Ground-Station/Documentation/README.md

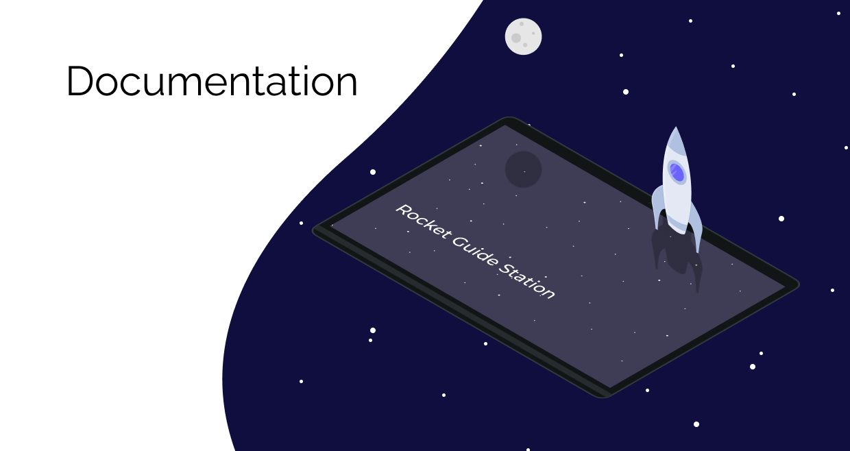
[picture p1: assets/img/Capa.png]


Repositório destinado à documentação do projeto



## Relatórios

- [Ponto de Controle 1](reports/PI2_PC1_fogueteiros.pdf)
- [Ponto de Controle 2](reports/PI2_PC2_fogueteiros.pdf)
- [Ponto de Controle 3](reports/PI2_PC3_fogueteiros.pdf)
- [Diagramas Elétricos](electric-diagrams/)
- [CADs e imagens Estrutura](Estrutura/)

## Manuais

- [Manual de Montagem](manuals/Manual_de_montagem.pdf)
- [Manual de Uso](manuals/Manual_do_usuario.pdf)

## Apresentações

- [Apresentação do Ponto de Controle 1](presentations/apresentacao_PC01.pdf)
- [Apresentação do Ponto de Controle 1](presentations/apresentacao_PC2.pdf)

## Projetos das Placas de Circuito Impresso

- [Download Arquivos Gerber](https://drive.google.com/drive/folders/1P1pQGE_zuSLOB5qd8zfESWqLDwtyoRKd)
- [Download do programa vizualizador (Arquivo Gerber)](https://sourceforge.net/projects/gerbv/files/)

## Bibliotecas Essenciais - Hardware

- [Adafruit_Sensor](https://github.com/adafruit/Adafruit_Sensor)
- [Adafruit_BMP280_Library](https://github.com/adafruit/Adafruit_BMP280_Library)
- [BME280_driver](https://github.com/BoschSensortec/BME280_driver)
- [HX711](https://github.com/bogde/HX711)
- [TinyGPS](https://github.com/mikalhart/TinyGPS)
- [ESPsoftwareserial](https://github.com/plerup/espsoftwareserial)
