Ground-Station/Documentation/reports/PI2_PC1_fogueteiros/figuras/folhaDeAprovacao.tex

\begin{folhadeaprovacao}

  \begin{center}
    {\ABNTEXchapterfont\large\imprimirautor}

    \vspace*{\fill}\vspace*{\fill}
    {\ABNTEXchapterfont\bfseries\Large\imprimirtitulo}
    \vspace*{\fill}
    
    \hspace{.45\textwidth}
    \begin{minipage}{.5\textwidth}
        \imprimirpreambulo
    \end{minipage}%
    \vspace*{\fill}
   \end{center}
    
    \begin{center}   
    \vspace*{\fill}\vspace*{\fill}
    {\large{Orientadores: \imprimirorientador}}
    \end{center}

   \begin{center}
    \vspace*{0.5cm}

    {\large\imprimirlocal}
    \par
    {\large\imprimirdata}
    \vspace*{1cm}
  \end{center}
  
\end{folhadeaprovacao}
