Ground-Station/Documentation/reports/PI2_PC1_fogueteiros/editaveis/geral/anexos.tex

\begin{anexosenv}

\partanexos

\chapter{Elementos do sistema de alimentação}
\label{ane:Elementos do sistema de alimentação}

\begin{figure}[h]
\centering
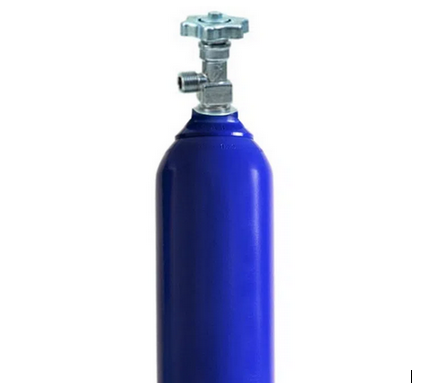
[picture p2: reports/PI2_PC2_fogueteiros/figuras/tanqueAbastecimento.png]
\subfigure[ref1][Tanque de abastecimento] {}
\qquad
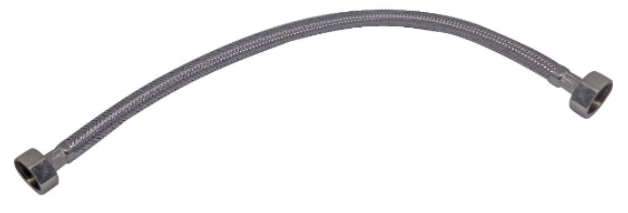
[picture p3: reports/PI2_PC1_fogueteiros/figuras/mangueira.png]
\subfigure[ref2][Tubo flexível] {}
\caption{Tanque de abastecimento e Tubo flexível}
\label{fig:tanque de abastecimento}
\end{figure}

\begin{figure}[h]
\centering
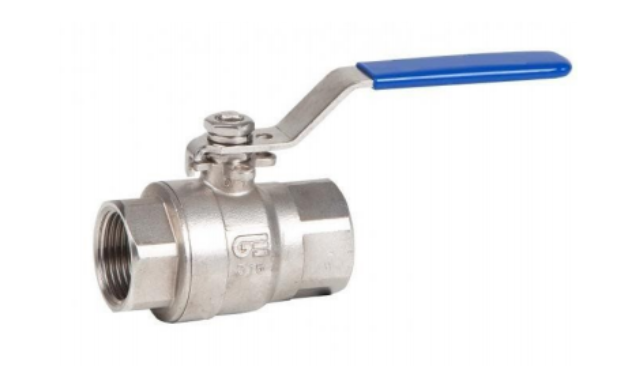
[picture p4: reports/PI2_PC1_fogueteiros/figuras/valvulaEsfera.png]
\subfigure[ref1][Válvula esfera] {}
\qquad
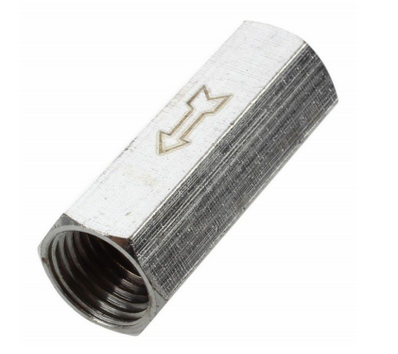
[picture p5: reports/PI2_PC2_fogueteiros/figuras/valvulaAntirretorno.png]
\subfigure[ref2][Válvula anti-retorno] {}
\caption{Válvulas}
\label{fig:valvulas}
\end{figure}

\begin{figure}[h]
\centering
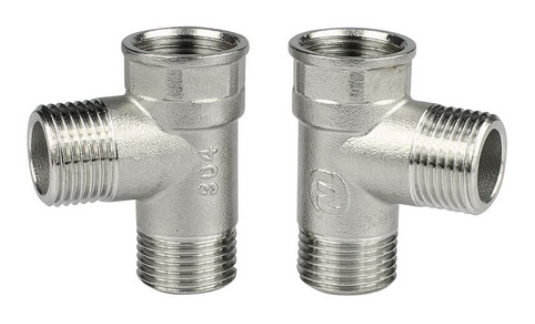
[picture p6: reports/PI2_PC3_fogueteiros/figuras/conexaoT.png]
\subfigure[ref1][Conector T] {}
\qquad
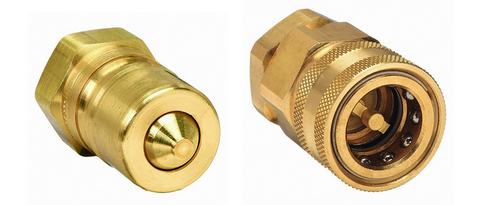
[picture p7: reports/PI2_PC3_fogueteiros/figuras/conexaoRapida.png]
\subfigure[ref2][Conector rápido] {}
\caption{Conectores}
\label{fig:conectores}
\end{figure}

\end{anexosenv}
