Ground-Station/Documentation/reports/PI2_PC1_fogueteiros/editaveis/geral/apendices.tex

\begin{apendicesenv}

\partapendices

\chapter{Diagrama de blocos do sistema}
\label{Diagrama de blocos do sistema}
\begin{figure}[htb]
    \centering
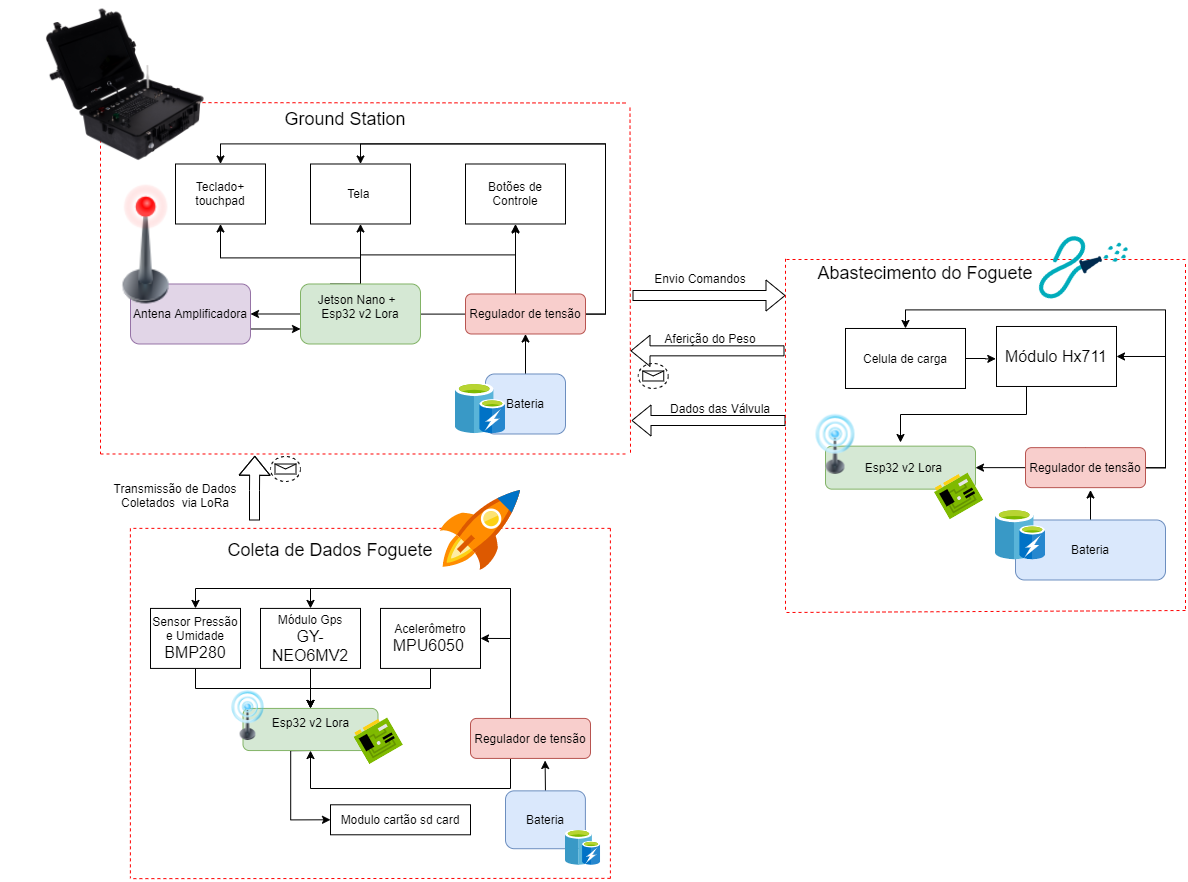
[picture p8: reports/PI2_PC1_fogueteiros/figuras/diagrama pi2 (2).png]
    
    \caption{Diagrama de blocos do projeto. Fonte: Autor}
    \label{fig:Diagrama de Blocos}
\end{figure}

\chapter{Visão geral da arquitetura de software}
\label{Visão geral da arquitetura de software}
\begin{figure}[htb]
    \centering
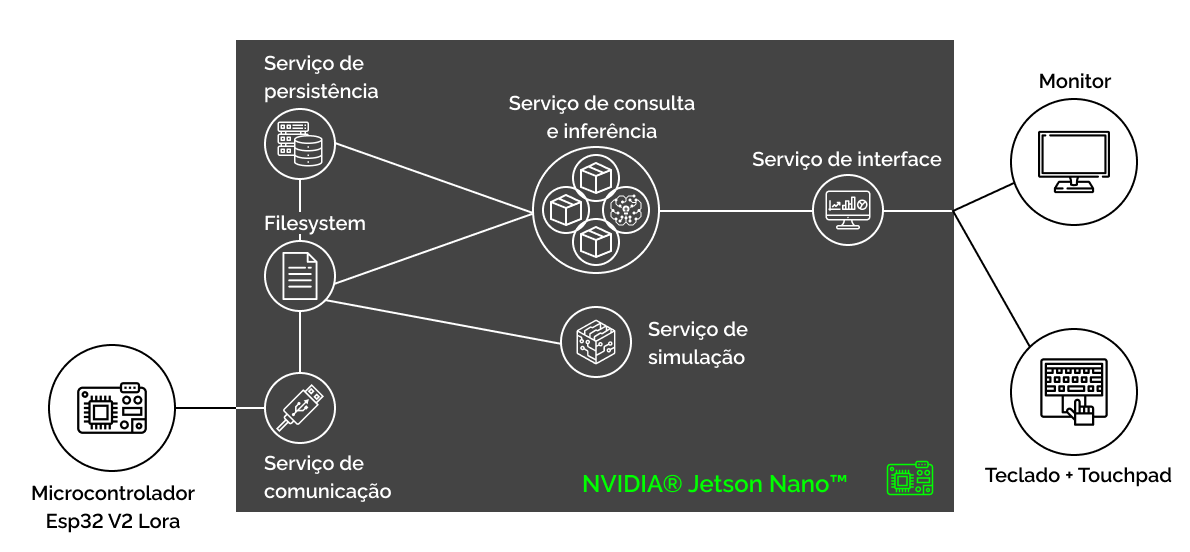
[picture p9: reports/PI2_PC2_fogueteiros/figuras/arquitetura_visao_geral.png]
    
    \caption{Visão geral da arquitetura de software. Fonte: Autor}
    \label{fig:Visão geral}
\end{figure}

\chapter{Business model canvas}
\label{canvas}
\begin{figure}[htb]
    \centering
    
    \caption{Business model canvas. Fonte: Autor}
    \label{fig:Canvas}
\end{figure}

\chapter{EAP}
\label{eap}
\begin{figure}[htb]
    \centering
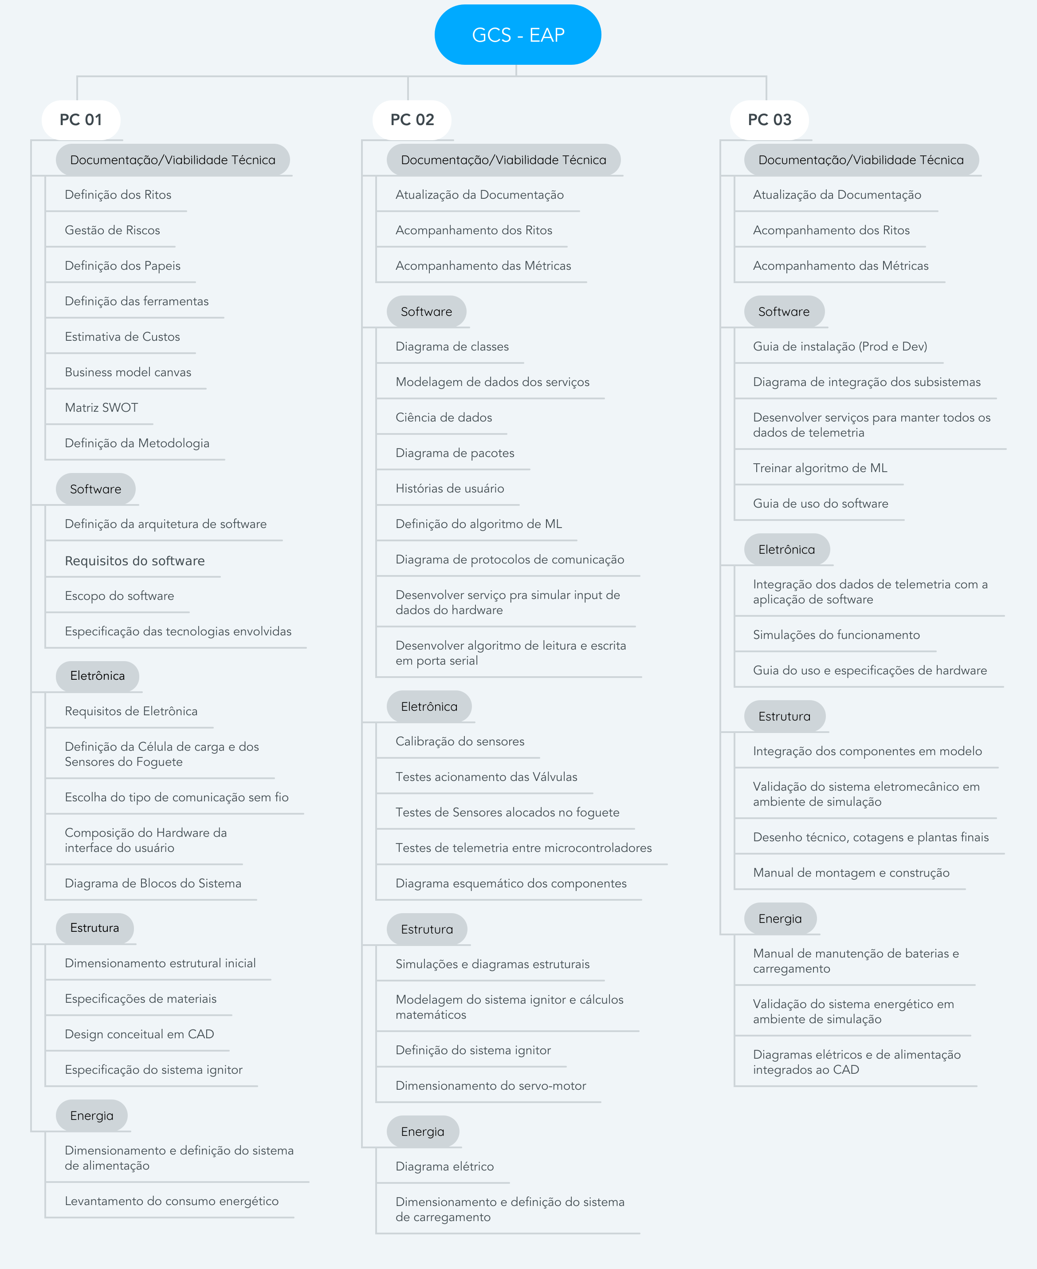
[picture p10: reports/PI2_PC2_fogueteiros/figuras/GCS_-_EAP.png]
    
    \caption{Mapa mental da Estrutura Analítica do Projeto.}
    \label{fig:EAP}
\end{figure}

\chapter{Esboço inicial e CAD}
\label{CAD}

\begin{figure}[htb]
    \centering
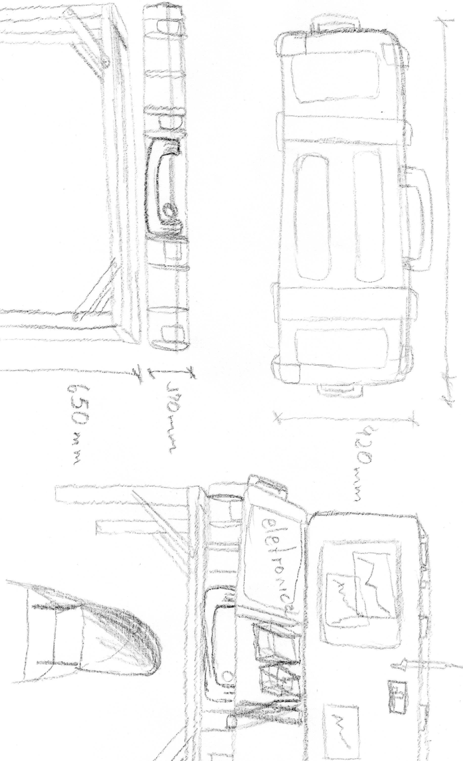
[picture p11: reports/PI2_PC1_fogueteiros/figuras/EsboçoInicial_V_1.jpg]
    
    \caption{Esboço inicial}
    \label{fig:esboço}
\end{figure}

\begin{figure} [H]
\centering
  \subfigure[aberto]{
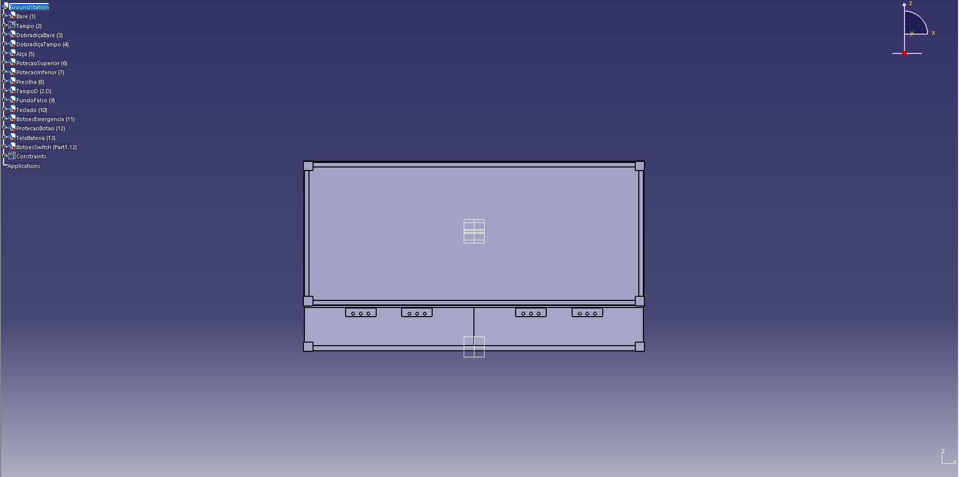
[picture p12: reports/PI2_PC1_fogueteiros/figuras/Back1.PNG]
    
  } 
  \subfigure[fechado]{ 
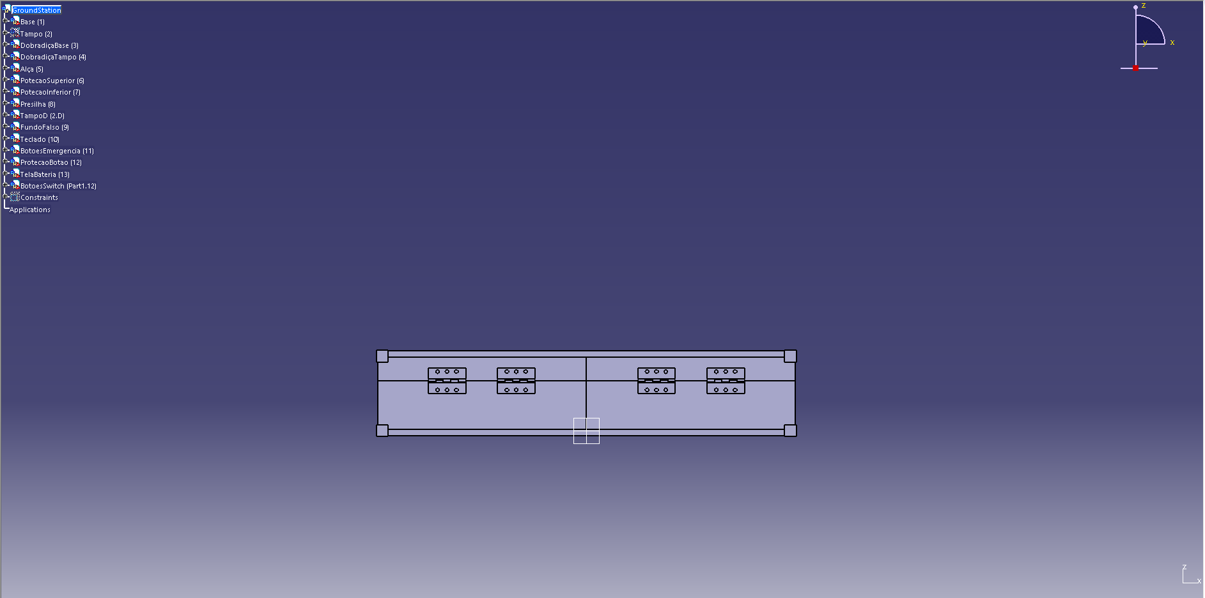
[picture p13: reports/PI2_PC1_fogueteiros/figuras/Back2.PNG]
    
  } 
  \caption{CAD da maleta verso}
\end{figure}

\begin{figure} [H]
\centering
  \subfigure[aberto]{
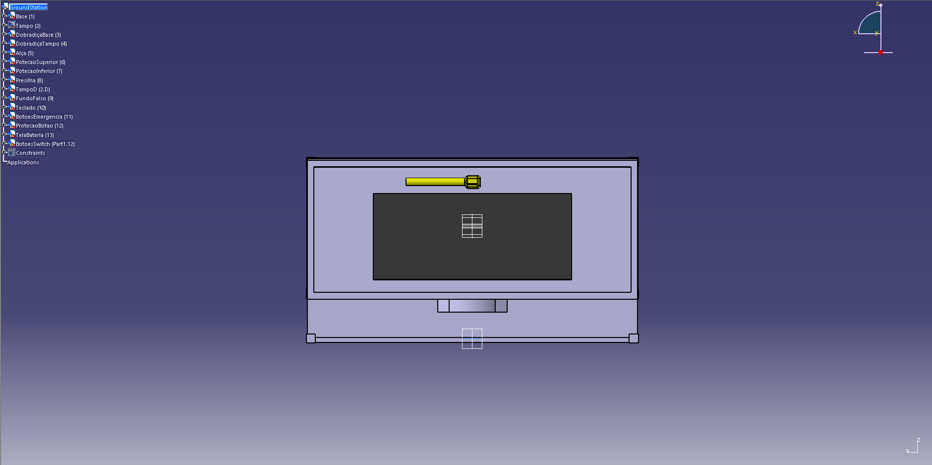
[picture p14: reports/PI2_PC1_fogueteiros/figuras/Front1.PNG]
    
  } 
  \subfigure[fechado]{ 
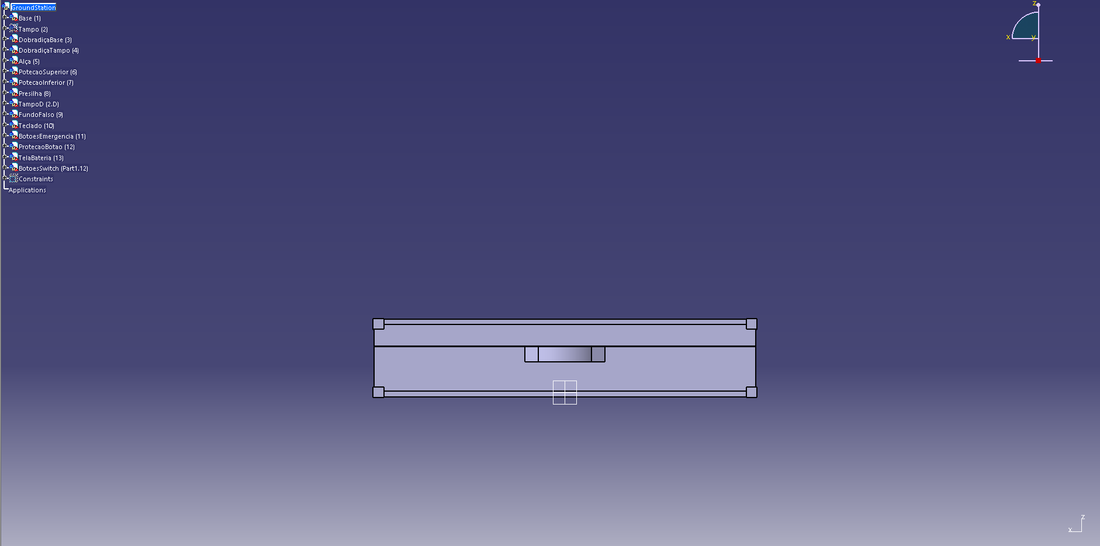
[picture p15: reports/PI2_PC1_fogueteiros/figuras/Front2.PNG]
    
  } 
  \caption{CAD's da maleta frente}
\end{figure}

\begin{figure} [H]
\centering
  \subfigure[aberto]{
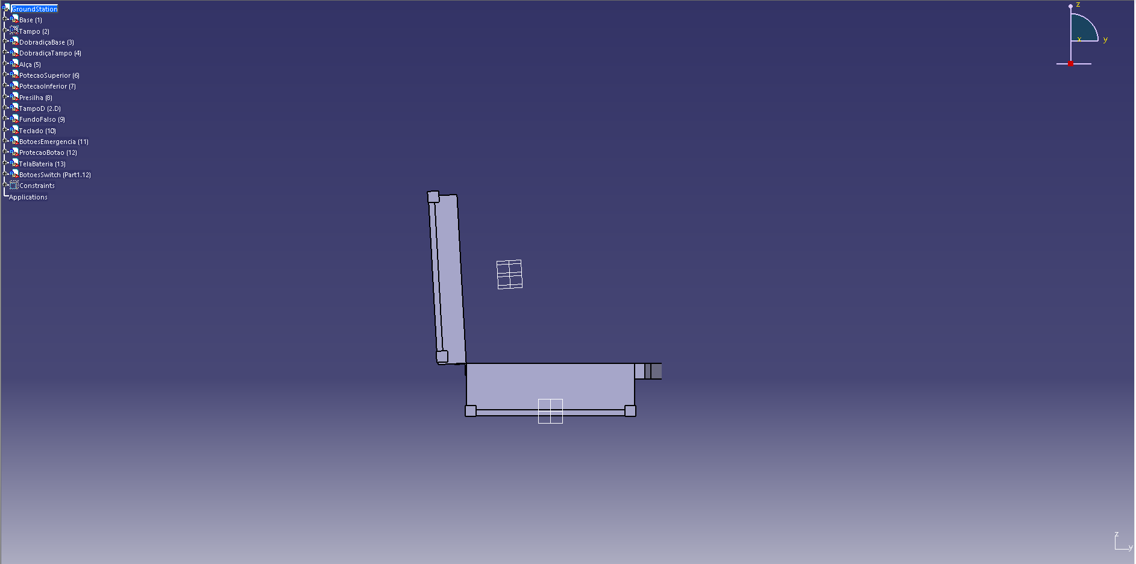
[picture p16: reports/PI2_PC1_fogueteiros/figuras/Lateral1.PNG]
    
  } 
  \subfigure[fechado]{ 
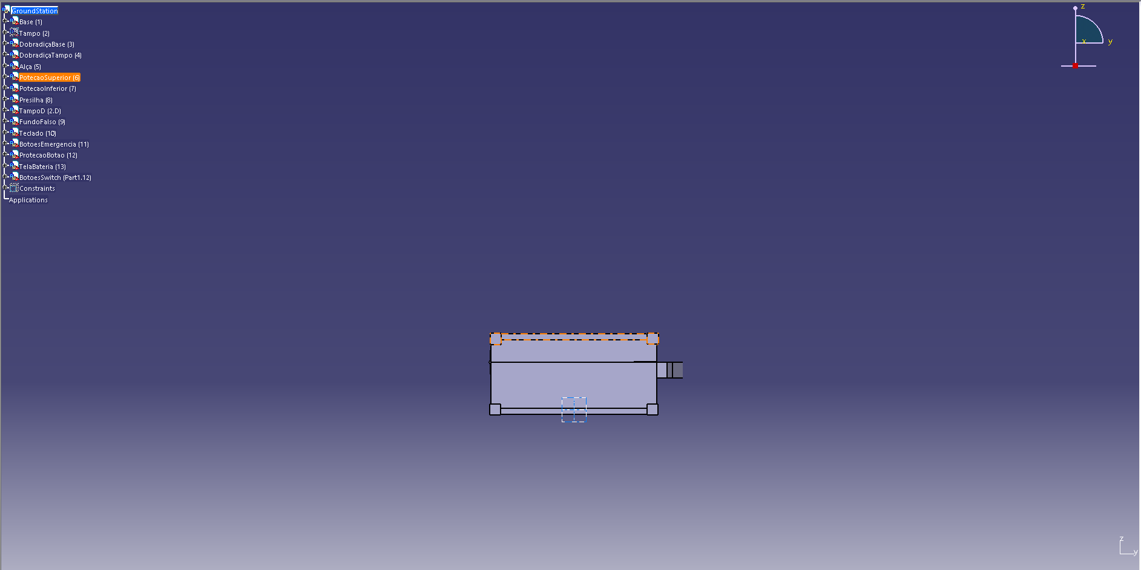
[picture p17: reports/PI2_PC1_fogueteiros/figuras/Lateral2.PNG]
    
  } 
  \caption{CAD's da maleta lateral}
\end{figure}

\begin{figure} [H]
\centering
  \subfigure[aberto]{
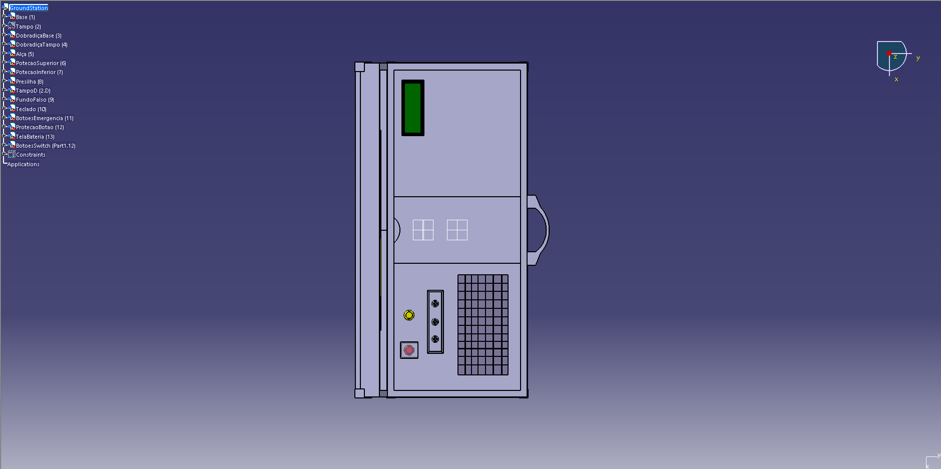
[picture p18: reports/PI2_PC1_fogueteiros/figuras/Sup1.PNG]
    
  } 
  \subfigure[fechado]{ 
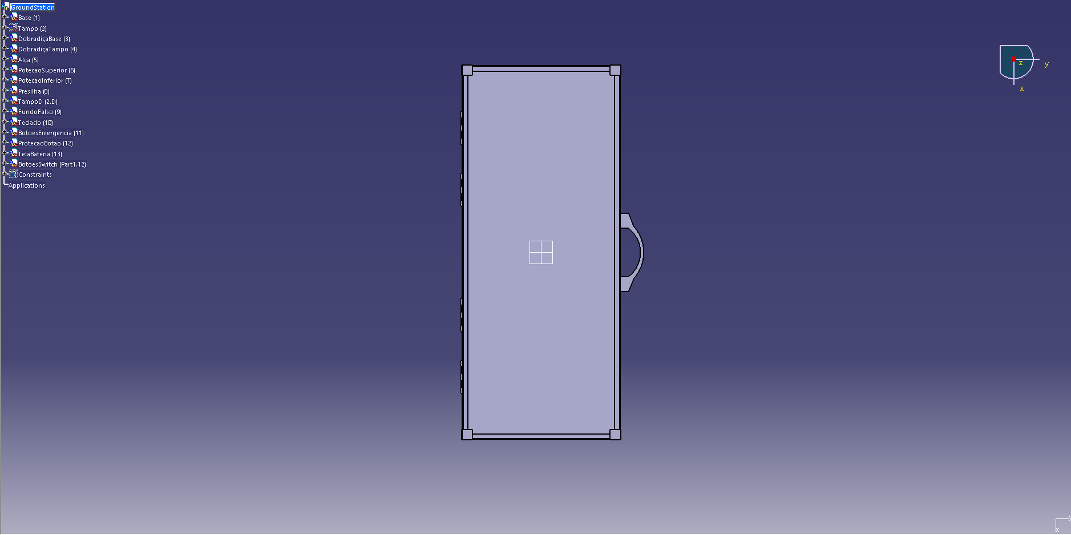
[picture p19: reports/PI2_PC1_fogueteiros/figuras/Sup2.PNG]
    
  } 
  \caption{CAD's da maleta superior}
\end{figure}

\begin{figure} [H]
\centering
  \subfigure[aberto]{
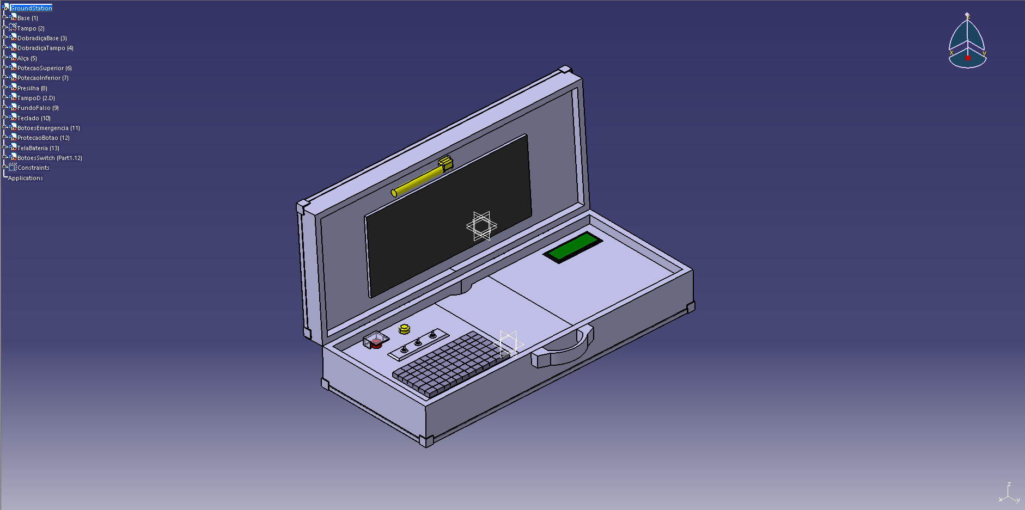
[picture p20: reports/PI2_PC1_fogueteiros/figuras/Iso1.PNG]
    
  } 
  \subfigure[fechada]{ 
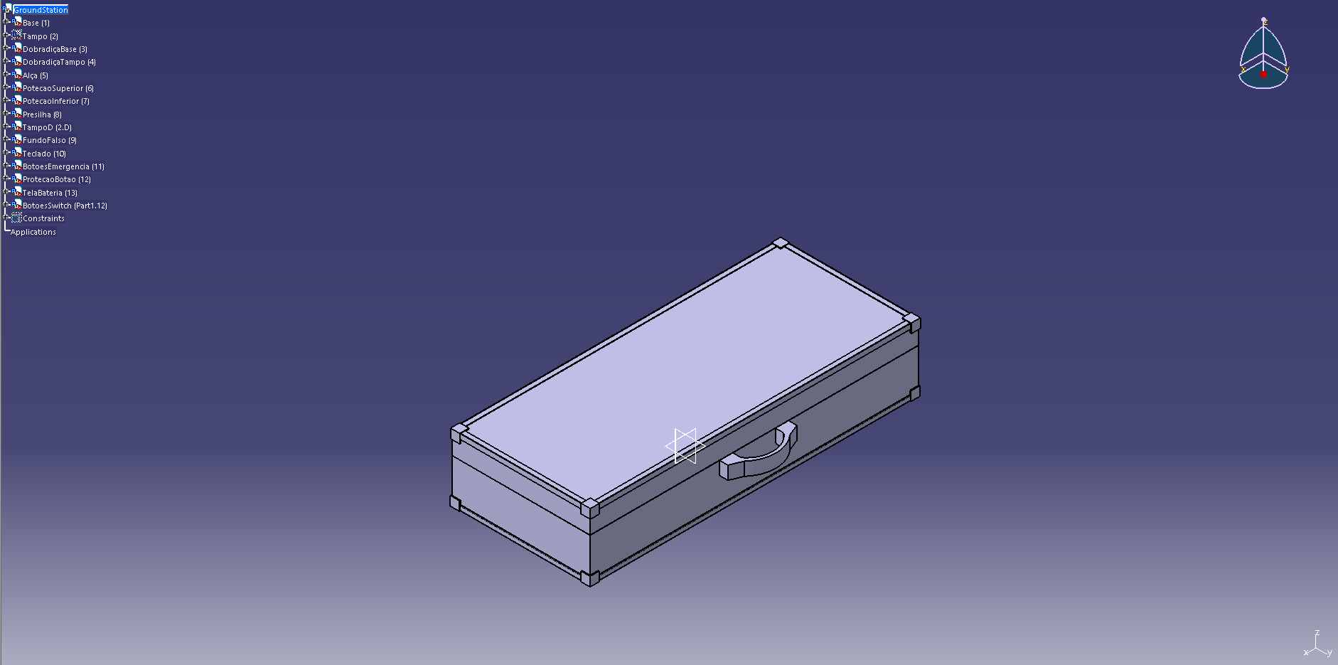
[picture p21: reports/PI2_PC1_fogueteiros/figuras/Iso2.PNG]
    
  } 
  \caption{CAD's da maleta isométrica}
\end{figure}

\chapter{Roadmap}
\label{Roadmap}
\begin{figure}[htb]
    \centering
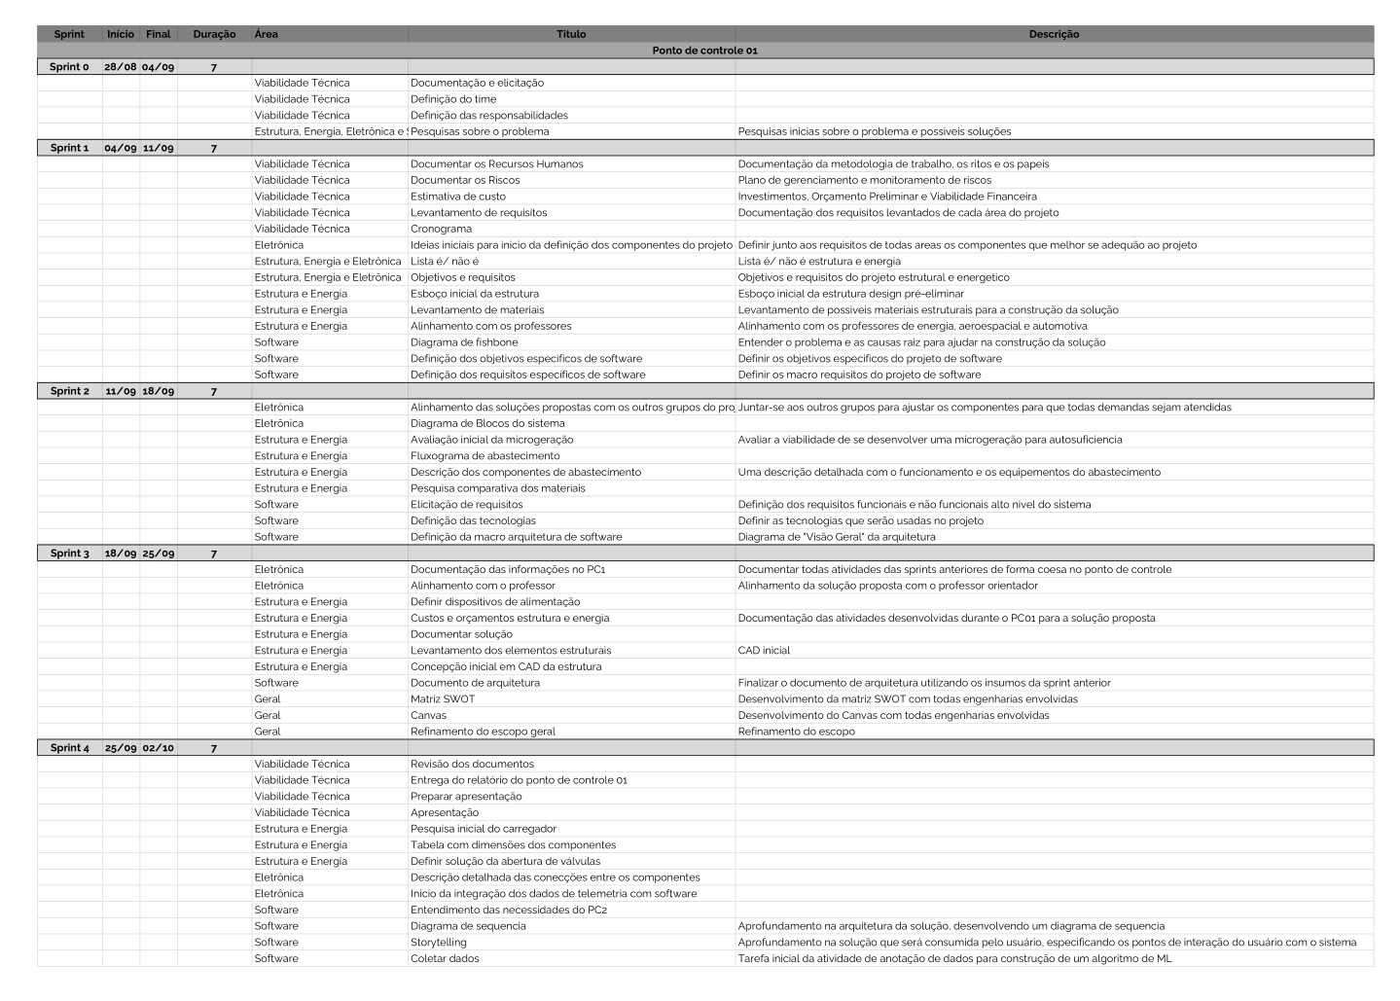
[picture p22: reports/PI2_PC1_fogueteiros/figuras/Roadmap-PC1.png]
    
    \caption{Roadmap PC1. Fonte: Autor}
    \label{fig:Roadmap PC1}
\end{figure}
\begin{figure}[htb]
    \centering
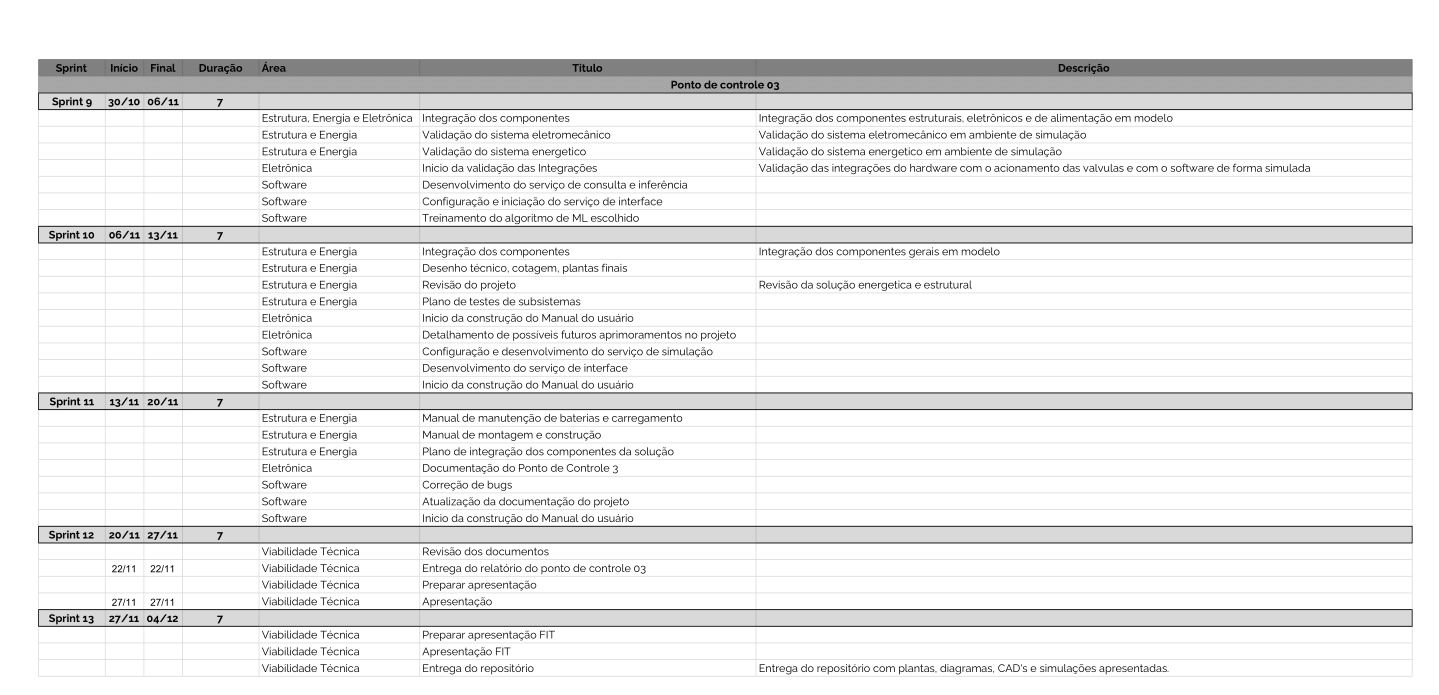
[picture p23: reports/PI2_PC1_fogueteiros/figuras/Roadmap-PC2.png]
    
    \caption{Roadmap PC2. Fonte: Autor}
    \label{fig:Roadmap PC2}
\end{figure}
\begin{figure}[htb]
    \centering
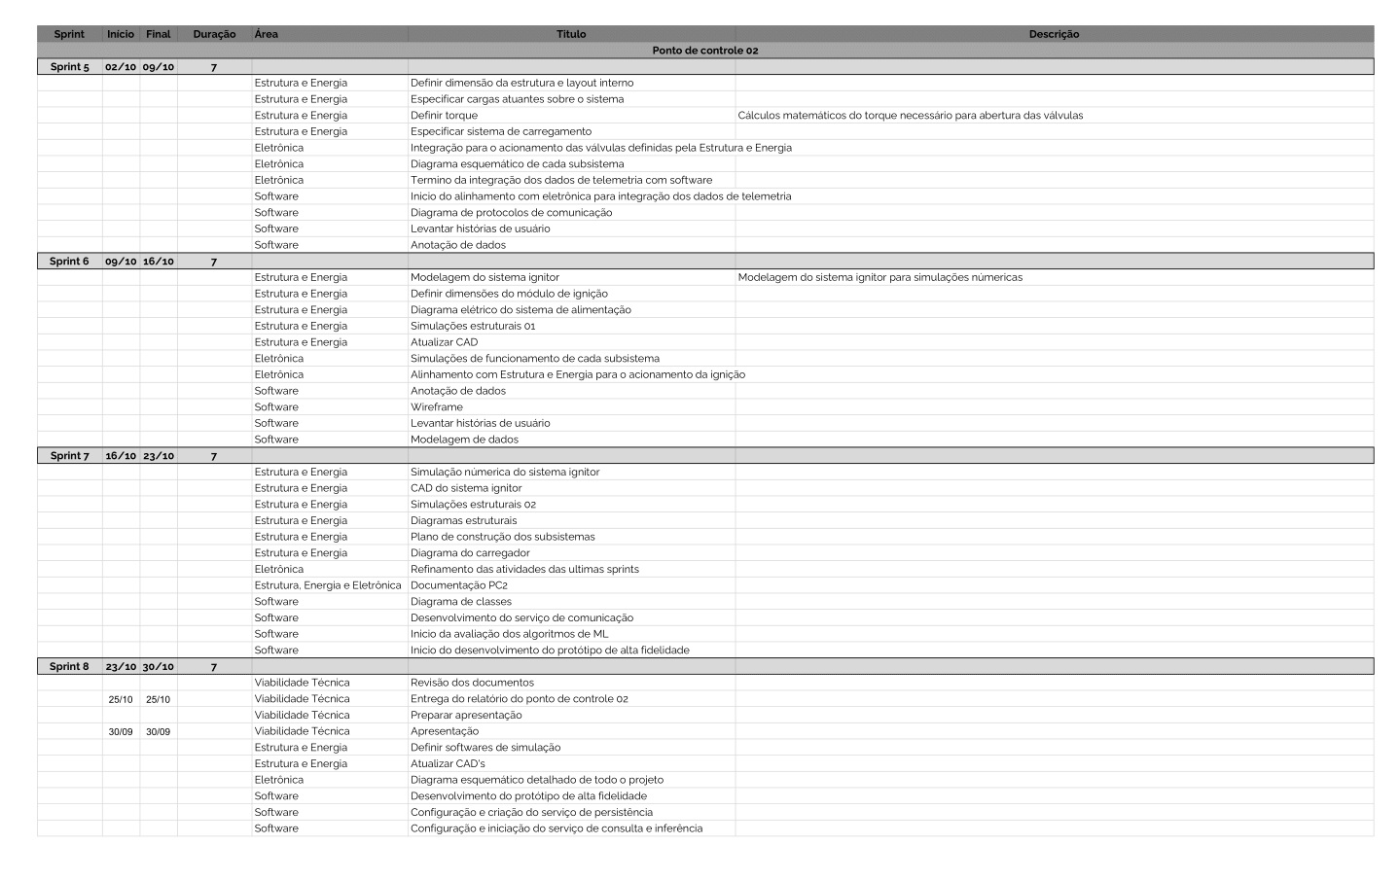
[picture p24: reports/PI2_PC3_fogueteiros/figuras/Roadmap-PC3.png]
    
    \caption{Roadmap PC3. Fonte: Autor}
    \label{fig:Roadmap PC3}
\end{figure}

\input{editaveis/autoavaliacao/autoavaliacao.tex}

\end{apendicesenv}
