Ground-Station/Documentation/reports/PI2_PC2_fogueteiros/editaveis/geral/abreviaturas.tex

\begin{siglas}
  \item [CNC] \textit{Computer Numeric Control}
  \item [RUP] \textit{Rational Unified Process}
  \item [MVP] \textit{Minimum Viable Product}
  \item [RGS] \textit{Rocket Guide Station}
  \item [GPS] \textit{Global Positioning System - Sistema de Posicionamento Global}
  \item [CAD] \textit{Computer Aided Design}
  \item [EAP] \textit{ Estrutura Analítica de Projetos}
  \item [TAP] \textit{Termo de Abertura de Projeto}
  \item [SWOT] \textit{Strengths, Weaknesses, Opportunities, and Threats}
  \item [GPRS] \textit{General Packet Radio Services}
  \item [LASC] \textit{Latin America Space Challenge}
  \item [SPI] \textit{Serial Peripheral Interface}
  \item [SOA] \textit{Service oriented architeture}
  \item [ML] \textit{Machine Learning}
  \item [PC] \textit{Ponto de Controle}
  \item [SWOT] \textit{strengths, weaknesses, opportunities, and threats}
  \item [FOFA] \textit{Forças, Oportunidades, Fraquezas e Ameaças}
  \item [5W1H] \textit{Who, What, Where, When, Why, How}
  \item [FIT] \textit{Feira de inovação tecnológica}
  \item [FGA] \textit{Faculdade Gama}
  \item [ISO] \textit{Organização Internacional de Normalização}
  \item [MDF] \textit{Medium Density Fiberboard}
  \item [PRFV] \textit{Polímero Reforçado com Fibra de Vidro}
  \item [PRFC] \textit{Polímero Reforçado com Fibra de Carbono}
  \item [PLA] \textit{Poli Ácido Lático}
  \item [ABS] \textit{Acrilonitrila Butadieno Estireno}
  \item [GCS] \textit{Ground Control Station}
  \item [IA] \textit{Inteligencia artificial}
  \item [PTH] \textit{Pin Through Hole}
  \item [SMD] \textit{Surface Mounted Device}
  \item [PCI] \textit{Placa de Circuito Impresso}
  \item [FR] \textit{Flame Resistant}
  \item [SF] \textit{Spreading Factor-Fator de espalhamento}
  \item [BW] \textit{Bandwidth-Largura de banda}
  \item [Rb] \textit{Taxa de bits}
  \item [A] \textit{Ampères}
  \item [W] \textit{Watts}
  \item [Wh] \textit{Watts hora}

\end{siglas}
