Ground-Station/Documentation/reports/PI2_PC2_fogueteiros/editaveis/geral/anexos.tex

\begin{anexosenv}

\partanexos

\chapter{Elementos do sistema de alimentação}
\label{ane:Elementos do sistema de alimentação}

\begin{figure}[h]
\centering
\subfigure[ref1][Tanque de abastecimento] {}
\qquad
\subfigure[ref2][Tubo flexível] {}
\caption{Tanque de abastecimento e Tubo flexível}
\label{fig:tanque de abastecimento}
\end{figure}

\begin{figure}[h]
\centering
\subfigure[ref1][Válvula esfera] {}
\qquad
\subfigure[ref2][Válvula anti-retorno] {}
\caption{Válvulas}
\label{fig:valvulas}
\end{figure}

\begin{figure}[h]
\centering
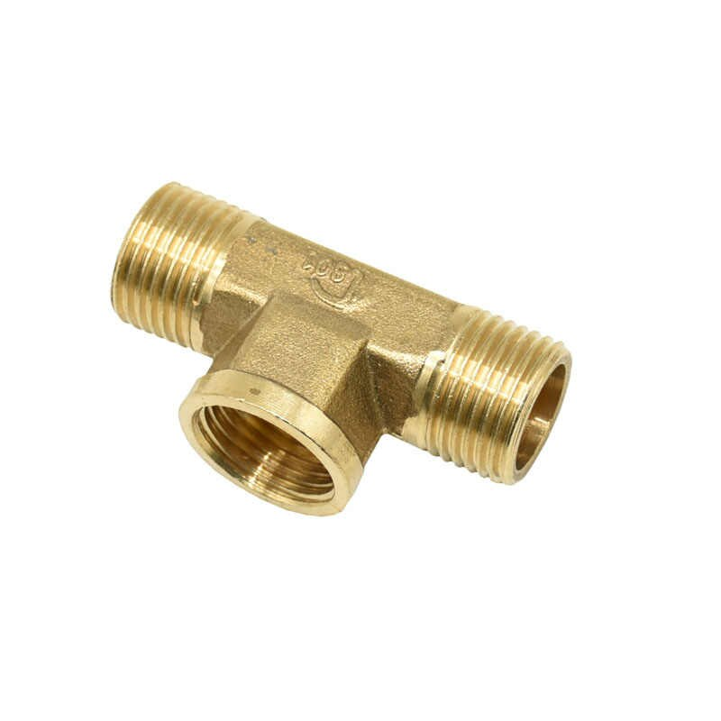
[picture p25: reports/PI2_PC2_fogueteiros/figuras/T.jpg]
\subfigure[ref1][Conector T] {}
\qquad
\subfigure[ref2][Conector rápido] {}
\caption{Conectores}
\label{fig:conectores}
\end{figure}

\includepdf[pages=-,angle=0]{figuras/valvula.pdf}
\label{valvula}

\label{motorcarro}
\includepdf[pages=51,angle=0]{figuras/Mabuchi_Motors_Complete.pdf}

\end{anexosenv}
