Ground-Station/Documentation/reports/PI2_PC3_fogueteiros/editaveis/geral/abreviaturas.tex

\begin{siglas}
   \item [A] \textit{Ampères}
   \item [ABS] \textit{Acrilonitrila Butadieno Estireno}
   \item [AJAX] \textit{Asynchronous JavaScript And XML}
   \item [ANATEL] \textit{Agência Nacional de Telecomunicações}
   \item [API] \textit{Application Programming Interface}
   \item [BBB] \textit{Battelle-Bildmappen-Brainwriting}
   \item [BW] \textit{Bandwidth-Largura de banda}
   \item [CAD] \textit{Computer Aided Design}
   \item [CNB] \textit{Collective Notebook}
   \item [CNC] \textit{Computer Numeric Control}
   \item [CR] \textit{Code Rate}
   \item [CRT] \textit{Capital Rocket Team}
   \item [CSS] \textit{Chirp Spread Spectrum}
   \item [CSV] \textit{Comma Separated Values}
   \item [EAP] \textit{Estrutura Analítica de Projetos}
   \item [FCA] \textit{fator de correção de agrupamento}
   \item [FCE] \textit{Forward Error Corrector}
   \item [FCT]  \textit{fator de correção de temperatura}
   \item [FGA] \textit{Faculdade Gama}
   \item [FIT] \textit{Feira de inovação tecnológica}
   \item [FOFA] \textit{Forças, Oportunidades, Fraquezas e Ameaças}
   \item [FR] \textit{Flame Resistant}
   \item [FSK] \textit{Frequency-shift keying}
   \item [GCS] \textit{Ground Control Station}
   \item [GPRS] \textit{General Packet Radio Services}
   \item [GPS] \textit{Global Positioning System - Sistema de Posicionamento Global}
   \item [Hz] \textit{Hertz}
   \item [IA] \textit{Inteligencia artificial}
   \item [IOT] \textit{Internet das coisas}
   \item [ISM] \textit{Industrial Sientific and Medical}
   \item [ISO] \textit{Organização Internacional de Normalização}
   \item [LASC] \textit{Latin America Space Challenge}
   \item [MDF] \textit{Medium Density Fiberboard}
   \item [ML] \textit{Machine Learning}
   \item [MOBFOG] \textit{Mostra Brasileira de Foguetes}
   \item [MVP] \textit{Minimum Viable Product}
   \item [NGT] \textit{Nominal Group Technique}
   \item [PC] \textit{Ponto de Controle}
   \item [PCI] \textit{Placa de Circuito Impresso}
   \item [PLA] \textit{Poli Ácido Lático}
   \item [PRFC] \textit{Polímero Reforçado com Fibra de Carbono}
   \item [PRFV] \textit{Polímero Reforçado com Fibra de Vidro}
   \item [PTH] \textit{Pin Through Hole}
   \item [Rb] \textit{Taxa de bits}
   \item [REST] \textit{Representational State Transfer}
   \item [RGS] \textit{Rocket Guidance Station}
   \item [RUP] \textit{Rational Unified Process}
   \item [SF] \textit{Spreading Factor-Fator de espalhamento}
   \item [SIL] \textit{Safety Integrity Level}
   \item [SMD] \textit{Surface Mounted Device}
   \item [SOA] \textit{Service oriented architeture}
   \item [SPI] \textit{Serial Peripheral Interface}
   \item [SWOT] \textit{Strengths, Weaknesses, Opportunities, and Threats}
   \item [TAP] \textit{Termo de Abertura de Projeto}
   \item [VIML] \textit{Vocabulário Internacional de Metrologia Legal}
   \item [W] \textit{Watts}
   \item [Wh] \textit{Watts hora}
   \item [5W1H] \textit{Who, What, Where, When, Why, How}

\end{siglas}
