Ground-Station/Documentation/reports/PI2_PC1_fogueteiros/editaveis/TAP/EstimativadeCustos/estimativadecustos.tex

\section{Estimativa de Custos}

Apesar de não existir a necessidade de construção do projeto este semestre, devido a situação sanitária no qual o mundo se encontra, foi construído uma tabela com os custos totais dos materiais componentes que seriam utilizados. A tabela \ref{tab:estimativa materiais} mostra um valor estimado do metro quadrado dos materiais pesquisados. 

\begin{table}[H]
\begin{tabular}{| m{4cm}|m{2cm}|m{2cm}|m{2cm}|m{2cm}|m{2cm}|}
\hline
\multicolumn{6}{|c|}{\textbf{Estrutura e Energia}}\\
\hline
Material & Preço  & Quantidade & Frete & Loja & Total  \\ 
\hline
Bateria Lítio Ferro Fosfato (UPLFP12-30) & 1.426,00  & 1 & 00,00 & Unipower & 1.426,00  \\ 
\hline
Módulo Regulador de Tensão (LM2596)   & 10,90  & 3  & 21,11 & Curto Circuito      & 53,81  \\ 
\hline
MDF   &  R\$36,81 & 1$m^2$x3mm  &   &    &  R\$36,81 \\ 
\hline
MDF   & R\$62,50  & 1$m^2$x6mm  &   &    & R\$62,50  \\ 
\hline
PRFV   & R\$52,90  & 1$m^2$  &   &    &  R\$52,90 \\ 
\hline
PRFC   &  R\$421,43 & 1$m^2$ &   &    &  R\$421,43 \\ 
\hline
PLA   & R\$140,00  & 1kg  &   &    &  R\$140,00  \\ 
\hline
ABS   &  R\$ 16,80 & 1kg  &   &    & R\$ 16,80  \\ 
\hline
 Atuador pneumático  &  entre R\$250 a R\$2000 & 2  &   &    &   \\ 
\hline
 Atuadores elétricos  & entre U\$60 a U\$240  &  2 &   &    &   \\ 
\hline

\end{tabular}
\caption{Estimativa de custos de Materiais}
\label{tab:estimativa materiais}
\end{table}

\begin{table}[H]
\begin{tabular}{| m{6cm}|m{1cm}|m{2cm}|m{1cm}|m{3cm}|m{1cm}|}
\hline
\multicolumn{6}{|c|}{\textbf{Eletrônica}}                                                 \\ \hline
Componente                & Preço  & Quantidade & Frete & Loja          & Total  \\ \hline
Jetson Nano Developer Kit  & 899,91 & 1          & 50,45 & Submarino    & 950,36 \\ \hline
TELA LCD - 9 polegadas    & 269,75 & 1          & 0,00  & arduoeletro   & 269,75 \\ \hline
Mini Teclado com touchpad & 189,14 & 1          & 0,00  & Mercado Livre & 189,14 \\ \hline
Placa LoRa Esp32          & 129,90 & 3          & 27,90 & Mercado Livre & 417,60 \\ \hline
Sensor BMP280             & 13,50  & 1          & 21,11 & Curtocircuito & 34,61  \\ \hline
Célula de carga 50kg      & 16,90  & 1          & 16,50 & Eletrogate    & 33,40  \\ \hline
Módulo Hx711              & 10,40  & 1          & 19,90 & Mercado Livre & 30,30  \\ \hline
Módulo GPS GY-NEO6MV2     & 79,90  & 1          & 19,70 & Robocore      & 99,60  \\ \hline
\end{tabular}
\caption{Estimativa de custos componentes eletrônicos}
\end{table}

Com isso o custo total dos materiais do projeto inicialmente é\textbf{ R\$ 3.504,57} reais.
