Ground-Station/Documentation/reports/PI2_PC2_fogueteiros/editaveis/solucao/custos/custos.tex

\section{Custos}

\begin{table}[h!]
\centering
\begin{tabular}{| m{4cm}|m{2cm}|m{2cm}|m{2cm}|m{2cm}|m{2cm}|}
\hline
\multicolumn{6}{|c|}{\textbf{Estrutura}}\\
\hline
Material & Preço  & Quantidade & Frete & Loja & Total  \\ 
\hline
Alça & $RS$ 15,00 & 1 & $RS$ 17,90 & Mercado Livre & $RS$ 32,90 \\ \hline
Cantoneira de alumínio & $RS$ 17,00 & 3 & $RS$ 26,90 & Mercado Livre & $RS$ 77,90 \\ \hline
Protetores de Canto & $RS$ 20,00 & 1 (pack de 8 un.) & $RS$ 9,00 & Mercado Livre & $RS$ 29,00 \\ \hline
Total estrutura & - & - & - & - & $RS$ 0 \\\hline
\multicolumn{6}{|c|}{\textbf{Energia}}\\
\hline
Bateria de lítio 12V/97Wh (Dell) & $RS$ 718 & 1 & $RS$ 0,00 & Dell & $RS$ 718 \\\hline
Bateria de lítio 12V/10Ah (Unipower) & $RS$ 517,5 & 1 & $RS$ 0,00 & Unipower & $RS$ 517,5 \\\hline
Plug macho (tomada) & $RS$ 11,29 & 1 & $RS$ 9,90 & Leroy Merlin & $RS$ 21,19 \\\hline
Conector DC Jack + Plug & $RS$ 9,99 & 2 & $RS$ 52,90 & Mercado Livre & $RS$ 72,88 \\\hline
Regulador de tensão (LM2596) & $RS$ 13,21 & 2 & $RS$ 23,23 & Baú da Eletrônica & $RS$ 49,65 \\\hline
Resistor 0R12 5\% & $RS$ 0,38 & 1 & - & Baú da Eletrônica & $RS$ 0,38 \\\hline
Resistor 1KR 5\% & $RS$  0,15 & 1 & - & Baú da Eletrônica & $RS$ 0,15 \\\hline
Resistor 240R 5\% & $RS$ 0,04 & 1 & - & Baú da Eletrônica & $RS$ 0,04 \\\hline
Transistor NPN - BC547 & $RS$ 0,15 & 1 & - & Baú da Eletrônica & $RS$ 0,15 \\\hline
Regulador de Tensão Ajustável LM317 & $RS$ 0,49 & 1 & - & Baú da Eletrônica & $RS$ 0,49 \\\hline
Regulador de Tensão L7812 & $RS$ 1,25 & 1 & - & Baú da Eletrônica & $RS$ 1,25 \\\hline
Capacitor Eletrolítico 1000uF & $RS$ 3,29 & 1 & - & Baú da Eletrônica & $RS$ 3,29 \\\hline
Diodo 1N4007 & $RS$ 0,10 & 2 & - & Baú da Eletrônica & $RS$ 0,20 \\\hline
Chave Gangorra KCD3-101 2 Terminais Preta & $RS$ 1,52 & 1 & - & Baú da Eletrônica & $RS$ 1,52 \\\hline
Cabo flexível 0,75 mm² (metro) & $RS$ 0,94 & 10 & - & Baú da Eletrônica & $RS$ 9,40 \\\hline
Cabo flexível 2,5 mm² (metro) & $RS$ 2,09 & 5 & $RS$ 29,40 & Eletromac & $RS$ 39,85 \\\hline
Transformador Trafo 110/220V para 30V 1A & $RS$ 45,99 & 1 & $RS$ 23,87 & Hunion & $RS$ 69,86 \\\hline
Total energia & - & - & - & - & $RS$ 1505,80 \\\hline

\end{tabular}
\caption{Custos do Projeto}
\label{tab:custos}
\end{table}

\begin{table}[h!]
\centering
\begin{tabular}{| m{4cm}|m{2cm}|m{2cm}|m{2cm}|m{2cm}|m{2cm}|}
\hline 
\multicolumn{6}{|c|}{\textbf{Eletrônica/Software}}\\\hline
Material & Preço  & Quantidade & Frete & Loja & Total  \\\hline
Regulador de tensão (LM2596) & $RS$ 13,21 & 3 & $RS$ 23,23 & Baú da Eletrônica & $RS$ 62,86 \\\hline
Placa Lora + Esp32 c/ Display Oled Wifi Bluetooth 915mhz& $RS$ 149,99 & 3 & $RS$ -  & Mercado Livre & $RS$ 449,97 \\\hline
Módulo Rele 2 Canais - 5v/10A & $RS$ 16,60 & 2 & $RS$ 21,11 & Mercado Livre & $RS$ 54,31 \\\hline
Módulo Gps Gy-gps6mv2 & $RS$ 36,00 & 1 & $RS$ 31,90 & Mercado Livre & $RS$ 67,90 \\\hline
Módulo Micro SDCARD & $RS$ 8,90 & 1 & $RS$ 23,90 & Mercado Livre & $RS$ 32,80 \\\hline
Sensor de Pressão BMP280 & $RS$ 13,50 & 1 & $RS$ 21,11 & Curto circuito & $RS$ 34,61 \\\hline
Driver Motor Ponte H L298n & $RS$ 17,70 & 1 & $RS$ 21,11 & Curto circuito & $RS$ 38,81 \\\hline
Módulo Conversor Nível Lógico 5V/3.3V - Bidirecional  & $RS$ 7,40 & 1 & $RS$ 31,90 & Mercado Livre  & $RS$ 39,30 \\\hline
Célula De Carga 50 Kg Sensor De Peso + Placa Hx711  & $RS$ 21,68 & 2 & $RS$ 31,90 & Mercado Livre  & $RS$ 75,26\\\hline
Nvidea Jetson Nano Developer Kit & $RS$ 1542,05 & 1 & $RS$ 37,51 & Submarino  & $RS$ 1579,56\\\hline
Lcd 9 Polegadas P/ Cubieboard E Raspberry Pi Hdmi Vga Av & $RS$ 320,00 & 1 & $RS$ - & Mercado Livre  & $RS$ 320,00\\\hline
Teclado 7" 59 Teclas Sem Fio Bluetooth 3.0 Slim Teclado C/ Touch & $RS$ 202,0 & 1 & $RS$ - & Mercado Livre  & $RS$ 202,00\\\hline
Total software/eletrônica & - & - & - & - & $RS$2956,82  \\\hline
%\multicolumn{6}{|c|}{\textbf{Software}}\\
%\hline
%Total software & - & - & - & - & $RS$ 1505,80 \\\hline

\end{tabular}
\caption{Custos do Projeto}
\label{tab:custos2}
\end{table}
