Ground-Station/Documentation/reports/PI2_PC3_fogueteiros/editaveis/solucao/custos/custos.tex

\chapter{Custos}

\section{Eletrônica e Software}

\begin{table}[h!]
\centering
\begin{tabular}{| m{4cm}|m{2cm}|m{2cm}|m{2cm}|m{2cm}|m{2cm}|}
\hline 
Material & Preço  & Quantidade & Frete & Loja & Total  \\\hline
Regulador de tensão (LM2596) & $RS$ 13,21 & 3 & $RS$ 23,23 & Baú da Eletrônica & $RS$ 62,86 \\\hline
Placa Lora + Esp32 c/ Display Oled Wifi Bluetooth 915mhz& $RS$ 149,99 & 3 & $RS$ -  & Mercado Livre & $RS$ 449,97 \\\hline
Módulo Rele 2 Canais - 5v/10A & $RS$ 16,60 & 2 & $RS$ 21,11 & Mercado Livre & $RS$ 54,31 \\\hline
Módulo Gps Gy-gps6mv2 & $RS$ 36,00 & 1 & $RS$ 31,90 & Mercado Livre & $RS$ 67,90 \\\hline
Módulo Micro SDCARD & $RS$ 8,90 & 1 & $RS$ 23,90 & Mercado Livre & $RS$ 32,80 \\\hline
Sensor de Pressão BMP280 & $RS$ 13,50 & 1 & $RS$ 21,11 & Curto circuito & $RS$ 34,61 \\\hline
Driver Motor Ponte H L298n & $RS$ 17,70 & 1 & $RS$ 21,11 & Curto circuito & $RS$ 38,81 \\\hline
Módulo Conversor Nível Lógico 5V/3.3V - Bidirecional  & $RS$ 7,40 & 1 & $RS$ 31,90 & Mercado Livre  & $RS$ 39,30 \\\hline
Célula De Carga 50 Kg Sensor De Peso + Placa Hx711  & $RS$ 21,68 & 2 & $RS$ 31,90 & Mercado Livre  & $RS$ 75,26\\\hline
Nvidea Jetson Nano Developer Kit & $RS$ 1542,05 & 1 & $RS$ 37,51 & Submarino  & $RS$ 1579,56\\\hline
Lcd 9 Polegadas P/ Cubieboard E Raspberry Pi Hdmi Vga Av & $RS$ 320,00 & 1 & $RS$ - & Mercado Livre  & $RS$ 320,00\\\hline
Teclado 7" 59 Teclas Sem Fio Bluetooth 3.0 Slim Teclado C/ Touch & $RS$ 202,0 & 1 & $RS$ - & Mercado Livre  & $RS$ 202,00\\\hline
Total software/eletrônica & - & - & - & - & $RS$2956,82  \\\hline
\end{tabular}
\caption{Custos do Projeto de Eletrônica e Software}
\label{tab:custos_eletro_soft}
\end{table}

\section{Energia}

\begin{table}[H]
\centering
\begin{tabular}{| m{4cm}|m{2cm}|m{2cm}|m{2cm}|m{2cm}|m{2cm}|}
\hline
Material & Preço  & Quantidade & Frete & Loja & Total  \\ 
\hline
Bateria de lítio 12V/97Wh (Dell) & $RS$ 718,00 & 1 & $RS$ 0,00 & Dell & $RS$ 718,00\\\hline
Bateria de lítio 12V/10Ah (Unipower) & $RS$ 517,50 & 1 & $RS$ 0,00 & Unipower & $RS$ 517,50 \\\hline
Cabo De Força 3x0,75mm 1,50 Metro + Tomada C14 Painel 3 Polos  & $RS$ 31,00 & 1 & $RS$ 18,90 & Mercado Livre & $RS$ 49,90 \\\hline
Chave HH Baixa - 127V / 220V & $RS$ 1,59 & 1 & $RS$ 23,23 & Baú da Eletrônica & $RS$ 24,82\\\hline
Transformador Trafo 110/220V para 30V 1A & $RS$ 49,90 & 1 & $RS$ 11,05 & Lojas Americanas & $RS$ 60,05 \\\hline
Resistor 0R12 5\% & $RS$ 0,38 & 1 & - & Baú da Eletrônica & $RS$ 0,38 \\\hline
Resistor 1KR 5\% & $RS$  0,15 & 1 & - & Baú da Eletrônica & $RS$ 0,15 \\\hline
Resistor 240R 5\% & $RS$ 0,04 & 1 & - & Baú da Eletrônica & $RS$ 0,04 \\\hline
Transistor NPN - BC547 & $RS$ 0,15 & 1 & - & Baú da Eletrônica & $RS$ 0,15 \\\hline
Regulador de Tensão Ajustável LM317 & $RS$ 0,49 & 1 & - & Baú da Eletrônica & $RS$ 0,49 \\\hline
Regulador de Tensão L7812 & $RS$ 1,25 & 1 & - & Baú da Eletrônica & $RS$ 1,25 \\\hline
Capacitor Eletrolítico 1000uF & $RS$ 3,29 & 1 & - & Baú da Eletrônica & $RS$ 3,29 \\\hline
Diodo 1N4007 & $RS$ 0,10 & 2 & - & Baú da Eletrônica & $RS$ 0,20 \\\hline
Metro de cabo pp 2X2,5 mm² & $RS$ 3,89 & 3 & $RS$  12,51 & Eletrofrigor & $RS$  24,18 \\\hline 
Adaptador Jack P4 macho & $RS$  1,66 & 5 & - & Baú da Eletrônica & $RS$ 4,98 \\\hline
Conector Jack P4 fêmea & $RS$  0,75 & 6 & $RS$ 13,70 & Eletroinfo Cia & $RS$ 22,00 \\\hline
Conetor Dock bateria & $RS$  22,99 & 1 & $RS$   0,00 & Shopee & $RS$  22,99 \\\hline
Chave Gangorra KCD4-201N Vermelha & $RS$ 3,70 & 2 & - & Baú da Eletrônica & $RS$ 7,40 \\\hline
Regulador de tensão (LM2596) & $RS$ 13,21 & 2 & $RS$ -- & Baú da Eletrônica & $RS$ 26,42 \\\hline
Cabo flexível 0,75 mm² Preto (metro) & $RS$ 0,94 & 4 & - & Baú da Eletrônica & $RS$ 3,76 \\\hline
\end{tabular}
\end{table}

\begin{table}[H]
\centering
\begin{tabular}{| m{4cm}|m{2cm}|m{2cm}|m{2cm}|m{2cm}|m{2cm}|}
\hline
Cabo flexível 0,75 mm² Vermelho (metro) & $RS$ 0,94 & 4 & - & Baú da Eletrônica & $RS$ 3,76 \\\hline
Kit 2 Garra Jacaré média (01 Vermelha E 01 Preta) & $RS$ 2,80 & 2 & $RS$ 18,36 & SDtronic & $RS$ 23,96 \\\hline
Terminal Faston Fêmea & $RS$ 0,30 & 05   & $RS$ 15,47 & EletroGate &   $RS$ 16,97   \\\hline

Total energia & - & - & - & - & $RS$ 1532,64 \\\hline
\end{tabular}
\caption{Custos do Projeto de Energia}
\label{tab:custos_ener}
\end{table}

\section{Estrutura}

\begin{table}[h!]
\centering
\begin{tabular}{| m{4cm}|m{2cm}|m{2cm}|m{2cm}|m{2cm}|m{2cm}|}
\hline
Material & Preço  & Quantidade & Frete & Loja & Total  \\ 
\hline
Alça & $RS$ 15,00 & 1 & $RS$ 17,90 & Mercado Livre & $RS$ 32,90 \\ \hline
Cantoneira de alumínio & $RS$ 17,00 & 3 & $RS$ 26,90 & Mercado Livre & $RS$ 77,90 \\ \hline
Kit com 8 protetores de canto & $RS$ 20,00 & 1 & $RS$ 9,00 & Mercado Livre & $RS$ 29,00 \\ \hline
Kit com 100 parafusos 4x40 & $RS$ 8,29 & 1 & $RS$ 19,68 & DallAnese & $RS$ 27,97 \\ \hline
Kit com 20 parafusos 4x12 & $RS$ 0,70 & 3 & $RS$ 18,36 & DallAnese & $RS$ 20,46 \\ \hline
Fecho para caixa & $RS$ 3,80 & 4 & $RS$ 20,65 & Local maker & $RS$ 35,85 \\ \hline
Dobradiça 50mm & $RS$ 0,61 & 2 & $RS$ 20,84 & CCP Parafusos e Ferramentas & $RS$ 22,06 \\ \hline
Dobradiça 40mm & $RS$ 4,08 & 4 & $RS$ 21,89 & Disfoil & $RS$ 38,21 \\ \hline
Chapa madeira MDf 15mm (m²) & $RS$ 56,90 & 3 & $RS$ 0,00 & Leroy Merlin & $RS$ 170,70 \\ \hline
Manta de borracha SBR (1,2m²) & $RS$ 61,63 & 2 & $RS$ 34,90 & São miguel borrachas & $RS$ 158,16 \\ \hline 
Motor de vidro elétrico Mabuchi & $RS$ 43,56 & 2 & $RS$ 19,90 & Daloh Comercio & $RS$ 107,02 \\ \hline
Válvula de esfera 1/2" flangeada & $RS$ 180,00 & 2 & $RS$ 16,90 & Marques nilmar & $RS$ 376,90 \\ \hline
Total estrutura & - & - & - & - & $RS$ 1097,13 \\ \hline
\end{tabular}
\caption{Custos do Projeto de Estrutura}
\label{tab:custos_estrutura}
\end{table}

\section{Total}

\begin{table}[h!]
\centering
\begin{tabular}{| m{8cm}|m{4cm}|}
\hline
Eletrônica e Software &  $RS$ 2956,82  \\\hline
Energia &  $RS$ 1532,64 \\ \hline
Estrutura &  $RS$ 1097,13 \\ \hline
Total  & $RS$ 5586,59 \\\hline
\end{tabular}
\caption{Custo total do Projeto }
\label{tab:custos_estrutura}
\end{table}
