Ground-Station/Documentation/presentations/apresentacao_PC01.pdf

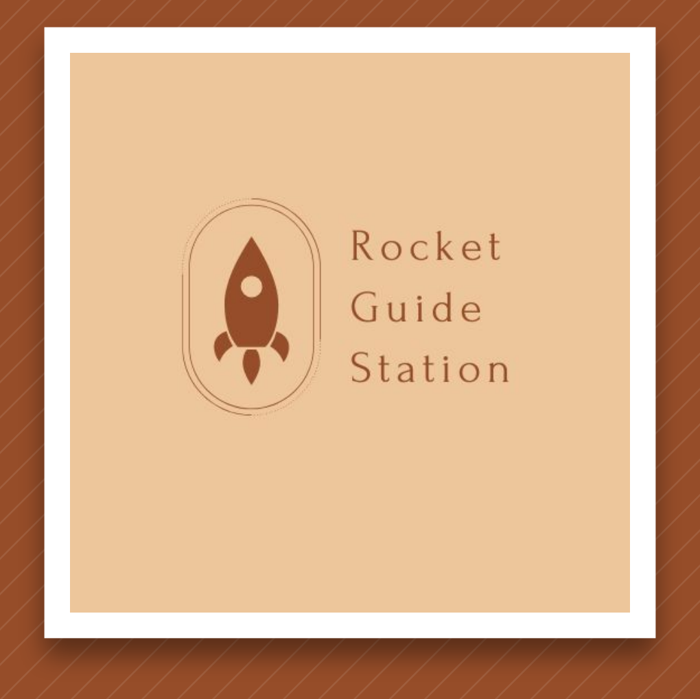
[picture p178: figure]

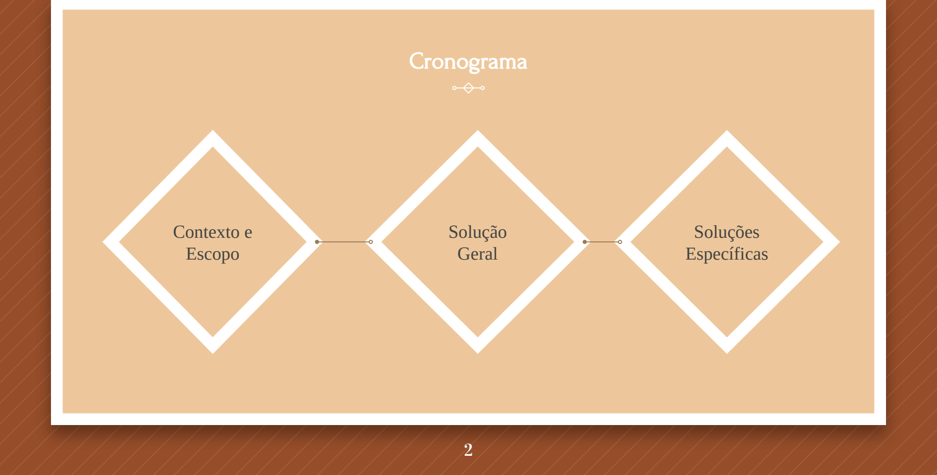
[picture p179: figure]
Cronograma; Solução Geral; Soluções Específicas; Contexto e Escopo

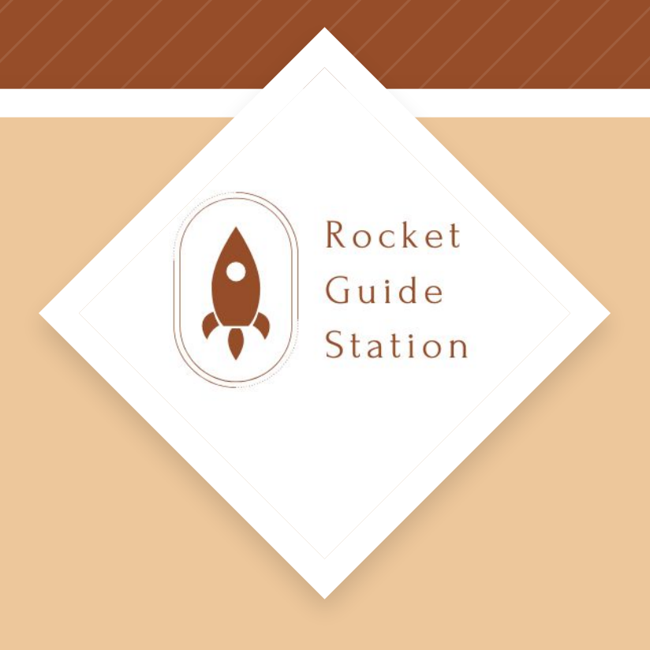
[picture p180: figure]

# Contexto e Escopo

I am Jayden Smith
I am here because I love to give presentations. You can find me at @username

Contexto

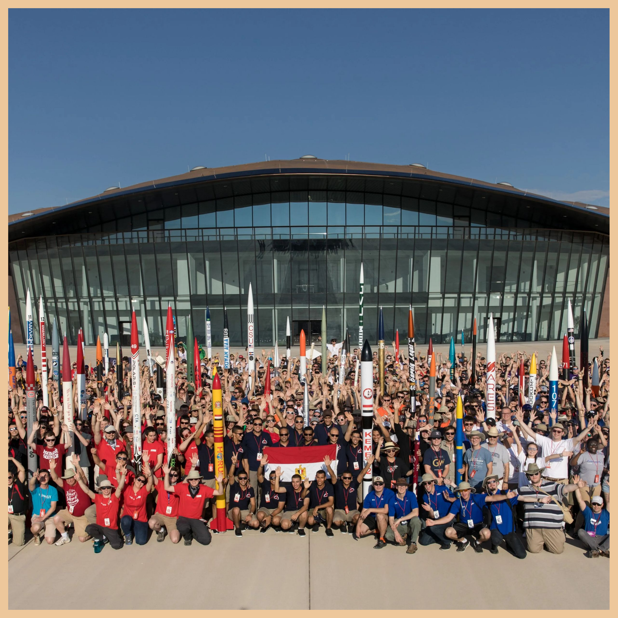
[picture p181: figure]

### ⬗ Competições universitárias ⬗ Foguetes experimentais ⬗ Capital Rocket Team ⬗ Propulsão híbrida

Problema

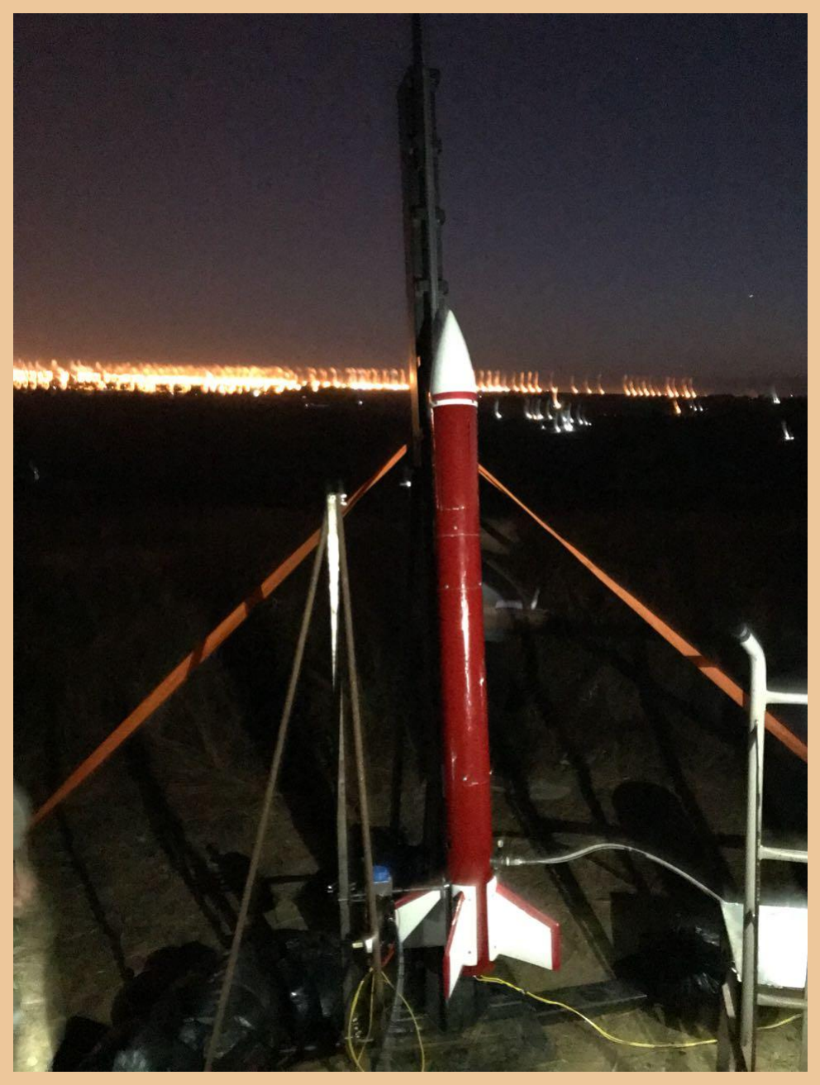
[picture p182: figure]

### ⬗ Abastecimento: óxido nitroso (N2O) ⬗ Segurança da base de lançamento ⬗ Telemetria ⬗ Estação de controle e monitoramento

### ⬗ Fase 1 (antes do lançamento): ◇ Controle remoto do sistema de abastecimento ◇ Comando de ignição ⬗ Fase 2 (durante o voo): ◇ Recebimento de dados de localização (GPS) ◇ Coleta de telemetria (altitude, temperatura e pressão)

Escopo

# Solução

I am Jayden Smith
I am here because I love to give presentations. You can find me at @username

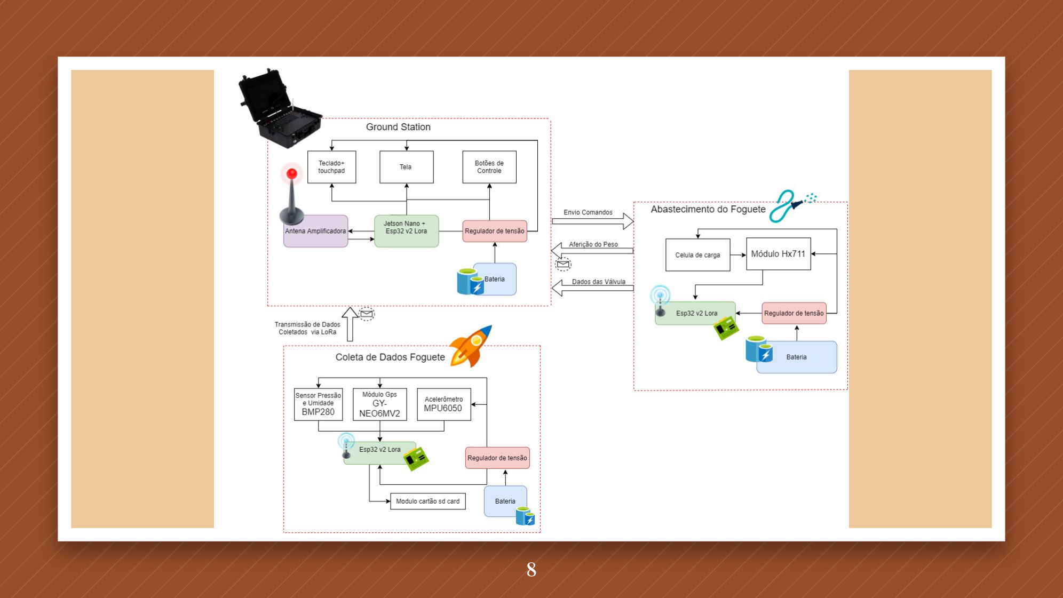
[picture p183: page 8]

Áreas de Atuação

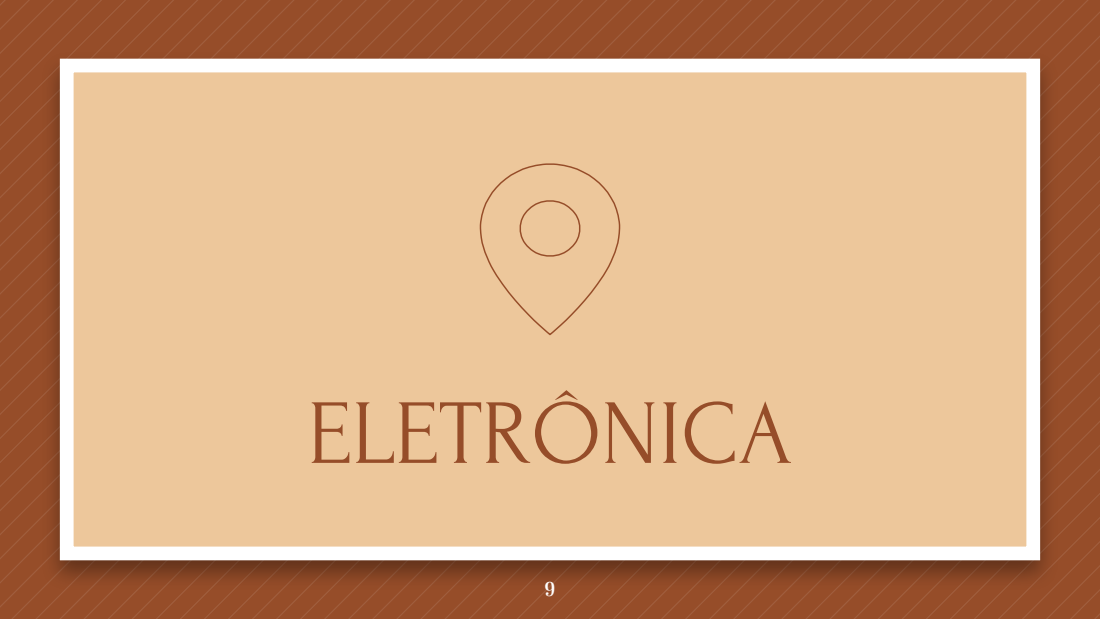
[picture p184: page 9]
ELETRÔNICA

Bring the attention of your audience over a key concept using icons or illustrations

Áreas de Atuação

### ⬗ Telemetria ⬗ Sensoriamento do foguete ⬗ Interface do usuário

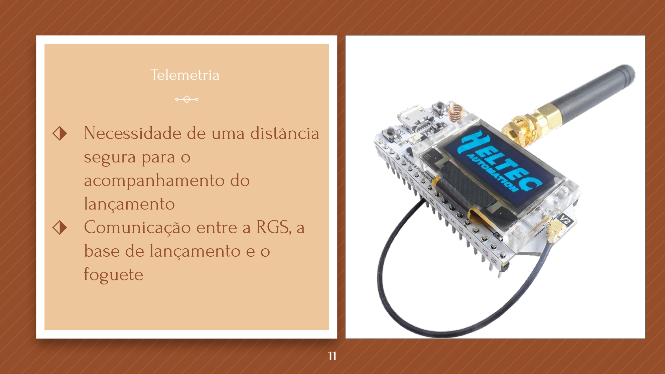
[picture p185: page 11]

Telemetria

⬗ Necessidade de uma distância segura para o
acompanhamento do
lançamento
⬗ Comunicação entre a RGS, a base de lançamento e o
foguete

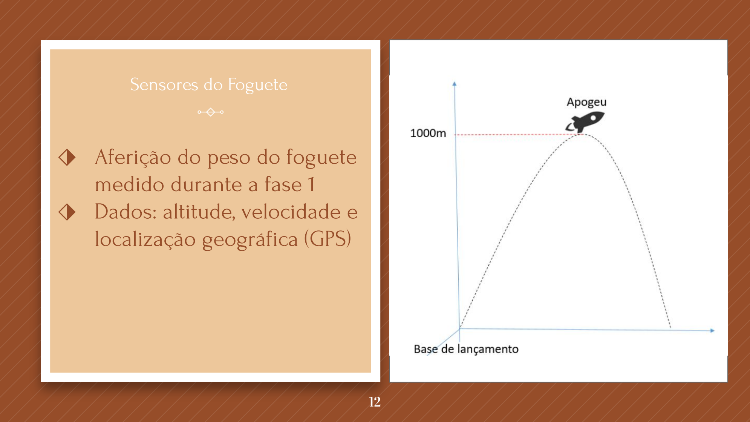
[picture p186: page 12]

Sensores do Foguete

### ⬗ Aferição do peso do foguete medido durante a fase 1 ⬗ Dados: altitude, velocidade e localização geográfica (GPS)

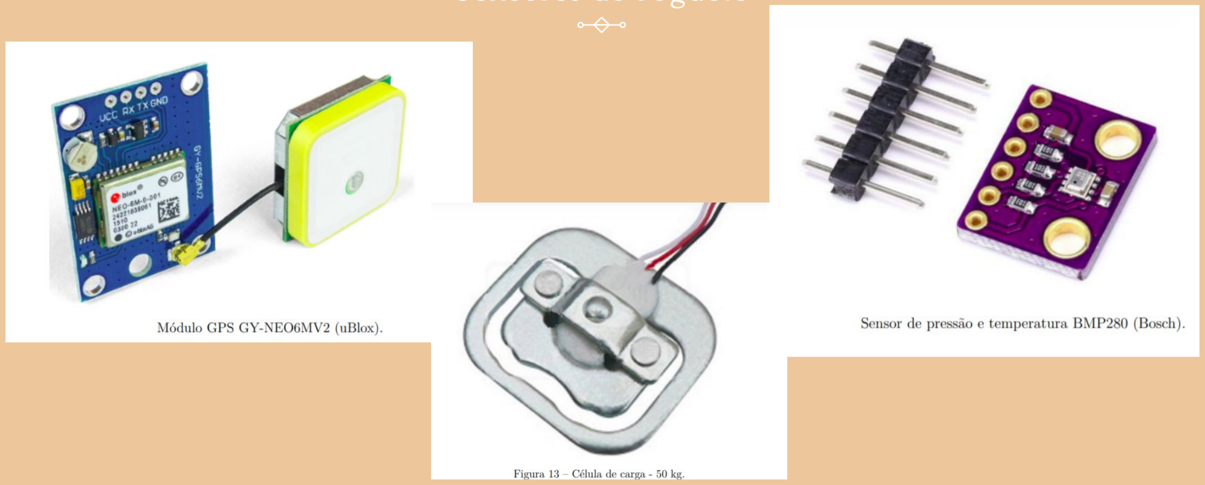
[picture p187: figure]

Sensores do Foguete

Interface do usuário

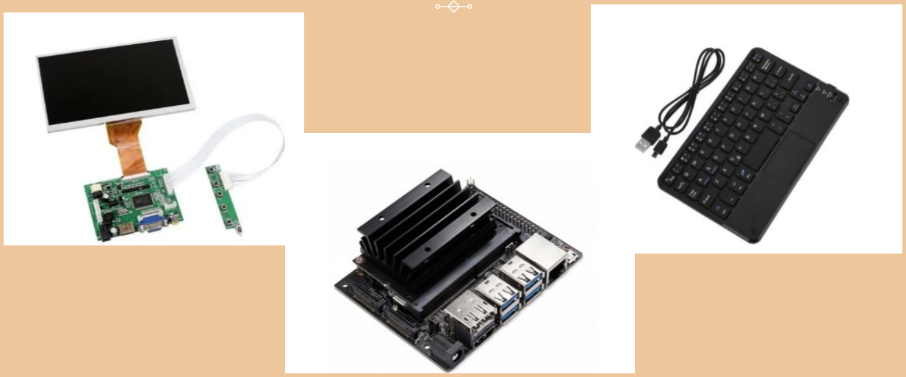
[picture p188: figure]

Ponto de controle 02

⬗ Descrição detalhada das conexões entre os componentes
⬗ Integração dos dados de telemetria com software
⬗ Integração acionamento das válvulas definidas pela Estrutura e Energia ⬗ Integração com Estrutura e Energia para o acionamento da ignição
⬗ Diagrama esquemático geral

Ponto de controle 03

⬗ Validação das Integrações com software, energia e estrutura
⬗ Construção do Manual do usuário
⬗ Detalhamento de possíveis futuros aprimoramentos para o projeto

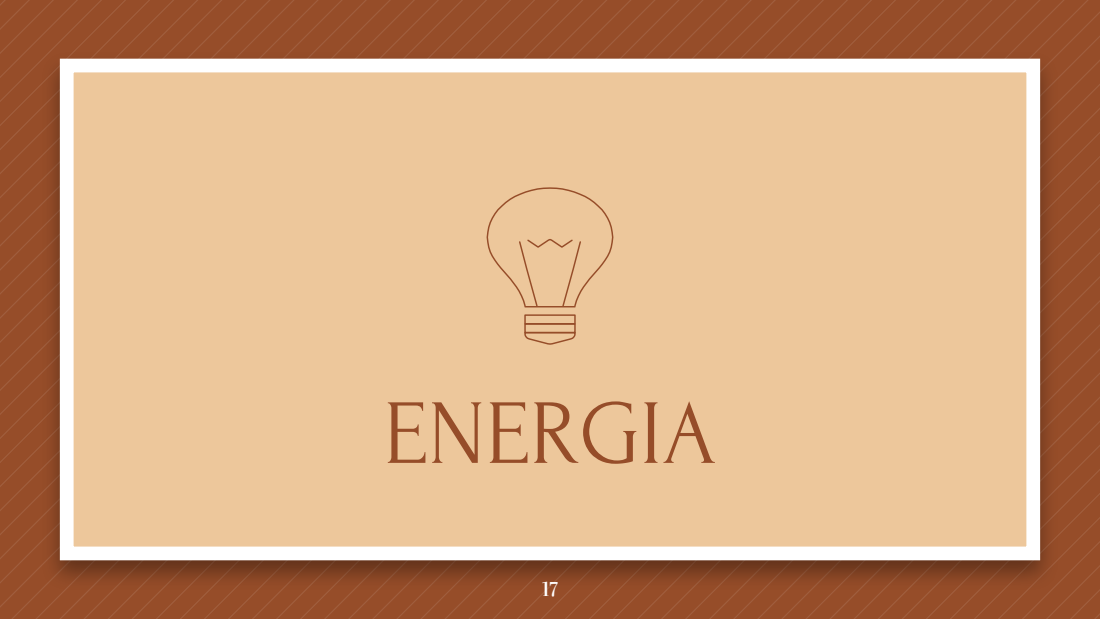
[picture p189: page 17]
ENERGIA

Bring the attention of your audience over a key concept using icons or illustrations

Solução de energia

⬗ Dimensionamento do sistema de alimentação ◇ Sistema eletrônico
◇ Sistema de ignição
⬗ Carregador de bateria

| Consumo dos componentes eletrônicos
| Tensão | Corrente | Potência
Tela | 12 V | 1 A | 12 W
Single Board Computer | 5 V | 2 A | 10 W
Teclado e botões | 5 V | 250 mA | 1,25 W
Altímetro | 3 V | 1 μA | 3 μW
GPS | 5 V | 10 mA | 500 mW
Balança (célula de carga) | 10 V | 100 mA | 1 W
Módulo base | 5 V | 500 mA | 2,5 W
Módulo foguete | 5 V | 500 mA | 2,5 W
| Bring the attention of your audience over a key concept using icons or illustrations Módulo maleta | 5 V | 500 mA | 2,5 W

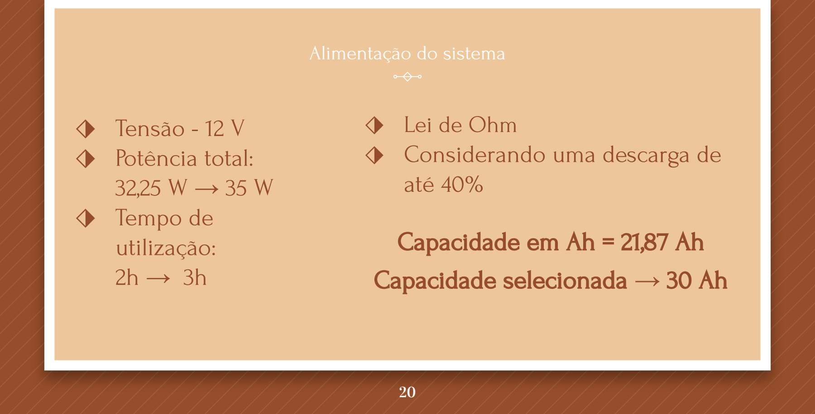
[picture p190: figure]
⬗ Tensão - 12 V ⬗ Potência total: 32,25 W → 35 W ⬗ Tempo de utilização: 2h → 3h; Alimentação do sistema; ⬗ Lei de Ohm ⬗ Considerando uma descarga de até 40%; Capacidade em Ah = 21,87 Ah Capacidade selecionada → 30 Ah

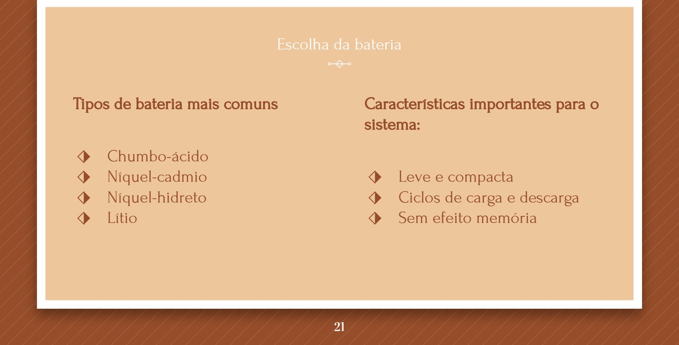
[picture p191: figure]
Características importantes para o sistema:; ⬗ Leve e compacta ⬗ Ciclos de carga e descarga ⬗ Sem efeito memória; Escolha da bateria; Tipos de bateria mais comuns; ⬗ Chumbo-ácido ⬗ Níquel-cadmio ⬗ Níquel-hidreto ⬗ Lítio
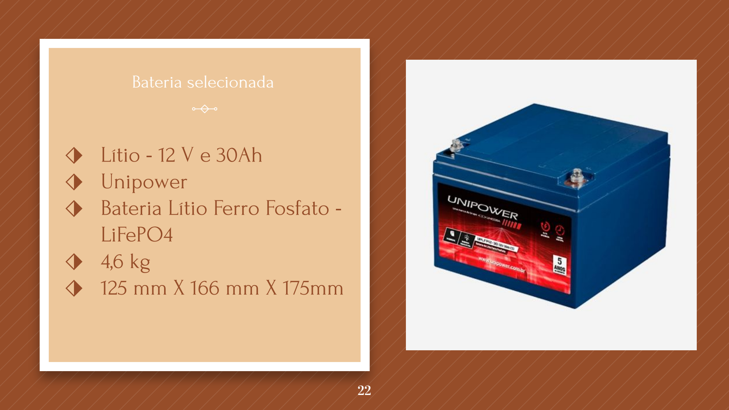
[picture p192: page 22]

Bateria selecionada

### ⬗ Lítio - 12 V e 30Ah ⬗ Unipower ⬗ Bateria Lítio Ferro Fosfato -LiFePO4

⬗ 4,6 kg

### ⬗ 125 mm X 166 mm X 175mm

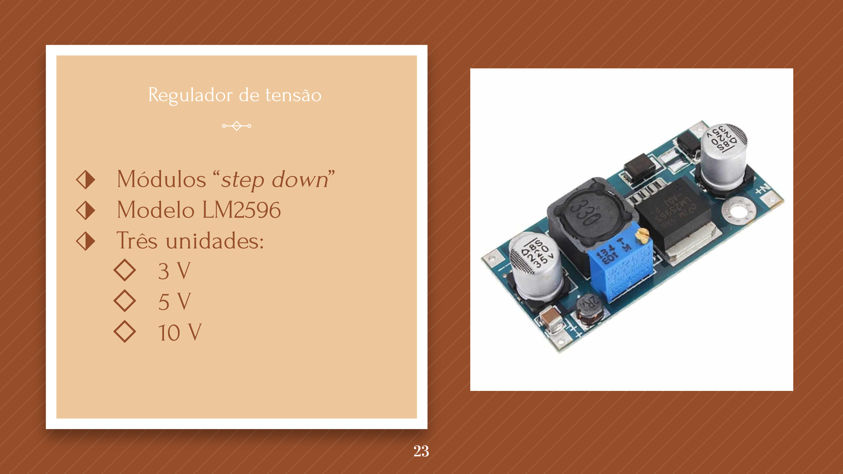
[picture p193: page 23]

Regulador de tensão

### ⬗ Módulos “step down” ⬗ Modelo LM2596 ⬗ Três unidades:

◇ 3 V
◇ 5 V
◇ 10 V

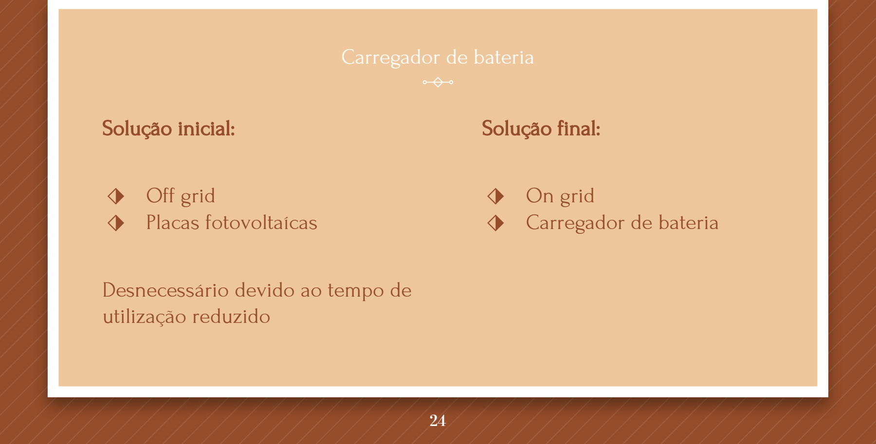
[picture p194: figure]
Solução inicial:; ⬗ Off grid ⬗ Placas fotovoltaícas; Desnecessário devido ao tempo de utilização reduzido; Carregador de bateria; Solução final:; ⬗ On grid ⬗ Carregador de bateria

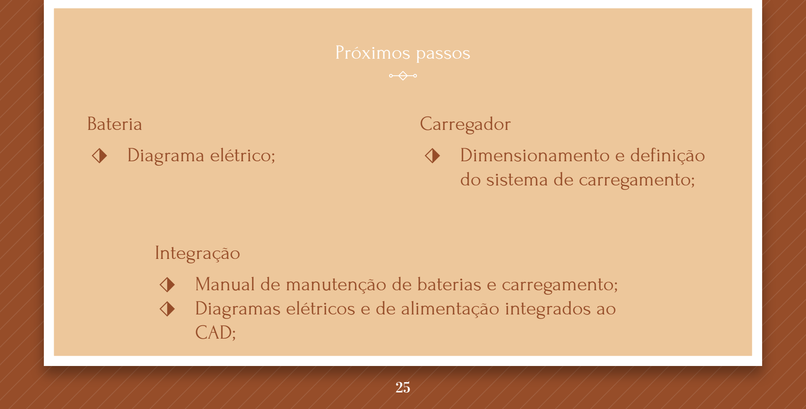
[picture p195: figure]
Próximos passos; Bateria ⬗ Diagrama elétrico;; Carregador ⬗ Dimensionamento e definição do sistema de carregamento;; Integração; CAD;

⬗ Manual de manutenção de baterias e carregamento; ⬗ Diagramas elétricos e de alimentação integrados ao

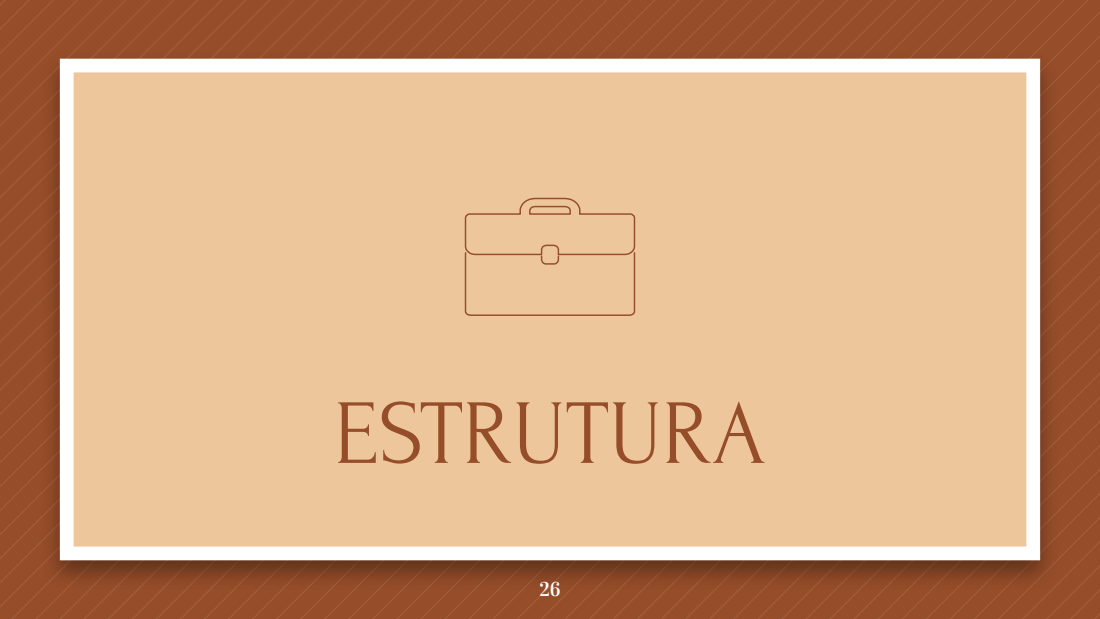
[picture p196: page 26]
ESTRUTURA

Bring the attention of your audience over a key concept using icons or illustrations

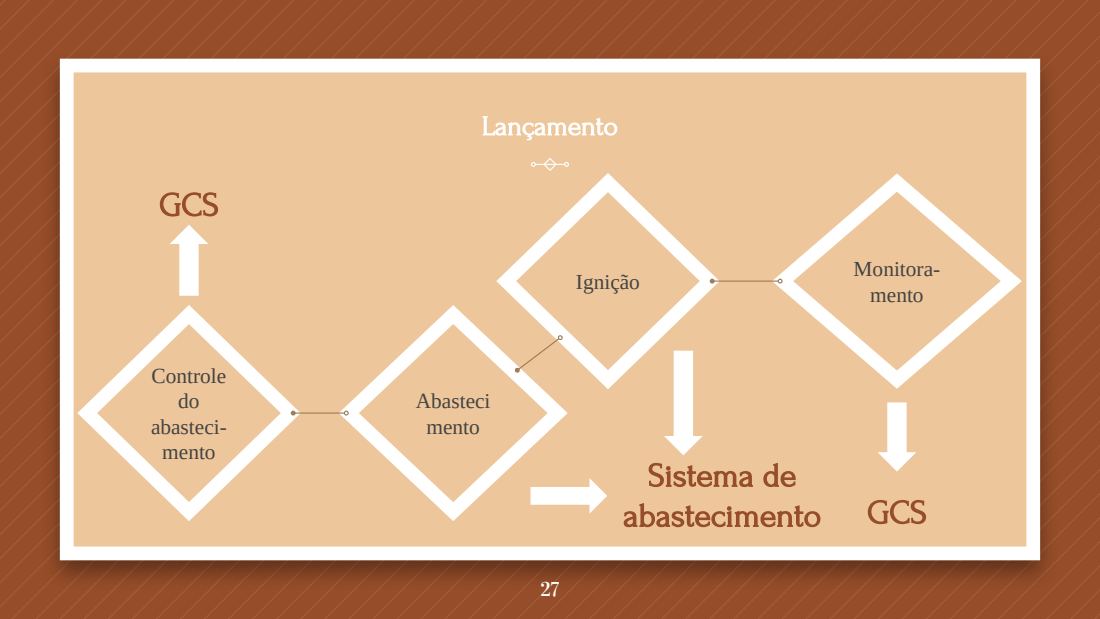
[picture p197: page 27]
Lançamento; Abasteci mento; Controle do abasteci- mento; Monitora- mento; Ignição; GCS; Sistema de abastecimento

“

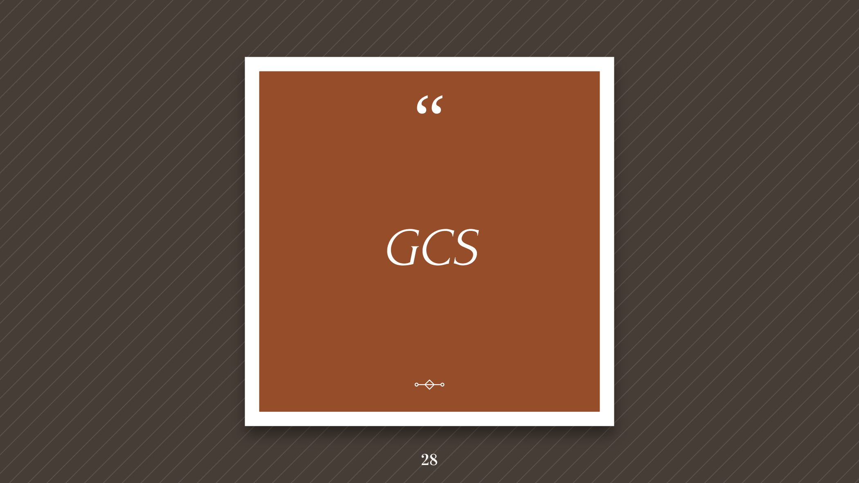
[picture p198: page 28]

# GCS

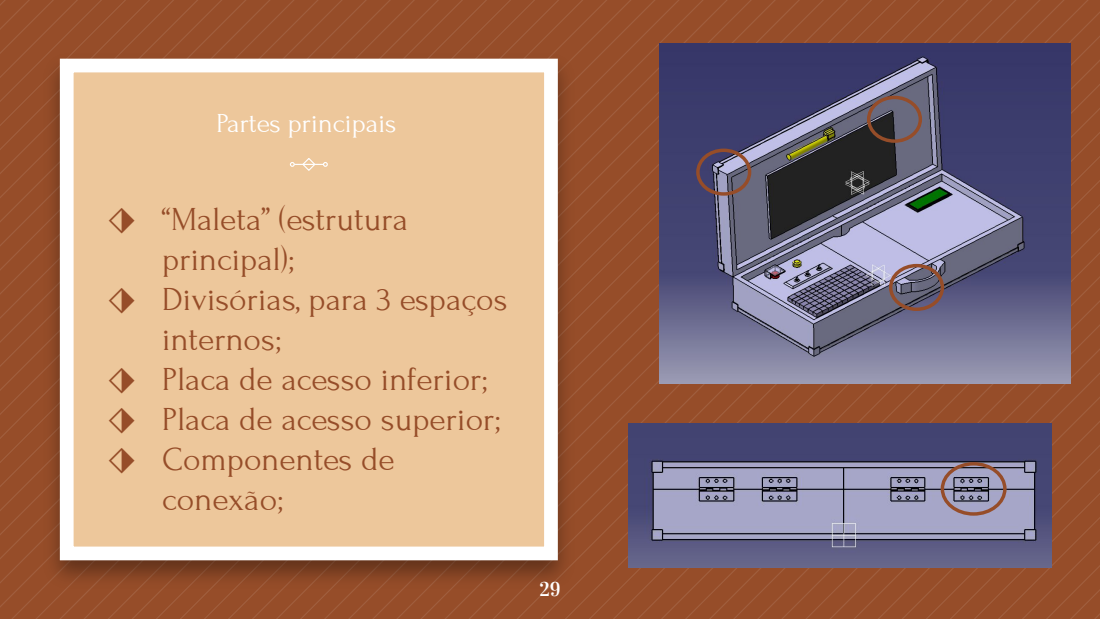
[picture p199: page 29]
Partes principais

⬗ “Maleta” (estrutura
principal);
⬗ Divisórias, para 3 espaços
internos;
⬗ Placa de acesso inferior;
⬗ Placa de acesso superior;
⬗ Componentes de
conexão;

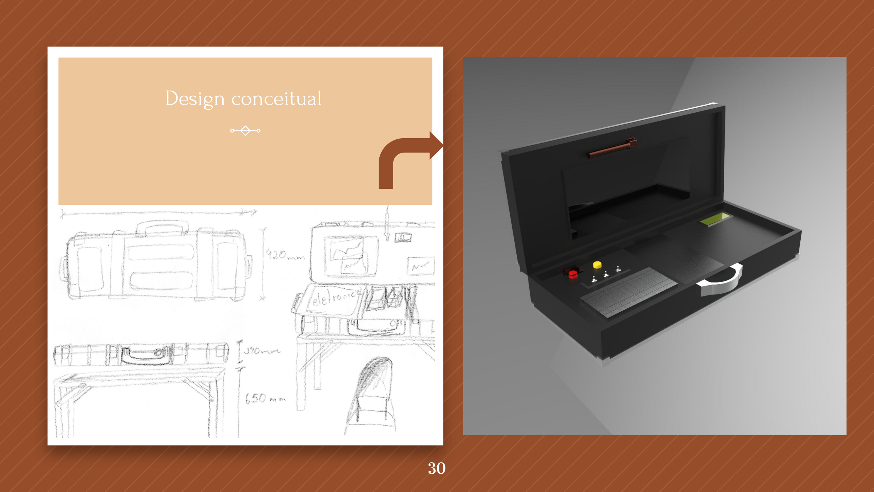
[picture p200: page 30]

Design conceitual

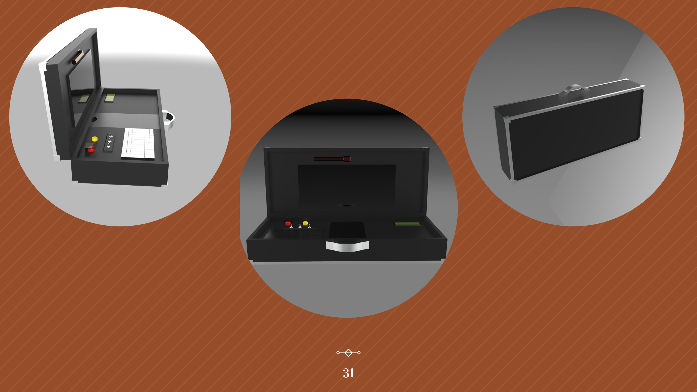
[picture p201: page 31]

Materiais

| MDF | PRFV | PRFC | PLA | ABS
Comunicação com os subsistemas | Bom | Bom | Bom | Bom | Bom
Usabilidade e ergonomia | Bom | Razoável | Razoável | Bom | Bom
Custo | Bom | Bom | Ruim | Razoável | Razoável
Propriedades mecânica | Bom | Razoável | Bom | Razoável | Razoável
Densidade | Bom | Razoável | Bom | Bom | Bom
Escolha para a estrutura principal: MDF

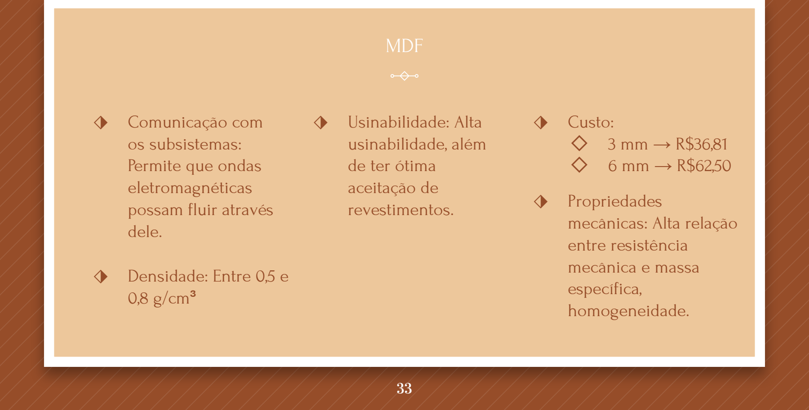
[picture p202: figure]
MDF; ⬗ Comunicação com os subsistemas: Permite que ondas eletromagnéticas possam fluir através dele.; ⬗ Usinabilidade: Alta usinabilidade, além de ter ótima aceitação de revestimentos.; ⬗ Custo: ◇ 3 mm → R$36,81 ◇ 6 mm → R$62,50; ⬗ Propriedades mecânicas: Alta relação entre resistência mecânica e massa específica, homogeneidade.; ⬗ Densidade: Entre 0,5 e 0,8 g/cm³

“

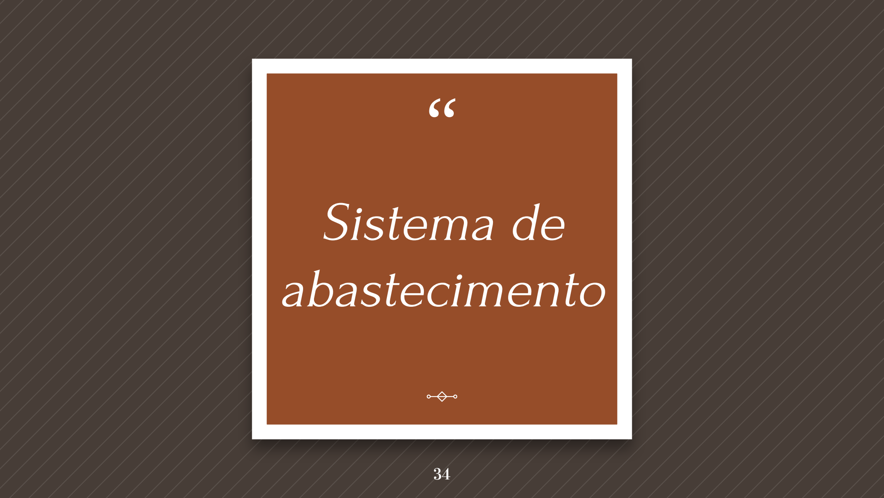
[picture p203: page 34]

# Sistema de abastecimento

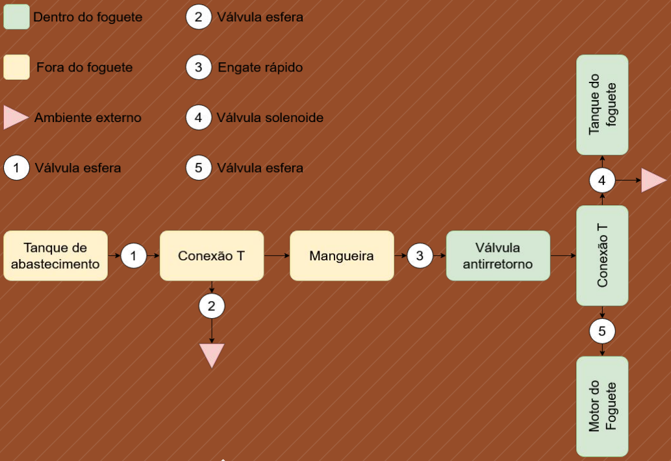
[picture p204: figure]

Componentes
pré-estabelecidos

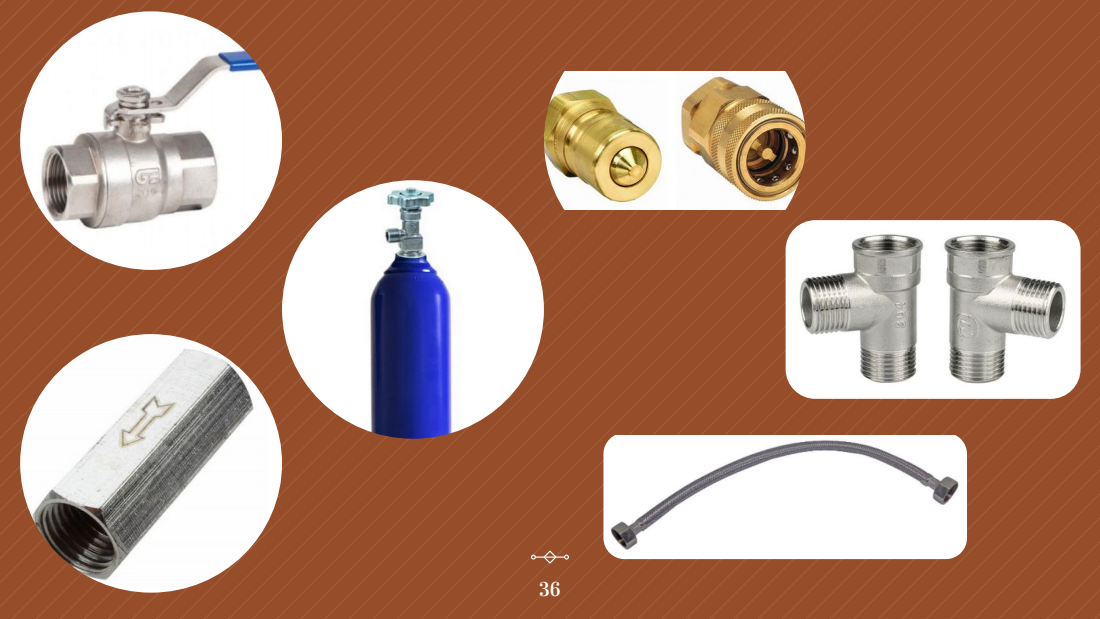
[picture p205: page 36]

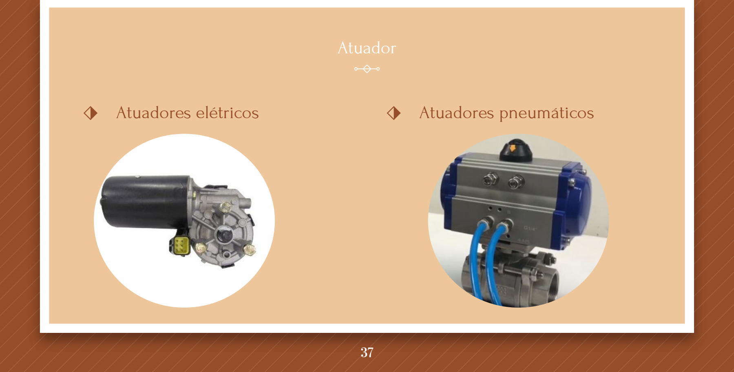
[picture p206: figure]
⬗ Atuadores elétricos; Atuador; ⬗ Atuadores pneumáticos

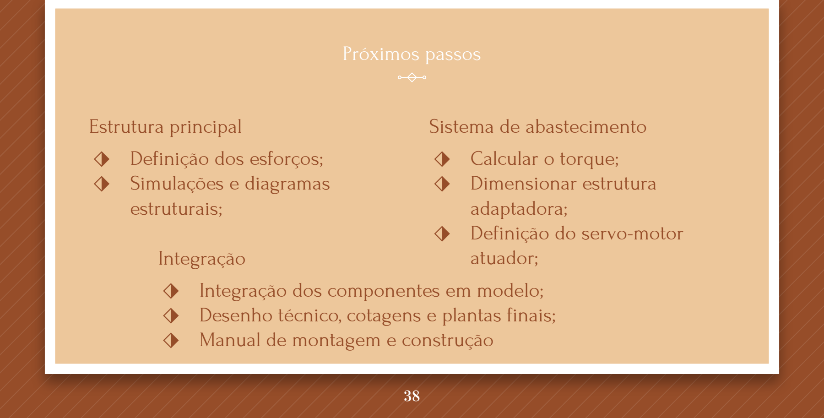
[picture p207: figure]
Próximos passos; Estrutura principal ⬗ Definição dos esforços; ⬗ Simulações e diagramas estruturais;; Sistema de abastecimento ⬗ Calcular o torque; ⬗ Dimensionar estrutura adaptadora; ⬗ Definição do servo-motor atuador;; Integração ⬗ Integração dos componentes em modelo;; ⬗ Manual de montagem e construção

⬗ Desenho técnico, cotagens e plantas finais;

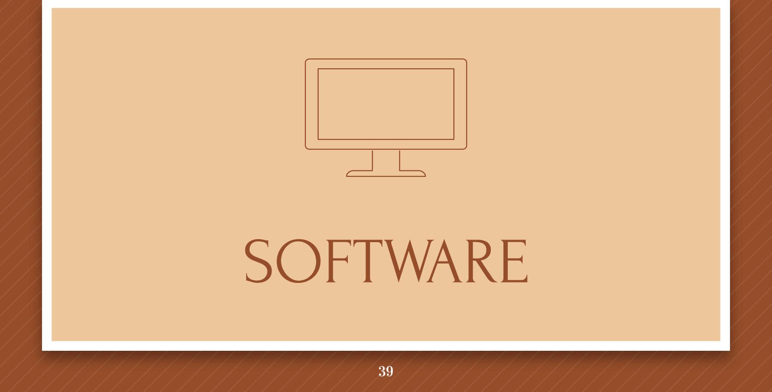
[picture p208: figure]
SOFTWARE

Bring the attention of your audience over a key concept using icons or illustrations

Fase 1

### ⬗ Comandos de abastecimento ⬗ Comandos de ignição ⬗ Acompanhamento do peso durante o abastecimento

Fase 2

### ⬗ Acompanhamento de voo ⬗ GPS ⬗ Altitude ⬗ Velocidade ⬗ Pressão e temperatura ⬗ Treinamento e inferencia do algoritmo de ML

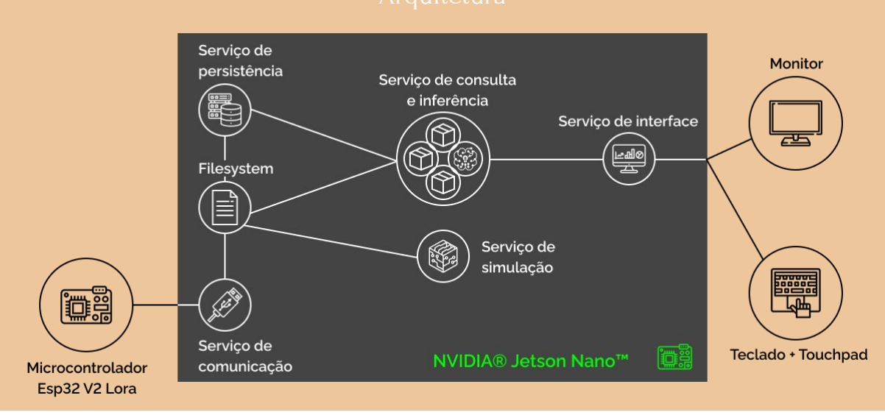
[picture p209: figure]

Arquitetura

Evolução

### ⬗ Início do levantamento do Dataset ⬗ Detalhamento da arquitetura - Diagrama de sequência ⬗ Detalhamento do requisitos - Storytelling

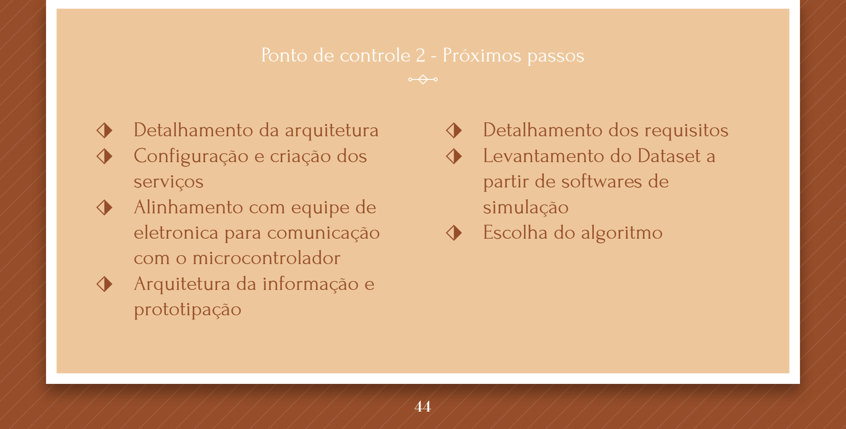
[picture p210: figure]
Ponto de controle 2 - Próximos passos; ⬗ Detalhamento da arquitetura ⬗ Configuração e criação dos serviços ⬗ Alinhamento com equipe de eletronica para comunicação com o microcontrolador ⬗ Arquitetura da informação e prototipação; ⬗ Detalhamento dos requisitos ⬗ Levantamento do Dataset a partir de softwares de simulação ⬗ Escolha do algoritmo

Ponto de controle 3 - Próximos passos

⬗ Desenvolvimento dos serviços de armazenamento e consulta dos dados de telemetria
⬗ Desenvolvimento do serviço de interface
⬗ Treinar algoritmo de ML
⬗ Diagrama de integração
⬗ Guia de uso do software
⬗ Guia de instalação

# Obrigado!

Any questions?
You can find me at @username & user@mail.me
