Ground-Station/Documentation/presentations/apresentacao_PC2.pdf

# Ponto de Controle 2

- Atualizações quanto ao PC1;
- Alterações no projeto;
- Próximos passos;

## Apresentação

- Software: troca do machine learning pelo software configurável;
- Eletrônica: central de controle, módulo do foguete e base;
- Energia: adoção de mais uma bateria;
- Estrutura: divisão entre duas estruturas separadas;

## Título Principais alterações

# Software

## Product Design

- Product Design é o processo que os designers usam combinando as necessidades do usuário com os objetivos do negócio
- User Centered Design são os processos de design com foco nos usuários os quais os usuários influenciam na construção do produto

## Product Design

- Entrevistas
- Entrevista semi-estruturada
- Entrevista não estruturada
- Brainwriting
- Brainwriting Pool
- Nominal Group Technique(NGT)
- Storyboard
- Storytelling
- Storyboard

## Wireframe

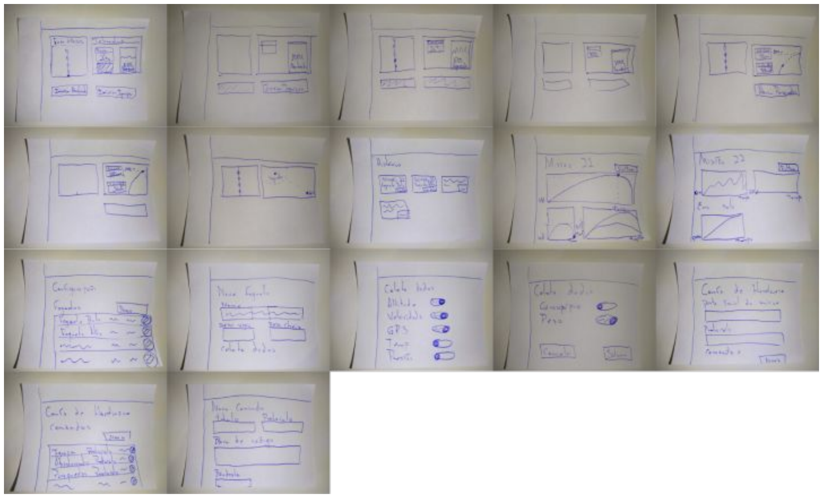
[picture p211: figure]

## Protótipo de média fidelidade

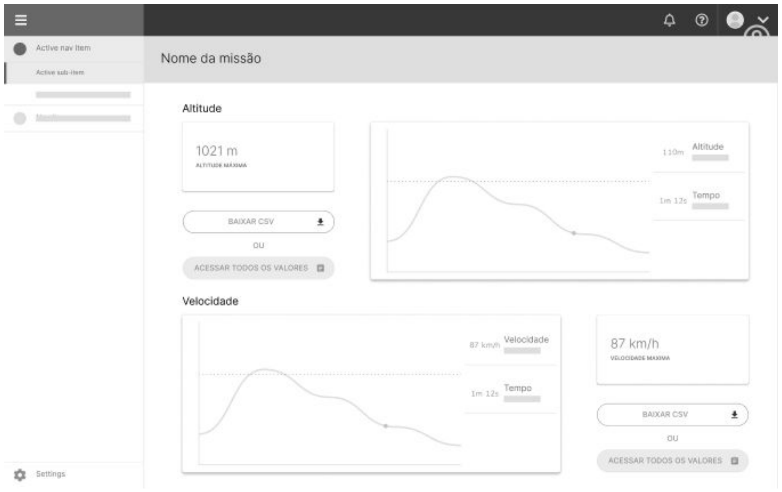
[picture p212: figure]

## Diagrama de sequência

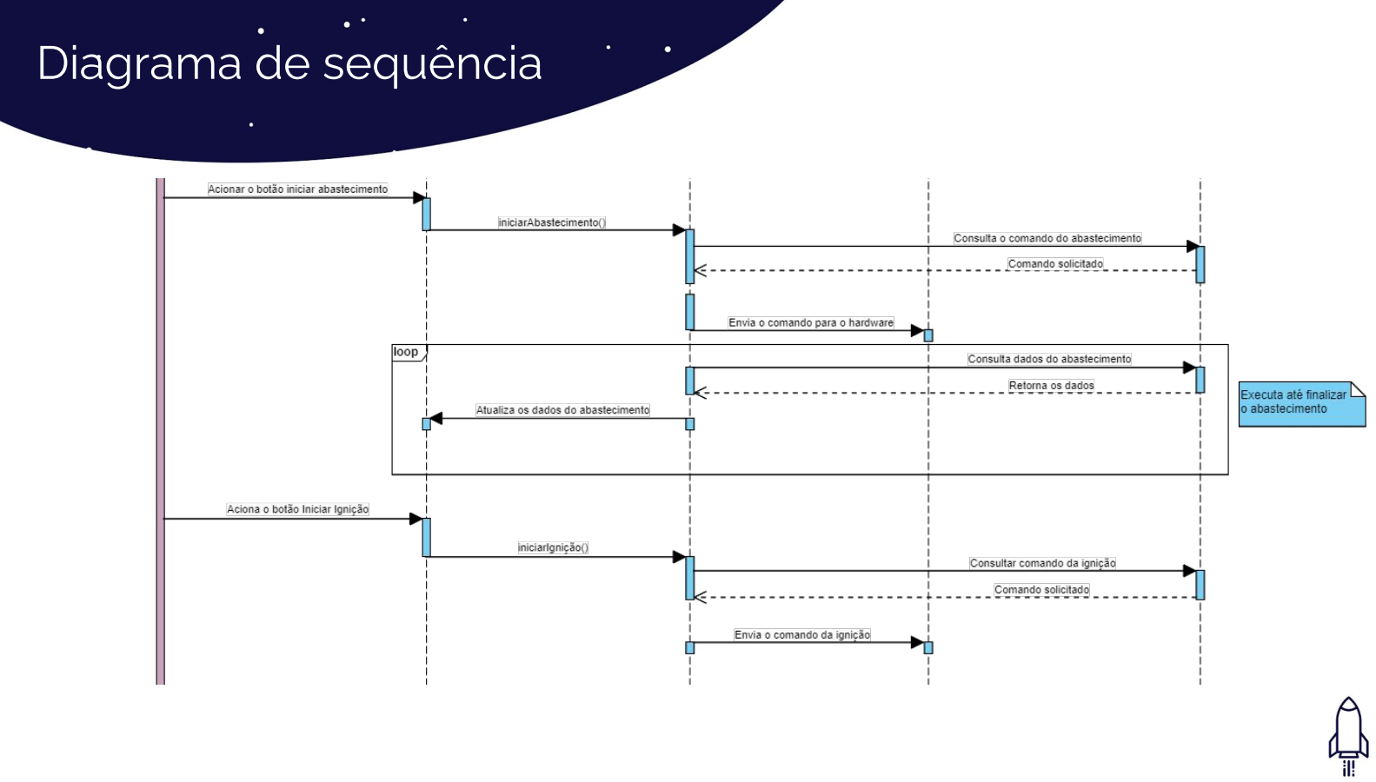
[picture p213: page 10]

## Banco de dados

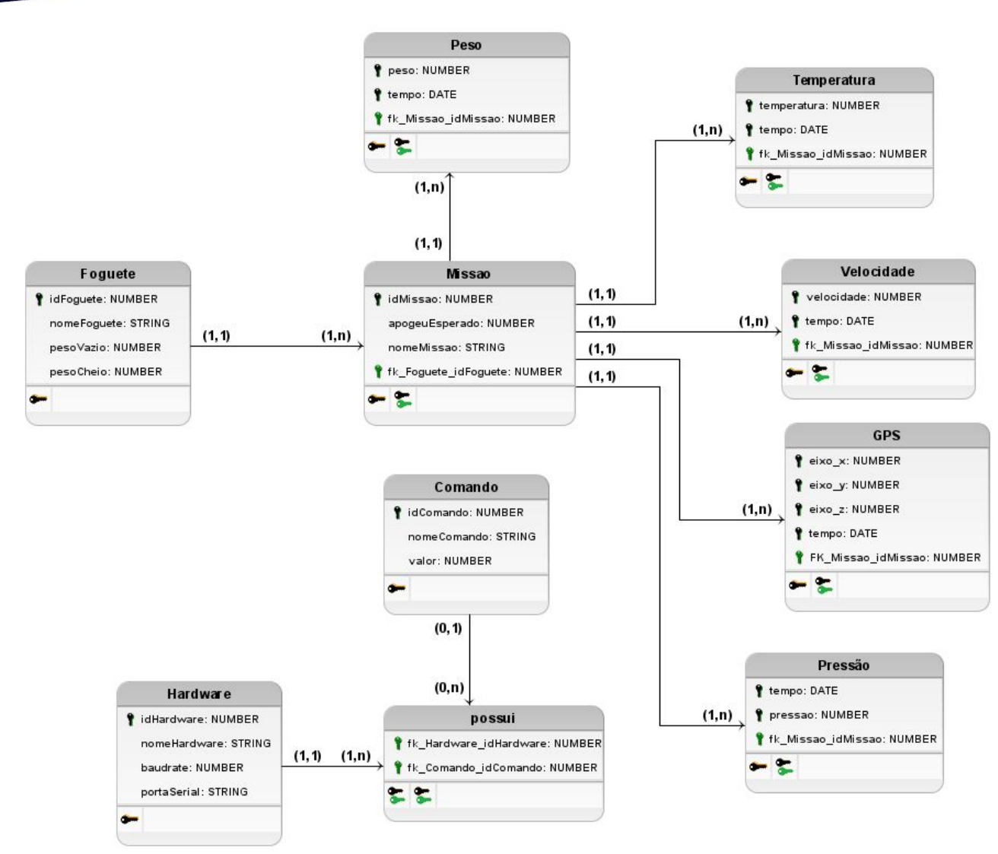
[picture p214: figure]

## Diagrama de arquitetura

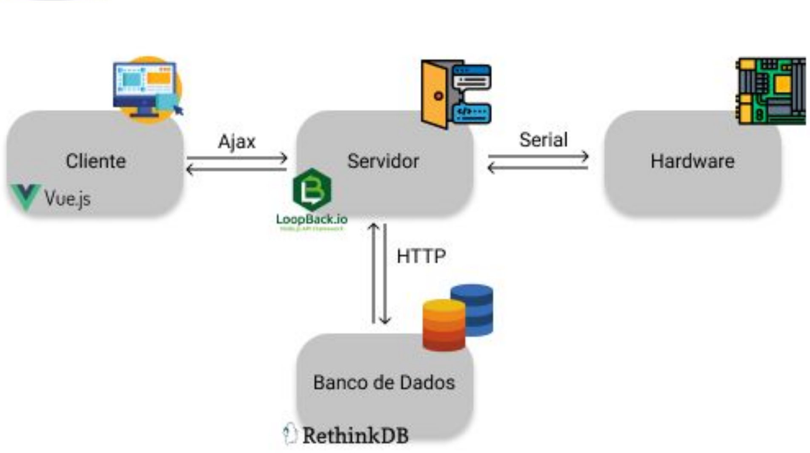
[picture p215: figure]

## Evolução

- Início da configuração da infraestrutura de desenvolvimento
- Evolução do alinhamento com eletrônica

## Próximos passos

- Desenvolver interface de acordo com os protótipos
- Desenvolver APIs de acordo com a arquitetura proposta
- Documentar comunicação entre software e eletrônica

# Eletrônica

## Proposta de Solução

- Central de controle
- Módulo do foguete
- Base de Abastecimento

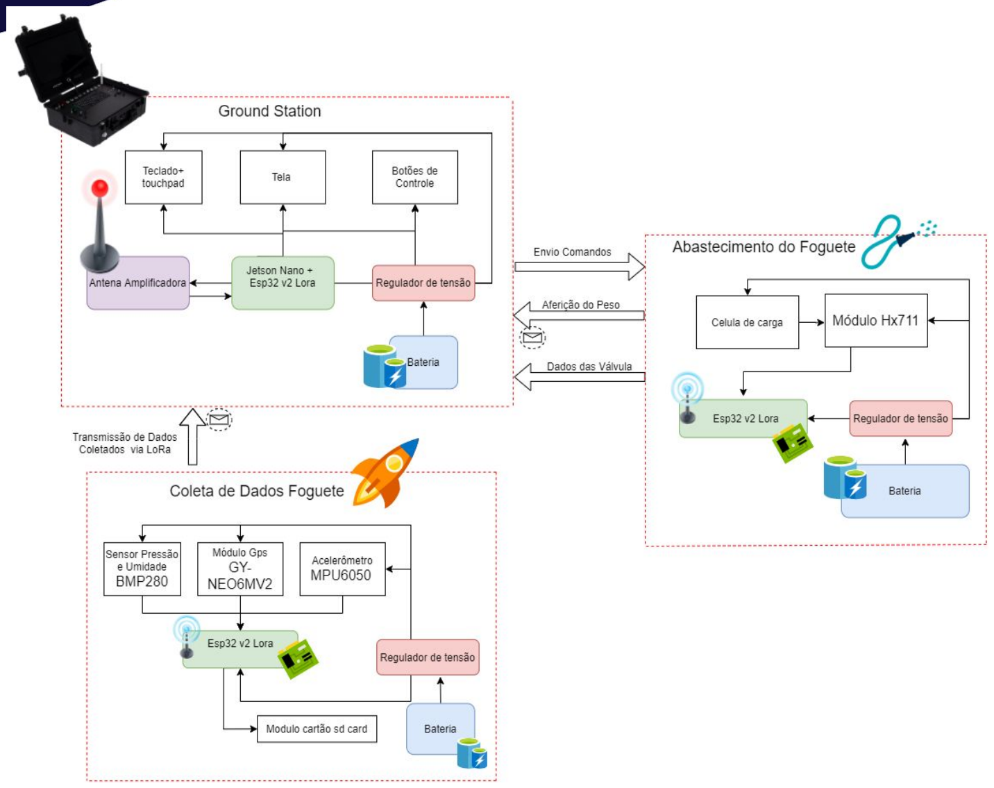
[picture p216: figure]

Diagrama Geral inicial

## Título

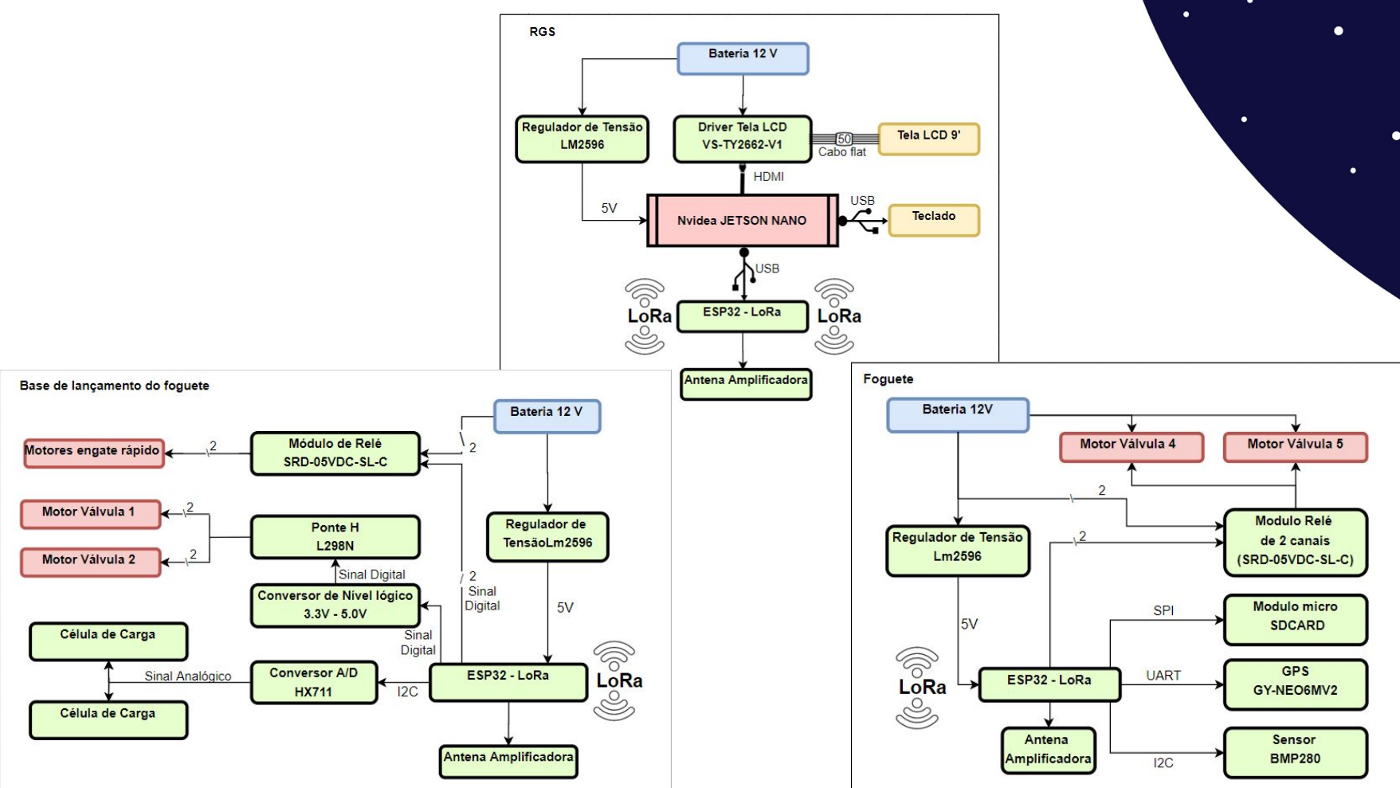
[picture p217: page 17]

## Controle Principal

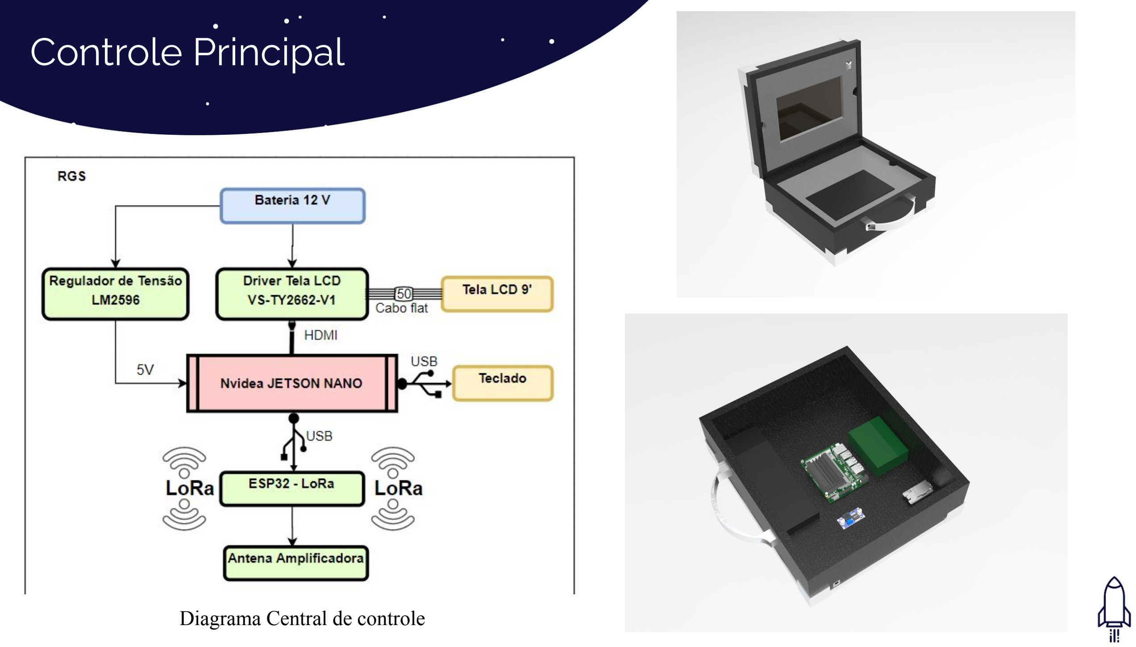
[picture p218: page 18]

Diagrama Central de controle

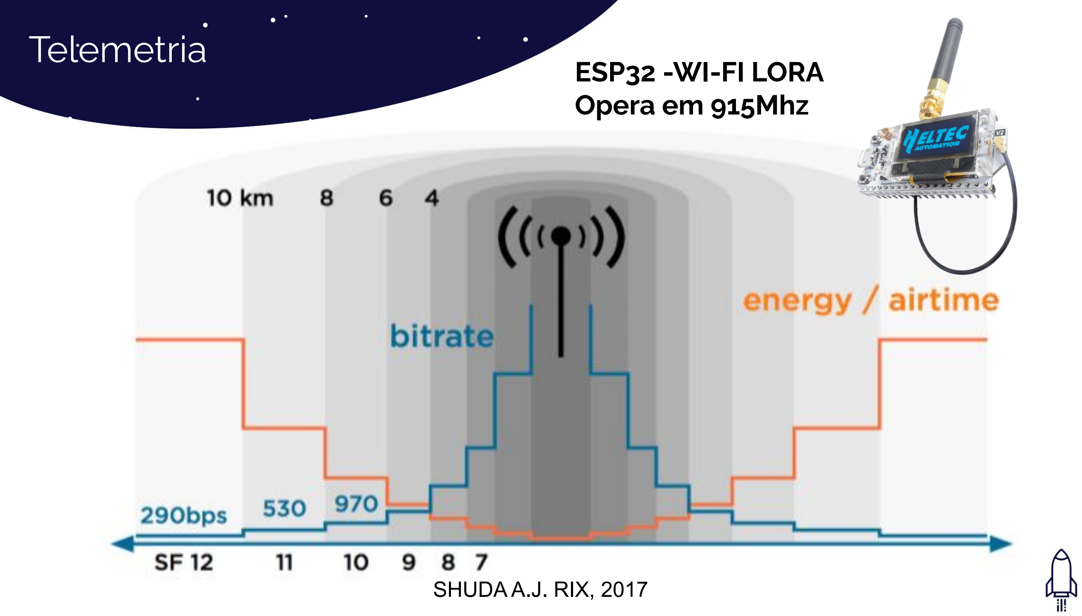
[picture p219: page 19]

Telemetria | ESP32 -WI-FI LORA
| Opera em 915Mhz

SHUDA A.J. RIX, 2017

## Título

## Taxas de Transmissão -Lora

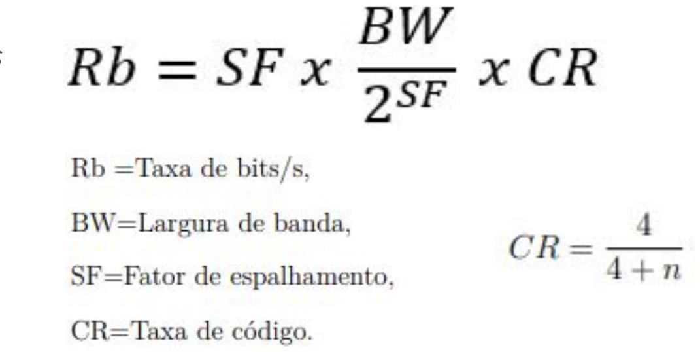
[picture p220: figure]

Largura de Banda Disponíveis
- 125 KHz
- 250 KHz
- 500 KHz

CR pode variar de 7 a 8

SF pode variar de 7 a 12

(ZHO, 2019)

## Sensoriamento

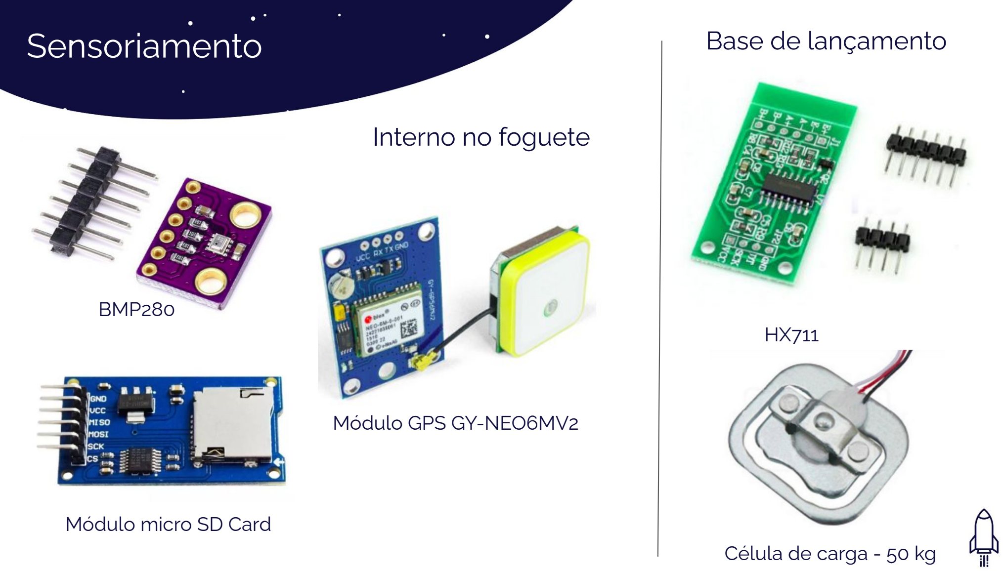
[picture p221: page 21]

BMP280

Módulo GPS GY-NEO6MV2

Célula de carga - 50 kg

HX711

Módulo micro SD Card

Interno no foguete

Base de lançamento

## Título Calibração

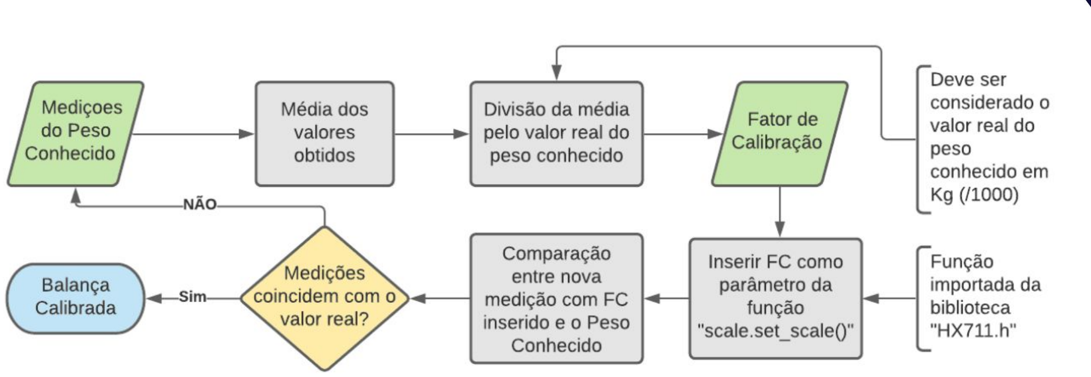
[picture p222: figure]

Diagrama do algoritmo de calibração da balança

## Esquemáticos

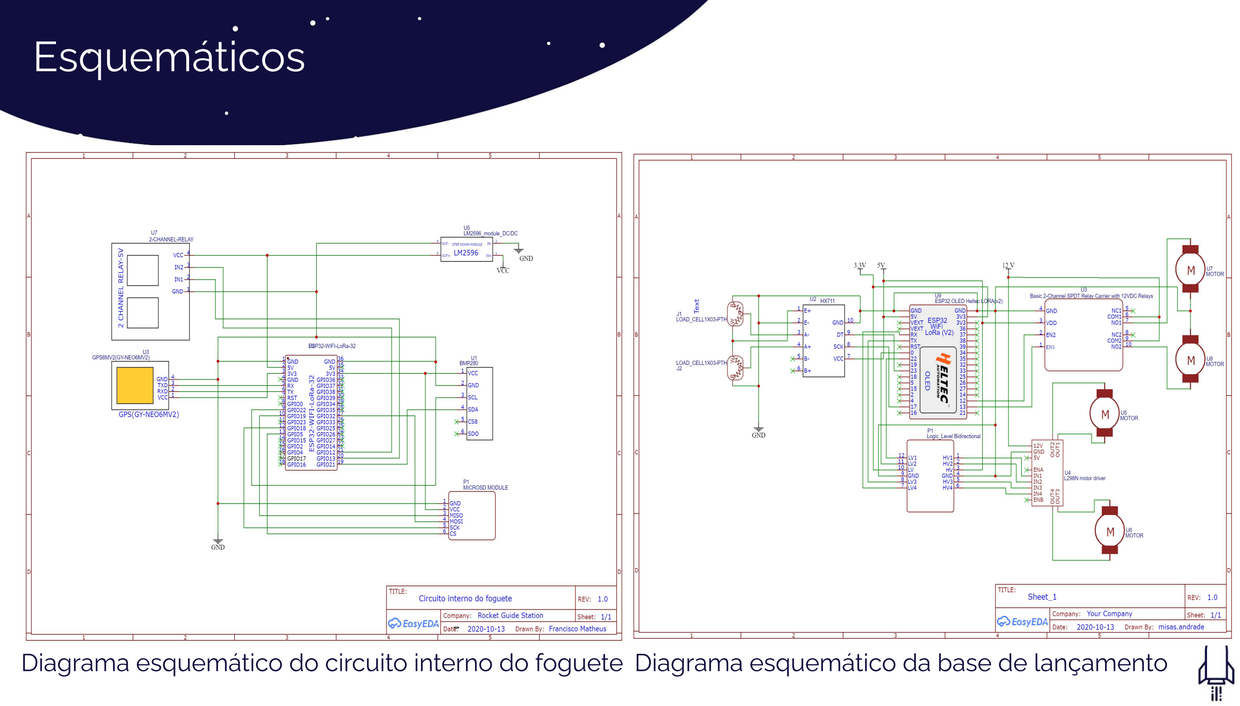
[picture p223: page 23]

Diagrama esquemático do circuito interno do foguete Diagrama esquemático da base de lançamento

## Projeto de PCI

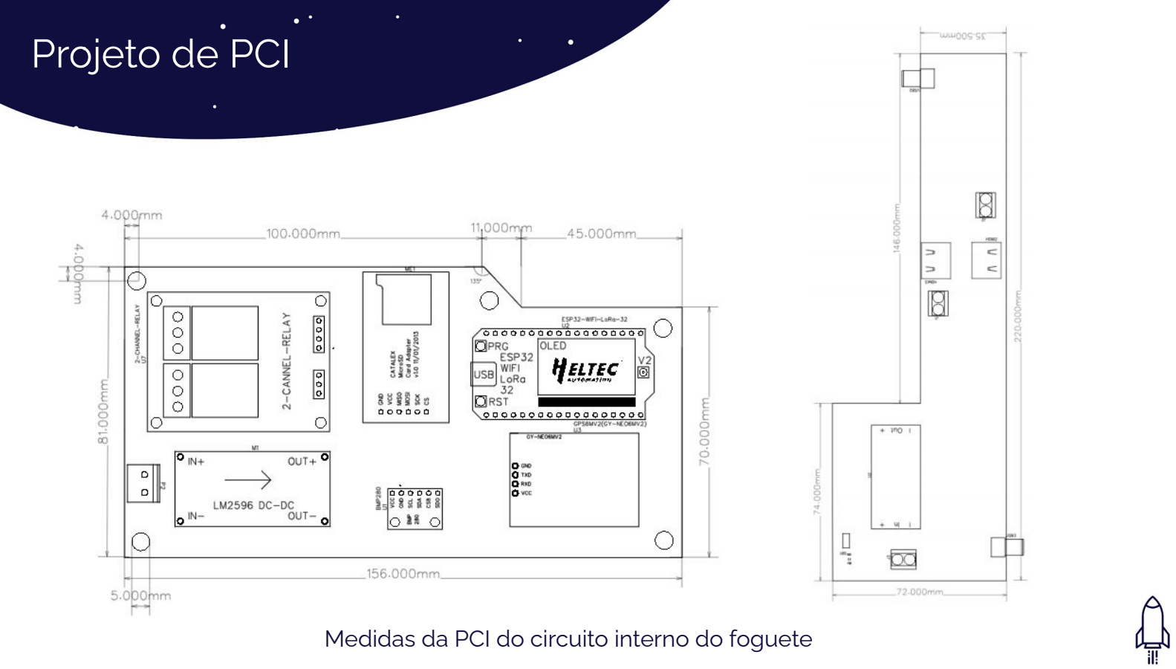
[picture p224: page 24]

Medidas da PCI do circuito interno do foguete

## Título Placas de circuito impresso

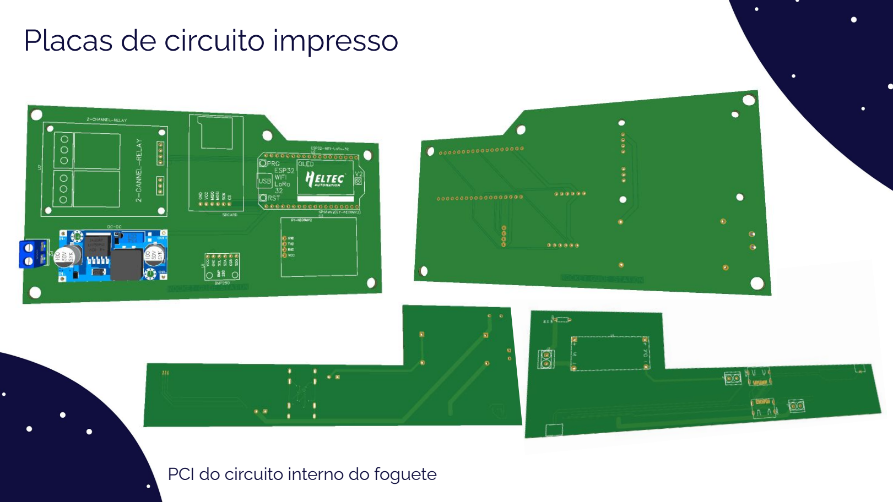
[picture p225: page 25]

PCI do circuito interno do foguete

## Integração

- Acionamento das válvulas internas e das válvulas externas ao foguete
- Fluxo de dados e comunicação entre Hardware e Software
- Integração para disposição dos componentes na RGS

## Próximos passos

- Estudo sobre antenas;
- Detalhamento da integração com as outras áreas do projeto;
- Futuras melhorias e continuações para o trabalho;
- Confecção do manual de uso e manutenção;

# Energia

## Consumo

- Ignição
- Fio de Níquel Cromo (Ni-Cr)
■ 0,8mm² 300ºC
■ R = 2,23 Ohm
■ Lei de Ohm I = 5,38 A P = 64,56 W

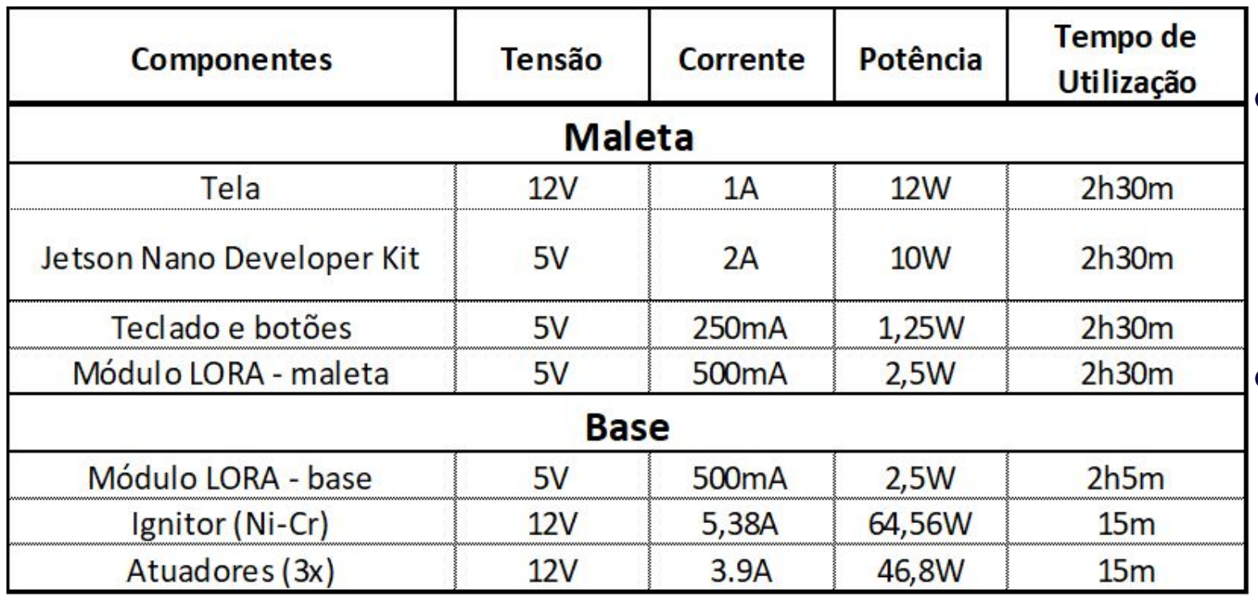
[picture p226: figure]

- Maleta
- 30W x 2h30m = 75Wh
- I = 75/12 = 5,83Ah
- Base
- 2,5W x 2h30m = 6,25Wh
- 111,36W x 15m = 27,84Wh
- I = 34,09/12 = 3,33Ah

## Baterias

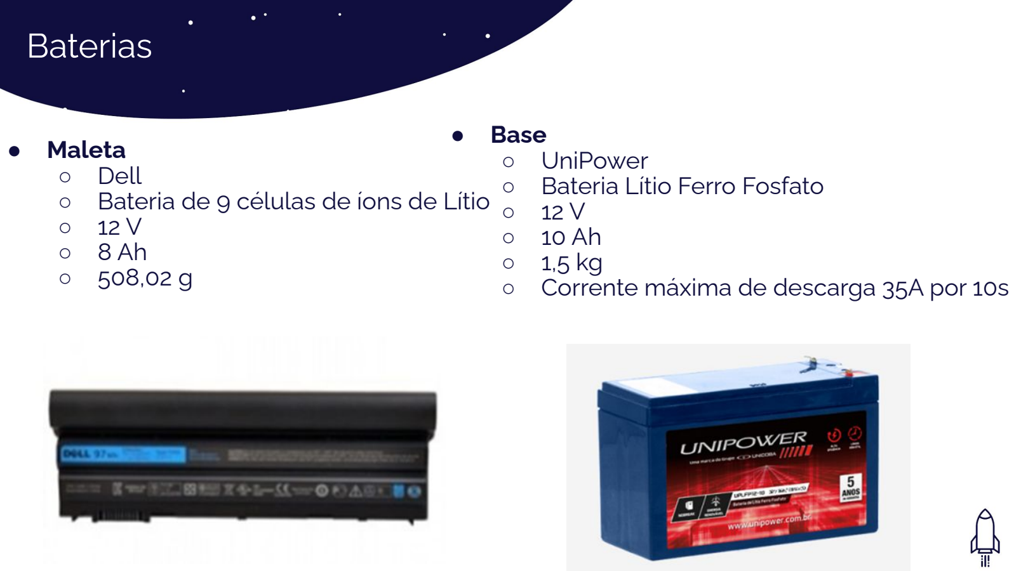
[picture p227: page 30]

- Maleta
- Dell
- Bateria de 9 células de íons de Lítio
- 12 V
- 8 Ah
- 508,02 g
- Base
- UniPower
- Bateria Lítio Ferro Fosfato
- 12 V
- 10 Ah
- 1,5 kg
- Corrente máxima de descarga 35A por 10s

## Carregador

Limites:
- Tensão máx. de saída: 14,6V
- Corrente máx. de saída: 10A
- Corrente ideal de carregamento: 1A
- Tempo médio de carregamento: 3h
- Limitador de tensão

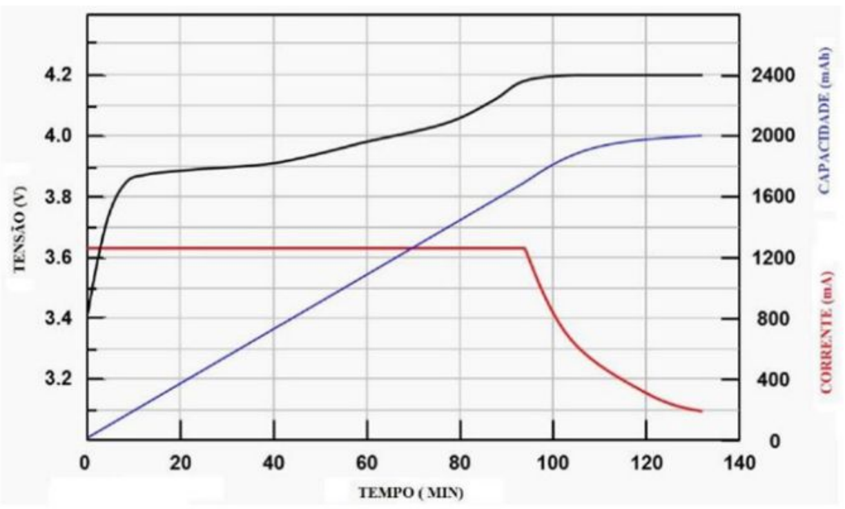
[picture p228: figure]

Curva de carga da bateria de Lítio íon

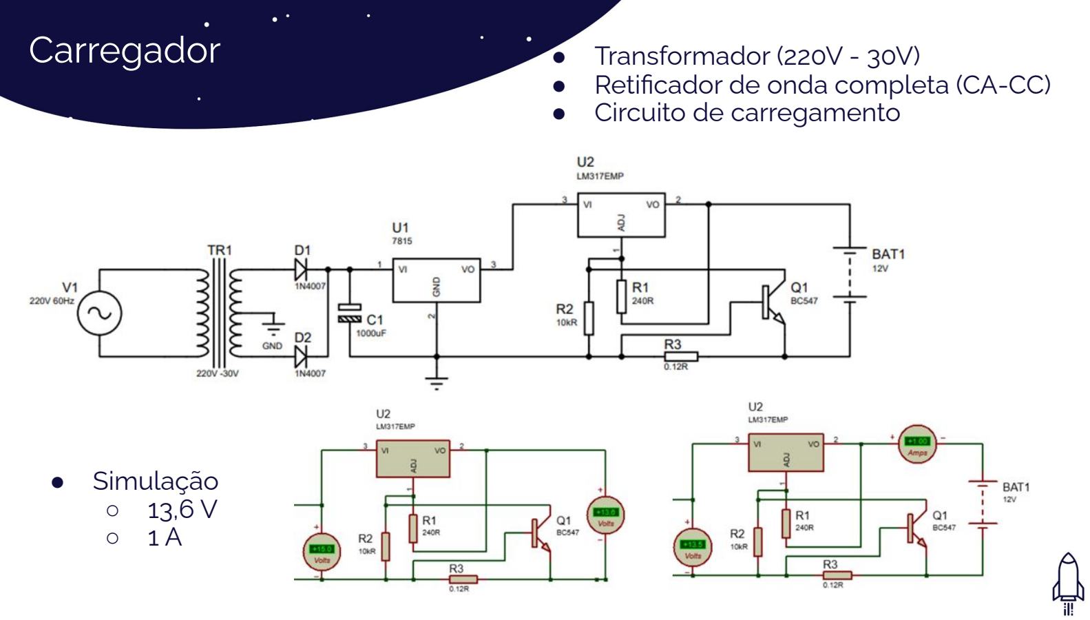
[picture p229: page 32]

Carregador | ● Transformador (220V - 30V) ● Retificador de onda completa (CA-CC) ● Circuito de carregamento
- Simulação
- 13,6 V
- 1 A

## Condutores

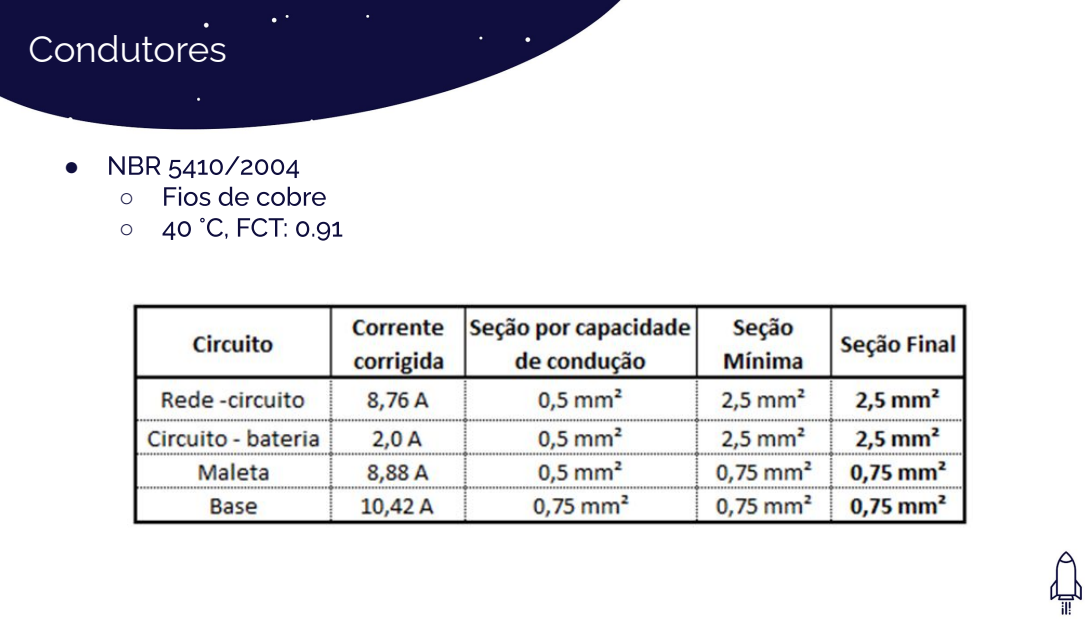
[picture p230: page 33]

## Sistema de Alimentação

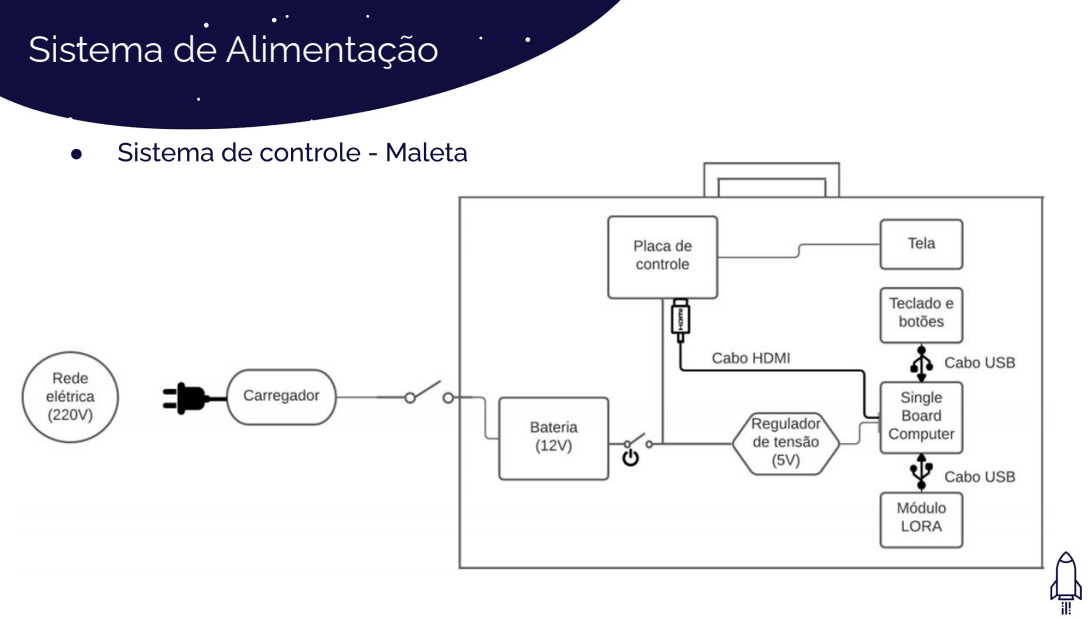
[picture p231: page 34]

## Sistema de Alimentação

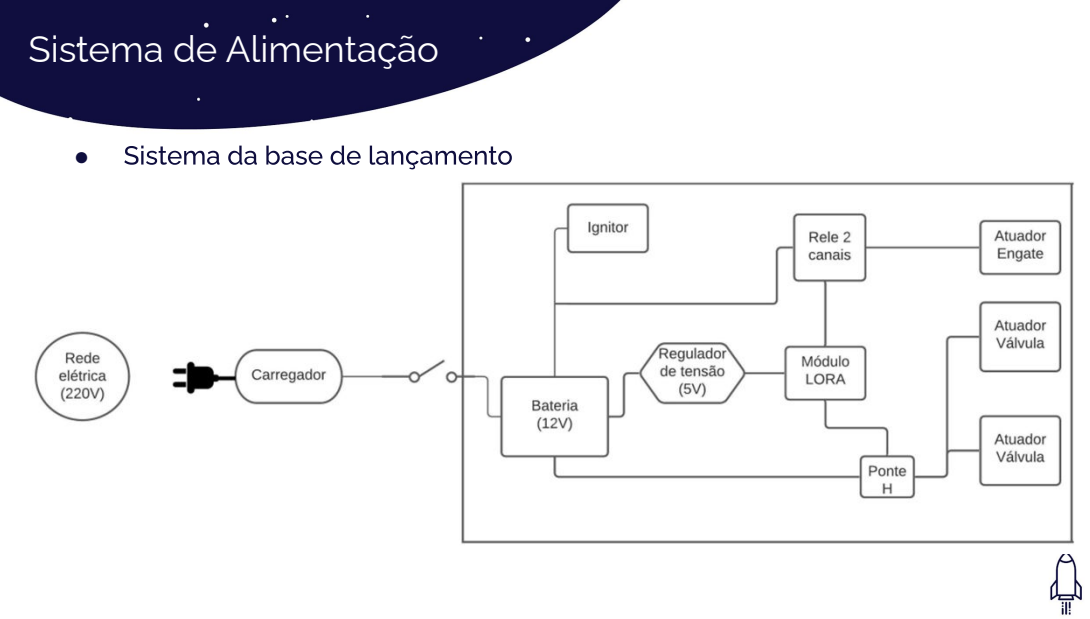
[picture p232: page 35]

## Próximos passos

- Conectores do carregador;
- Detalhamento da integração com as outras áreas do projeto;
- Confecção do manual de uso e manutenção;

# Estrutura

## Título Solução estrutural e requisitos

- Estrutura física compacta
e portátil

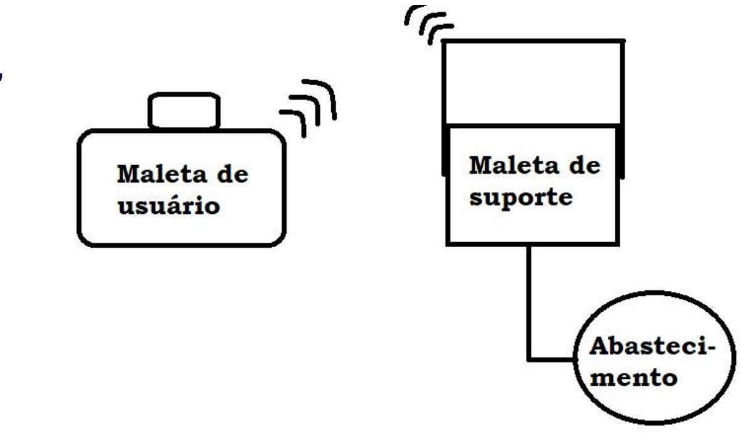
[picture p233: figure]

- Material leve e resistente,
- Sistema de transmissão
de torque do atuador
para a válvula esfera

## Mudanças

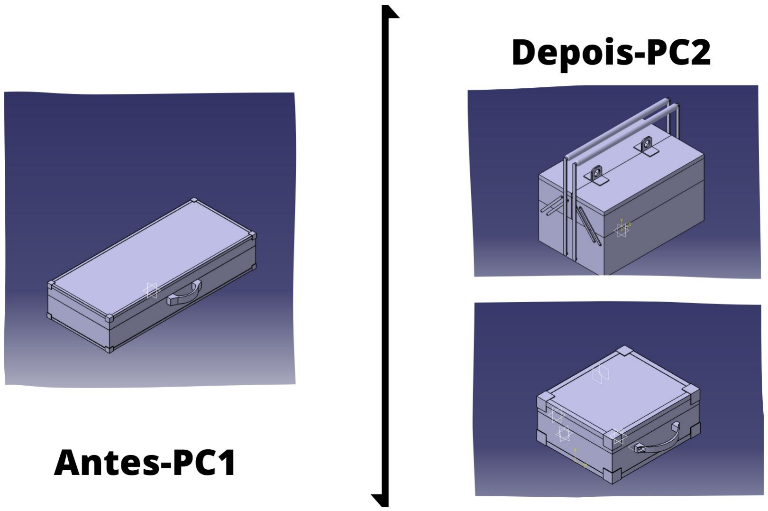
[picture p234: figure]

## Título Material das maletas

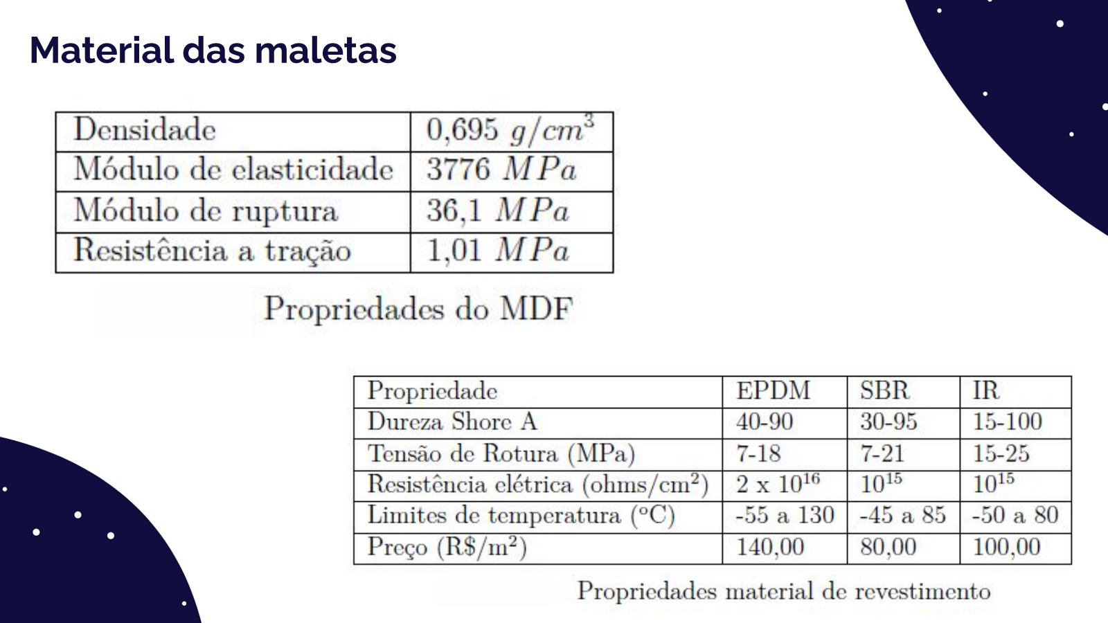
[picture p235: page 40]

## Maleta 01 - GCS

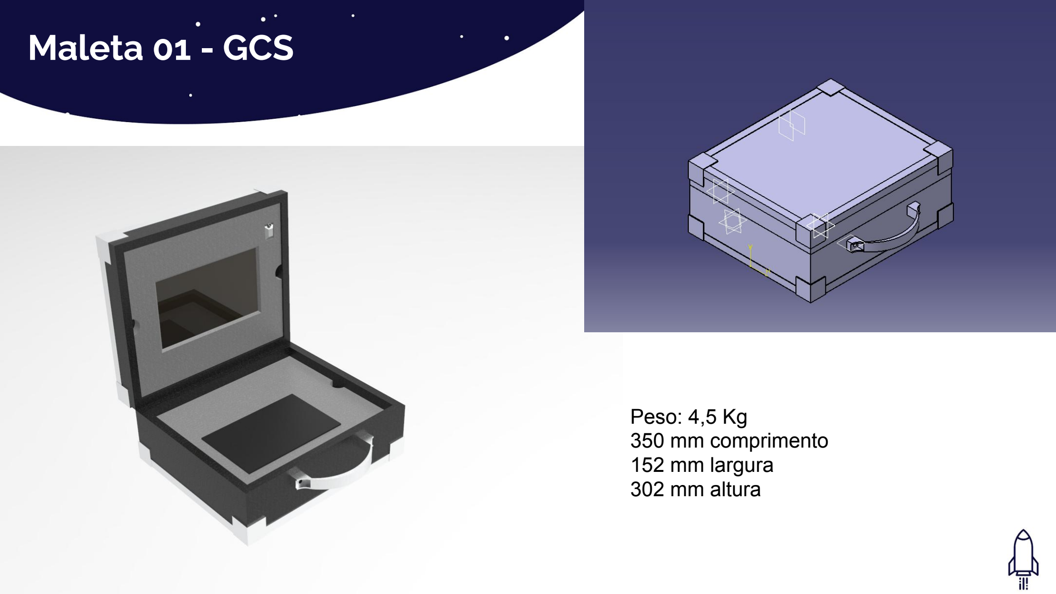
[picture p236: page 41]

Peso: 4,5 Kg
350 mm comprimento
152 mm largura
302 mm altura

## Maleta 02 - Suporte

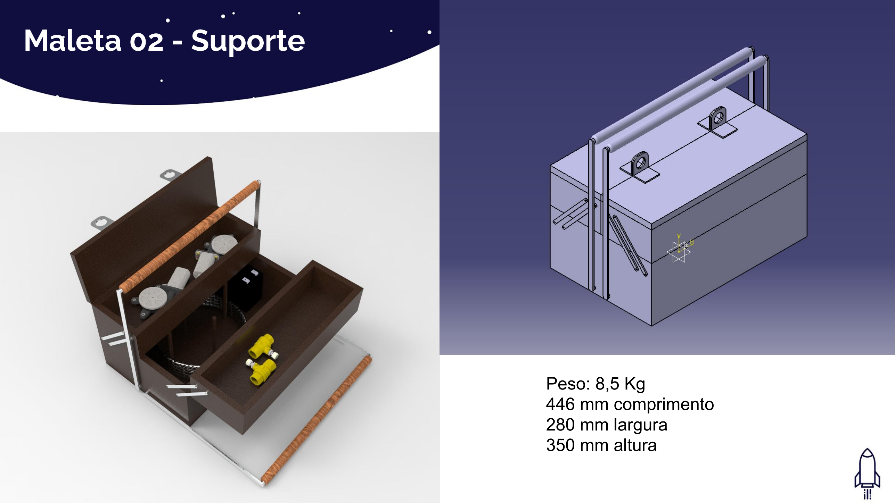
[picture p237: page 42]

Peso: 8,5 Kg
446 mm comprimento
280 mm largura
350 mm altura

## Título Simulação de Impacto

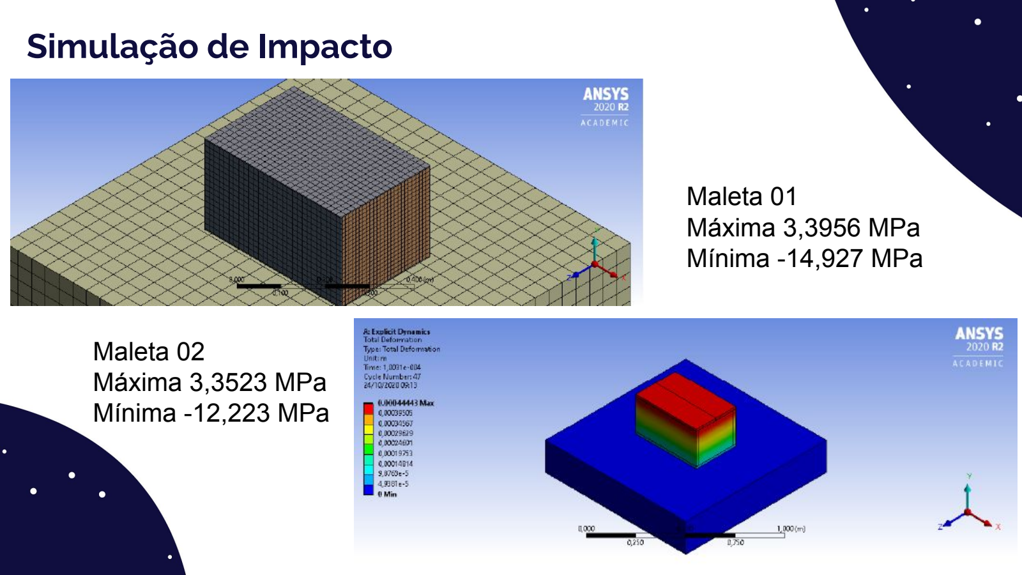
[picture p238: page 43]

Maleta 01
Máxima 3,3956 MPa
Mínima -14,927 MPa

Maleta 02
Máxima 3,3523 MPa
Mínima -12,223 MPa

## Título Abastecimento

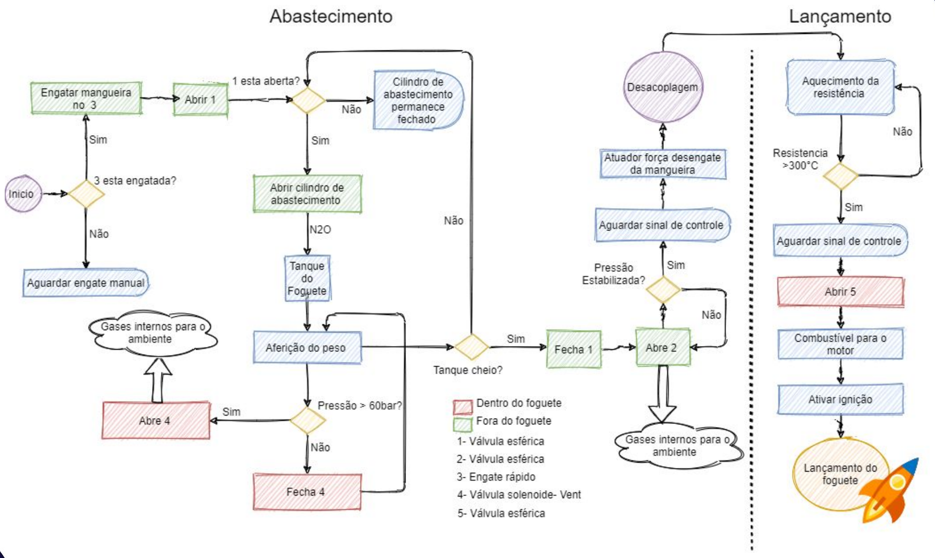
[picture p239: figure]

## Componentes

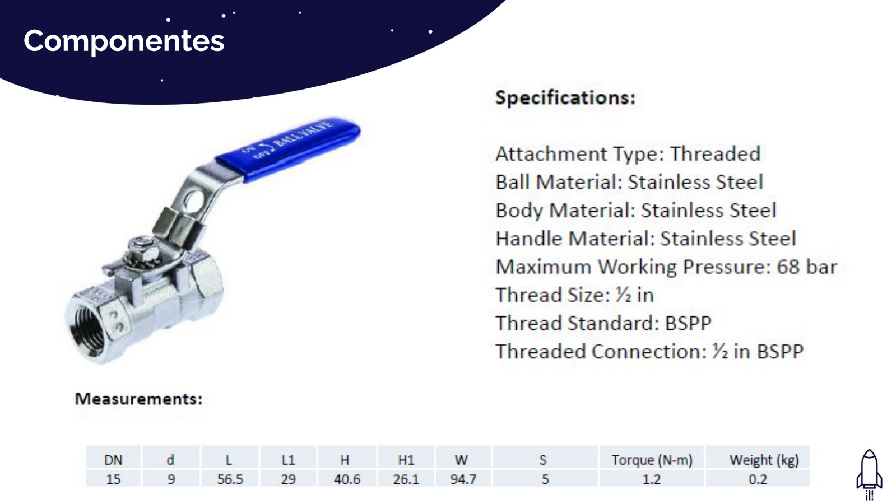
[picture p240: page 45]

## Componentes

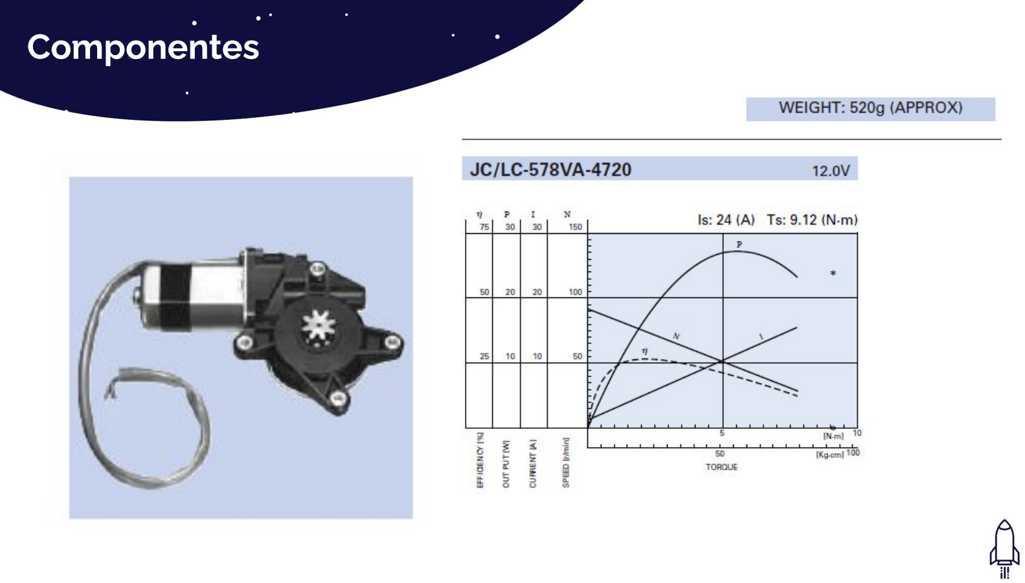
[picture p241: page 46]

## Diagrama eletromecânico

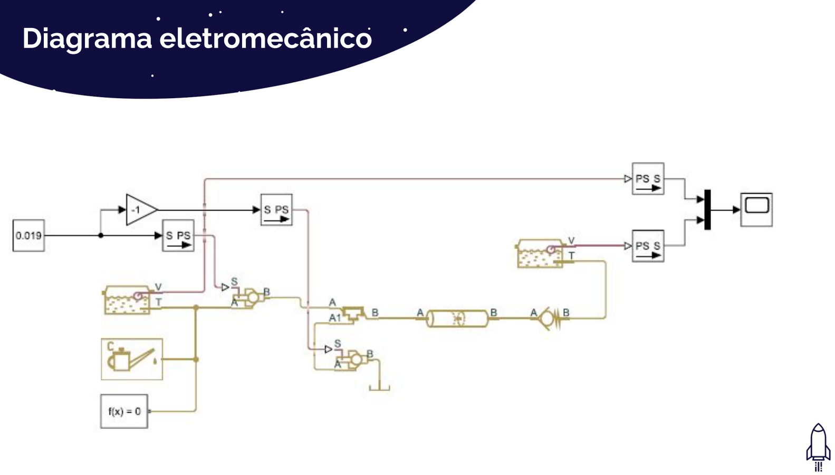
[picture p242: page 47]

## Próximos passos

- Validar sistema integrado;
- Plano de construção detalhado;
- Confecção do manual de uso e manutenção;
- Simulação do torque sobre a válvula no sistema hidráulico;

# Obrigado!
