Ground-Station/Documentation/reports/PI2_PC1_fogueteiros/editaveis/informacoes.tex

% Dados pessoais
\autor{Artur Almeida, 
André Bargas, 
Augusto Vilarins, 
Diogo Sens, 
Douglas Brandão, 
Francisco Matheus,
Gabriela Alves,
Gustavo Linhares,
Isaque Alves,
João Egewarth,
Luísa Prospero, 
Milena Martins, 
Misael Andrade e
Thainá Rodrigues.}

\curso{Projeto Integrador de Engenharia 2}

% Dados do trabalho
\titulo{Rocket Guide Station: \\ Estação de monitoramento e controle de lançamento de foguetes}
\data{2020}
\palavraChaveUm{Palavra-chave01}
\palavraChaveDois{Palavra-chave02}

% Dados da orientacao
\orientador{Alex Reis, 
José Felício, 
Rhander Viana
Ricardo Matos Chaim e 
Paolo Gessini.}
%\coorientador{quando houver, Titulação Acadêmica e Nome do Orientador}

% Dados para a ficha catalográfica
\cdu{02:141:005.6}

% Dados da aprovação do trabalho
\dataDaAprovacao{01 de junho de 2013 -- Data da aprovação do trabalho}
\membroConvidadoUm{Titulação e Nome do Professor Convidado 01}
\membroConvidadoDois{Titulação e Nome do Professor Convidado 02}
