Ground-Station/Documentation/reports/PI2_PC1_fogueteiros/fixos/informacoes.tex

\local{Brasília, DF}
\instituicao{%
  Universidade de Brasília -- UnB
  \par
  Faculdade UnB Gama -- FGA
}
\tipotrabalho{Trabalho de Conclusão de Curso}
\preambulo{Trabalho submetido à disciplina de 
\imprimircurso\ 
referente ao \textbf{Ponto de Controle 1},
na Universidade de Brasília.}
