Ground-Station/Documentation/reports/PI2_PC1_fogueteiros/editaveis/solucao/solucao.tex

\chapter{Concepção e Detalhamento da Solução}

\begin{figure}[H]
    \centering
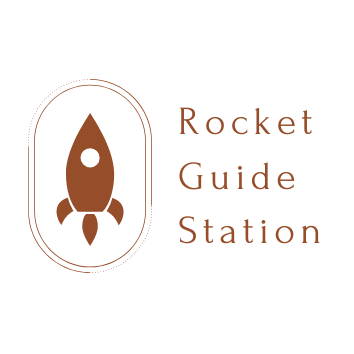
[picture p245: reports/PI2_PC1_fogueteiros/figuras/rgs_35.png]
    
\end{figure}

\section{Solução Geral}
\par A solução proposta é o projeto de uma estação de controle e monitoramento do lançamento de um foguete experimental movido a propulsão híbrida. Por meio de sensores e atuadores, a estação realizará o abastecimento e a ignição remota do foguete e, durante o voo, a coleta da telemetria deste.

\input{editaveis/solucao/eletronica/eletronica.tex}
\input{editaveis/solucao/energia/energia.tex}
\input{editaveis/solucao/estrutura/estrutura.tex}
\input{editaveis/solucao/software/software.tex}
