Ground-Station/Documentation/reports/PI2_PC1_fogueteiros/editaveis/TAP/TAP.tex

\chapter{TERMO DE ABERTURA DO PROJETO}
\section{Introdução}
O lançamento de um foguete experimental de propulsão híbrida exige procedimentos de preparo e abastecimento que devem ser executados à distância da base de lançamento. Do mesmo modo, é recomendável fazer a coleta dos dados do foguete (em particular sua localização e altitude) durante o voo. O uso de uma estação de controle e monitoramento remoto faz-se necessário.

\section{Justificativa do Projeto}
A \textit{Rocket Guide Station} (RGS) é uma estação remota capaz de realizar a abertura e fechamento das válvulas que compõem o sistema de alimentação utilizado pela \textit{Capital Rocket Team}, cliente da equipe, bem como de executar a ignição do foguete no momento de seu lançamento. Além disso, é capaz de receber os dados de telemetria do foguete durante o voo. O uso dessa estação não somente otimizará o trabalho do cliente na execução dessas tarefas acessórias a uma missão de lançamento, como também poupará eles de terem de desenvolver uma estação por conta própria, possibilitando que eles se dediquem à sua função principal, que é o desenvolvimento do foguete em si.

\input{editaveis/TAP/Stakeholders/Stakeholders.tex}
\input{editaveis/TAP/MatrizSWOT/MatrizSWOT.tex}
\input{editaveis/TAP/5w1h/5w1h.tex}
\input{editaveis/TAP/CANVAS/CANVAS.tex}
\input{editaveis/TAP/EAP/EAP.tex}
\input{editaveis/TAP/Cronograma/cronograma.tex}
\input{editaveis/TAP/RecursosHumanos/RecursosHumanos.tex}
\input{editaveis/TAP/PlanejamentoRiscos/planejamentoRiscos.tex}
\input{editaveis/TAP/EstimativadeCustos/estimativadecustos.tex}
