Ground-Station/Documentation/reports/PI2_PC2_fogueteiros/editaveis/alteracoes/alteracoes.tex

\chapter[Registro de alterações]{Registro de alterações}
\label{alteracoes}

\begin{table}[H]
\centering
\begin{tabular}{|l|l|}
\hline
\textbf{Tópico de Referência} & \textbf{Descrição da Alterção} \\ \hline
Seção \ref{problema_solucao_antiga} & \begin{tabular}[c]{@{}l@{}}Estudo sobre as dificuldades de aplicar Aprendizado de Máquina \\ no projeto.\end{tabular} \\ \hline
Seção \ref{Peso_do_Foguete} &  \begin{tabular}[c]{@{}l@{}}Adição de mais uma célula de carga para medição do peso do \\   foguete.\end{tabular}\\ \hline

 &  \\ \hline
\end{tabular}
\caption{Lista de alterações significativas do projeto.}
\label{alteracoes}
\end{table}
