Ground-Station/Documentation/reports/PI2_PC2_fogueteiros/editaveis/geral/apendices.tex

\begin{apendicesenv}

\partapendices

\chapter{Diagrama de Sequencias}
\label{diagrama_sequencia}
\begin{figure}[htb]
    \centering
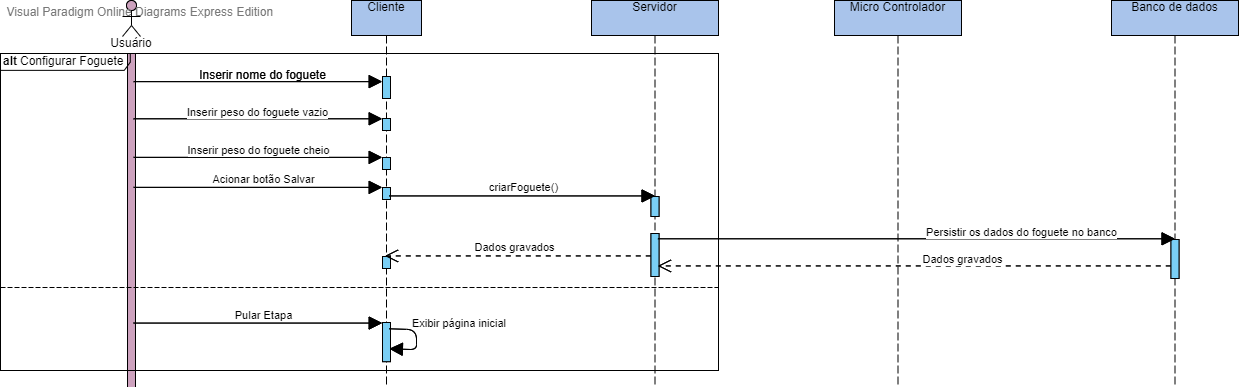
[picture p246: reports/PI2_PC2_fogueteiros/figuras/diagrama_sequencia_cadastro_foguete.png]
    
    \caption{Diagrama de sequencia representando o cadastro de foguetes. Fonte: Autor}
    \label{fig:Diagrama_sequencia_cadastr_foguete}
\end{figure}

\begin{figure}[htb]
    \centering
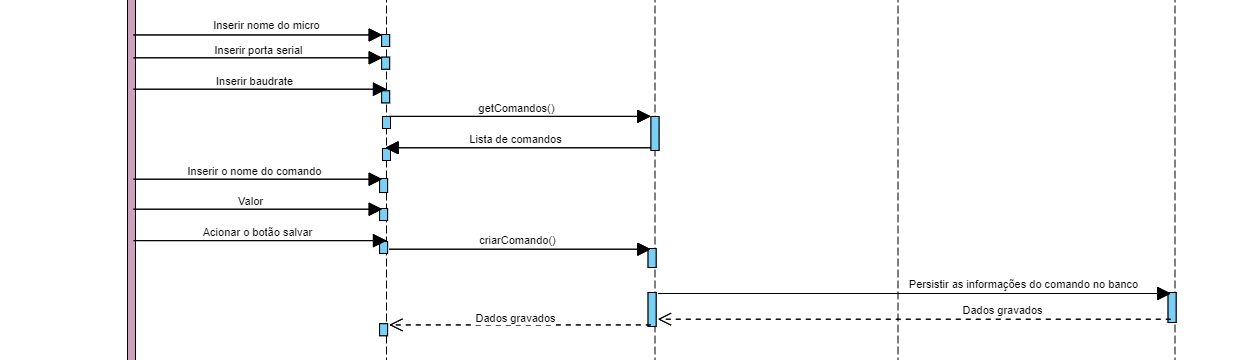
[picture p247: reports/PI2_PC3_fogueteiros/figuras/diagrama_sequencia_cadastro_micro.png]
    
    \caption{Diagrama de sequencia representando o cadastro de micro. Fonte: Autor}
    \label{fig:Diagrama_sequencia_cadastro_micro}
\end{figure}

\begin{figure}[htb]
    \centering
    
    \caption{Diagrama de sequencia representando o processo da missão. Fonte: Autor}
    \label{fig:Diagrama_sequencia_missao}
\end{figure}

\begin{figure}[htb]
    \centering
    
    \caption{Diagrama de sequencia representando o processo de abastecimento. Fonte: Autor}
    \label{fig:Diagrama_sequencia_abastecimento}
\end{figure}

\begin{figure}[htb]
    \centering
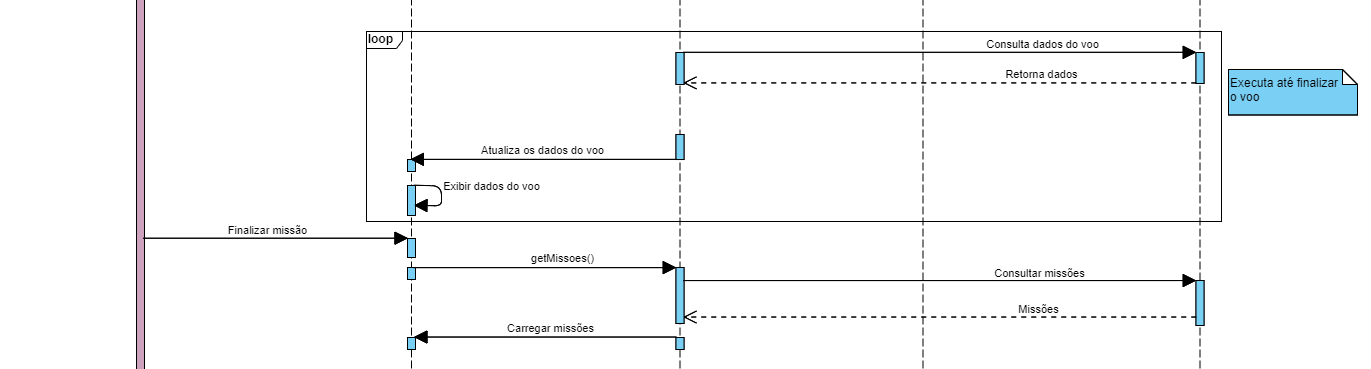
[picture p248: reports/PI2_PC3_fogueteiros/figuras/diagrama_sequencia_finaliza_missao.png]
    
    \caption{Diagrama de sequencia representando o processo de finalizar a missão. Fonte: Autor}
    \label{fig:Diagrama_sequencia_finaliza_missao}
\end{figure}

\begin{figure}[htb]
    \centering
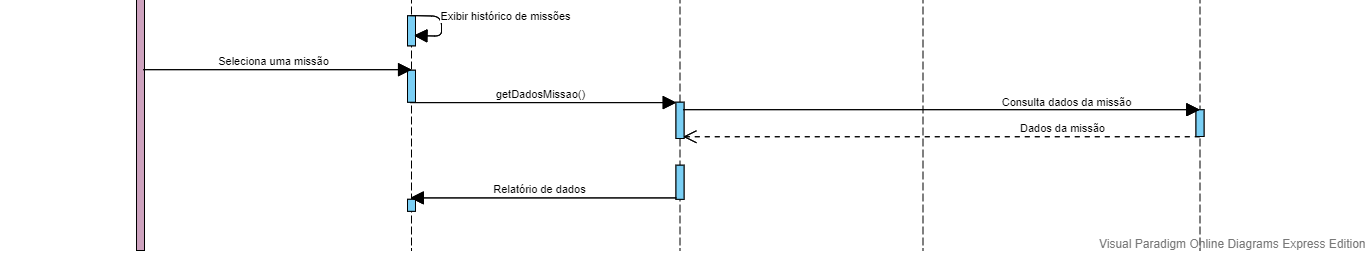
[picture p249: reports/PI2_PC3_fogueteiros/figuras/diagrama_sequencia_historico.png]
    
    \caption{Diagrama de sequencia representando o processo de histórico. Fonte: Autor}
    \label{fig:Diagrama_sequencia_historico}
\end{figure}

\chapter{Diagrama de blocos do sistema Versão Inicial}
\label{Diagrama de blocos do sistema}
\begin{figure}[htb]
    \centering
    
    \caption{Diagrama de blocos do projeto. Fonte: Autor}
    \label{fig:Diagrama de Blocos}
\end{figure}

%\chapter{Diagrama de Blocos/Comunicação}
%\label{Diagrama_Geral}
%\begin{figure}[htb]
 %   \centering
 %   \includegraphics[width=1.1\textwidth, angle=90]{figuras/Diagrama_Geral.png}
  %  \caption{Diagrama de comunicação do projeto. Fonte: Autor}
  %  \url{https://drive.google.com/file/d/12-pXv5L2Z5AuyWWVIr8VZ4WMghu7SYDw/view?usp=sharing}
  %  \label{fig:Diagrama_Geral}
%\end{figure}

\chapter{Diagramas elétricos}
\label{diag_eletrico}

\begin{figure}[H]
    \centering
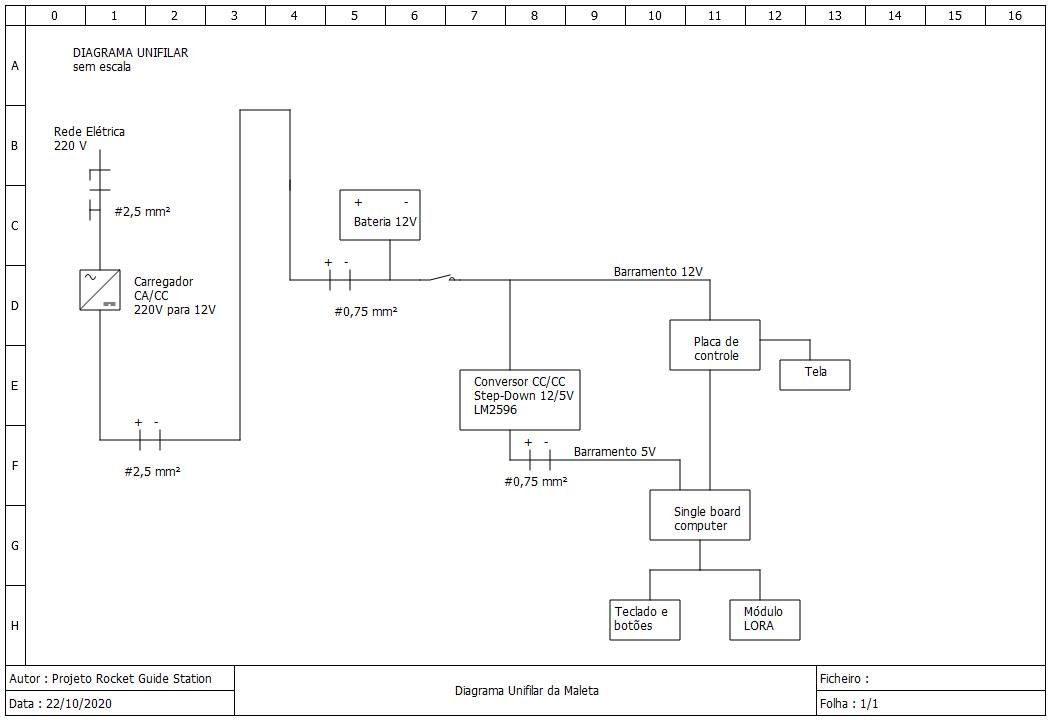
[picture p250: reports/PI2_PC3_fogueteiros/figuras/diamalgcs.jpeg]
    
    \caption{Diagrama unifilar GCS}
    \label{fig:diagrama_unifilar_01}
\end{figure}

\begin{figure}[H]
    \centering
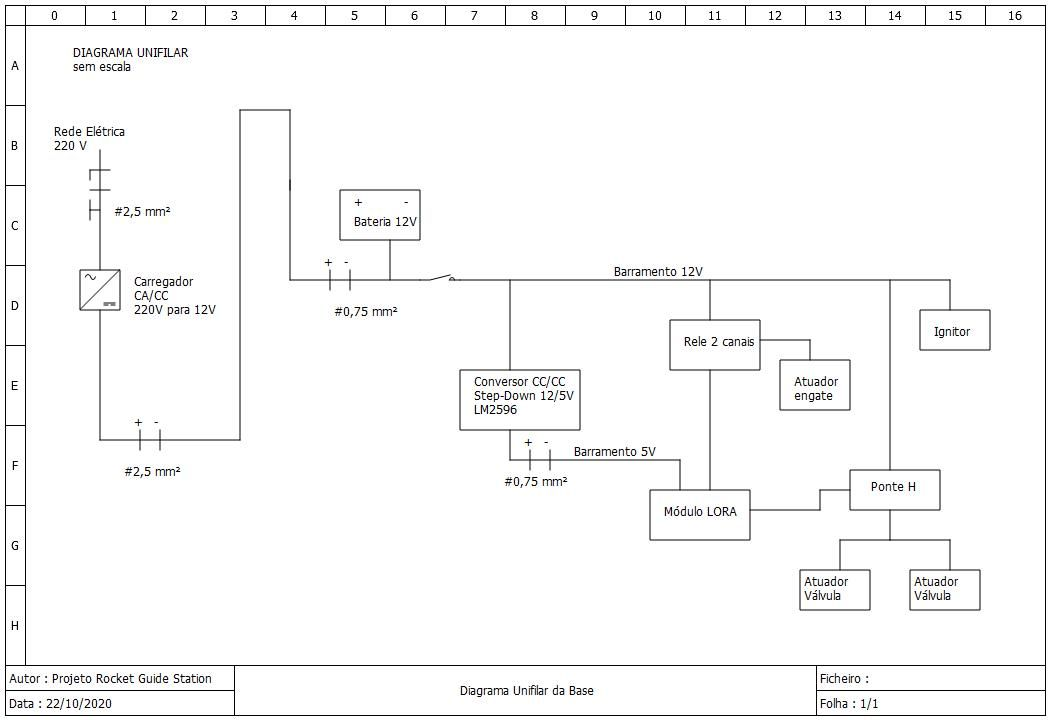
[picture p251: reports/PI2_PC3_fogueteiros/figuras/diamalsup.jpeg]
    
    \caption{Diagrama unifilar abastecimento}
    \label{fig:diagrama_unifilar_02}
\end{figure}

\includepdf[pages=-, angle=270]{figuras/circuitoeletrico.pdf}

\chapter{Esboço inicial e CAD}
\label{CAD}

\begin{figure}[htb]
    \centering
    
    \caption{Esboço inicial}
    \label{fig:esboço}
\end{figure}

\begin{figure} [H]
\centering
  \subfigure[aberto]{
    
  } 
  \subfigure[fechado]{ 
    
  } 
  \caption{CAD da maleta verso}
\end{figure}

\begin{figure} [H]
\centering
  \subfigure[aberto]{
    
  } 
  \subfigure[fechado]{ 
    
  } 
  \caption{CAD's da maleta frente}
\end{figure}

\begin{figure} [H]
\centering
  \subfigure[aberto]{
    
  } 
  \subfigure[fechado]{ 
    
  } 
  \caption{CAD's da maleta lateral}
\end{figure}

\begin{figure} [H]
\centering
  \subfigure[aberto]{
    
  } 
  \subfigure[fechado]{ 
    
  } 
  \caption{CAD's da maleta superior}
\end{figure}

\begin{figure} [H]
\centering
  \subfigure[aberto]{
    
  } 
  \subfigure[fechada]{ 
    
  } 
  \caption{CAD's da maleta isométrica}
\end{figure}

\chapter{Desenhos Técnicos}
\label{Drafts_do_projeto}

%\section{GCS}

\includepdf[pages=-,angle=270]{figuras/PDFs/M2-1.pdf}
\label{GCS}

\includepdf[pages=-]{figuras/PDFs/M2-2.pdf}
\label{GCS1}

%\section{MaletaAbastecimento}

\includepdf[pages=-,angle=270]{figuras/PDFs/M3-1.pdf}
\label{MAbastecimento}

\includepdf[pages=-]{figuras/PDFs/M3-2.pdf}
\label{MAbastecimento1}

\chapter{Simulação de Impacto}
\label{simulacoes_impacto}

\begin{figure}[htb]
    \centering
    
    \caption{Tensão normal no eixo Y da maleta do sistema de alimentação em queda direta}
    \label{fig:simulacaoImpacto_01}
\end{figure}

\begin{figure}[htb]
    \centering
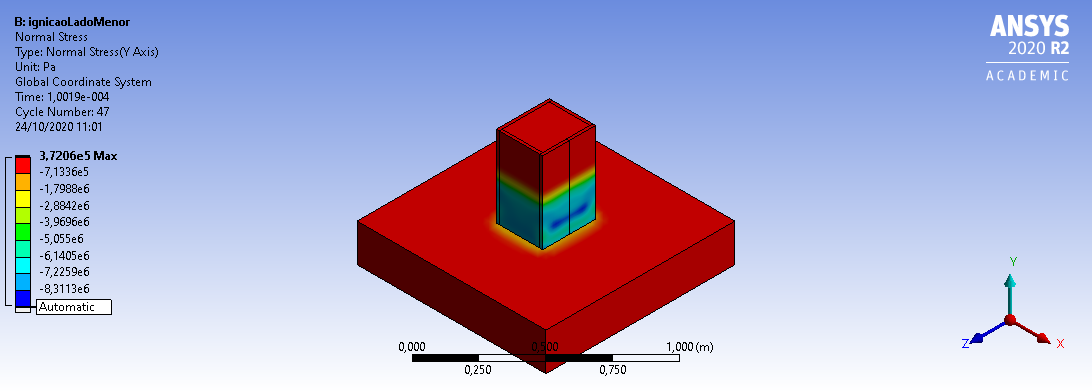
[picture p252: reports/PI2_PC2_fogueteiros/figuras/estrutura_simulacaoImpacto/ignicaoNormalYLadoMenor.png]
    
    \caption{Tensão normal no eixo Y da maleta do sistema de alimentação em queda lateral}
    \label{fig:simulacaoImpacto_02}
\end{figure}

\begin{figure}[htb]
    \centering
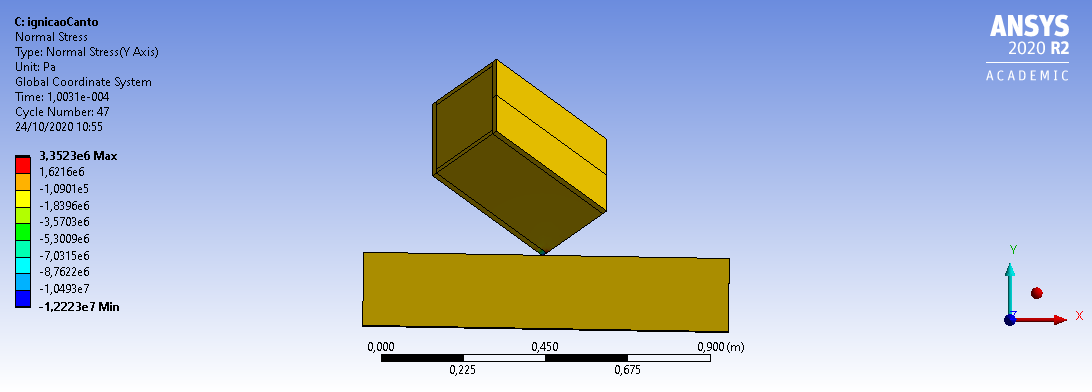
[picture p253: reports/PI2_PC2_fogueteiros/figuras/estrutura_simulacaoImpacto/ignicaoNormalYCanto.png]
    
    \caption{Tensão normal no eixo Y da maleta do sistema de alimentação em queda inclinada}
    \label{fig:simulacaoImpacto_03}
\end{figure}

\begin{figure}[htb]
    \centering
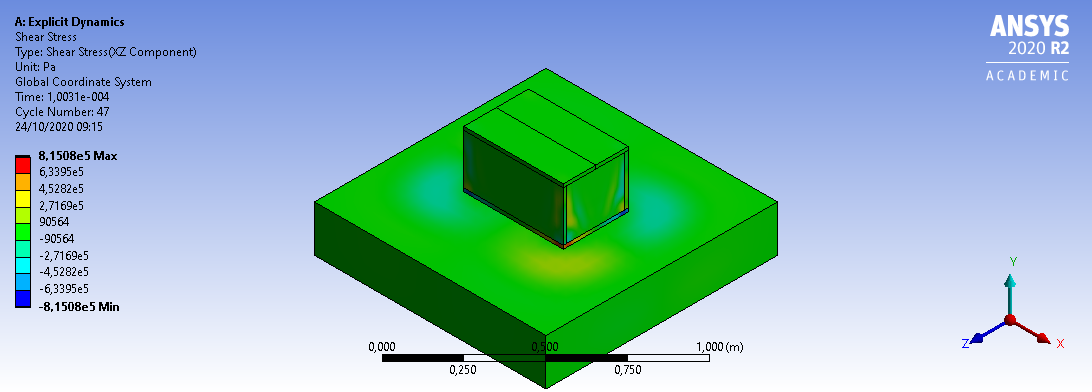
[picture p254: reports/PI2_PC2_fogueteiros/figuras/estrutura_simulacaoImpacto/ignicaoCisalhamentoXZLadoMaior.png]
    
    \caption{Tensão de Cisalhamento no plano XZ da maleta do sistema de alimentação em queda direta}
    \label{fig:simulacaoImpacto_04}
\end{figure}

\begin{figure}[htb]
    \centering
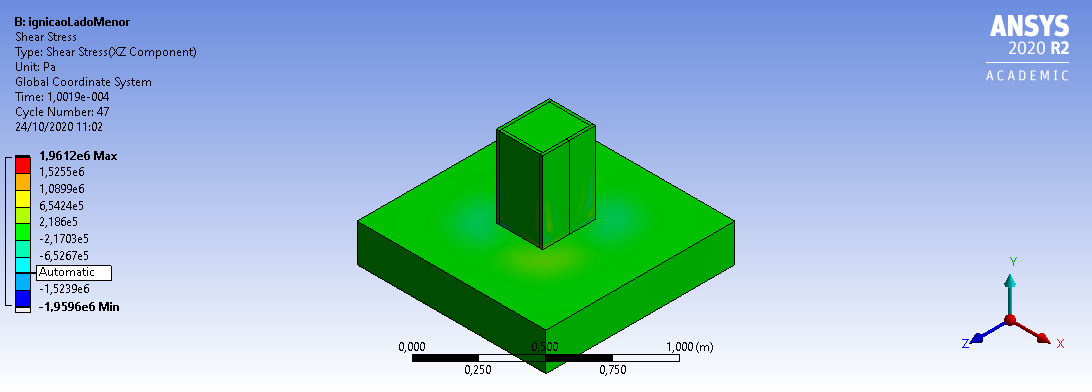
[picture p255: reports/PI2_PC2_fogueteiros/figuras/estrutura_simulacaoImpacto/ignicaoCisalhamentoXZLadoMenor.png]
    
    \caption{Tensão de Cisalhamento no plano XZ da maleta do sistema de alimentação em queda lateral}
    \label{fig:simulacaoImpacto_05}
\end{figure}

\begin{figure}[htb]
    \centering
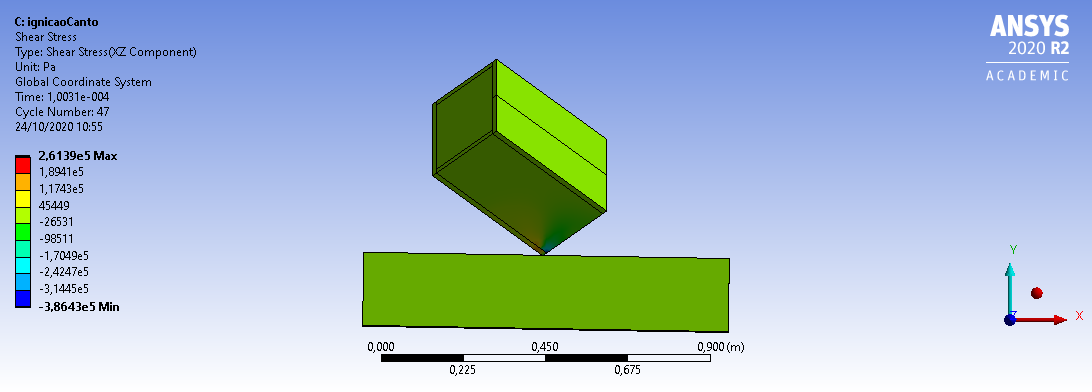
[picture p256: reports/PI2_PC2_fogueteiros/figuras/estrutura_simulacaoImpacto/ignicaoCisalhamentoXZCanto.png]
    
    \caption{Tensão de Cisalhamento no plano XZ da maleta do sistema de alimentação em queda inclinada}
    \label{fig:simulacaoImpacto_06}
\end{figure}

\begin{figure}[htb]
    \centering
    
    \caption{Deformação da maleta do sistema de alimentação em queda direta}
    \label{fig:simulacaoImpacto_07}
\end{figure}

\begin{figure}[htb]
    \centering
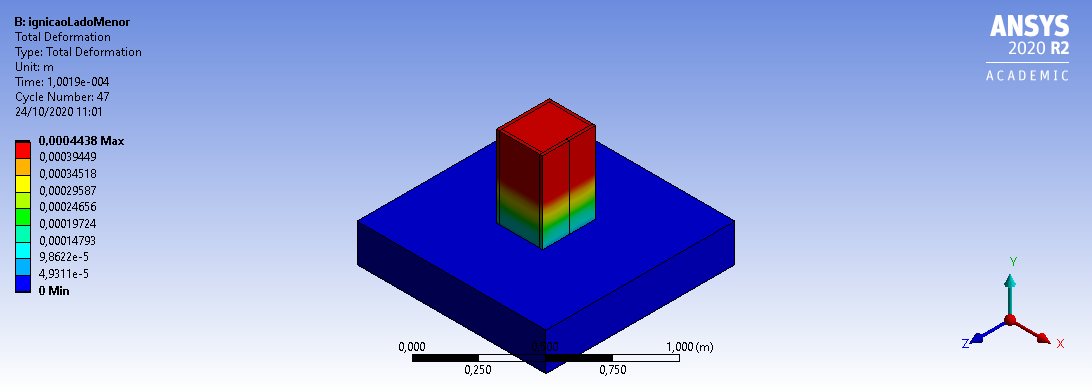
[picture p257: reports/PI2_PC2_fogueteiros/figuras/estrutura_simulacaoImpacto/ignicaoDeformacaoLadoMenor.png]
    
    \caption{Deformação da maleta do sistema de alimentação em queda lateral}
    \label{fig:simulacaoImpacto_08}
\end{figure}

\begin{figure}[htb]
    \centering
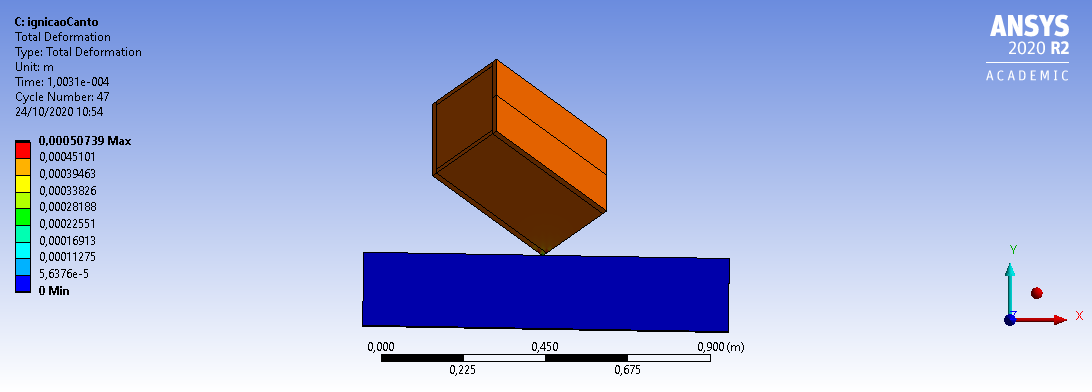
[picture p258: reports/PI2_PC2_fogueteiros/figuras/estrutura_simulacaoImpacto/ignicaoDeformacaoCanto.png]
    
    \caption{Deformação da maleta do sistema de alimentação em queda inclinada}
    \label{fig:simulacaoImpacto_09}
\end{figure}

\begin{figure}[htb]
    \centering
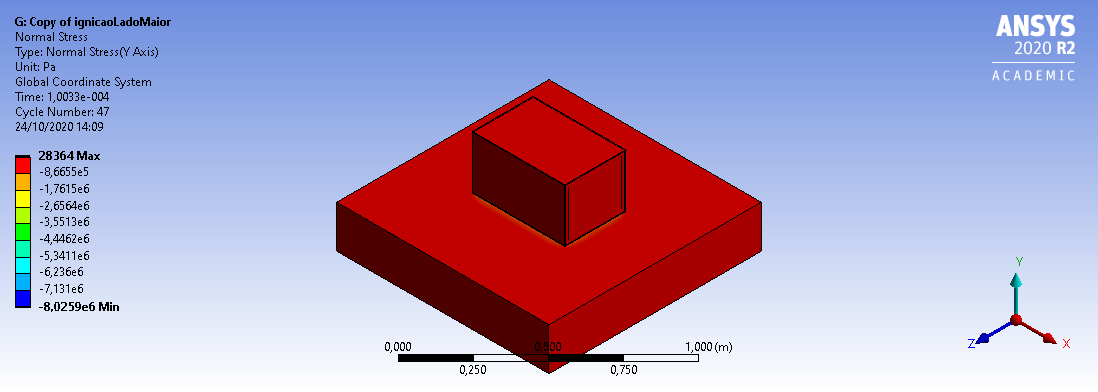
[picture p259: reports/PI2_PC3_fogueteiros/figuras/estrutura_simulacaoImpacto/ignicaoRevestidaNormalYMaior.png]
    
    \caption{Tensão normal no eixo Y da maleta do sistema de alimentação revestida em queda direta}
    \label{fig:simulacaoImpacto_10}
\end{figure}

\begin{figure}[htb]
    \centering
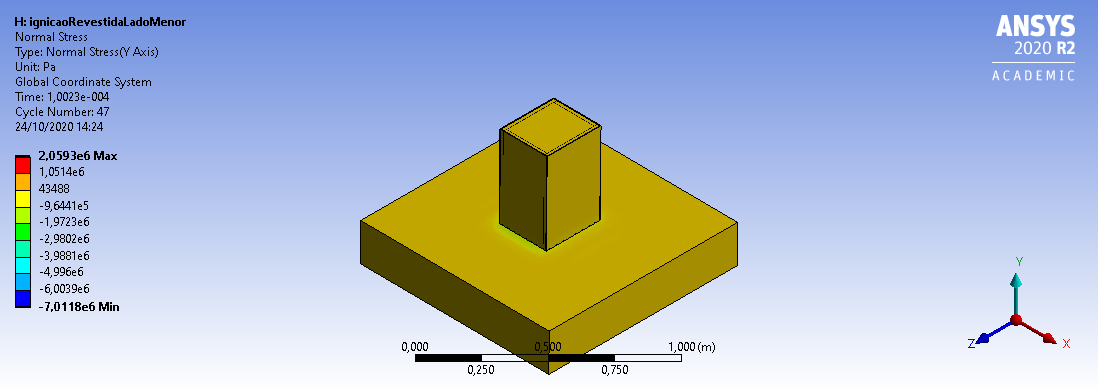
[picture p260: reports/PI2_PC2_fogueteiros/figuras/estrutura_simulacaoImpacto/ignicaoRevestidaNormalYMenor.png]
    
    \caption{Tensão normal no eixo Y da maleta do sistema de alimentação revestida em queda lateral}
    \label{fig:simulacaoImpacto_11}
\end{figure}

\begin{figure}[htb]
    \centering
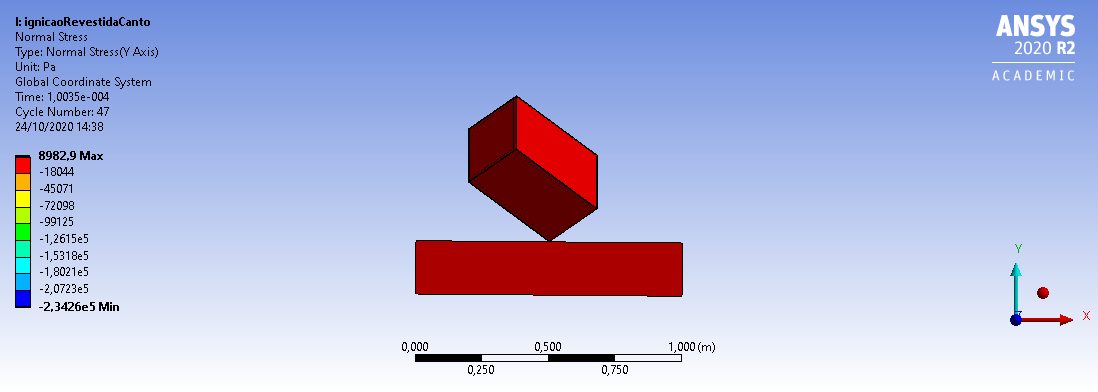
[picture p261: reports/PI2_PC3_fogueteiros/figuras/estrutura_simulacaoImpacto/ignicaoRevestidaNormalYCanto.png]
    
    \caption{Tensão normal no eixo Y da maleta do sistema de alimentação revestida em queda inclinada}
    \label{fig:simulacaoImpacto_12}
\end{figure}

\begin{figure}[htb]
    \centering
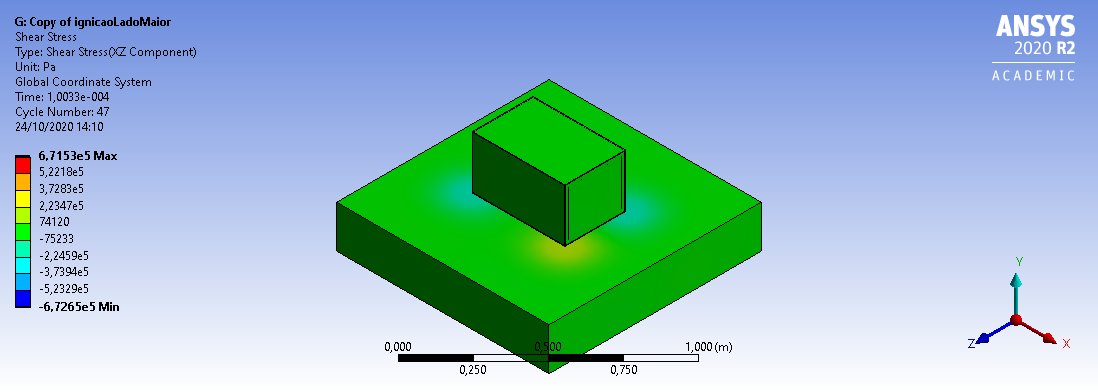
[picture p262: reports/PI2_PC2_fogueteiros/figuras/estrutura_simulacaoImpacto/ignicaoRevestidaCisalhamentoXZMaior.png]
    
    \caption{Tensão de cisalhamento no plano XZ da maleta do sistema de alimentação revestida em queda direta}
    \label{fig:simulacaoImpacto_13}
\end{figure}

\begin{figure}[htb]
    \centering
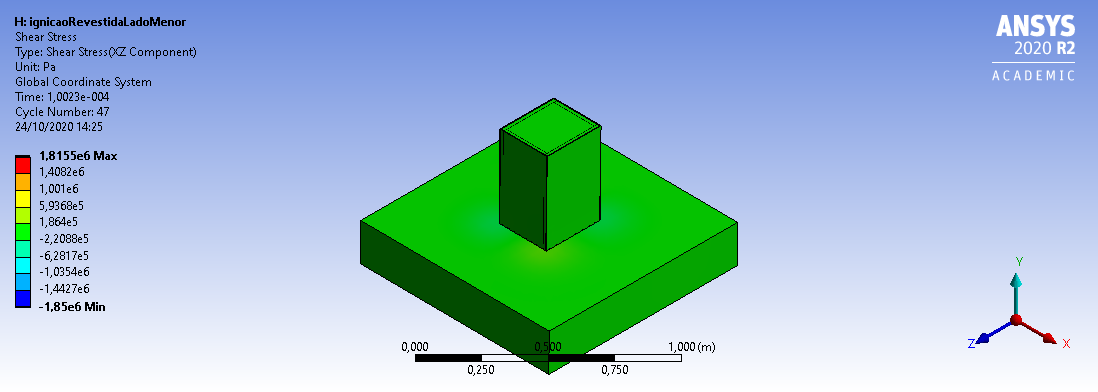
[picture p263: reports/PI2_PC2_fogueteiros/figuras/estrutura_simulacaoImpacto/ignicaoRevestidaCisalhamentoXZMenor.png]
    
    \caption{Tensão de cisalhamento no plano XZ da maleta do sistema de alimentação revestida em queda lateral}
    \label{fig:simulacaoImpacto_14}
\end{figure}

\begin{figure}[htb]
    \centering
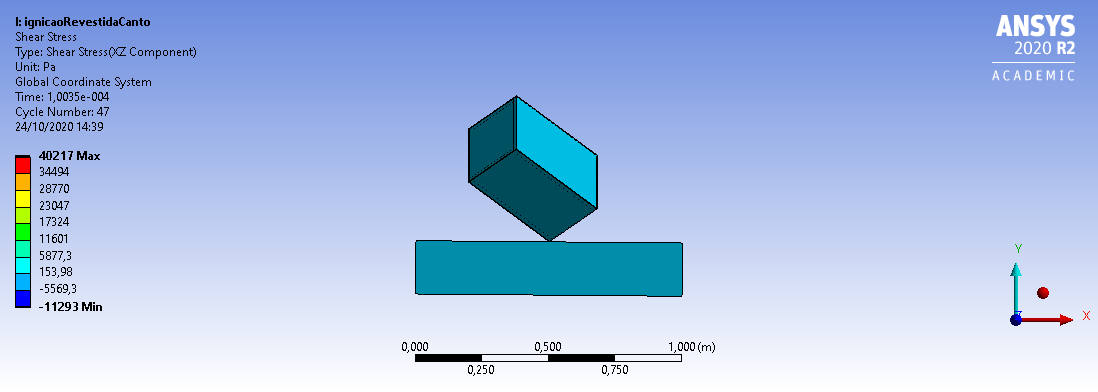
[picture p264: reports/PI2_PC2_fogueteiros/figuras/estrutura_simulacaoImpacto/ignicaoRevestidaCisalhamentoXZCanto.png]
    
    \caption{Tensão de cisalhamento no plano XZ da maleta do sistema de alimentação revestida em queda inclinada}
    \label{fig:simulacaoImpacto_15}
\end{figure}

\begin{figure}[htb]
    \centering
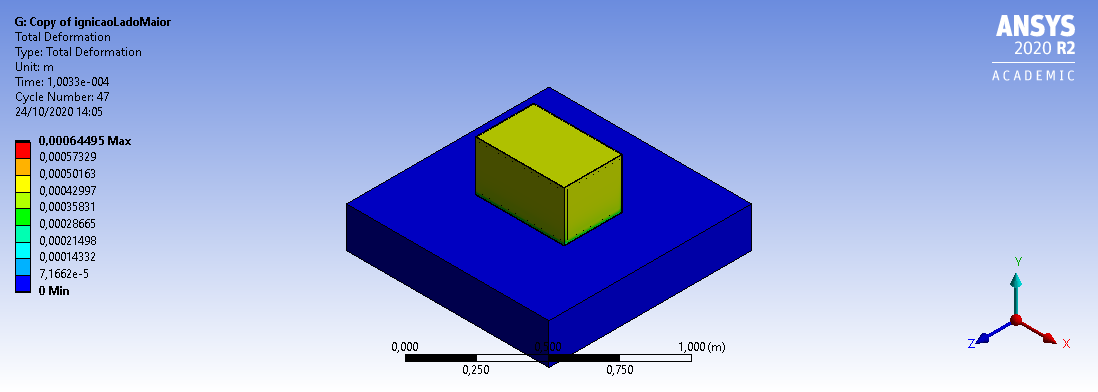
[picture p265: reports/PI2_PC2_fogueteiros/figuras/estrutura_simulacaoImpacto/ignicaoRevestidaDeformacaoMaior.png]
    
    \caption{Deformação da maleta do sistema de alimentação revestida em queda direta}
    \label{fig:simulacaoImpacto_16}
\end{figure}

\begin{figure}[htb]
    \centering
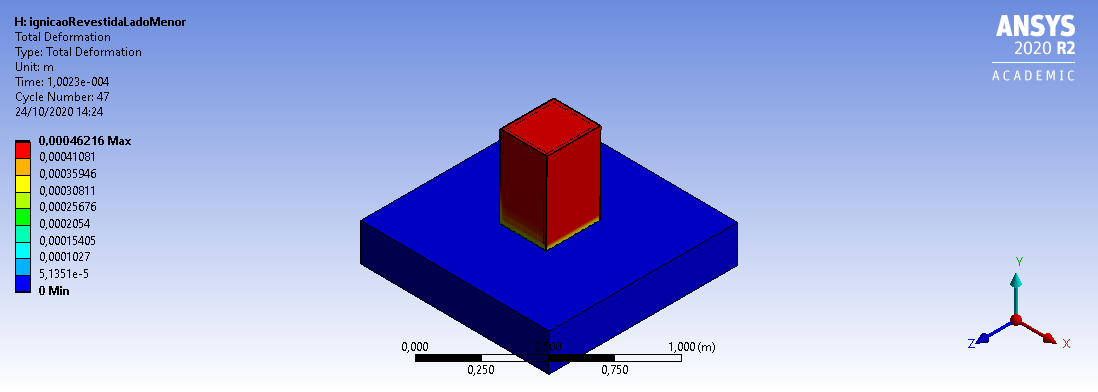
[picture p266: reports/PI2_PC3_fogueteiros/figuras/estrutura_simulacaoImpacto/ignicaoRevestidaDeformacaoMenor.png]
    
    \caption{Deformação da maleta do sistema de alimentação revestida em queda lateral}
    \label{fig:simulacaoImpacto_17}
\end{figure}

\begin{figure}[htb]
    \centering
    
    \caption{Deformação da maleta do sistema de alimentação revestida em queda inclinada}
    \label{fig:simulacaoImpacto_18}
\end{figure}

\begin{figure}[htb]
    \centering
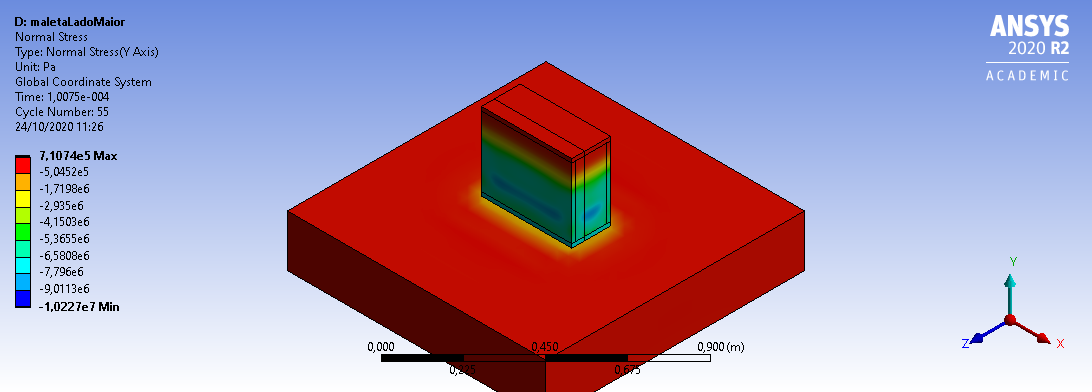
[picture p267: reports/PI2_PC3_fogueteiros/figuras/estrutura_simulacaoImpacto/maletaNormalYMaior.png]
    
    \caption{Tensão normal no eixo Y da maleta do sistema de controle em queda direta}
    \label{fig:simulacaoImpacto_19}
\end{figure}

\begin{figure}[htb]
    \centering
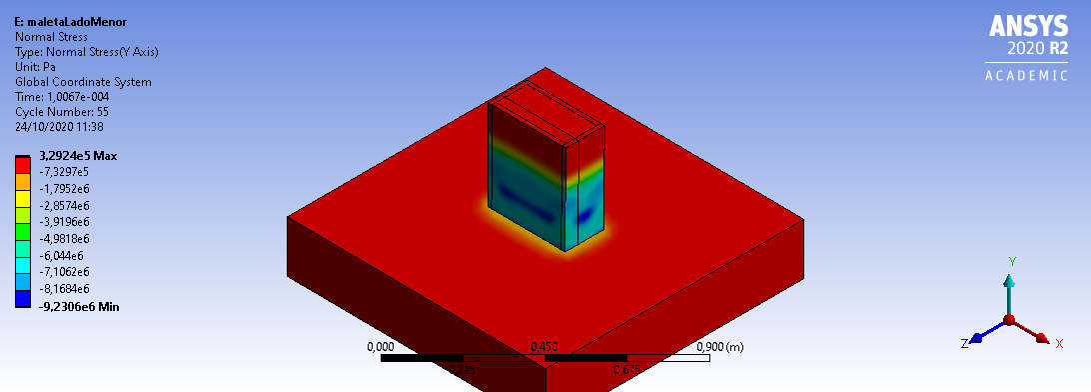
[picture p268: reports/PI2_PC3_fogueteiros/figuras/estrutura_simulacaoImpacto/maletaNormalYMenor.png]
    
    \caption{Tensão normal no eixo Y da maleta do sistema de controle em queda lateral}
    \label{fig:simulacaoImpacto_20}
\end{figure}

\begin{figure}[htb]
    \centering
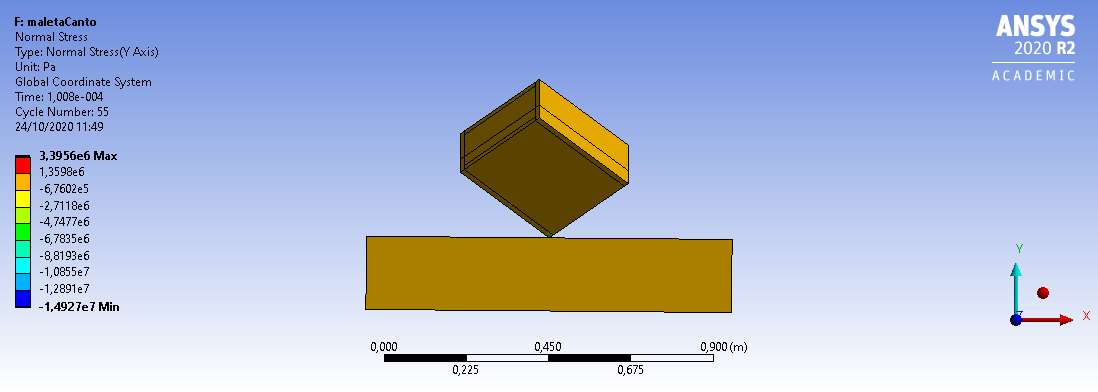
[picture p269: reports/PI2_PC2_fogueteiros/figuras/estrutura_simulacaoImpacto/maletaNormalYCanto.png]
    
    \caption{Tensão normal no eixo Y da maleta do sistema de controle em queda inclinada}
    \label{fig:simulacaoImpacto_21}
\end{figure}

\begin{figure}[htb]
    \centering
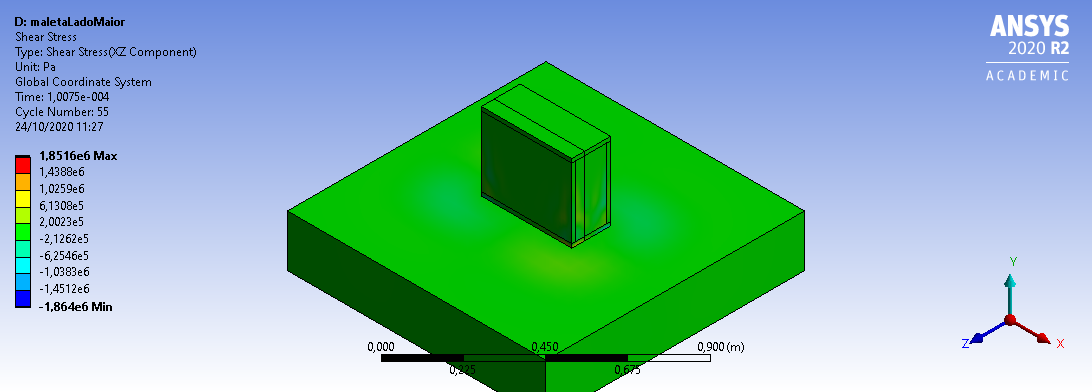
[picture p270: reports/PI2_PC2_fogueteiros/figuras/estrutura_simulacaoImpacto/maletaCisalhamentoXZMaior.png]
    
    \caption{Tensão de cisalhamento no plano XZ da maleta do sistema de controle em queda direta}
    \label{fig:simulacaoImpacto_22}
\end{figure}

\begin{figure}[htb]
    \centering
    
    \caption{Tensão de cisalhamento no plano XZ da maleta do sistema de controle em queda lateral}
    \label{fig:simulacaoImpacto_23}
\end{figure}

\begin{figure}[htb]
    \centering
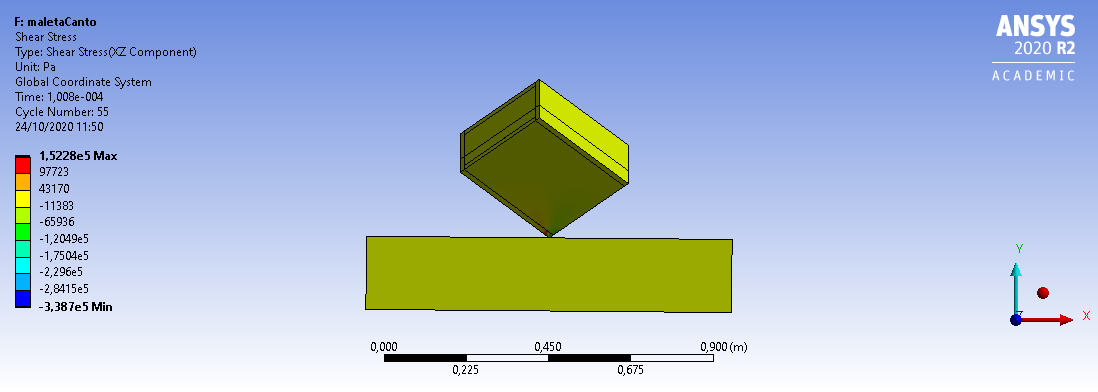
[picture p271: reports/PI2_PC3_fogueteiros/figuras/estrutura_simulacaoImpacto/maletaCisalhamentoXZCanto.png]
    
    \caption{Tensão de cisalhamento no plano XZ da maleta do sistema de controle em queda inclinada}
    \label{fig:simulacaoImpacto_24}
\end{figure}

\begin{figure}[htb]
    \centering
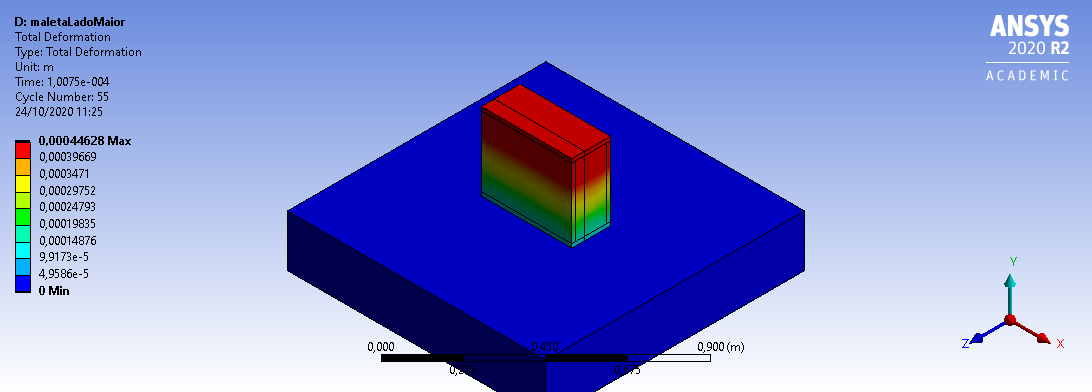
[picture p272: reports/PI2_PC2_fogueteiros/figuras/estrutura_simulacaoImpacto/maletaDeformacaoMaior.png]
    
    \caption{Deformação da maleta do sistema de controle em queda direta}
    \label{fig:simulacaoImpacto_25}
\end{figure}

\begin{figure}[htb]
    \centering
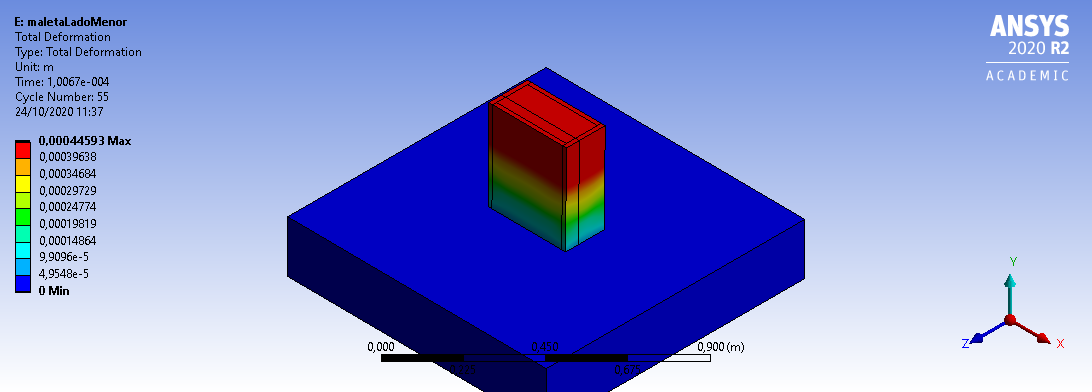
[picture p273: reports/PI2_PC2_fogueteiros/figuras/estrutura_simulacaoImpacto/maletaDeformacaoMenor.png]
    
    \caption{Deformação da maleta do sistema de controle em queda lateral}
    \label{fig:simulacaoImpacto_26}
\end{figure}

\begin{figure}[htb]
    \centering
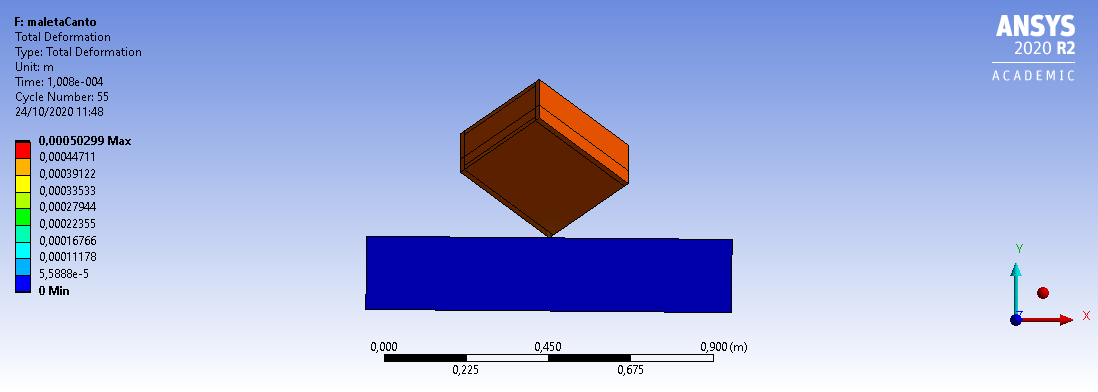
[picture p274: reports/PI2_PC2_fogueteiros/figuras/estrutura_simulacaoImpacto/maletaDeformacaoCanto.png]
    
    \caption{Deformação da maleta do sistema de controle em queda inclinada}
    \label{fig:simulacaoImpacto_27}
\end{figure}

\begin{figure}[htb]
    \centering
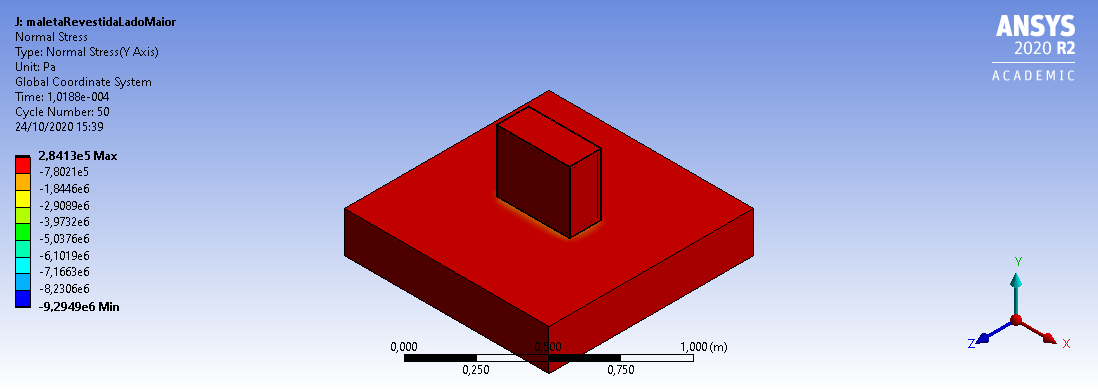
[picture p275: reports/PI2_PC2_fogueteiros/figuras/estrutura_simulacaoImpacto/maletaRevestidaNormalYMaior.png]
    
    \caption{Tensão normal Y da maleta revestida do sistema de controle em queda direta}
    \label{fig:simulacaoImpacto_28}
\end{figure}

\begin{figure}[htb]
    \centering
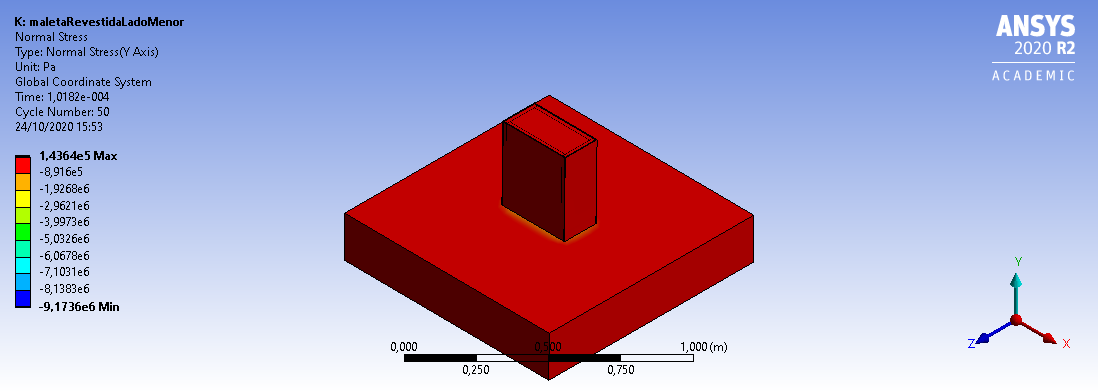
[picture p276: reports/PI2_PC2_fogueteiros/figuras/estrutura_simulacaoImpacto/maletaRevestidaNormalYMenor.png]
    
    \caption{Tensão normal Y da maleta revestida do sistema de controle em queda lateral}
    \label{fig:simulacaoImpacto_29}
\end{figure}

\begin{figure}[htb]
    \centering
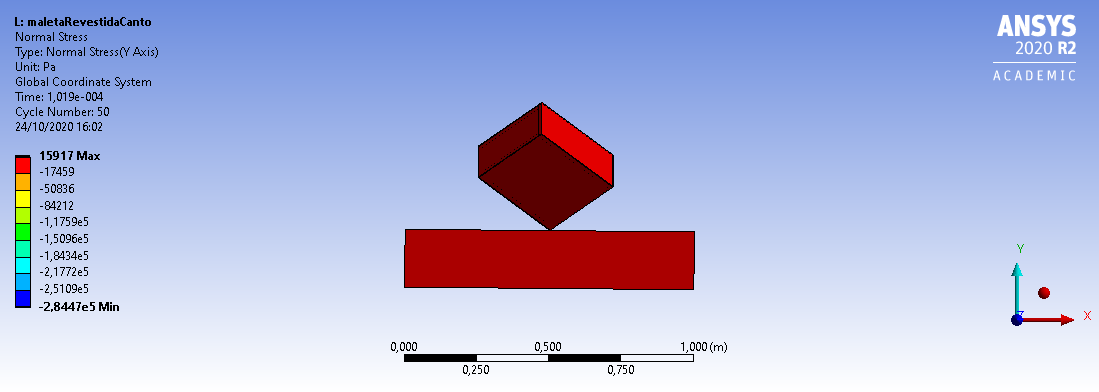
[picture p277: reports/PI2_PC3_fogueteiros/figuras/estrutura_simulacaoImpacto/maletaRevestidaNormalYCanto.png]
    
    \caption{Tensão normal Y da maleta revestida do sistema de controle em queda inclinada}
    \label{fig:simulacaoImpacto_30}
\end{figure}

\begin{figure}[htb]
    \centering
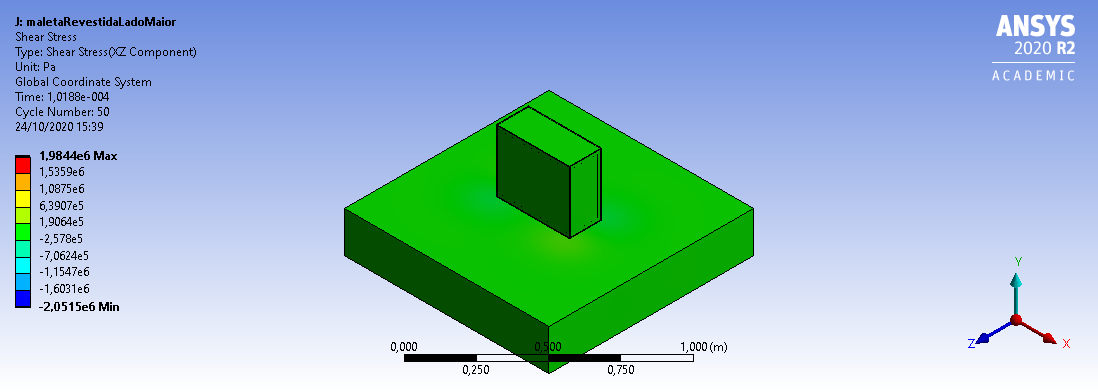
[picture p278: reports/PI2_PC3_fogueteiros/figuras/estrutura_simulacaoImpacto/maletaRevestidaCisalhamentoXZMaior.png]
    
    \caption{Tensão de cisalhamento no plano XZ da maleta revestida do sistema de controle em queda direta}
    \label{fig:simulacaoImpacto_31}
\end{figure}

\begin{figure}[htb]
    \centering
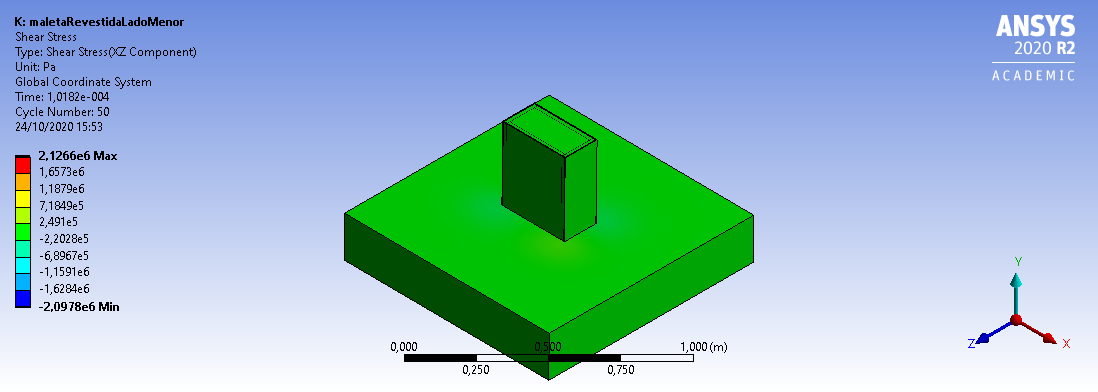
[picture p279: reports/PI2_PC3_fogueteiros/figuras/estrutura_simulacaoImpacto/maletaRevestidaCisalhamentoXZMenor.png]
    
    \caption{Tensão de cisalhamento no plano XZ da maleta revestida do sistema de controle em queda lateral}
    \label{fig:simulacaoImpacto_32}
\end{figure}

\begin{figure}[htb]
    \centering
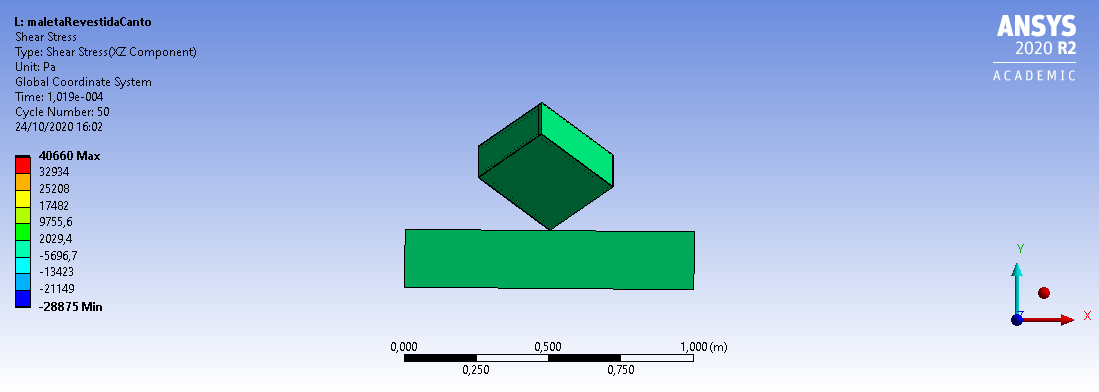
[picture p280: reports/PI2_PC2_fogueteiros/figuras/estrutura_simulacaoImpacto/maletaRevestidaCisalhamentoXZCanto.png]
    
    \caption{Tensão de cisalhamento no plano XZ da maleta revestida do sistema de controle em queda inclinada}
    \label{fig:simulacaoImpacto_33}
\end{figure}

\begin{figure}[htb]
    \centering
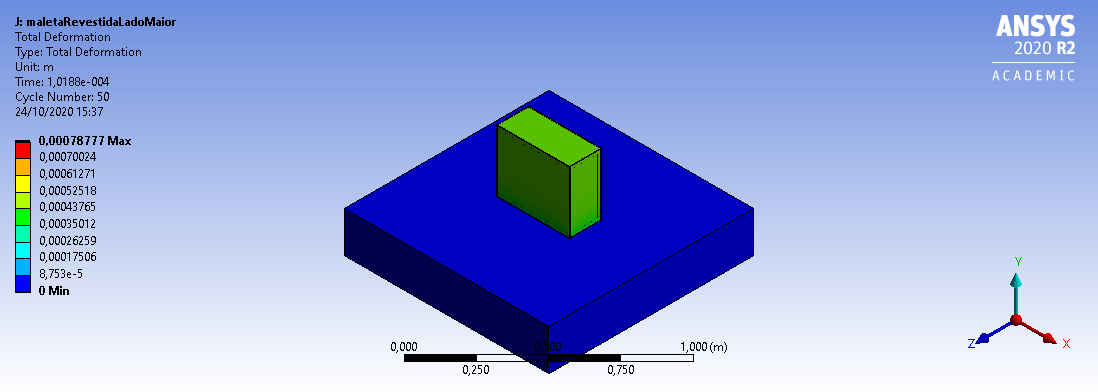
[picture p281: reports/PI2_PC3_fogueteiros/figuras/estrutura_simulacaoImpacto/maletaRevestidaDeformationMaior.png]
    
    \caption{Deformação da maleta revestida do sistema de controle em queda direta}
    \label{fig:simulacaoImpacto_34}
\end{figure}

\begin{figure}[htb]
    \centering
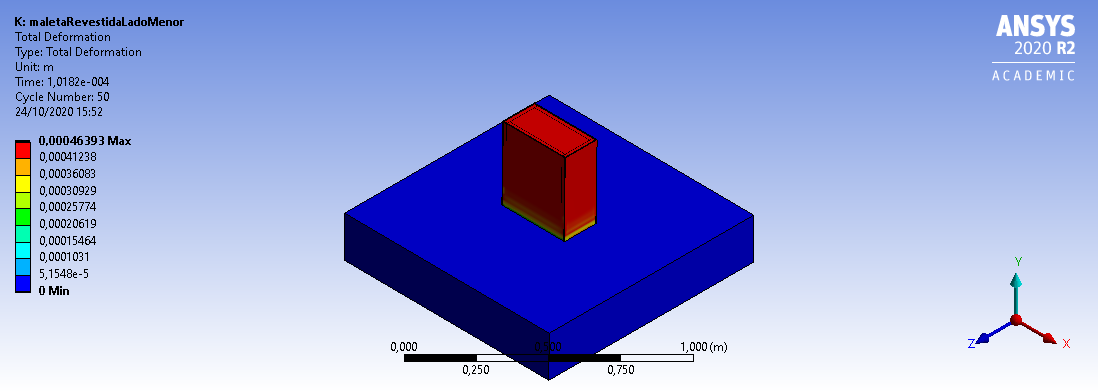
[picture p282: reports/PI2_PC3_fogueteiros/figuras/estrutura_simulacaoImpacto/maletaRevestidaDeformacaoMenor.png]
    
    \caption{Deformação da maleta revestida do sistema de controle em queda lateral}
    \label{fig:simulacaoImpacto_35}
\end{figure}

\begin{figure}[htb]
    \centering
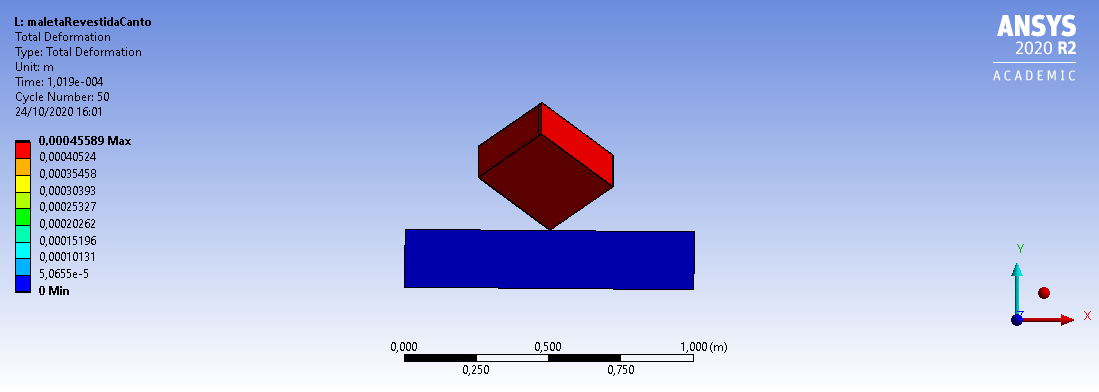
[picture p283: reports/PI2_PC2_fogueteiros/figuras/estrutura_simulacaoImpacto/maletaRevestidaDeformacaoCanto.png]
    
    \caption{Deformação da maleta revestida do sistema de controle em queda inclinada}
    \label{fig:simulacaoImpacto_36}
\end{figure}

\input{editaveis/alteracoes/alteracoes.tex}

\input{editaveis/autoavaliacao/autoavaliacao.tex}

\end{apendicesenv}
