Ground-Station/Documentation/reports/PI2_PC3_fogueteiros/editaveis/alteracoes/alteracoes.tex

\chapter[Registro de alterações]{Registro de alterações}
\label{alteracoes}

\begin{table}[H]
\centering
\begin{tabular}{|l|l|}
\hline
PC2 & \begin{tabular}[c]{@{}l@{}}Estudo sobre as dificuldades de aplicar Aprendizado de Máquina \\ no projeto.\end{tabular} \\ \hline
Seção \ref{Peso_do_Foguete} &  \begin{tabular}[c]{@{}l@{}}Adição de mais uma célula de carga para medição do peso do \\ foguete.\end{tabular}\\ \hline
Seção \ref{sec:baterias} &  \begin{tabular}[c]{@{}l@{}}Uso de duas baterias separadas. \end{tabular}\\ \hline
Seção \ref{sec:carregador} &  \begin{tabular}[c]{@{}l@{}}Construção de um carregador com estrutura a parte das maletas.\end{tabular}\\ \hline
Seção \ref{sec:mud_est} &  \begin{tabular}[c]{@{}l@{}}Separação das maletas e  construção de duas cases de suporte.\end{tabular}\\ \hline
Seção \ref{subsec:atuador} &  \begin{tabular}[c]{@{}l@{}}Válvula esfera selecionada e adaptador para a mesma.\end{tabular}\\ \hline

\end{tabular}
\caption{Lista de alterações significativas do projeto.}
\label{alteracoes}
\end{table}
