Ground-Station/Documentation/reports/PI2_PC3_fogueteiros/editaveis/autoavaliacao/autoavaliacao.tex

\chapter[Autoavaliação]{Autoavaliação}
%\addcontentsline{toc}{chapter}{Contextualização}
\label{autoavaliacao}

\begin{itemize}

%    \item \textbf{Nome:Nome}
%    \begin{itemize}
%        \item 
%    \end{itemize}
    
    \item \textbf{Nome: Augusto Moreno Vilarins}
    \begin{itemize}
    \item Refinamento da definição do produto
    \item Levantamento de requisitos
    \item Storytelling
    \item Protótipo de baixa fidelidade
    \item Wireframe
    \item Reuniões de alinhamento com o cliente
    \item Protótipo de média fidelidade
    \item Auxilio na elaboração do documento do Ponto de Controle 2
    \item Correção das mudanças sugeridas para o documento do ponto de controle 2
    \item Revisão e edição do documento de ponto de controle 3
    \item Manual de usuário
    \item Manual de montagem
    \item Documentação das reuniões com clientes
    \item Preparação do ambiente de desenvolvimento do Front end
    \item Auxílio no desenvolvimento do front end
    \end{itemize}

    \item \textbf{Nome: Artur Cardoso de Almeida}
    \begin{itemize}
      \item Dimensionamento do case de eletrônica. 
      \item Dimensionamento do carregador de energia.
      \item Redimensionamento da estrutura da Maleta 02 - Abastecimento.
      \item Criação dos CADS das maletas.
      \item Criação do CAD da case de de eletrônica.
      \item Criação do CAD do carregador de energia.
      \item Criação dos desenhos técnicos das estruturas.
      \item Tabela de materiais com vista explodida.
      \item Alinhamento sobre a disposição dos componentes da central de controle com o grupo de eletrônica. 
      \item Integração com o subsistema de eletrônica.
      \item Integração com o subsistema de energia.
      \item Renderização da maleta GCS e da maleta de abastecimento.
      \item Renderização do case de eletrônica
      \item Renderização do carregador de energia.
      \item Renderização do sistema de abastecimento.
      \item Orçamento dos componentes para fabricação da maleta.
      \item Auxilio na definição da solução de acoplamento dos atuadores nas válvulas.
      \item Auxílio na edição e revisão do Ponto de Controle 3.
      \item Auxilio na confecção do manual de montagem.
      \item Auxilio na confecção do manual de usuário.
    \end{itemize}

    \item \textbf{Nome: Diogo Filipe Sens}
    \begin{itemize}
     \item Revisão da simulação de impacto.
     \item Elaboração do plano de montagem das estruturas das duas maletas.
     \item Definição dos elementos de fixação dos componentes estruturais das duas maletas.
     \item elaboração de desenhos que ilustrem a sequência de montagem das duas maletas.
     \item Confecção do manual de montagem sobre a parte estrutural da maleta.
     \item Auxílio na elaboração do \textit{case} de suporte do subsistema válvula + motor + adaptador.
    \end{itemize}

    \item \textbf{Nome: Douglas Alves Brandão}
    \begin{itemize}
         \item Definição dos requisitos da estrutura utilizada no protótipo.
         \item Definição dos possíveis materiais a serem utilizados na construção da Ground Station.
         \item Auxílio na elaboração dos CADs da maleta. 
         \item Detalhamento das características dos materiais a serem utilizados na construção da Ground Station.
         \item Auxílio na modelagem do sistema de abastecimento. 
         \item Auxílio na simulação do sistema de abastecimento no software Simulink/Matlab.
         \item Definição dos parâmetros do sistema de abastecimento.
        \item Definição da solução para a abertura de válvulas.
         \item Auxílio na elaboração dos documentos dos Pontos de Controles.
         \item Confecção das instruções para o manual de montagem.
        \item Confecção do manual de montagem.
        \item Confecção dos CADs do sistema de abastecimento.
    \end{itemize}

    \item \textbf{Nome: Gustavo Cavalcante Linhares}
    \begin{itemize}
         \item Gerenciamento e acompanhamento das atividades do grupo de eletrônica 
         \item Detalhamento da solução de integração entre hardware e eletrônica
         \item Alinhamento com os gerentes sobre as soluções tomadas e sobre o desenvolvimento do projeto
         \item Alinhamento entre eletrônica, sub áreas do projeto e o Stakeholder sobre as soluções que possuem impacto no trabalho em mais de um grupo dentro do projeto.
         \item Revisão final dos diagramas esquemático e do projeto de PCI's.
         \item Construção do Manual de montagem no subtópico da montagem dos componentes eletrônicos 
         \item Auxilio na construção do Manual de usuário
         \item Revisão da documentação do PC3 do manual de usuário e manual de montagem
    \end{itemize}

    \item \textbf{Nome: Francisco Matheus Fernandes Gomes}
    \begin{itemize}
     \item Revisão final dos diagramas esquemático e do projeto de PCI's.
    \item Criação do diagrama de blocos do abastecimento do projeto e no auxilio do diagrama geral.
    \item Auxílio na edição e revisão do Ponto de Controle 3.
    \item Confecção do manual de montagem.
    \item Confecção do manual do usuário.
   \item Levantamento e definição de requisito para o funcionamento da telemetria por Lora na ESP32.
   \item Auxílio na definição da solução de acionamento e controle eletrônico das válvulas internas e externas ao foguete.
    \item Auxílio na integração da eletrônica com os grupos de energia e estrutura.
    \item Atualização dos custos dos componentes que envolve o hardware do projeto.
    \end{itemize}
    
    \item \textbf{Nome: Gabriela Alves da Gama}
    \begin{itemize}
     \item Desenvolvimento do Manter Hardware e Comando;
    \item Configuração do banco de dados;
    \item Desenvolvimento do Manter Foguete;
    \item Desenvolvimento do calculo de velocidade;
    \item Desenvolvimento do manter altitude, gps, missao, peso, pressão, e velocidade; 
    \item Descrever construção do backend;
    \item Desenvolvimento do serviço de simulação
    \item Revisão dos artefatos de software
    \end{itemize}

    \item \textbf{Nome: Isaque Alves de Lima}
    \begin{itemize}
    \item Gerenciamento de riscos do projeto;
    \item Direcionamento nas reuniões;
    \item Apoio no alinhamento entre as áreas do projeto;
    \item Edição e revisão do Ponto de Controle 3;
    \item Alinhamento e acompanhamento das atividades do projeto;
    \item Desenvolvimento do Manter Hardware e Comando;
    \item Configuração do banco de dados;
    \item Desenvolvimento do Manter Foguete;
    \item Desenvolvimento do calculo de velocidade;
    \item Desenvolvimento do manter altitude, gps, missao, peso, pressão, e velocidade;
    \item Documentação da API;
    \item Diagrama de pacotes do backend;
    \item Reuniões de alinhamento Software-eletrônica;
    \item Cenários de teste;
    \item Apendice GitHub;
    \item Descrever construção do backend;
    \item Plano de teste do manual de montagem;
    \item Atualização do diagrama de sequência da solução;
    \item Descrever construção do front end;
    \item Atualização das metas e restrições da arquitetura;
    \item Revisão das atividades de software;
    \item Revisão final dos diagramas e imagens;
    \end{itemize}

    \item \textbf{Nome: João Henrique Egewarth}
    \begin{itemize}
    \item Gerenciamento e acompanhamento das atividades do grupo de software;
    \item Reuniões com clientes;
    \item Descrever construção do front end;
    \item Auxílio na edição e revisão do Ponto de Controle 3;
    \item Alinhamento e acompanhamento das atividades do projeto;
    \item Documentação da API;
    \item Elaboração dos cenários de teste;
    \item Desenvolvimento do Front end da aplicação;
    \item Preparação do ambiente de desenvolvimento do Front end;
    \item Alinhamento com eletrônica para desenvolvimento da comunicação serial;
    \item Diagrama de pacotes do Front end;
    \item Escrita sobre a infraestrutura necessária para a emulação do ambiente com arquitetura computacional Arm64 em ambientes com arquitetura x86;
    \end{itemize}
    
    \item \textbf{Nome: Luísa Prospero de Carvalho silva}
    \begin{itemize} 
     \item Correções levantadas para o documento do ponto de controle.
     \item Revisão e edição do documento de ponto de controle 3
     \item Construção e revisão do Manual de usuário
     \item Construção e revisão do Manual de montagem 
     \item Definição do material para as case.
     \item Definição dos requisitos da estrutura utilizada no protótipo.
     \item Modelagem do sistema de abastecimento. 
     \item Diagrama técnico do sistema de abastecimento.
     \item Gerenciamento e acompanhamento das atividades do grupo de estrutura e energia 
     \item Alinhamento com os gerentes sobre as soluções tomadas e sobre o desenvolvimento do projeto
     \item Revisão final dos desenhos técnicos.
     \item Revisão final de energia e estrutura
     \item Auxílio na definição da solução de acoplamento da válvula e do motor.
     \item Plano de teste do manual de montagem;
     \item Auxilio na definição da solução de acoplamento dos atuadores nas válvulas.
     \item Atualização dos custos dos componentes da estrutura.
     \item caracterização dos componentes de abastecimento
   \end{itemize}
    
    \item \textbf{Nome: Milena Martins Magalhães}
    \begin{itemize}
    \item Elaboração do manual de usuário para operação do sistema de carregamento e  manutenção das baterias.
    \item Elaboração do plano de testes para o sistema de carregamento.
    \item Elaboração do manual de montagem do carregador.
    \item Alinhamento com equipes de estrutura e eletrônica para integração.
    \item Atualização dos custos dos componentes do sistema de alimentação e carregamento.
    \item Confecção da Placa de Circuito Impresso do carregador no EasyEDA.
    \item Auxílio na edição e revisão do documento do Ponto de Controle 3.
    \end{itemize}

    \item \textbf{Nome: Misael de Souza Andrade}
    \begin{itemize}
    \item Definição da solução de acionamento dos atuadores das válvulas e ignição.
    \item Criação do diagrama de algoritmo da calibração do sensor de peso.
    \item Auxílio na edição e revisão do Ponto de Controle 3.
    \item Confecção do manual de montagem, mais especificamente do subgrupo da Eletrônica.
   \item Levantamento e deificação de requisito para o funcionamento do sensoriamento.
   \item Auxílio na definição da solução de acionamento e controle eletrônico das válvulas internas e externas ao foguete.
   \item Auxílio na definição da solução do pacote de dados transmitidos pela ESP32 LoRa.
   \item Auxílio na integração da eletrônica com os grupos de energia e estrutura.
    \end{itemize}

    \item \textbf{Nome: Thainá Rodrigues Fernandes}
    \begin{itemize}
    \item Elaboração do manual de usuário para operação do sistema de carregamento e manutenção das baterias.
	\item Elaboração do plano de testes para o sistema de alimentação e do carregador.
	\item Elaboração do manual de montagem do sistema de alimentação da maleta e da base de lançamento.
	\item Alinhamento com equipes de estrutura e eletrônica para integração.
	\item Atualização dos custos dos componentes do sistema de alimentação e carregamento.
	\item Pareamento com outras equipes sobre a solução da ignição.
	\item Atualização dos diagramas unifilares dos sistemas de controle e da base.
	\item Auxílio na edição e revisão do documento do Ponto de Controle 3.
    \end{itemize}

\end{itemize}
