Ground-Station/Documentation/reports/PI2_PC3_fogueteiros/editaveis/solucao/solucao.tex

\part{Concepção e Detalhamento da Solução}

\chapter{Solução Geral}

\begin{figure}[H]
    \centering
    
\end{figure}

\par A solução proposta é o projeto de uma estação de controle e monitoramento do lançamento de um foguete experimental movido a propulsão híbrida. Por meio de sensores e atuadores, a estação realizará o abastecimento e a ignição remota do foguete e, durante o voo, a coleta da telemetria deste.

\par A solução conta com duas estruturas principais em formato de maleta. A primeira é aqui tratada como maleta de controle e monitoramento, onde o sistema principal de hardware estará instalado e embarcado com o código fonte de interface do usuário. Aqui também estará a bateria de alimentação para esse sistema, além da tela e do teclado para visualizações e envios de comandos por parte do usuário. 

\par A segunda maleta é referida como maleta de suporte/apoio ao abastecimento, nela estará todos os componentes necessários para a montagem e manutenção do sistema de abastecimento a distancia, bem como uma segunda bateria para os motores e para a ignição do sistema. Ela também contará para o transporte do adaptador de válvula.

\par Por fim a solução conta com um sistema de carregamento para ambas as baterias selecionadas, um sistema de aquisição de dados de sensores que vão dentro do foguete e também de sensores na base de lançamento.

\input{editaveis/solucao/software/software.tex}
\input{editaveis/solucao/eletronica/eletronica.tex}
\input{editaveis/solucao/energia/energia.tex}
\input{editaveis/solucao/estrutura/estrutura.tex}
\input{editaveis/solucao/estrutura/abastecimento.tex}
\input{editaveis/solucao/custos/custos.tex}
\input{editaveis/solucao/consideracoes/consideracoes.tex}
