Ground-Station/Documentation/reports/PI2_PC1_fogueteiros/editaveis/TAP/5w1h/5w1h.tex

\section{5W1H}

Antes de iniciar um projeto é muito importante ter com clareza: o que vai ser feito, como deve ser feito, porque deve ser feito, quem será responsável pelo trabalho, onde será feito e em qual período de tempo. A resposta para essas perguntas aprimoram o planejamento e auxiliam na criação de um plano de ação \cite{5w1hUFMG}.

A figura \ref{fig:5w1h} apresenta em forma de diagrama cada uma das 6 perguntas fundamentais e suas respectivas respostas baseadas no contexto desse projeto.

\begin{figure}[H]
  \centering
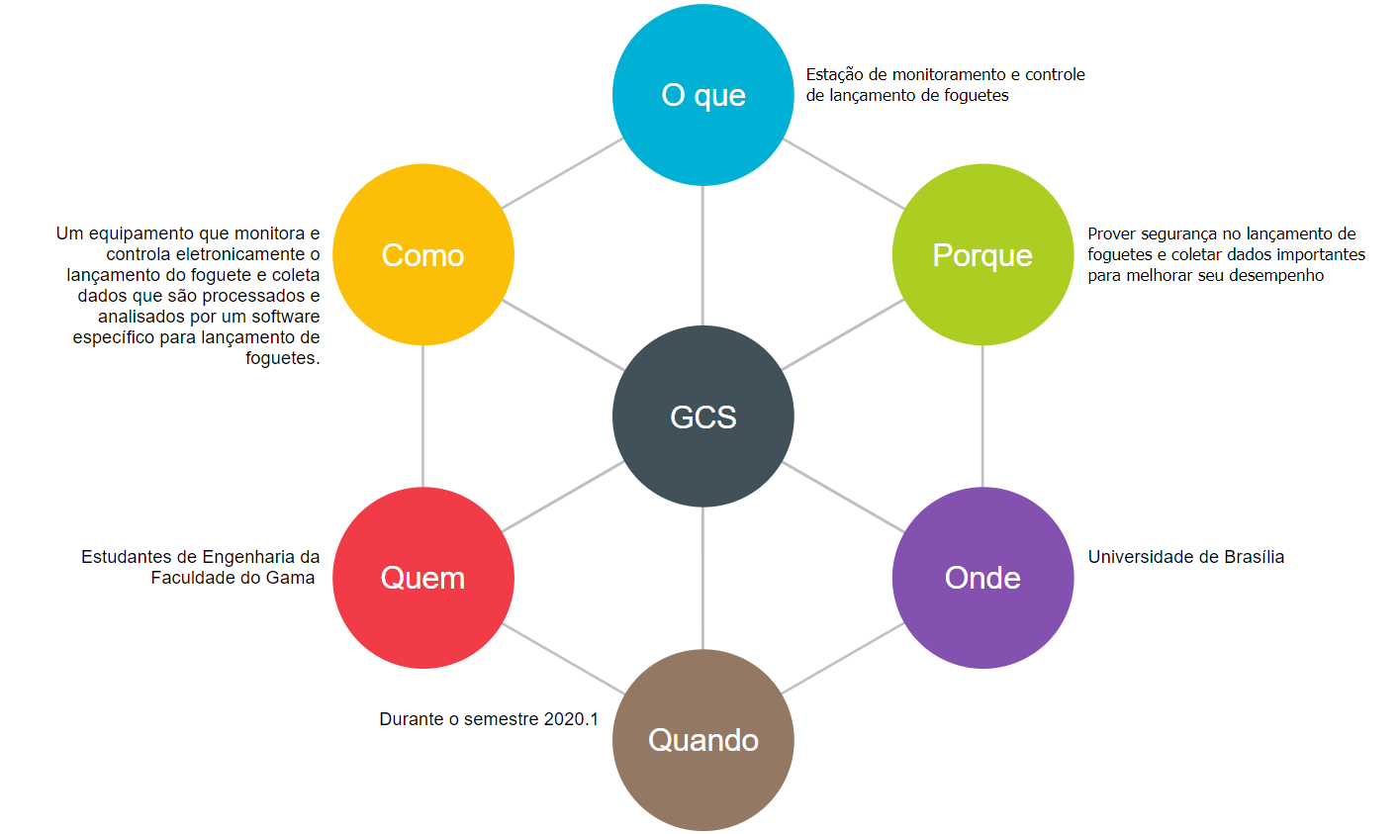
[picture p290: reports/PI2_PC1_fogueteiros/figuras/5w1h.png]
  
  \caption{5W1H. O diagrama foi construído usando a ferramenta Visual Paradigm Online Diagrams.} 
  \label{fig:5w1h}
\end{figure}
