Ground-Station/Documentation/reports/PI2_PC1_fogueteiros/editaveis/TAP/CANVAS/CANVAS.tex

\section{Bussines Model CANVAS}

Com o uso da ferramenta MIRO, foi desenvolvido um  \textit{business model} Canvas para o projeto, que pode ser visto no apêndice \ref{canvas}:  figura \ref{fig:Canvas} . Comumente chamado apenas de Canvas, essa ferramenta tem como objetivo esboçar a ideia de um modelo de negócio de maneira simples, eficaz e visual. Logo, um documento como este agrega valor ao projeto, devido ao fato deste estar ligado à uma equipe de competição.

Exemplificando, de acordo com o desempenho da equipe nas competições, a atenção dos outros competidores voltar-se-á ao projeto. Dada essa relação, poderão surgir  oportunidades de realizar negócios por meio do produto desenvolvido, assim justificando o desenvolvimento e o valor desse documento.
