Ground-Station/Documentation/reports/PI2_PC1_fogueteiros/editaveis/TAP/Cronograma/cronograma.tex

\section{ \textit{Roadmap}}
Para uma melhor visualização e análise do  \textit{Roadmap}, ele pode ser visto no Apendice \ref{Roadmap}, mas também está disponível no link a seguir: \href{https://docs.google.com/spreadsheets/d/13mSpMqhIIh5OHl95djhCfA4ejr36CvJLpA65PvluUAU/edit?usp=sharing}{ \textit{Roadmap}}.

\subsection{Marcos Identificados}
\label{Milestones Identificados}
Os \textit{milestones} identificados encontram-se na tabela \ref{tab:tabelamilestones}. 

\begin{table}[H]
\begin{tabular}{|p{8cm}|p{6cm}|}
\hline
%%%%%%%%%%%%%%%%%%%%%%%%%%%%%%%%%%%%%%%%%%%%%%%%%
\textbf{Atividades}  & \textbf{Data de Entrega}         
\\ \hline
%%%%%%%%%%%%%%%%%%%%%%%%%%%%%%%%%%%%%%%%%%%%%%%%%

Entrega de Relatório Ponto de Controle 1    & 5 dias antes da apresentação
\\ \hline
%%%%%%%%%%%%%%%%%%%%%%%%%%%%%%%%%%%%%%%%%%%%%%%%%

Apresentação Ponto de Controle 1 &  18/09/2020, 25/09/2020 ou 02/10/2020

\\ \hline
%%%%%%%%%%%%%%%%%%%%%%%%%%%%%%%%%%%%%%%%%%%%%%%%%

Entrega de Relatório Ponto de Controle 2  & 5 dias antes da apresentação 
\\ \hline
%%%%%%%%%%%%%%%%%%%%%%%%%%%%%%%%%%%%%%%%%%%%%%%%%

Apresentação Ponto de Controle 2 & 16/10/2020, 23/10/2020 ou 30/10/2020
\\ \hline
%%%%%%%%%%%%%%%%%%%%%%%%%%%%%%%%%%%%%%%%%%%%%%%%%

Entrega de Relatório Ponto de Controle 3 & 5 dias antes da apresentação
\\ \hline
%%%%%%%%%%%%%%%%%%%%%%%%%%%%%%%%%%%%%%%%%%%%%%%%%
Apresentação Ponto de Controle 3 & 13/11/2020, 20/11/2020 ou 27/11/2020
\\ \hline
%%%%%%%%%%%%%%%%%%%%%%%%%%%%%%%%%%%%%%%%%%%%%%%%%
Entrega do repositório do projeto & 04/12/2020
\\ \hline
%%%%%%%%%%%%%%%%%%%%%%%%%%%%%%%%%%%%%%%%%%%%%%%%%
Apresentação de projetos na FIT/FGA On Line
(Feira de Inovação e Tecnologia da FGA) & 04/12/2020

\\ \hline
%%%%%%%%%%%%%%%%%%%%%%%%%%%%%%%%%%%%%%%%%%%%%%%%%
\end{tabular}
\caption{ \textit{Milestones} identificados.}
\label{tab:tabelamilestones}
\end{table}
