Ground-Station/Documentation/reports/PI2_PC1_fogueteiros/editaveis/TAP/Stakeholders/Stakeholders.tex

\section{Stakeholders}
\label{stakeholders}

\subsection{Equipe} A equipe é composta por alunos da disciplina Projeto Integrador da Faculdade do Gama da Universidade de Brasília (tabela \ref{tab:equipe}). E tem o compromisso de entregar o produto de acordo com o escopo acordado entre o professor da disciplina e os integrantes do time;

\begin{table}[H]
\centering
\begin{tabular}{|l|l|l|}
\hline
Nome & Curso & e-mail \\ \hline
    André Hernandez Bargas &    Software   &    andrebargas@gmail.com    \\ \hline
    Artur Cardoso de Almeida &    Automotiva   &    artur.kd2@gmail.com    \\ \hline
    Augusto Moreno Vilarins  &   Software    &    augusto.vilarins@gmail.com    \\ \hline
    Diogo Filipe Sens &     Aeroespacial   &    diogosens@gmail.com    \\ \hline
    Douglas Alves Brandão  &    Aeroespacial   &   douglasbbb@gmail.com     \\ \hline
    Francisco Matheus Fernandes Gomes &   Eletrônica    &    f.matheusbsb@gmail.com    \\ \hline
    Gabriela Alves da Gama &    Software   &    gabrielaalvesdagama@gmail.com    \\ \hline
    Gustavo Cavalcante Linhares &     Eletrônica   &  gugacavalcante.10@hotmail.com      \\ \hline
    Isaque Alves de Lima &   Software    &    isaquealvesdl@gmail.com    \\ \hline
    João Henrique Egewarth &    Software    &    egewarth@gmail.com    \\ \hline
    Luísa Prospero de Carvalho Silva &   Aeroespacial   &    luisaprosperocs@gmail.com    \\ \hline
    Milena Martins Magalhães &   Energia    &    milenammagalhaes@gmail.com    \\ \hline
    Misael de Souza Andrade &     Eletrônica   &    misas.andrade@gmail.com    \\ \hline
    Thainá Rodrigues Fernandes &   Energia    &    thaina_rodrigues.f@hotmail.com    \\ \hline
\end{tabular}
\caption{Equipe do Projeto}
\label{tab:equipe}
\end{table}
    
\subsection{Professores} São apoiadores e avaliadores do projeto, que auxiliam na decisão da metodologia, escopo, produção e aspectos técnicos relacionados à solução do problema;

\begin{itemize}
    \item Alex Reis - Engenharia de Energia
    \item José Felício da Silva - Engenharia Eletrônica
    \item Paolo Gessini - Engenharia Aeroespacial
    \item Rhander Viana - Engenharia Automotiva
    \item Ricardo Matos Chaim - Engenharia de Software
\end{itemize}
    
\subsection{Capital Rocket Team - CRT} Cliente, tem o encargo de fornecer os requisitos necessários para a construção do projeto, além de fornecer  insumos para a construção do produto.

\begin{itemize}
    \item e-mail: capitalrocketteam@gmail.com
    \item Número: (61) 99853-9777
    \item Redes sociais: @capitalrocketteam
\end{itemize}
