Ground-Station/Documentation/electronic/case_base_views/case iso.png

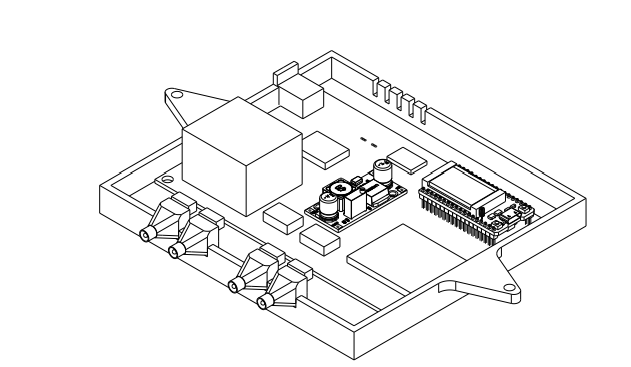
electronic/case_base_views/case iso.png
