Ground-Station/Documentation/electronic/diagrams/Diagrama_Geral.png

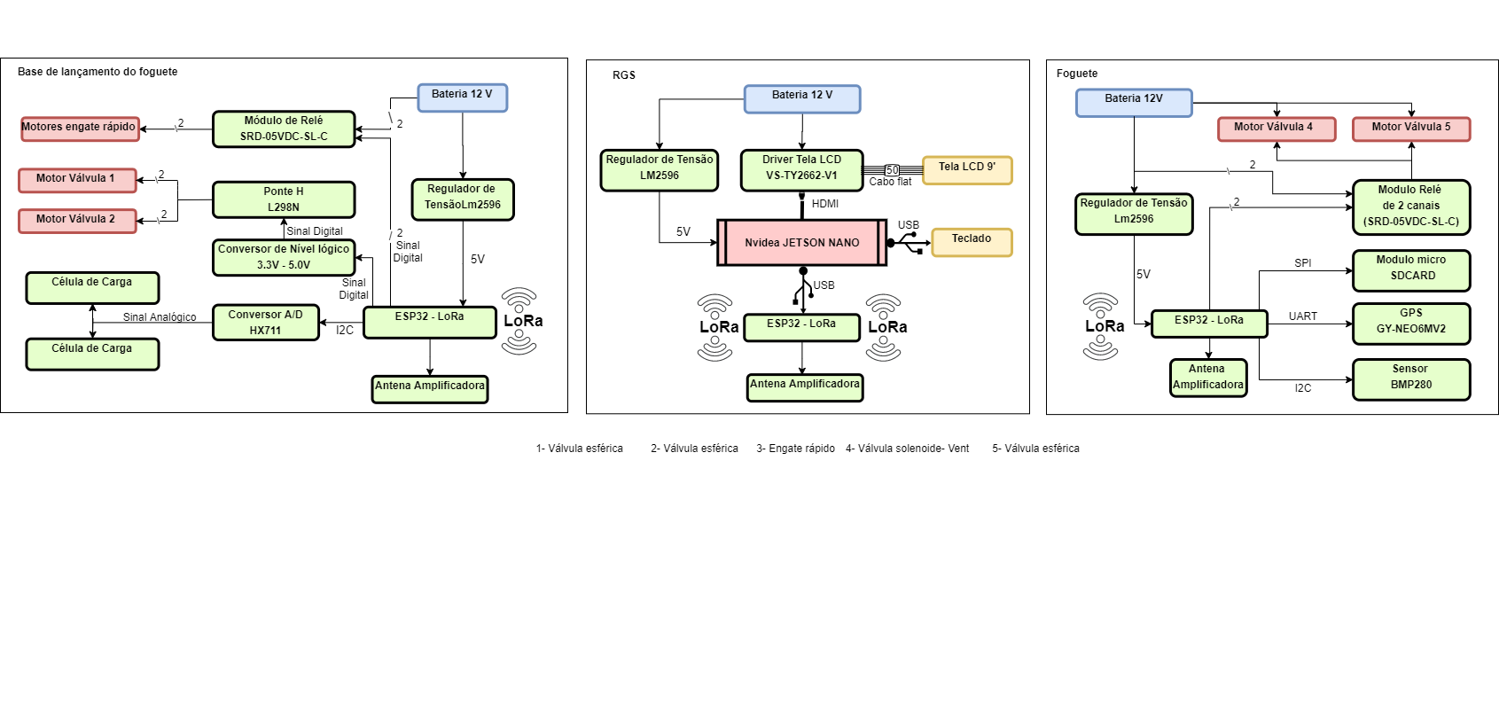
electronic/diagrams/Diagrama_Geral.png
