Ground-Station/Documentation/reports/PI2_PC1_fogueteiros/figuras/Cronograma - Roadmap-1.png

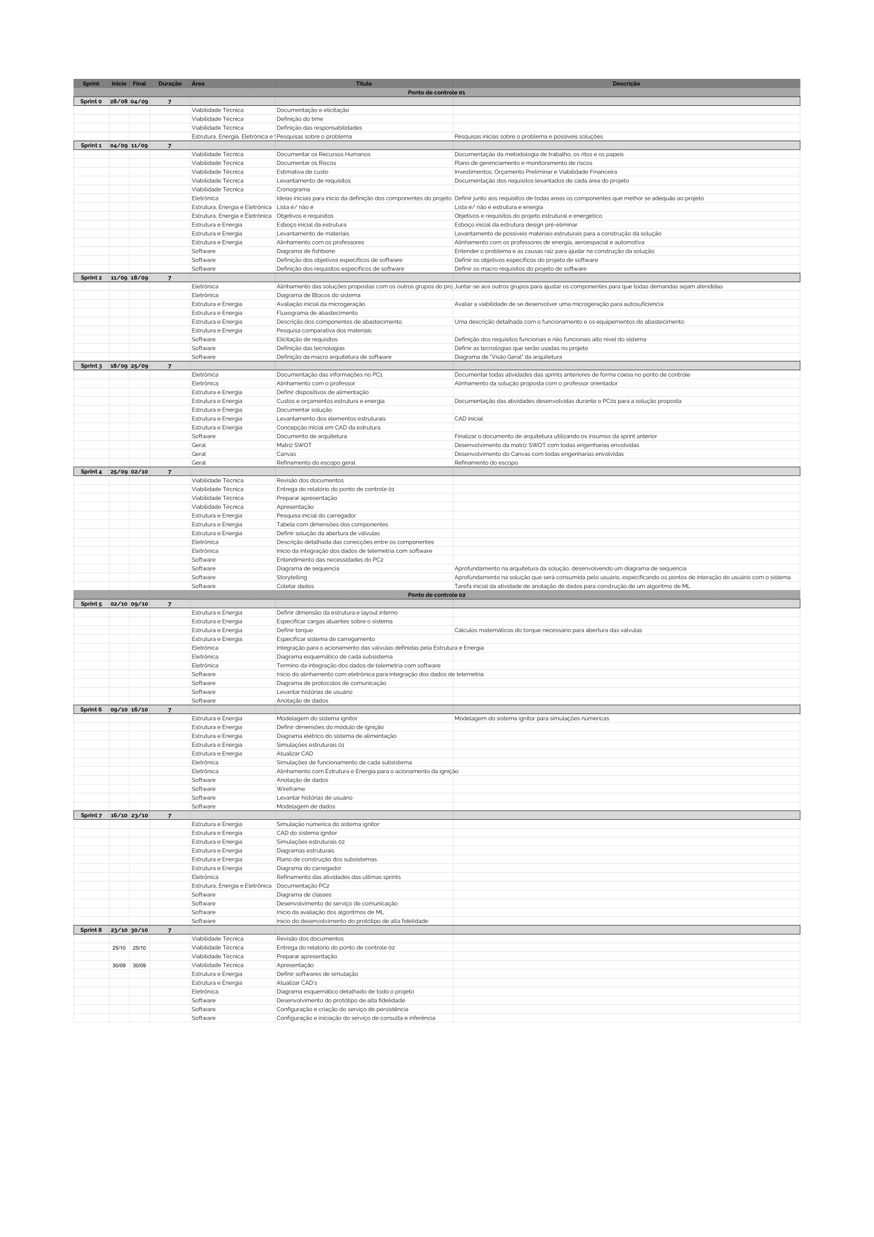
reports/PI2_PC1_fogueteiros/figuras/Cronograma - Roadmap-1.png
