Ground-Station/Documentation/reports/PI2_PC1_fogueteiros/figuras/diagramaBlocos.png

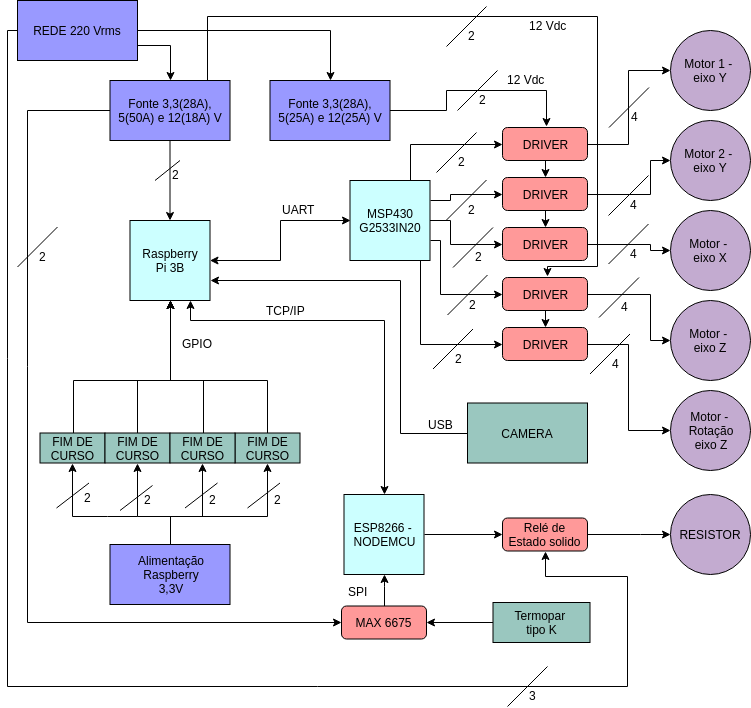
reports/PI2_PC1_fogueteiros/figuras/diagramaBlocos.png
