Ground-Station/Documentation/reports/PI2_PC1_fogueteiros/figuras/render_pnp_v1.png

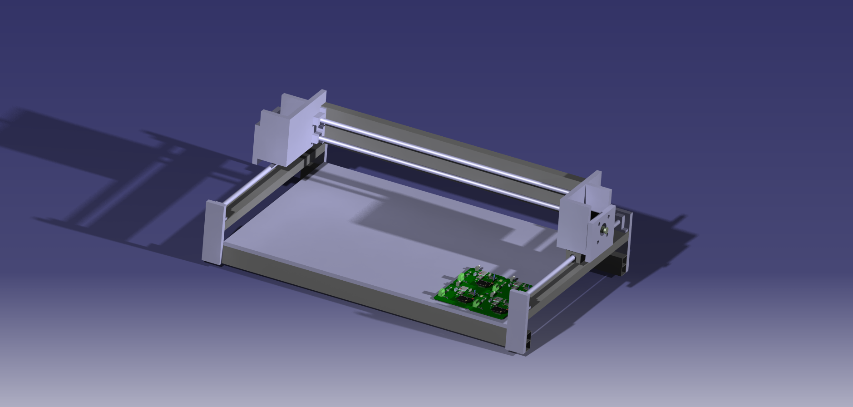
reports/PI2_PC1_fogueteiros/figuras/render_pnp_v1.png
