Ground-Station/Documentation/reports/PI2_PC1_fogueteiros/figuras/tcesp.png

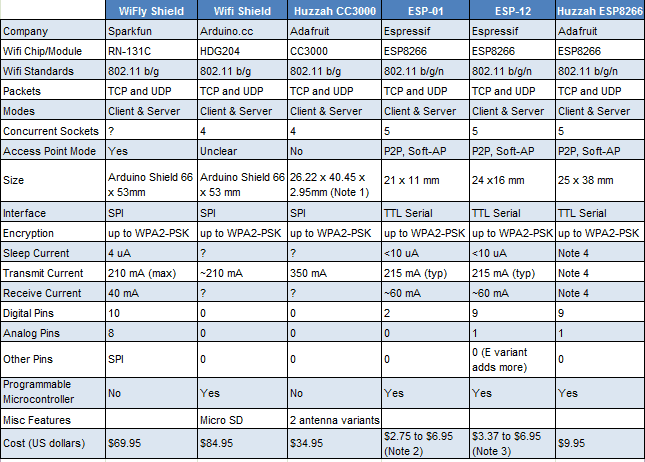
reports/PI2_PC1_fogueteiros/figuras/tcesp.png
