Ground-Station/Documentation/reports/PI2_PC1_fogueteiros/figuras/telem.png

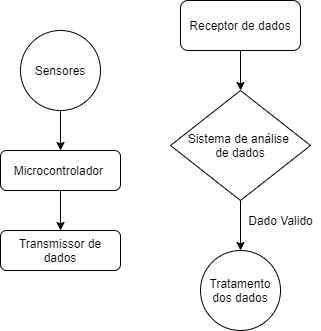
reports/PI2_PC1_fogueteiros/figuras/telem.png
