Ground-Station/Documentation/reports/PI2_PC2_fogueteiros/figuras/diagrama_sequencia_abastecimento.png

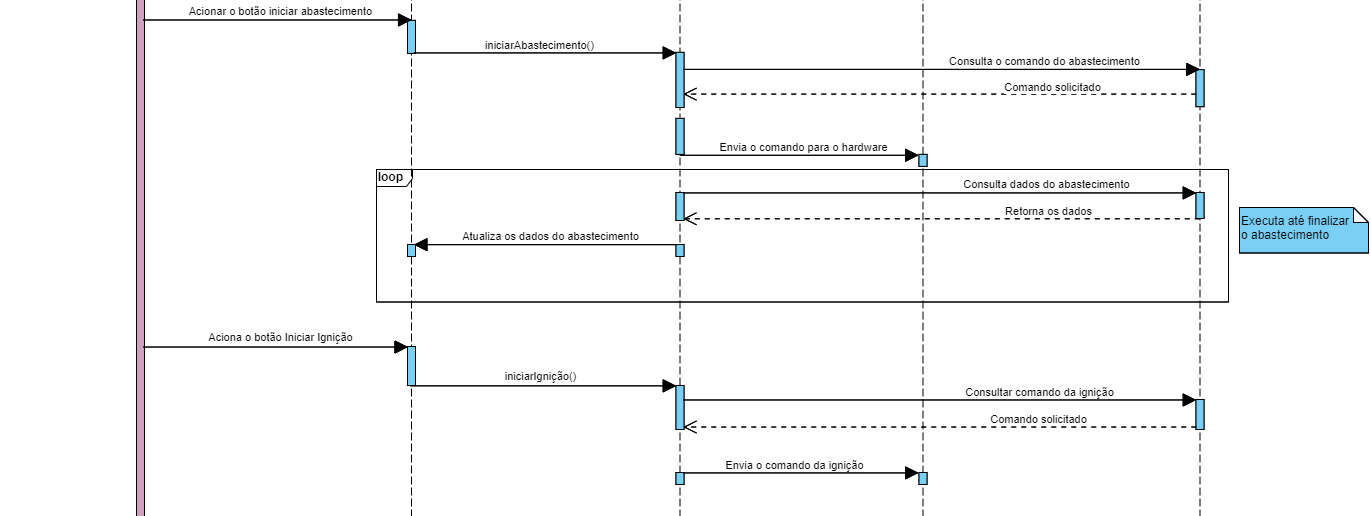
reports/PI2_PC2_fogueteiros/figuras/diagrama_sequencia_abastecimento.png
