Ground-Station/Documentation/reports/PI2_PC2_fogueteiros/figuras/estrutura_simulacaoImpacto/ignicaoMalha.png

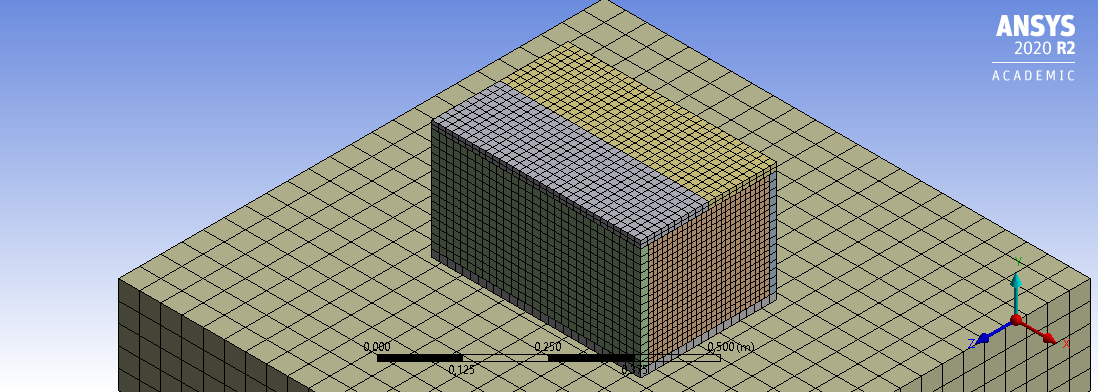
reports/PI2_PC2_fogueteiros/figuras/estrutura_simulacaoImpacto/ignicaoMalha.png
