Ground-Station/Documentation/reports/PI2_PC2_fogueteiros/figuras/estrutura_simulacaoImpacto/maletaRevestidaMalha.png

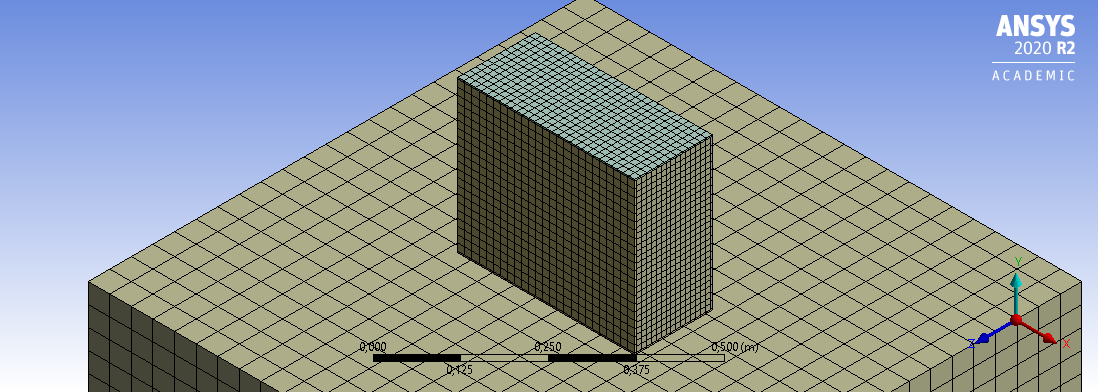
reports/PI2_PC2_fogueteiros/figuras/estrutura_simulacaoImpacto/maletaRevestidaMalha.png
