Ground-Station/Documentation/reports/PI2_PC2_fogueteiros/figuras/modulação lora.png

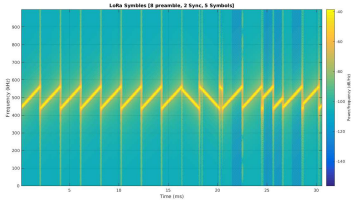
reports/PI2_PC2_fogueteiros/figuras/modulação lora.png
