Ground-Station/Documentation/reports/PI2_PC2_fogueteiros/figuras/PCI-FOGUETE B.png

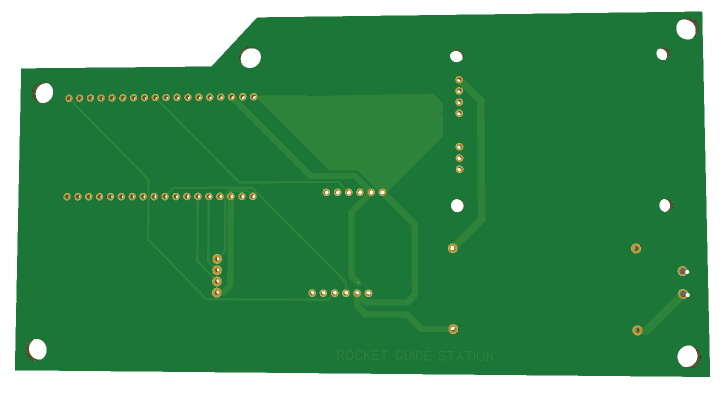
reports/PI2_PC2_fogueteiros/figuras/PCI-FOGUETE B.png
