Ground-Station/Documentation/reports/PI2_PC2_fogueteiros/figuras/PINAGEM_BALANCA.png

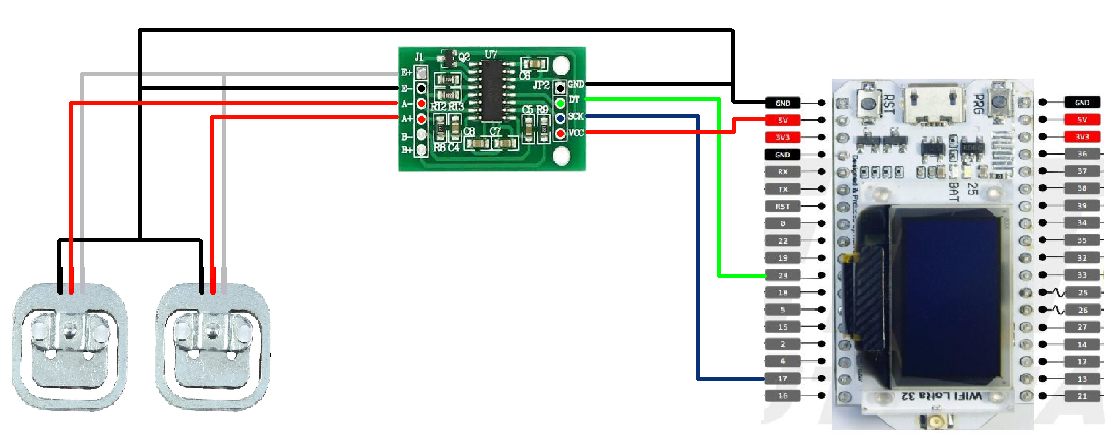
reports/PI2_PC2_fogueteiros/figuras/PINAGEM_BALANCA.png
