Ground-Station/Documentation/reports/PI2_PC2_fogueteiros/figuras/PINAGEM_BMP280.png

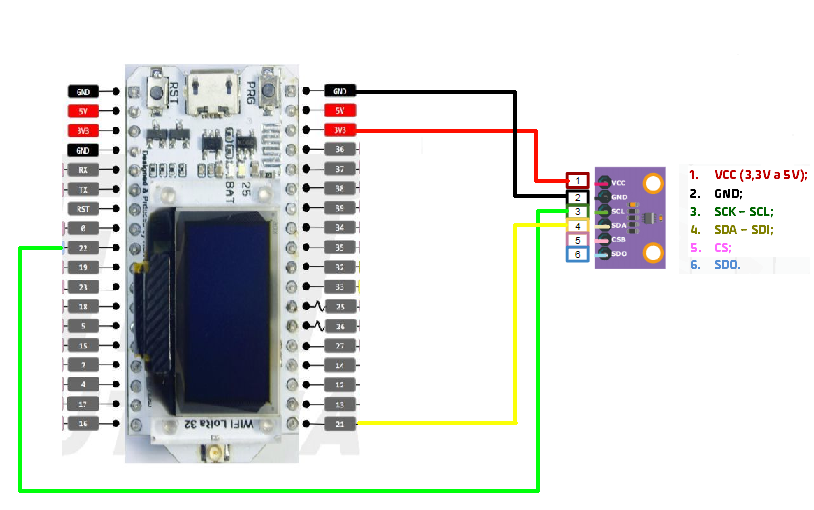
reports/PI2_PC2_fogueteiros/figuras/PINAGEM_BMP280.png
