Ground-Station/Documentation/reports/PI2_PC2_fogueteiros/figuras/rgs_3.png

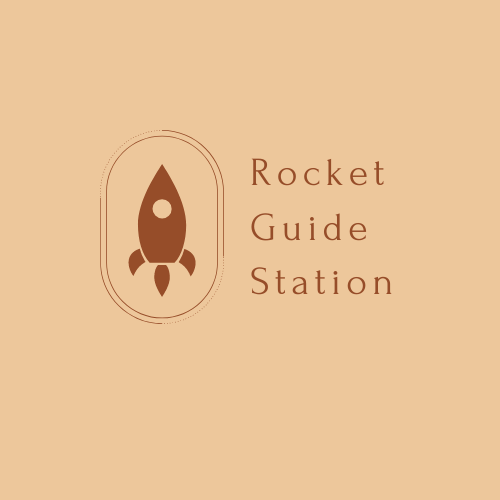
reports/PI2_PC2_fogueteiros/figuras/rgs_3.png
