Ground-Station/Documentation/reports/PI2_PC3_fogueteiros/figuras/BASE_VALVULAS.png

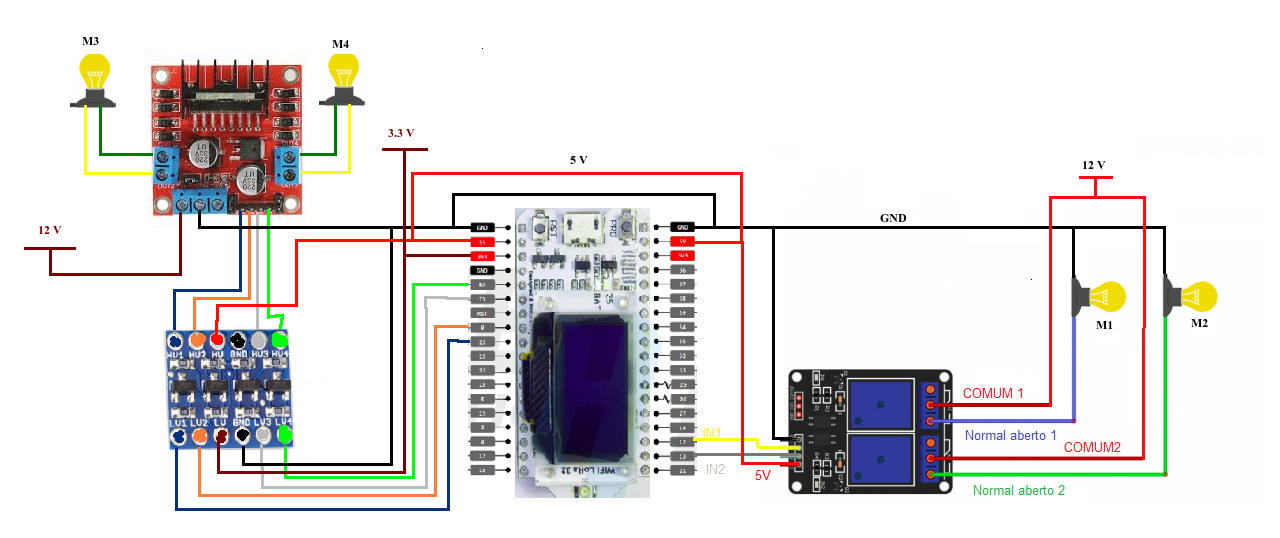
reports/PI2_PC3_fogueteiros/figuras/BASE_VALVULAS.png
