Ground-Station/Documentation/reports/PI2_PC3_fogueteiros/figuras/deploy-quemu.png

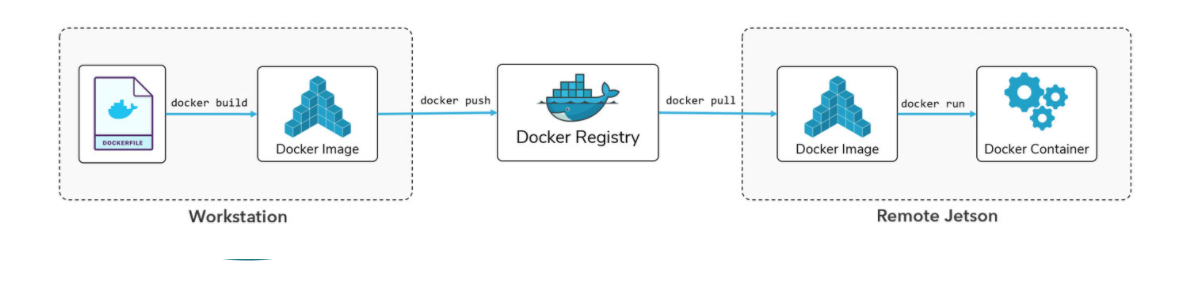
reports/PI2_PC3_fogueteiros/figuras/deploy-quemu.png
