Ground-Station/Documentation/reports/PI2_PC3_fogueteiros/figuras/PCB_PCB_2020-10-22_23-29-17_2020-10-24_17-54-34.png

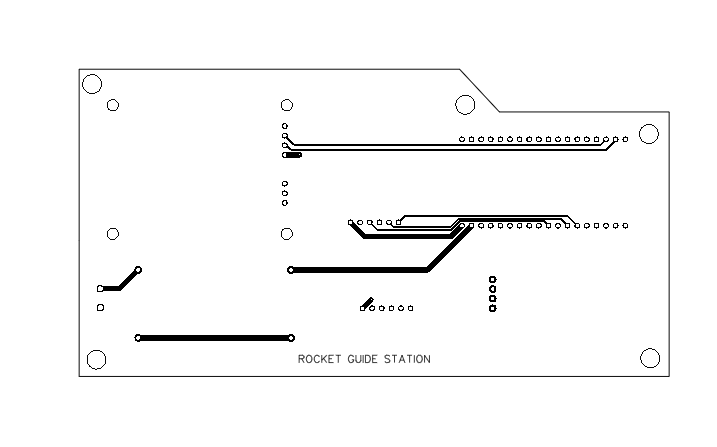
reports/PI2_PC3_fogueteiros/figuras/PCB_PCB_2020-10-22_23-29-17_2020-10-24_17-54-34.png
