Ground-Station/Documentation/reports/PI2_PC3_fogueteiros/figuras/PCI-FOGUETE T.png

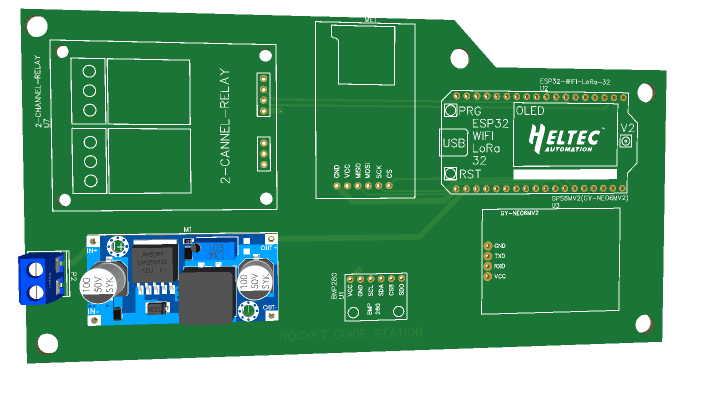
reports/PI2_PC3_fogueteiros/figuras/PCI-FOGUETE T.png
