Ground-Station/Documentation/reports/PI2_PC3_fogueteiros/figuras/PCI_carregador.JPG

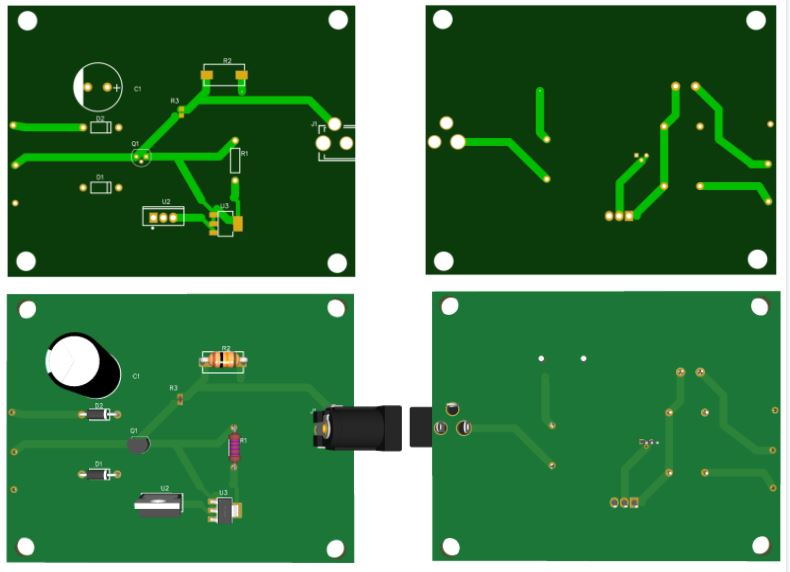
reports/PI2_PC3_fogueteiros/figuras/PCI_carregador.JPG
