Ground-Station/Documentation/reports/PI2_PC3_fogueteiros/figuras/telas_software/2.png

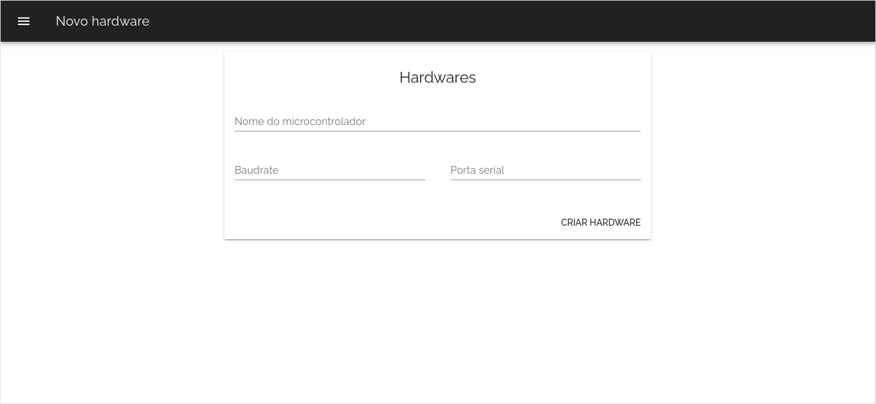
reports/PI2_PC3_fogueteiros/figuras/telas_software/2.png
