Ground-Station/Documentation/reports/PI2_PC3_fogueteiros/figuras/telas_software/7-full.png

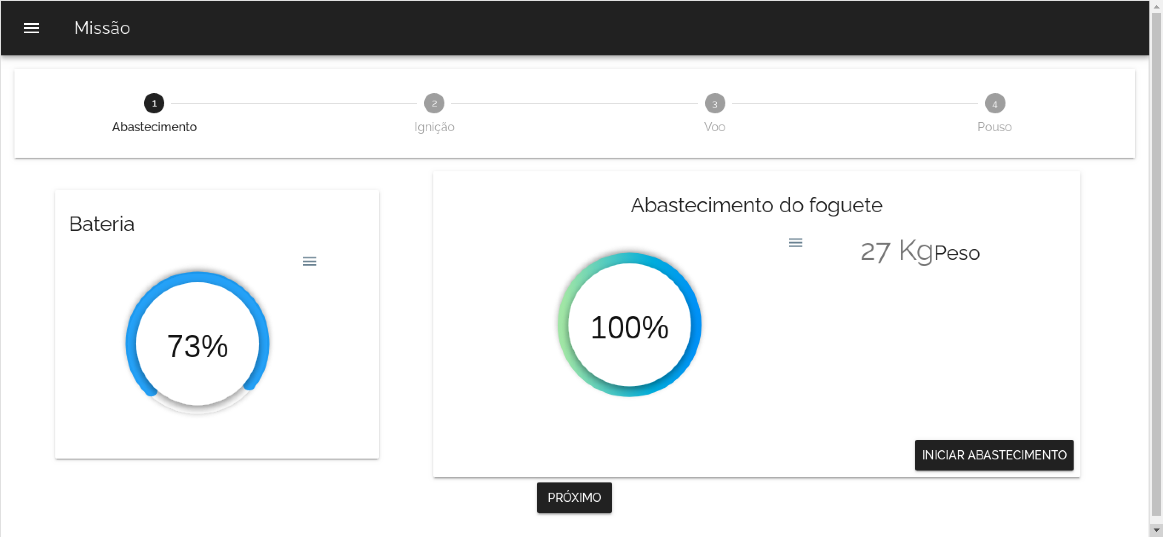
reports/PI2_PC3_fogueteiros/figuras/telas_software/7-full.png
