Ground-Station/Documentation/Estrutura/PC2/Imagens/Componentes/Controlador.PNG

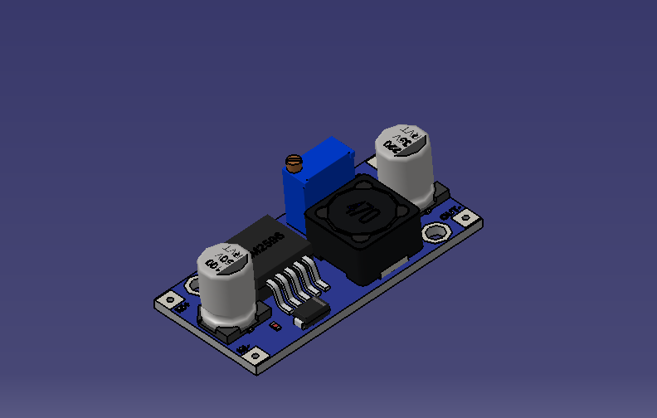
Estrutura/PC2/Imagens/Componentes/Controlador.PNG
