Ground-Station/Documentation/Estrutura/PC2/Imagens/Componentes/Motor iso.PNG

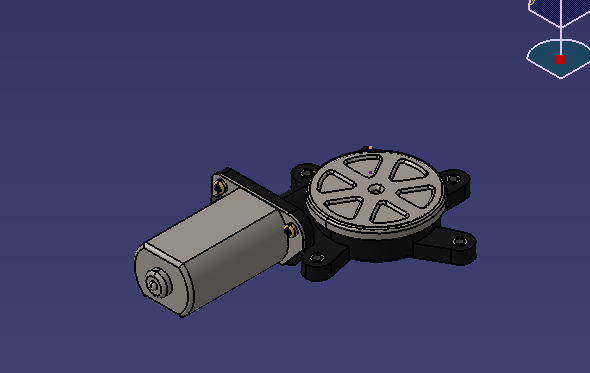
Estrutura/PC2/Imagens/Componentes/Motor iso.PNG
