Ground-Station/Documentation/Estrutura/PC2/Imagens/Componentes/Motor.PNG

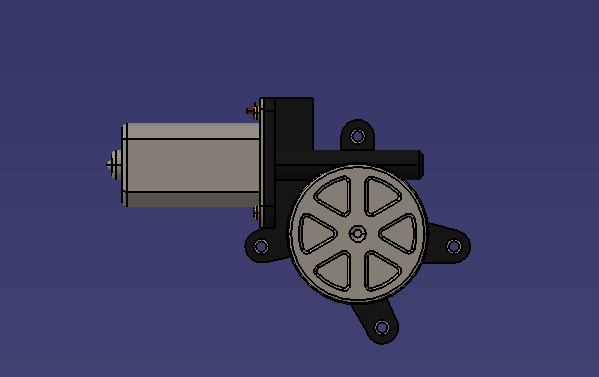
Estrutura/PC2/Imagens/Componentes/Motor.PNG
