Ground-Station/Documentation/Estrutura/PC2/Imagens/Componentes/Valvula.PNG

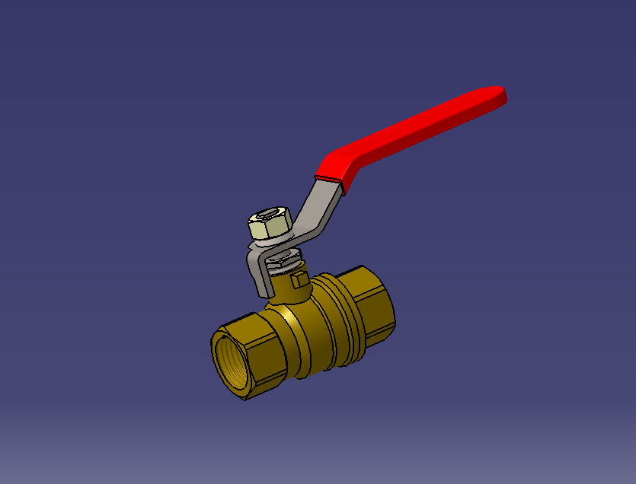
Estrutura/PC2/Imagens/Componentes/Valvula.PNG
