Ground-Station/Documentation/Estrutura/Sistema de Abastecimento/CADs/Montagem_Diogo.SLDASM

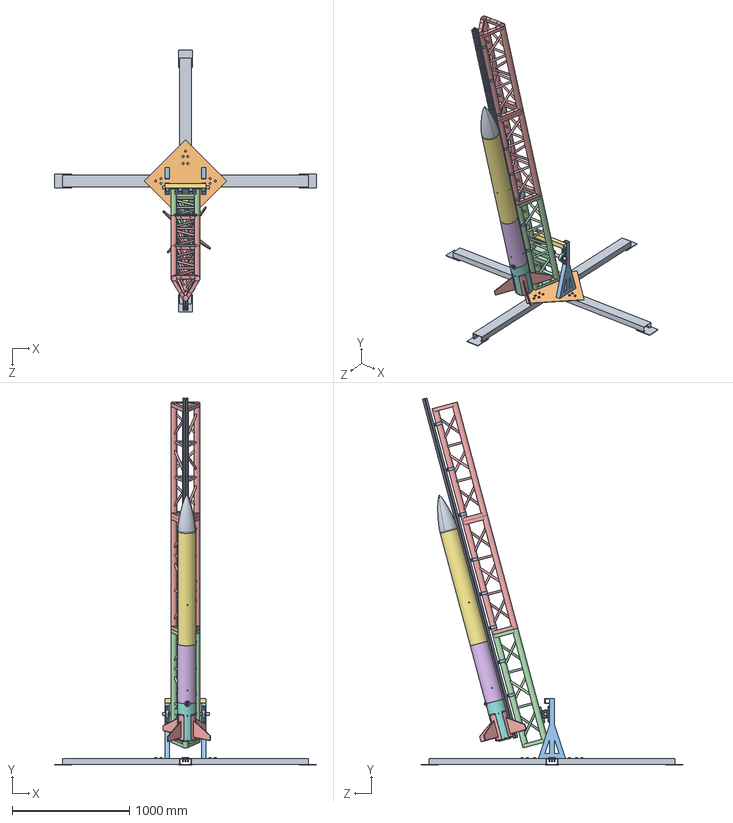
[picture p332: CAD file, 2020-12-04]
Estrutura/Sistema de Abastecimento/CADs/Montagem_Diogo.SLDASM
2240.0 x 3135.2 x 2240.0 mm
Pernas_Base_v2_Valor predeterminado x 4
Base_v2_Valor predeterminado
Haste_Valor predeterminado x 2
Treliça-v3-mod
Treliça-v2-mod x 2
Pino_1_pol_Valor predeterminado
Trava_Valor predeterminado
ucp205 x 4
perfil_40x40_Valor predeterminado_Como usinado_
Parafuso_M_10_30mm_pols_91310A630 x 16
abraçadeira_2in x 9
porca_martelo_M6
pescoco_valvula_26102020_1025_Valor predeterminado
tubo2_17022020_1025_Valor predeterminado
tubo3_17022020_1025_Valor predeterminado
tubo1_17022020_1025_Valor predeterminado
DDLSII_Coifa_VonKarman_v1_Valor predeterminado
DIN 912 - M6 x 1 x 25_Valor predeterminado x 8
DIN 7991 - M5 x 0.8 x 10_Valor predeterminado x 16
DIN 912 - M5 x 0.8 x 10_Valor predeterminado x 8
DDLSII_Aleta_Trapeizodal_v1_Valor predeterminado x 4
Paraquedas_Valor predeterminado
DIN 7991 - M5 x 0.8 x 20_Valor predeterminado x 4
90592A022_STEEL HEX NUT_90592A022
Parafuso M6_Valor predeterminado x 32
Casing (1)_Valor predeterminado
injetor_Valor predeterminado
placa_injetora_Valor predeterminado
Grao_DDLS_2_Peca_Modificada_8_1_Valor predeterminado
Coupler_DDLS_2_Peca_Modificada_8_1_Valor predeterminado
Tubeira_DDLS_2_Peca_Modificada_8_1_Valor predeterminado
T-1.2_3.4_1.2_NPT_MACHO_Valor predeterminado
TampaInferior_Valor predeterminado
Tubo_Valor predeterminado
TampaSuperior_Valor predeterminado
valve_solenoide_Valor predeterminado
connection_Valor predeterminado
tuboexterno_Valor predeterminado
tubointerno_Valor predeterminado
Engate-1.2-NPT_Valor predeterminado
98689A116_ METRIC GENERAL PURPOSE WASHERS_98689A116
4843T140_GALVANIZED STEEL EYEBOLT - FOR LIFTING_4843T14
bk_coifa_v3_26102020_2137_Valor predeterminado
bk_tanque_conexão_24022020_1714_Valor predeterminado x 2
bk_motor_V2_16022020_2057_Valor predeterminado x 2
longarina_v2_19032020_1534_Valor predeterminado x 4
bk_tanque_v2_17022020_1034_Valor predeterminado
bk_recuperacao_v3_b__06042020_1104_Valor predeterminado
bk_tanque_conexaov2_24022020_1910 - Copia_Valor predeterminado
payload_Valor predeterminado
canister_Valor predeterminado
bk_tanque_superior_v03_Valor predeterminado
bk_eletronica_inferior_v3_06042020_1056_Valor predeterminado
chapa_eletronica_v3_06042020_2311_Valor predeterminado
o-ring_150_2_Valor predeterminado
u_bolt_v1_17022020_1149_Valor predeterminado
bk_eletronica_superior_v3_06042020_1056_Valor predeterminado
95462A515_GRADE 5 STEEL HEX NUT_95462A515 x 4
