Ground-Station/Documentation/Estrutura/Sistema de Abastecimento/CADs/Assembly_valvula.SLDASM

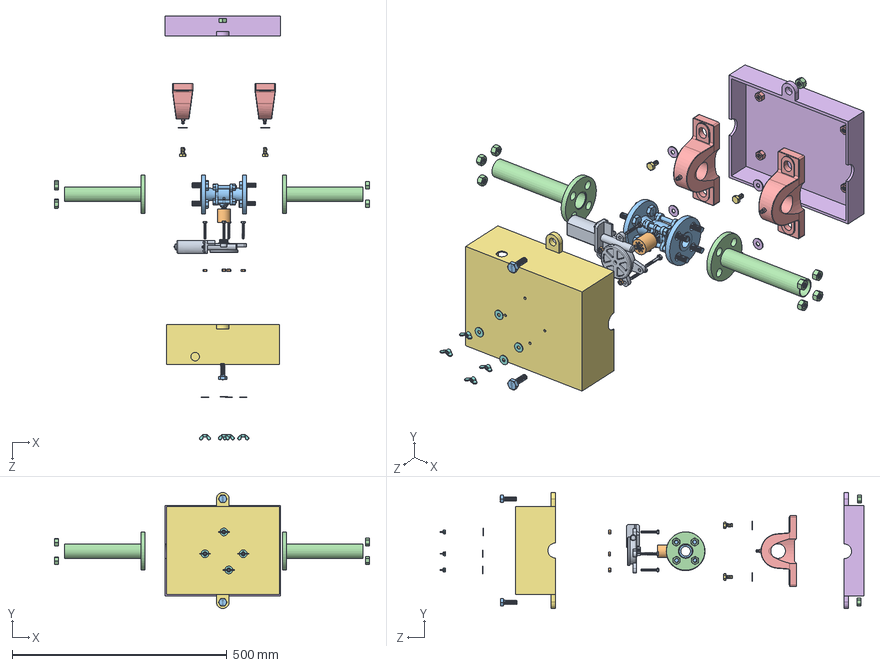
[picture p333: CAD file, 2020-12-04]
Estrutura/Sistema de Abastecimento/CADs/Assembly_valvula.SLDASM
734.1 x 270.0 x 986.8 mm
Motor mabuchi LC-578VA
pino
Ball valve 0.5 inch flange S150
tubo x 2
mancal x 2
case_mancal
case_motor
Wing Nut x 4
parafuso_motor x 4
porca_parafuso_motor x 4
parafuso_case x 11
porca_parafuso_case x 10
porca_parafuso_flange x 4
Rondella M4 x 4
parafuso_mancal x 4
Ruela_borboleta x 4
M 6 LN BOLT
