Ground-Station/Documentation/Estrutura/PC3/CADs/Maleta de Abastecimento/Motor/Motor mabuchi LC-578VA.STEP

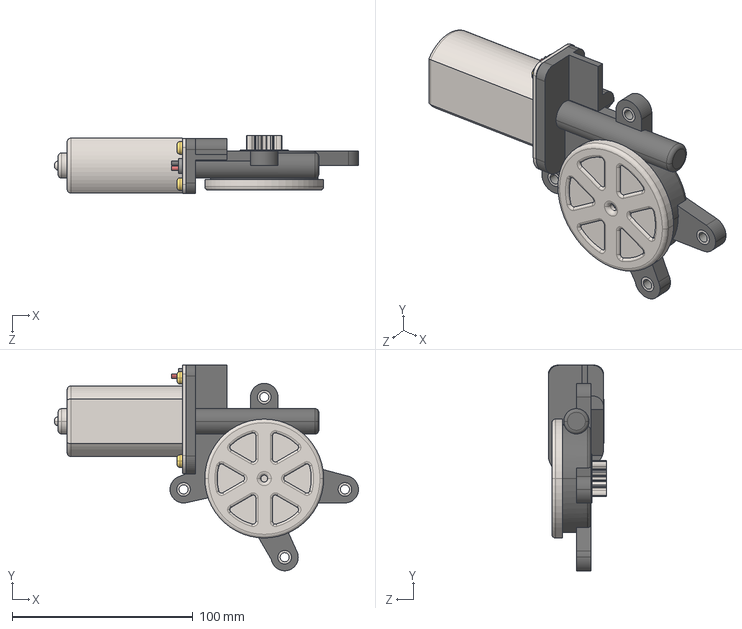
[picture p334: CAD file, 2020-12-04]
Estrutura/PC3/CADs/Maleta de Abastecimento/Motor/Motor mabuchi LC-578VA.STEP
168.1 x 113.7 x 32.2 mm
