Ground-Station/Documentation/Estrutura/Sistema de Abastecimento/CADs/parafuso_case.SLDPRT

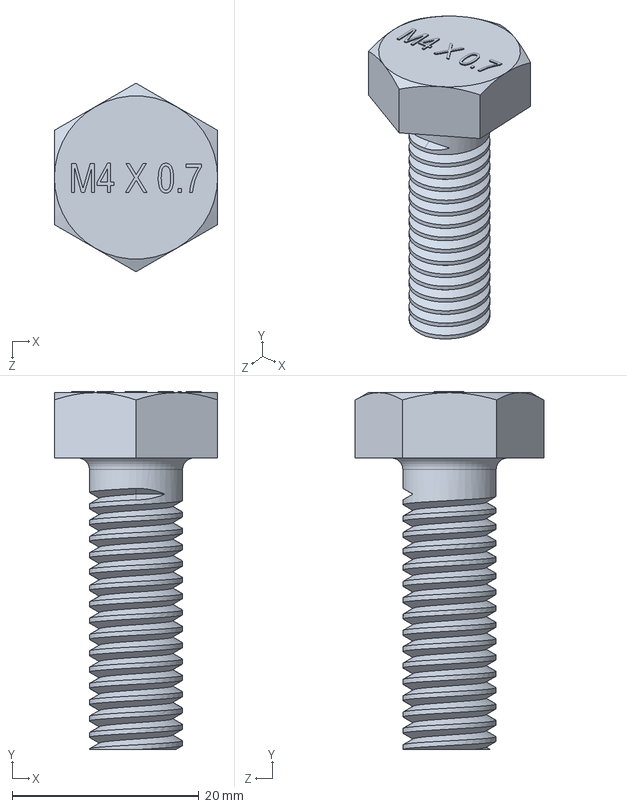
[picture p336: CAD file, 2020-12-04]
Estrutura/Sistema de Abastecimento/CADs/parafuso_case.SLDPRT
17.5 x 38.4 x 20.2 mm
