Ground-Station/Documentation/Estrutura/Sistema de Abastecimento/CADs/Tanque/Bouteille Nitro Corps.SLDPRT

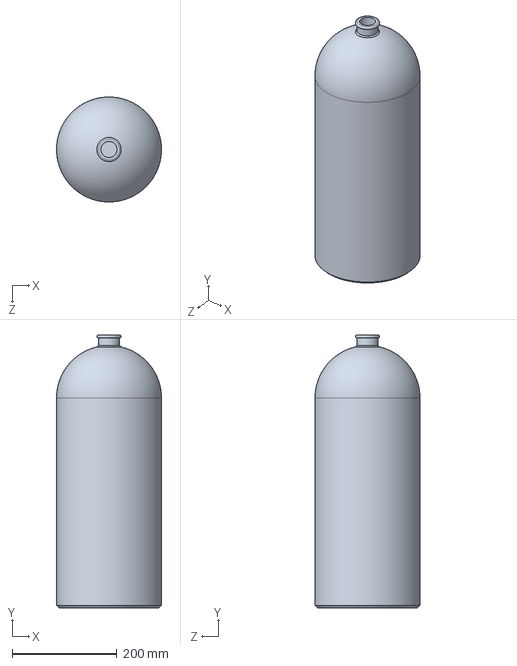
[picture p337: CAD file, 2020-12-04]
Estrutura/Sistema de Abastecimento/CADs/Tanque/Bouteille Nitro Corps.SLDPRT
200.0 x 520.0 x 200.0 mm
