Ground-Station/Documentation/Estrutura/Sistema de Abastecimento/CADs/Rondella M4.SLDPRT

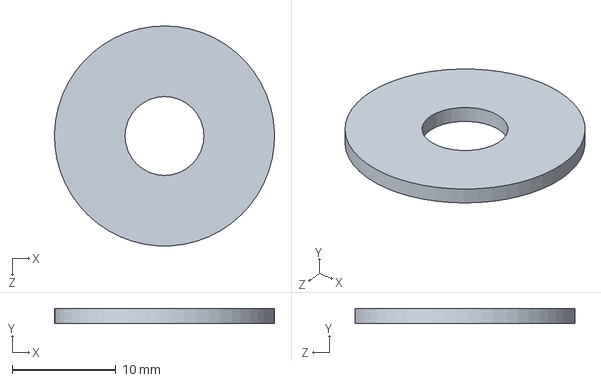
[picture p338: CAD file, 2020-12-04]
Estrutura/Sistema de Abastecimento/CADs/Rondella M4.SLDPRT
21.2 x 1.41 x 21.2 mm
