Ground-Station/Documentation/Estrutura/Sistema de Abastecimento/CADs/Tanque/Bouchon.SLDPRT

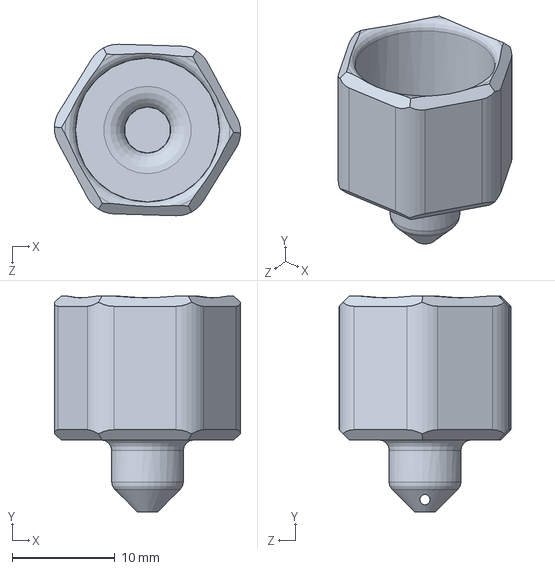
[picture p339: CAD file, 2020-12-04]
Estrutura/Sistema de Abastecimento/CADs/Tanque/Bouchon.SLDPRT
18.1 x 21.0 x 16.7 mm
