Ground-Station/Documentation/Estrutura/Sistema de Abastecimento/CADs/Tanque/Vanne NOS.SLDPRT

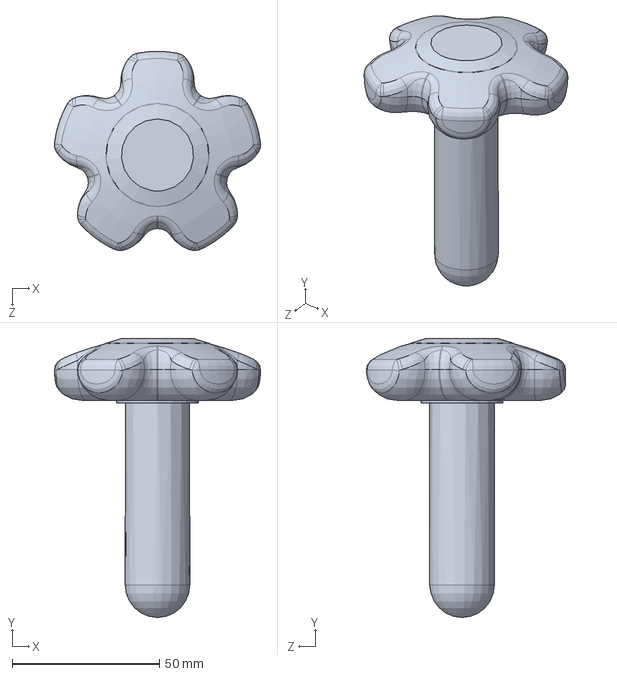
[picture p340: CAD file, 2020-12-04]
Estrutura/Sistema de Abastecimento/CADs/Tanque/Vanne NOS.SLDPRT
70.1 x 94.8 x 67.7 mm
