Ground-Station/Documentation/Estrutura/Sistema de Abastecimento/CADs/Ruela_borboleta.SLDPRT

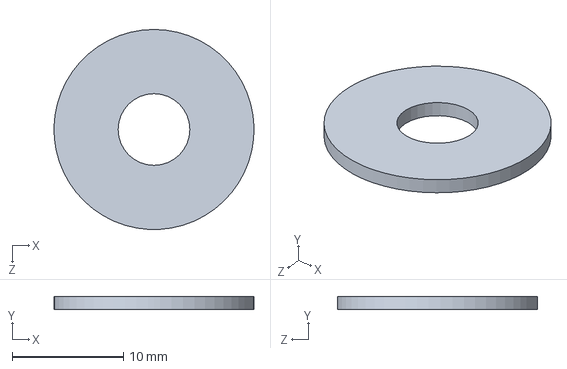
[picture p341: CAD file, 2020-12-04]
Estrutura/Sistema de Abastecimento/CADs/Ruela_borboleta.SLDPRT
18.0 x 1.20 x 18.0 mm
