Ground-Station/Documentation/Estrutura/Sistema de Abastecimento/CADs/Tanque/Embout.SLDPRT

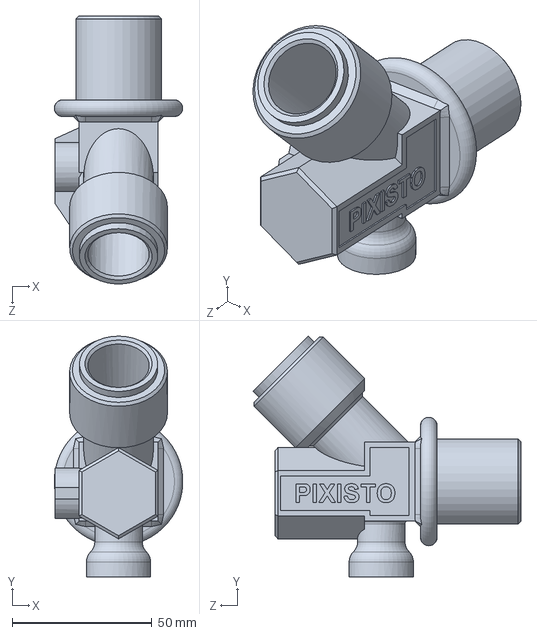
[picture p342: CAD file, 2020-12-04]
Estrutura/Sistema de Abastecimento/CADs/Tanque/Embout.SLDPRT
46.0 x 86.2 x 95.9 mm
