Ground-Station/Documentation/Estrutura/Sistema de Abastecimento/CADs/T-Connector.SLDPRT

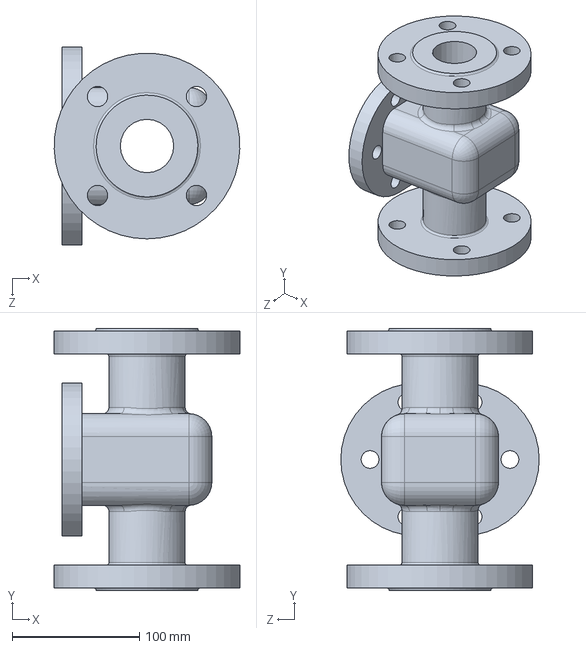
[picture p343: CAD file, 2020-12-04]
Estrutura/Sistema de Abastecimento/CADs/T-Connector.SLDPRT
145.9 x 206.0 x 156.0 mm
