Ground-Station/Documentation/Estrutura/Sistema de Abastecimento/CADs/Tanque/Raccord.SLDPRT

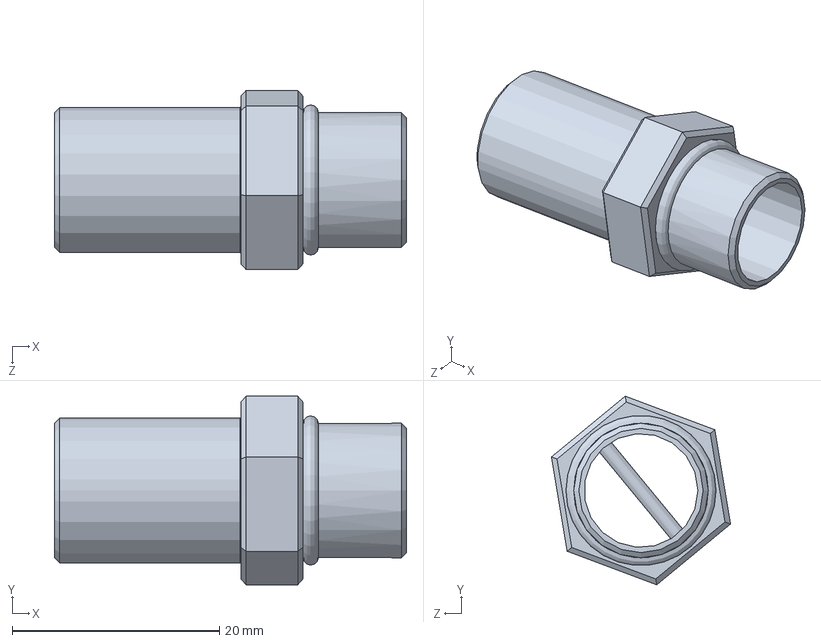
[picture p344: CAD file, 2020-12-04]
Estrutura/Sistema de Abastecimento/CADs/Tanque/Raccord.SLDPRT
34.0 x 18.2 x 17.3 mm
