Ground-Station/Documentation/Estrutura/Sistema de Abastecimento/CADs/parafuso_mancal.SLDPRT

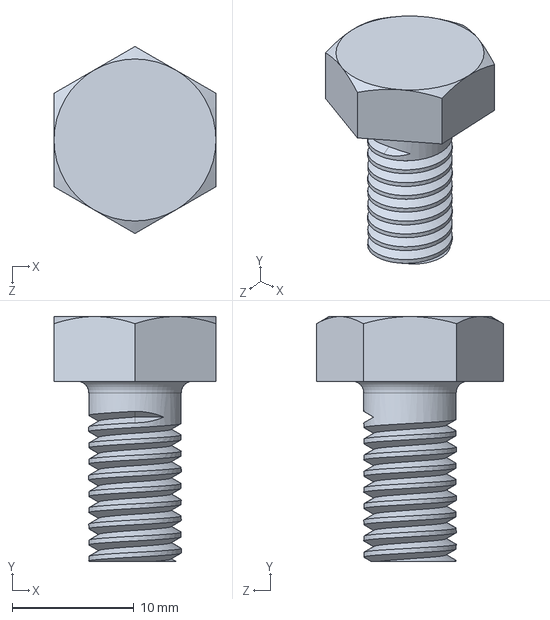
[picture p345: CAD file, 2020-12-04]
Estrutura/Sistema de Abastecimento/CADs/parafuso_mancal.SLDPRT
13.3 x 20.1 x 15.4 mm
