Ground-Station/Documentation/Estrutura/Sistema de Abastecimento/CADs/Tanque/NOS liquide.SLDPRT

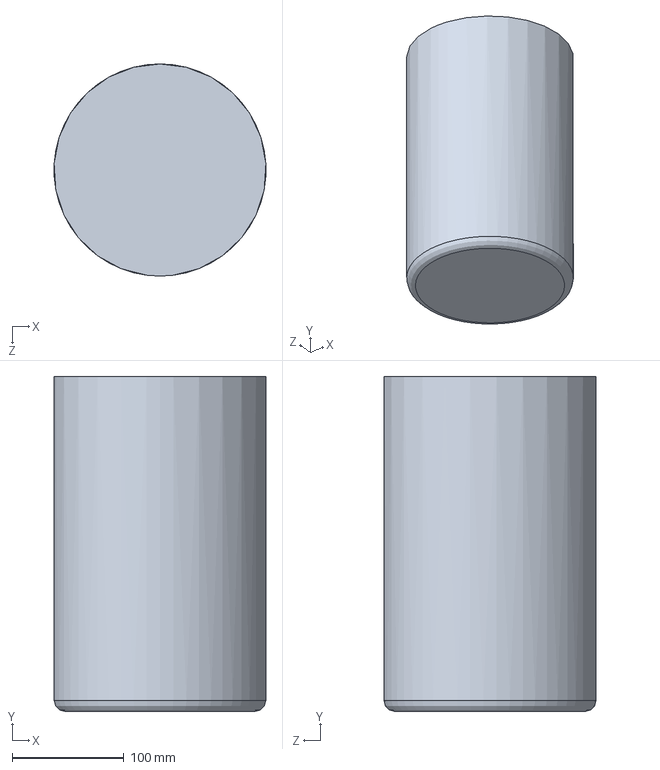
[picture p346: CAD file, 2020-12-04]
Estrutura/Sistema de Abastecimento/CADs/Tanque/NOS liquide.SLDPRT
189.6 x 300.0 x 190.0 mm
