Ground-Station/Documentation/Estrutura/Sistema de Abastecimento/CADs/Ball valve 0.5 inch flange S150.SLDPRT

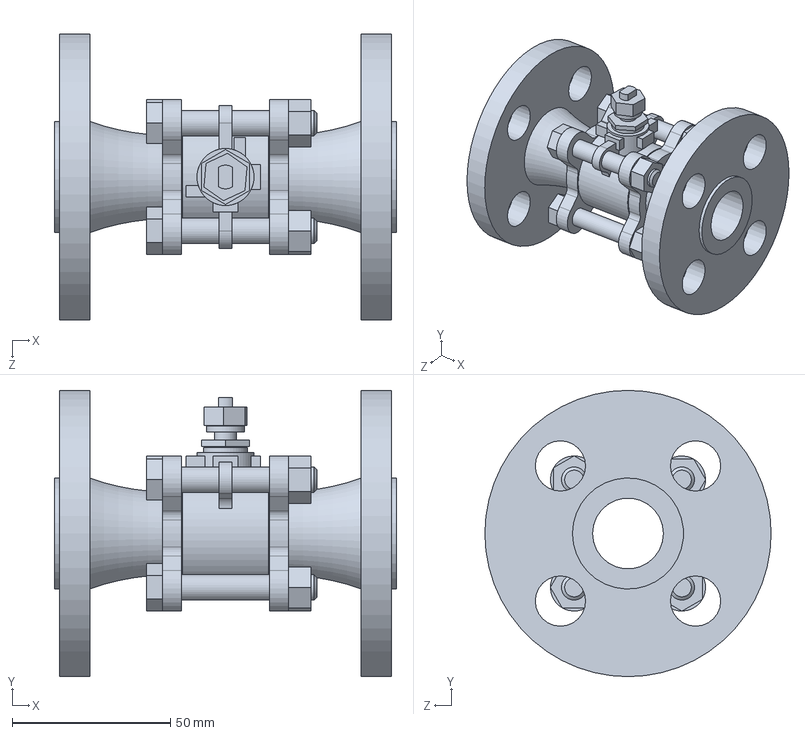
[picture p347: CAD file, 2020-12-04]
Estrutura/Sistema de Abastecimento/CADs/Ball valve 0.5 inch flange S150.SLDPRT
108.0 x 90.4 x 90.4 mm
