Ground-Station/Documentation/Estrutura/Sistema de Abastecimento/CADs/Tanque/Joint.SLDPRT

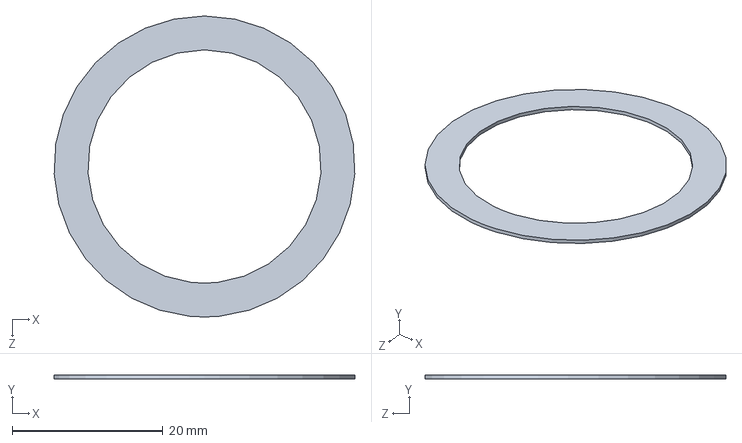
[picture p348: CAD file, 2020-12-04]
Estrutura/Sistema de Abastecimento/CADs/Tanque/Joint.SLDPRT
39.9 x 0.5 x 40.0 mm
