Ground-Station/Documentation/Estrutura/Sistema de Abastecimento/CADs/pino.SLDPRT

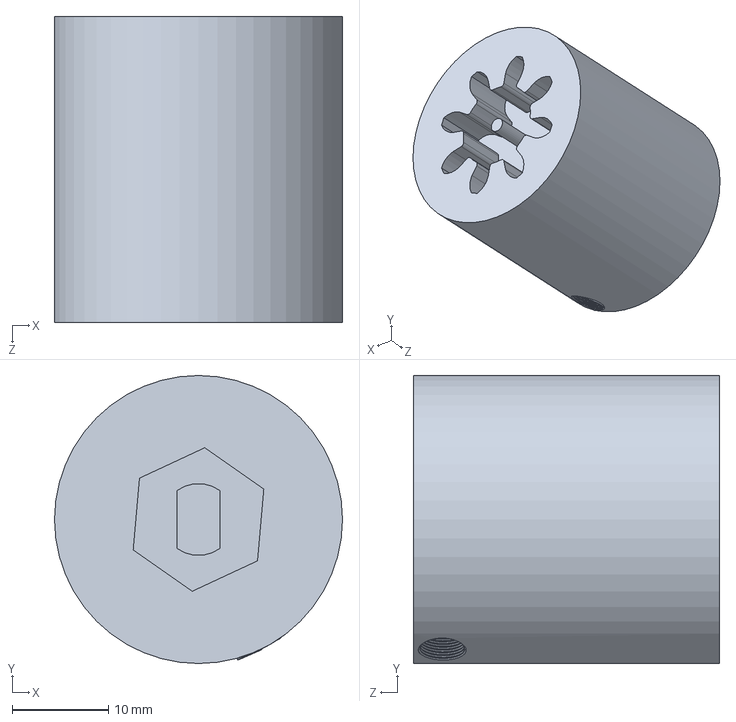
[picture p349: CAD file, 2020-12-04]
Estrutura/Sistema de Abastecimento/CADs/pino.SLDPRT
30.0 x 30.0 x 31.9 mm
