Ground-Station/Documentation/Estrutura/Sistema de Abastecimento/CADs/parafuso_flage.SLDPRT

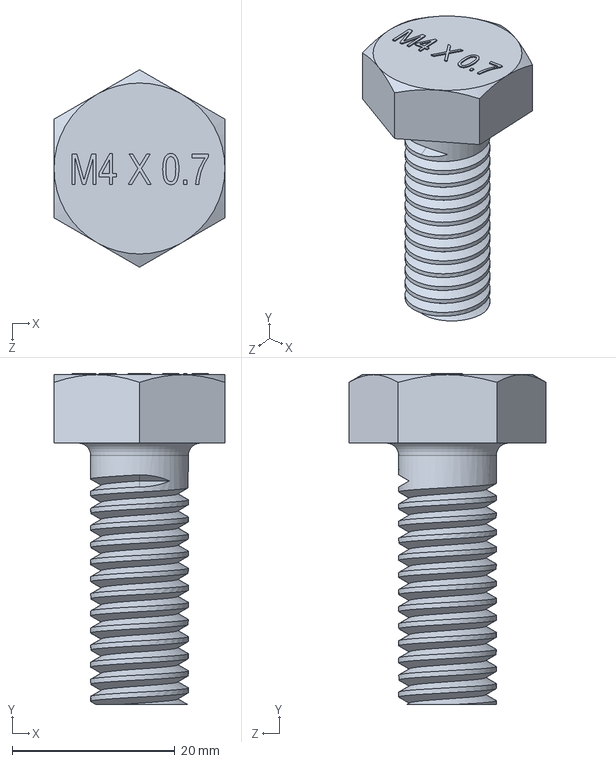
[picture p350: CAD file, 2020-12-04]
Estrutura/Sistema de Abastecimento/CADs/parafuso_flage.SLDPRT
21.0 x 40.7 x 24.2 mm
