Ground-Station/Documentation/Estrutura/Sistema de Abastecimento/CADs/porca_parafuso_motor.SLDPRT

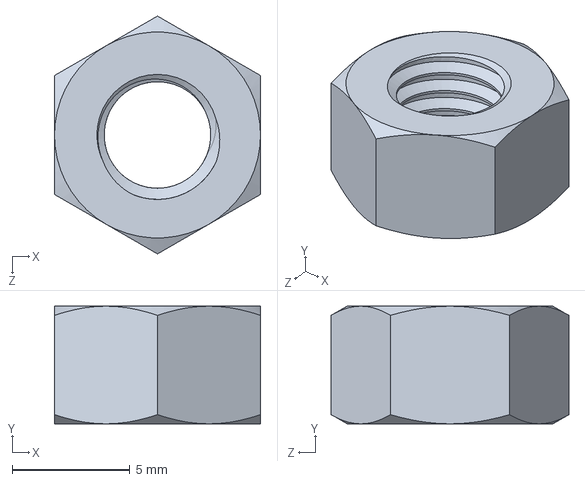
[picture p351: CAD file, 2020-12-04]
Estrutura/Sistema de Abastecimento/CADs/porca_parafuso_motor.SLDPRT
8.75 x 5.00 x 10.1 mm
