Ground-Station/Documentation/Estrutura/Sistema de Abastecimento/CADs/porca_parafuso_flange.SLDPRT

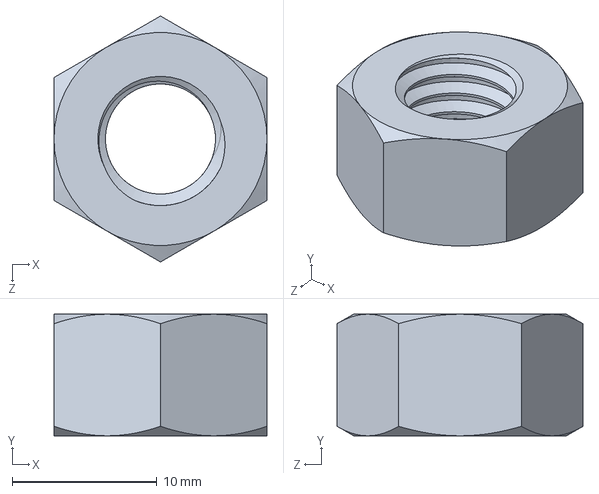
[picture p352: CAD file, 2020-12-04]
Estrutura/Sistema de Abastecimento/CADs/porca_parafuso_flange.SLDPRT
14.7 x 8.40 x 17.0 mm
