Ground-Station/Documentation/Estrutura/Sistema de Abastecimento/CADs/parafuso_motor.SLDPRT

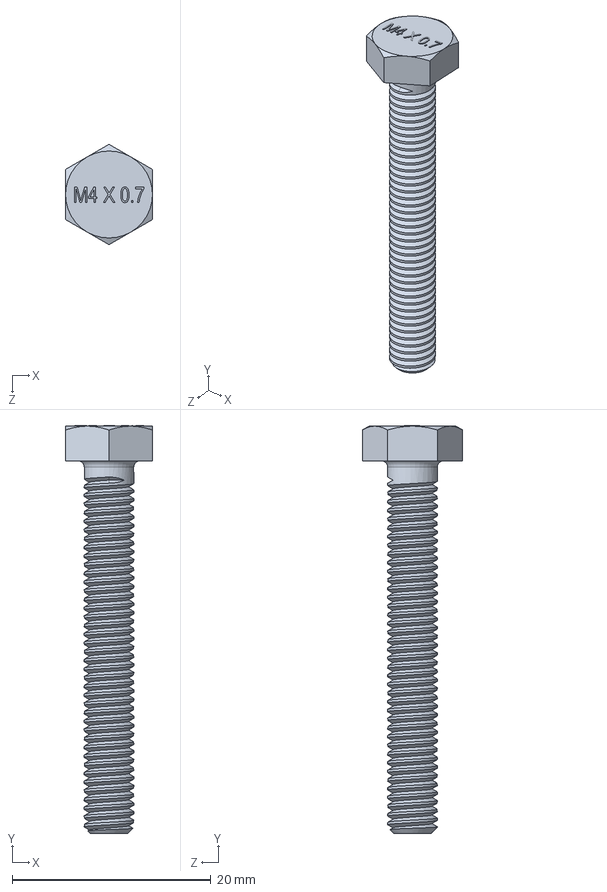
[picture p353: CAD file, 2020-12-04]
Estrutura/Sistema de Abastecimento/CADs/parafuso_motor.SLDPRT
8.75 x 41.1 x 10.1 mm
