Ground-Station/Documentation/Estrutura/Sistema de Abastecimento/CADs/case_motor.SLDPRT

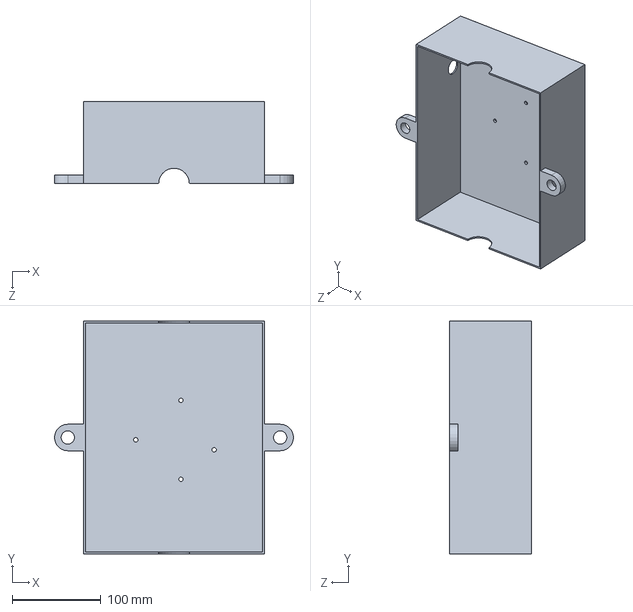
[picture p354: CAD file, 2020-12-04]
Estrutura/Sistema de Abastecimento/CADs/case_motor.SLDPRT
270.0 x 262.9 x 93.0 mm
