Ground-Station/Documentation/Estrutura/Sistema de Abastecimento/CADs/mancal.SLDPRT

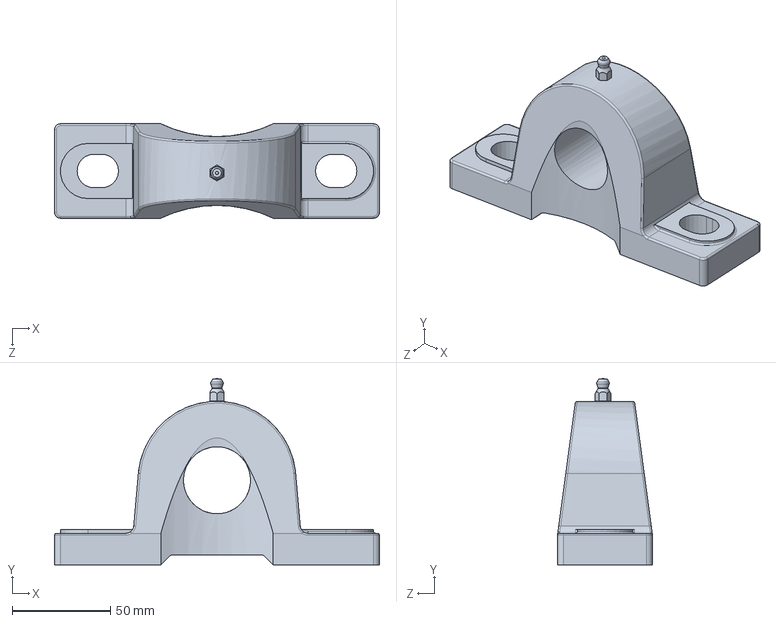
[picture p355: CAD file, 2020-12-04]
Estrutura/Sistema de Abastecimento/CADs/mancal.SLDPRT
165.0 x 94.7 x 48.0 mm
