Ground-Station/Documentation/Estrutura/Sistema de Abastecimento/CADs/porca_parafuso_case.SLDPRT

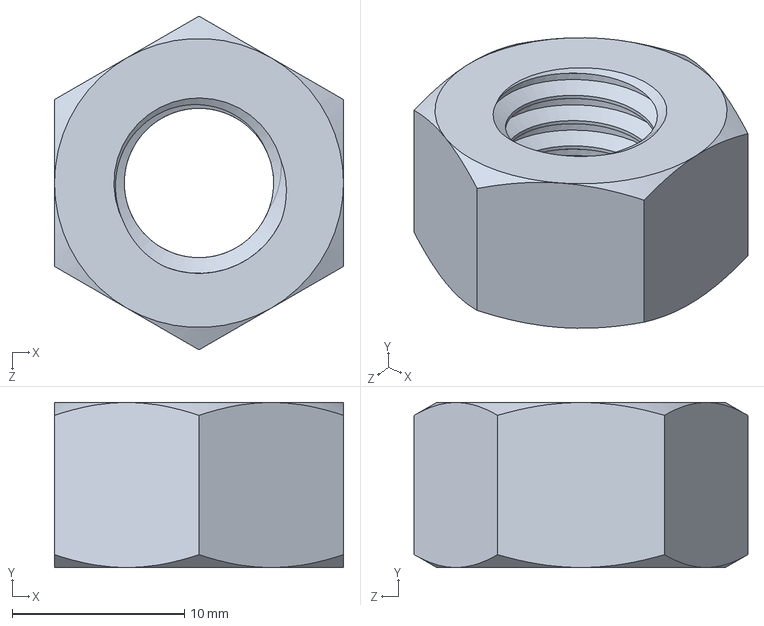
[picture p356: CAD file, 2020-12-04]
Estrutura/Sistema de Abastecimento/CADs/porca_parafuso_case.SLDPRT
16.8 x 9.59 x 19.4 mm
