Ground-Station/Documentation/Estrutura/Sistema de Abastecimento/CADs/Nickel Tee 0.5.SLDPRT

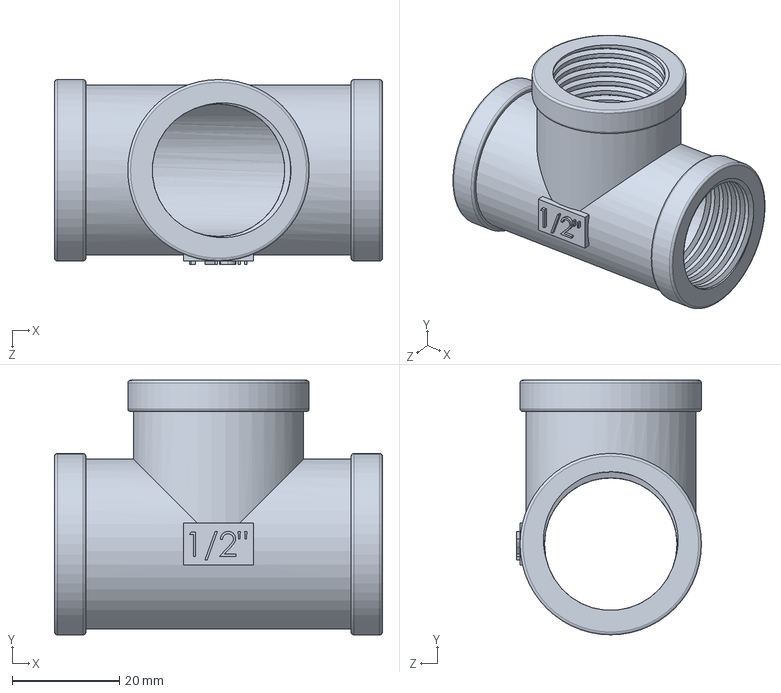
[picture p357: CAD file, 2020-12-04]
Estrutura/Sistema de Abastecimento/CADs/Nickel Tee 0.5.SLDPRT
61.1 x 47.5 x 34.5 mm
