Ground-Station/Documentation/Estrutura/Sistema de Abastecimento/CADs/mang.SLDPRT

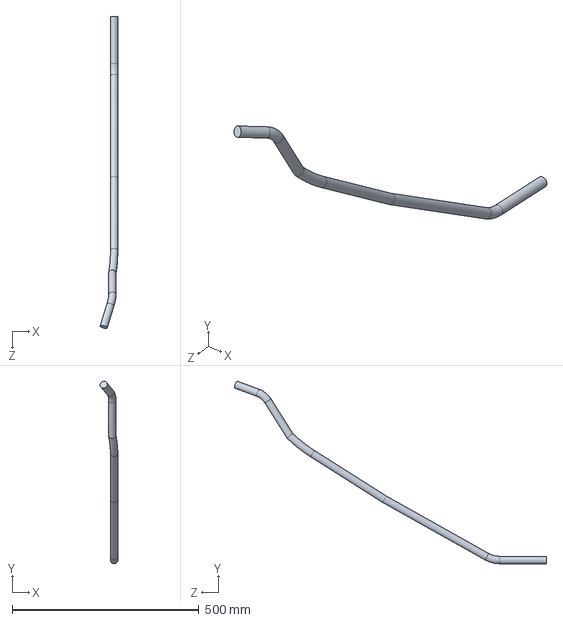
[picture p358: CAD file, 2020-12-04]
Estrutura/Sistema de Abastecimento/CADs/mang.SLDPRT
47.5 x 488.9 x 835.4 mm
