Ground-Station/Documentation/Estrutura/Sistema de Abastecimento/CADs/case_mancal.SLDPRT

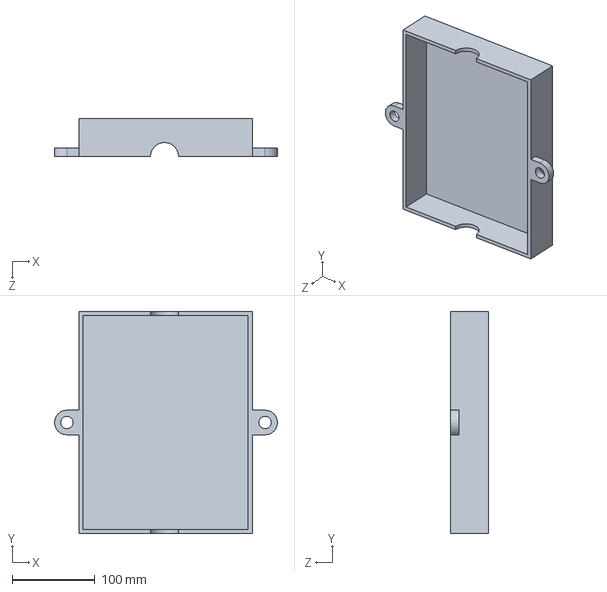
[picture p359: CAD file, 2020-12-04]
Estrutura/Sistema de Abastecimento/CADs/case_mancal.SLDPRT
270.0 x 268.9 x 46.0 mm
