Ground-Station/Documentation/Estrutura/Sistema de Abastecimento/CADs/tubo.SLDPRT

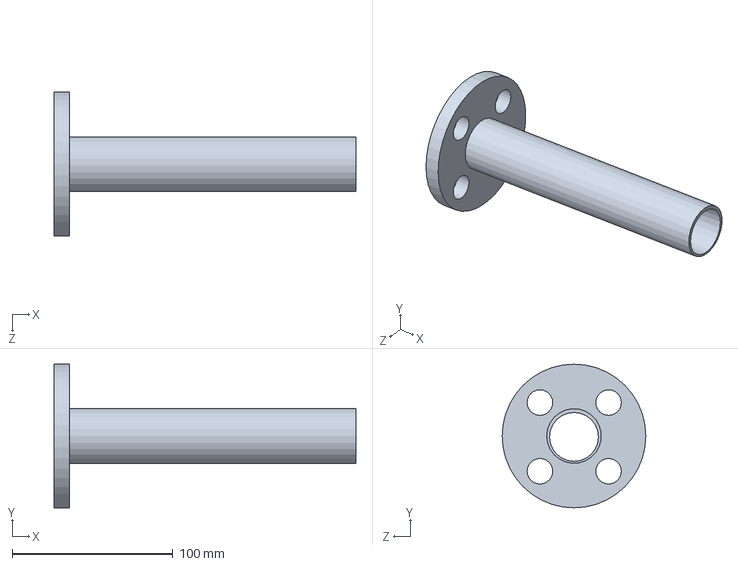
[picture p360: CAD file, 2020-12-04]
Estrutura/Sistema de Abastecimento/CADs/tubo.SLDPRT
187.6 x 89.3 x 89.3 mm
