Ground-Station/Documentation/(list of files, cad)

Other CAD files:
Estrutura/Sistema de Abastecimento/CADs/Motor mabuchi LC-578VA.SLDPRT
Estrutura/PC1/CADs/Alca.CATPart
Estrutura/PC1/CADs/Base.CATPart
Estrutura/PC1/CADs/BotoesEmergencia.CATPart
Estrutura/PC1/CADs/BotoesSwitch.CATPart
Estrutura/PC1/CADs/DobradicaBase.CATPart
Estrutura/PC1/CADs/DobradicaTampo.CATPart
Estrutura/PC1/CADs/FundoFalso.CATPart
Estrutura/PC1/CADs/GroundStation.CATProduct
Estrutura/PC1/CADs/PotecaoImpacto.CATPart
Estrutura/PC1/CADs/PotecaoInferior.CATPart
Estrutura/PC1/CADs/PotecaoSuperior.CATPart
Estrutura/PC1/CADs/Presilha.CATPart
Estrutura/PC1/CADs/ProtecaoBotao.CATPart
Estrutura/PC1/CADs/Tampo.CATPart
Estrutura/PC1/CADs/TampoD.CATPart
Estrutura/PC1/CADs/Teclado.CATPart
Estrutura/PC1/CADs/TelaBateria.CATPart
Estrutura/PC3/CADs/Maleta GCS/Alca.CATPart
Estrutura/PC3/CADs/Maleta GCS/BAntena.CATPart
Estrutura/PC3/CADs/Maleta GCS/Base femea.CATPart
Estrutura/PC3/CADs/Maleta GCS/Base macho.CATPart
Estrutura/PC3/CADs/Maleta GCS/BaseBotao.CATPart
Estrutura/PC3/CADs/Maleta GCS/Bateria.CATPart
Estrutura/PC3/CADs/Maleta GCS/Botao.CATPart
Estrutura/PC3/CADs/Maleta GCS/Controlador/Board v5.CATPart
Estrutura/PC3/CADs/Maleta GCS/Controlador/CAP0603 v1 (1).CATPart
Estrutura/PC3/CADs/Maleta GCS/Controlador/CAP0603 v1.CATPart
Estrutura/PC3/CADs/Maleta GCS/Controlador/CAPSMD100-50 v1.CATPart
Estrutura/PC3/CADs/Maleta GCS/Controlador/CAPSMD220-35 v1.CATPart
Estrutura/PC3/CADs/Maleta GCS/Controlador/CDRH127_470M v1.CATPart
Estrutura/PC3/CADs/Maleta GCS/Controlador/DO-214AC-DIOM5127X23N v1.CATPart
Estrutura/PC3/CADs/Maleta GCS/Controlador/LM2596 DC-DC StepDown Converter v1.CATProduct
Estrutura/PC3/CADs/Maleta GCS/Controlador/LM2596 DC-DC StepDown Converter.CATProduct
Estrutura/PC3/CADs/Maleta GCS/Controlador/Part20.CATPart
Estrutura/PC3/CADs/Maleta GCS/Controlador/Part21.CATPart
Estrutura/PC3/CADs/Maleta GCS/Controlador/Part22.CATPart
Estrutura/PC3/CADs/Maleta GCS/Controlador/Part23.CATPart
Estrutura/PC3/CADs/Maleta GCS/Controlador/Part24.CATPart
Estrutura/PC3/CADs/Maleta GCS/Controlador/Part25.CATPart
Estrutura/PC3/CADs/Maleta GCS/Controlador/Part26.CATPart
Estrutura/PC3/CADs/Maleta GCS/Controlador/Part27.CATPart
Estrutura/PC3/CADs/Maleta GCS/Controlador/Part28.CATPart
Estrutura/PC3/CADs/Maleta GCS/Controlador/Part29.CATPart
Estrutura/PC3/CADs/Maleta GCS/Controlador/Part31.CATPart
Estrutura/PC3/CADs/Maleta GCS/Controlador/Resistor 0603 v1 (1).CATPart
Estrutura/PC3/CADs/Maleta GCS/Controlador/Resistor 0603 v1.CATPart
Estrutura/PC3/CADs/Maleta GCS/Controlador/TO-263BA v2.CATPart
Estrutura/PC3/CADs/Maleta GCS/Controlador/Trimpot 3296W v1.CATPart
Estrutura/PC3/CADs/Maleta GCS/Controlador/_NPart#70316.CATPart
Estrutura/PC3/CADs/Maleta GCS/Controlador/_NPart1.CATPart
Estrutura/PC3/CADs/Maleta GCS/DobradicaBase.CATPart
Estrutura/PC3/CADs/Maleta GCS/DobradicaTampo.CATPart
Estrutura/PC3/CADs/Maleta GCS/FonteTela.CATPart
Estrutura/PC3/CADs/Maleta GCS/Jetson/032-0256-000_1.CATPart
Estrutura/PC3/CADs/Maleta GCS/Jetson/0402_H040.CATPart
Estrutura/PC3/CADs/Maleta GCS/Jetson/0402_H060.CATPart
Estrutura/PC3/CADs/Maleta GCS/Jetson/041-0092-000_1.CATPart
Estrutura/PC3/CADs/Maleta GCS/Jetson/060-0002-000_1.CATPart
Estrutura/PC3/CADs/Maleta GCS/Jetson/0603_H060.CATPart
Estrutura/PC3/CADs/Maleta GCS/Jetson/0603_H100.CATPart
Estrutura/PC3/CADs/Maleta GCS/Jetson/064-0375-000_2.CATPart
Estrutura/PC3/CADs/Maleta GCS/Jetson/064-0377-000_2.CATPart
Estrutura/PC3/CADs/Maleta GCS/Jetson/064-0400-000_1.CATPart
Estrutura/PC3/CADs/Maleta GCS/Jetson/074-0102-000_4.CATPart
Estrutura/PC3/CADs/Maleta GCS/Jetson/074-0117-000_2.CATPart
Estrutura/PC3/CADs/Maleta GCS/Jetson/074-0216-000_2.CATPart
Estrutura/PC3/CADs/Maleta GCS/Jetson/074-0221-000_3.CATPart
Estrutura/PC3/CADs/Maleta GCS/Jetson/074-0223-000_2.CATPart
Estrutura/PC3/CADs/Maleta GCS/Jetson/080-0051-000_3.CATPart
Estrutura/PC3/CADs/Maleta GCS/Jetson/080-1243-000_3.CATPart
Estrutura/PC3/CADs/Maleta GCS/Jetson/080-1368-000_1.CATPart
Estrutura/PC3/CADs/Maleta GCS/Jetson/080-1656-000_3.CATPart
Estrutura/PC3/CADs/Maleta GCS/Jetson/080-1669-000_2.CATPart
Estrutura/PC3/CADs/Maleta GCS/Jetson/0805_H140.CATPart
Estrutura/PC3/CADs/Maleta GCS/Jetson/0805_H150.CATPart
Estrutura/PC3/CADs/Maleta GCS/Jetson/085-0328-000_2.CATPart
Estrutura/PC3/CADs/Maleta GCS/Jetson/090-0096-000_1.CATPart
Estrutura/PC3/CADs/Maleta GCS/Jetson/090-0172-000_1.CATPart
Estrutura/PC3/CADs/Maleta GCS/Jetson/090-0231-000_1.CATPart
Estrutura/PC3/CADs/Maleta GCS/Jetson/090-0233-000_1.CATPart
Estrutura/PC3/CADs/Maleta GCS/Jetson/090-0243-000_1.CATPart
Estrutura/PC3/CADs/Maleta GCS/Jetson/090-0309-000_1.CATPart
Estrutura/PC3/CADs/Maleta GCS/Jetson/091-0022-000_1.CATPart
Estrutura/PC3/CADs/Maleta GCS/Jetson/091-0023-000_1.CATPart
Estrutura/PC3/CADs/Maleta GCS/Jetson/092-0073-000_1.CATPart
Estrutura/PC3/CADs/Maleta GCS/Jetson/102-0037-000_1.CATPart
Estrutura/PC3/CADs/Maleta GCS/Jetson/102-0066-000_2.CATPart
Estrutura/PC3/CADs/Maleta GCS/Jetson/115-0138-000_1.CATPart
Estrutura/PC3/CADs/Maleta GCS/Jetson/115-0742-000_2.CATPart
Estrutura/PC3/CADs/Maleta GCS/Jetson/115-0836-000_1.CATPart
Estrutura/PC3/CADs/Maleta GCS/Jetson/115-1232-000_2.CATPart
Estrutura/PC3/CADs/Maleta GCS/Jetson/115-1821-000_1.CATPart
Estrutura/PC3/CADs/Maleta GCS/Jetson/115-1921-000_3.CATPart
Estrutura/PC3/CADs/Maleta GCS/Jetson/115-2177-000_2.CATPart
Estrutura/PC3/CADs/Maleta GCS/Jetson/115-2628-000_3.CATPart
Estrutura/PC3/CADs/Maleta GCS/Jetson/1206_H190.CATPart
Estrutura/PC3/CADs/Maleta GCS/Jetson/131-0832-000_2.CATPart
Estrutura/PC3/CADs/Maleta GCS/Jetson/142-13449-1000-A02.CATPart
Estrutura/PC3/CADs/Maleta GCS/Jetson/142-63448-1GEN_A00.CATPart
Estrutura/PC3/CADs/Maleta GCS/Jetson/155-0576-000.CATPart
Estrutura/PC3/CADs/Maleta GCS/Jetson/170-0285-000_1.CATPart
Estrutura/PC3/CADs/Maleta GCS/Jetson/174-0159-000_2.CATPart
Estrutura/PC3/CADs/Maleta GCS/Jetson/2016MM_H100.CATPart
Estrutura/PC3/CADs/Maleta GCS/Jetson/300-0402-000_1.CATPart
Estrutura/PC3/CADs/Maleta GCS/Jetson/300-0560-000_1.CATPart
Estrutura/PC3/CADs/Maleta GCS/Jetson/300-0868-000_3.CATPart
Estrutura/PC3/CADs/Maleta GCS/Jetson/300-0869-000_3.CATPart
Estrutura/PC3/CADs/Maleta GCS/Jetson/315-0620-000_1.CATPart
Estrutura/PC3/CADs/Maleta GCS/Jetson/315-1062-000_1.CATPart
Estrutura/PC3/CADs/Maleta GCS/Jetson/315-1109-000_1.CATPart
Estrutura/PC3/CADs/Maleta GCS/Jetson/316-0697-000_1.CATPart
Estrutura/PC3/CADs/Maleta GCS/Jetson/IND_SMD_0402_H060.CATPart
Estrutura/PC3/CADs/Maleta GCS/Jetson/Jetson nano_fixed.CATProduct
Estrutura/PC3/CADs/Maleta GCS/LoRa/ESP32 Heltec WIFI.CATPart
Estrutura/PC3/CADs/Maleta GCS/Maleta2.CATProduct
Estrutura/PC3/CADs/Maleta GCS/Moldura BAse.CATPart
Estrutura/PC3/CADs/Maleta GCS/MolduraTopo.CATPart
Estrutura/PC3/CADs/Maleta GCS/Negativo.CATPart
Estrutura/PC3/CADs/Maleta GCS/PCI eletronica.CATPart
Estrutura/PC3/CADs/Maleta GCS/Part1.CATPart
Estrutura/PC3/CADs/Maleta GCS/Plug.CATPart
Estrutura/PC3/CADs/Maleta GCS/Positivo.CATPart
Estrutura/PC3/CADs/Maleta GCS/ProtcaoTampo.CATPart
Estrutura/PC3/CADs/Maleta GCS/ProtecaoBase.CATPart
Estrutura/PC3/CADs/Maleta GCS/Tampo.CATPart
Estrutura/PC3/CADs/Maleta GCS/Teclado.CATPart
Estrutura/PC3/CADs/Maleta GCS/Tela.CATPart
Estrutura/PC3/CADs/Maleta GCS/Trava.CATPart
Estrutura/PC3/CADs/Maleta GCS/base.CATPart
Estrutura/PC3/CADs/Maleta de Abastecimento/Alca1.CATPart
Estrutura/PC3/CADs/Maleta de Abastecimento/Alca2.CATPart
Estrutura/PC3/CADs/Maleta de Abastecimento/BAse.CATPart
Estrutura/PC3/CADs/Maleta de Abastecimento/Base Botao IO.CATPart
Estrutura/PC3/CADs/Maleta de Abastecimento/Bateria.CATPart
Estrutura/PC3/CADs/Maleta de Abastecimento/Botao IO.CATPart
Estrutura/PC3/CADs/Maleta de Abastecimento/Dobra 2-1.CATPart
Estrutura/PC3/CADs/Maleta de Abastecimento/Dobra 2-2.CATPart
Estrutura/PC3/CADs/Maleta de Abastecimento/Dobra 2.CATPart
Estrutura/PC3/CADs/Maleta de Abastecimento/Dobra.CATPart
Estrutura/PC3/CADs/Maleta de Abastecimento/Dobradica1.CATPart
Estrutura/PC3/CADs/Maleta de Abastecimento/Dobradica1S.CATPart
Estrutura/PC3/CADs/Maleta de Abastecimento/Dobradica2.CATPart
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
