Ground-Station/Documentation/manuals/Manual_usuario/Editaveis/Garantias_e_assistencia_tecnica.tex

\chapter{Garantia}

\par O seu produto RGS é garantido contra defeitos de fabricação, pelo
prazo de 12 meses, contado a partir da data da emissão da Nota Fiscal ou da entrega do produto, ao primeiro adquirente.

\par A garantia compreende a substituição de peças e mão-de-obra no reparo de defeitos devidamente constatados, pelo fabricante como sendo de fabricação.

\section*{A garantia fica automaticamente invalidada se:}

\begin{itemize}
\item O produto for usado de forma indevida ou para uma destinação ao qual não foi projetado;
\item Durante a utilização do produto não forem seguidas as instruções do manual de usuário;
\item Durante a montagem do sistema as instruções de montagem e instalação não forem seguidas de acordo com o manual.
\item O usuário tenha feito um uso inadequado do produto ou alterações não autorizadas pelo fabricante.
\end{itemize}

\section*{A garantia não cobre:}

\begin{itemize}
\item Falhas do produto decorrentes de insuficiência de energia elétrica.
\item Falhas no funcionamento normal do produto decorrentes da falta de limpeza.
\item Produtos ou peças que tenham sido danificados em consequência de manuseio errado ou quedas por partes do usuário.
\item Falhas decorrentes de forças da natureza.
\end{itemize}
