Ground-Station/Documentation/electronic/PCBs/Gerber_Archives_PCB's_to_fabrication/Gerber_BASE/How-to-order-PCB.txt

How to Order PCB

Please refer to:
https://docs.easyeda.com/en/PCB/Order-PCB
