Ground-Station/Documentation/manuals/Manual_montagem/Figuras/BASE/energiabase/cabopp.jpg

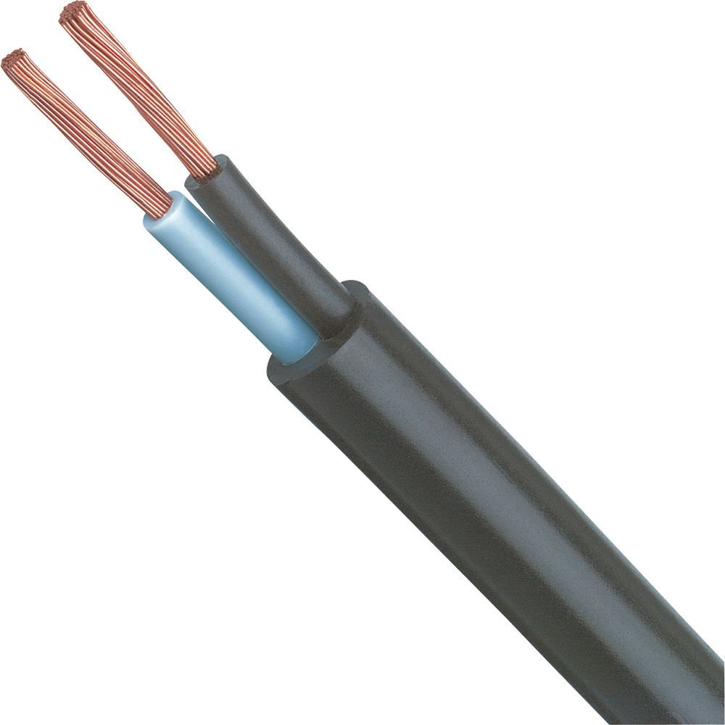
manuals/Manual_montagem/Figuras/BASE/energiabase/cabopp.jpg
