Ground-Station/Documentation/manuals/Manual_montagem/Figuras/coneiner.jpg

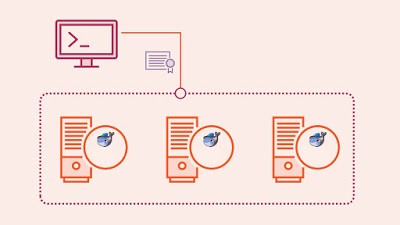
manuals/Manual_montagem/Figuras/coneiner.jpg
