Ground-Station/Documentation/manuals/Manual_montagem/Figuras/gcs/base.png

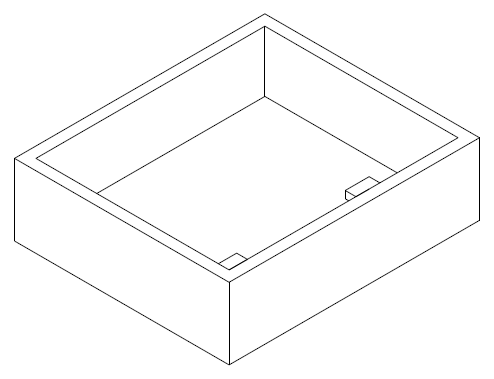
manuals/Manual_montagem/Figuras/gcs/base.png
