Ground-Station/Documentation/manuals/Manual_montagem/Figuras/gcs/cantoneiras.png

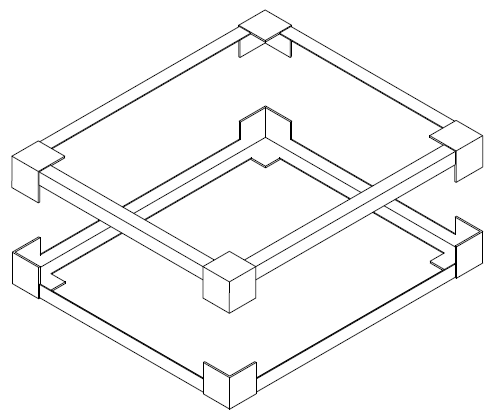
manuals/Manual_montagem/Figuras/gcs/cantoneiras.png
