Ground-Station/Documentation/manuals/Manual_montagem/Figuras/gcs/dobradica.png

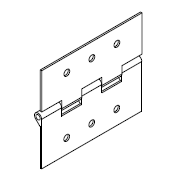
manuals/Manual_montagem/Figuras/gcs/dobradica.png
