Ground-Station/Documentation/manuals/Manual_montagem/Figuras/montagemMaletasEstrutura/alimentacaoAlca.png

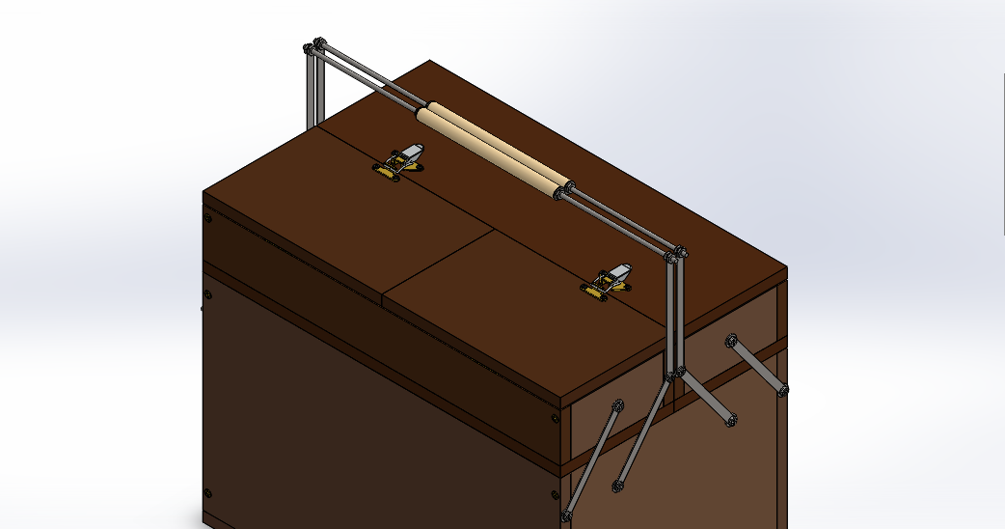
manuals/Manual_montagem/Figuras/montagemMaletasEstrutura/alimentacaoAlca.png
