Ground-Station/Documentation/manuals/Manual_montagem/Figuras/montagemMaletasEstrutura/controleDobradica.png

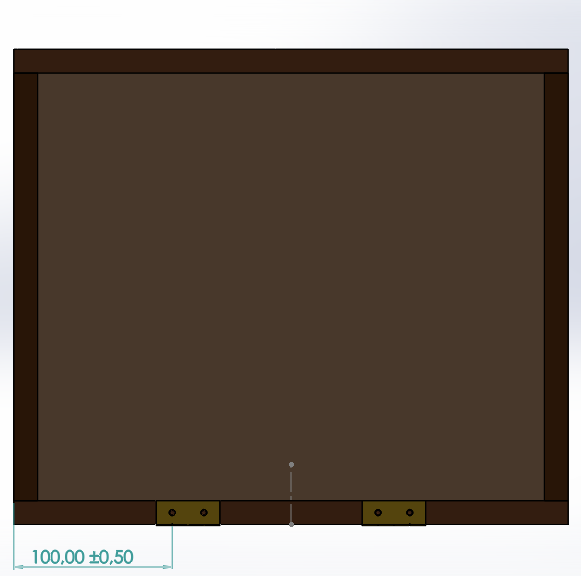
manuals/Manual_montagem/Figuras/montagemMaletasEstrutura/controleDobradica.png
