Ground-Station/Documentation/manuals/Manual_montagem/Figuras/montagemMaletasEstrutura/controleMenoInferior.png

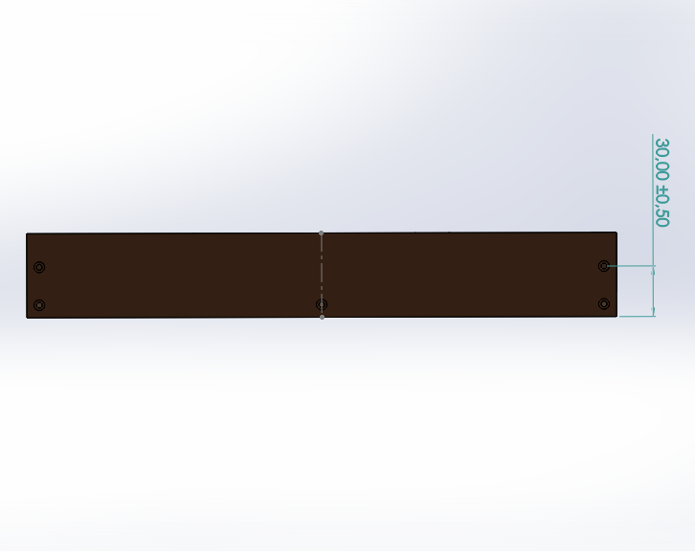
manuals/Manual_montagem/Figuras/montagemMaletasEstrutura/controleMenoInferior.png
