Ground-Station/Documentation/manuals/Manual_montagem/Figuras/montagemMaletasEstrutura/dobradica.png

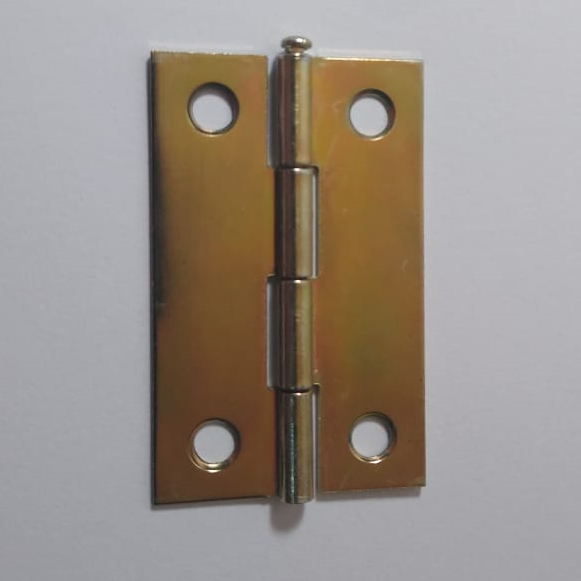
manuals/Manual_montagem/Figuras/montagemMaletasEstrutura/dobradica.png
