Ground-Station/Documentation/manuals/Manual_montagem/Figuras/montagemMaletasEstrutura/furoBaseIgnicao.png

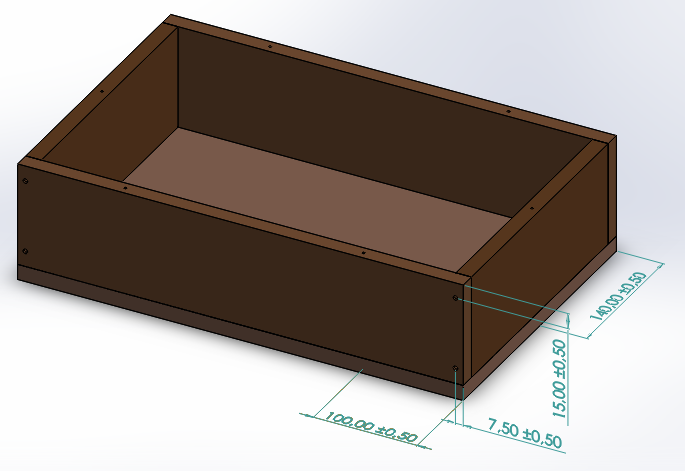
manuals/Manual_montagem/Figuras/montagemMaletasEstrutura/furoBaseIgnicao.png
