Ground-Station/Documentation/manuals/Manual_montagem/Figuras/montagemMaletasEstrutura/furoIgnicaoAlcaSanfona.png

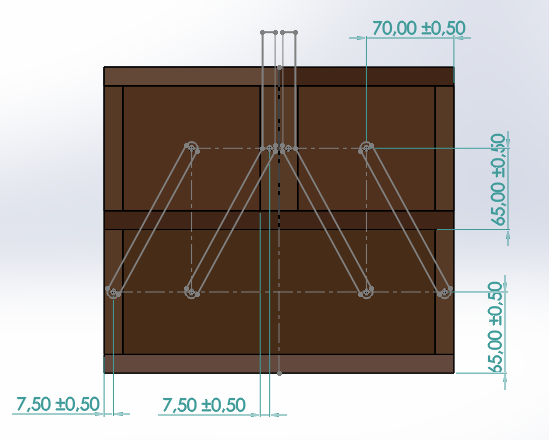
manuals/Manual_montagem/Figuras/montagemMaletasEstrutura/furoIgnicaoAlcaSanfona.png
