Ground-Station/Documentation/manuals/Manual_montagem/Figuras/montagemMaletasEstrutura/furoIgnicaoDobradica.png

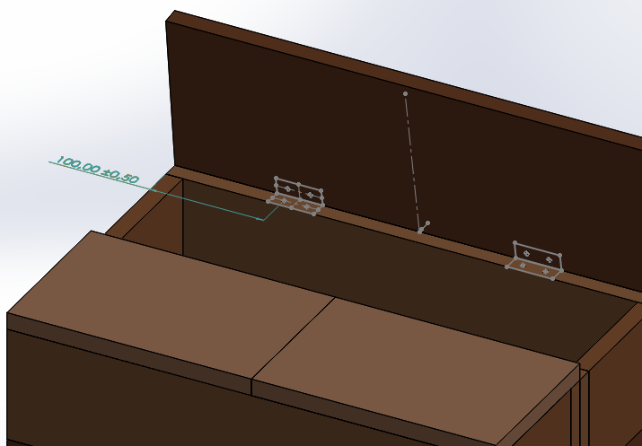
manuals/Manual_montagem/Figuras/montagemMaletasEstrutura/furoIgnicaoDobradica.png
