Ground-Station/Documentation/manuals/Manual_montagem/Figuras/montagemMaletasEstrutura/furoIgnicaoFecho.png

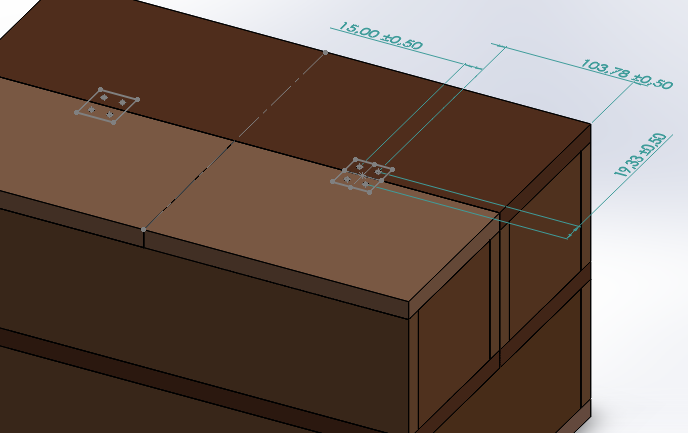
manuals/Manual_montagem/Figuras/montagemMaletasEstrutura/furoIgnicaoFecho.png
