Ground-Station/Documentation/manuals/Manual_montagem/Figuras/montagemMaletasEstrutura/furoIgnicaoVistaInferior.png

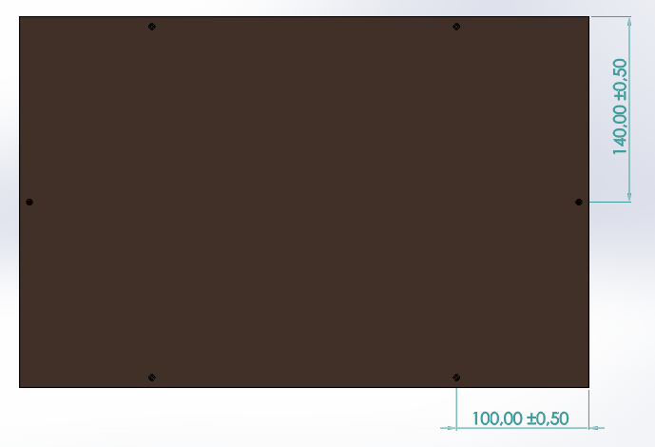
manuals/Manual_montagem/Figuras/montagemMaletasEstrutura/furoIgnicaoVistaInferior.png
