Ground-Station/Documentation/manuals/Manual_montagem/Figuras/montagemMaletasEstrutura/ignicaoBaseFrontal.png

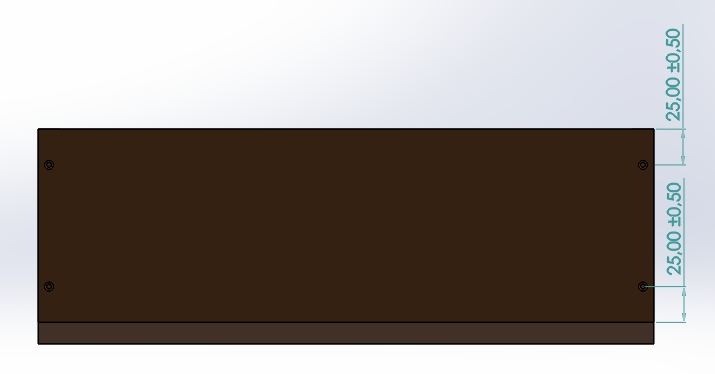
manuals/Manual_montagem/Figuras/montagemMaletasEstrutura/ignicaoBaseFrontal.png
