Ground-Station/Documentation/manuals/Manual_montagem/Figuras/montagemMaletasEstrutura/ignicaoFrontal.png

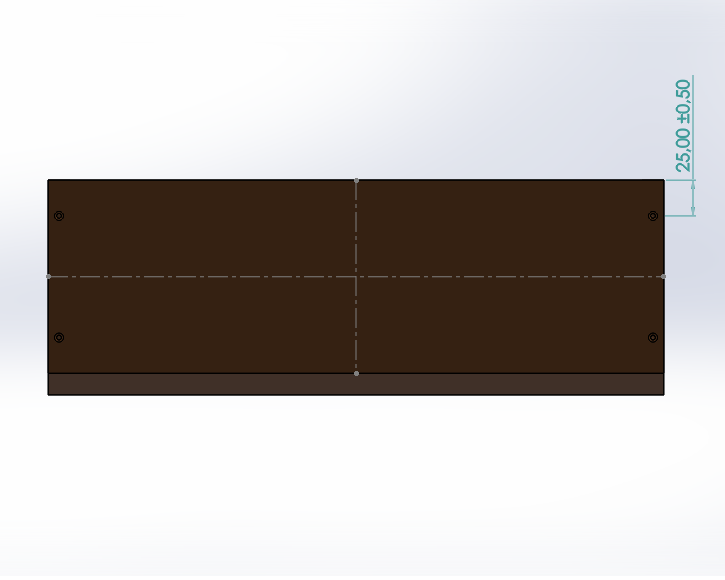
manuals/Manual_montagem/Figuras/montagemMaletasEstrutura/ignicaoFrontal.png
