Ground-Station/Documentation/manuals/Manual_montagem/Figuras/montagemMaletasEstrutura/ignicaoGavetaSuperior.png

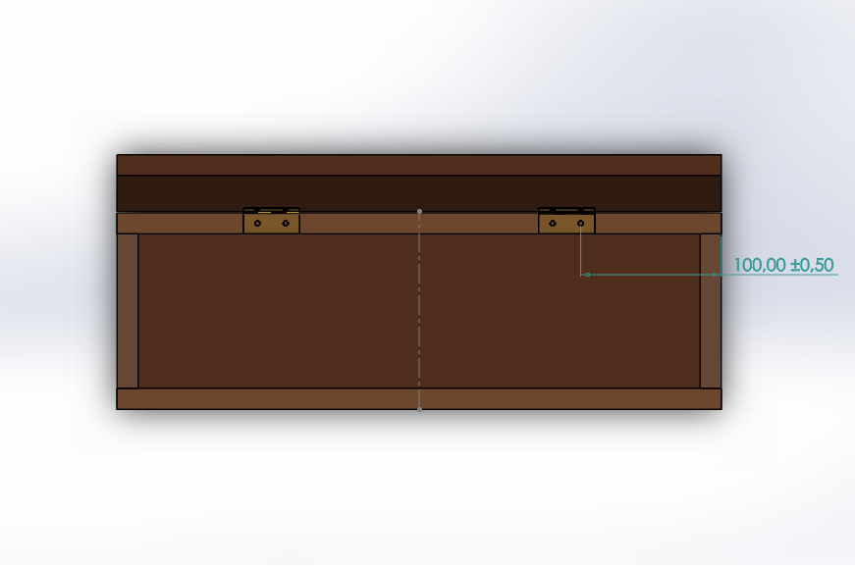
manuals/Manual_montagem/Figuras/montagemMaletasEstrutura/ignicaoGavetaSuperior.png
