Ground-Station/Documentation/manuals/Manual_montagem/Figuras/montagemMaletasEstrutura/ignicaoMontada.png

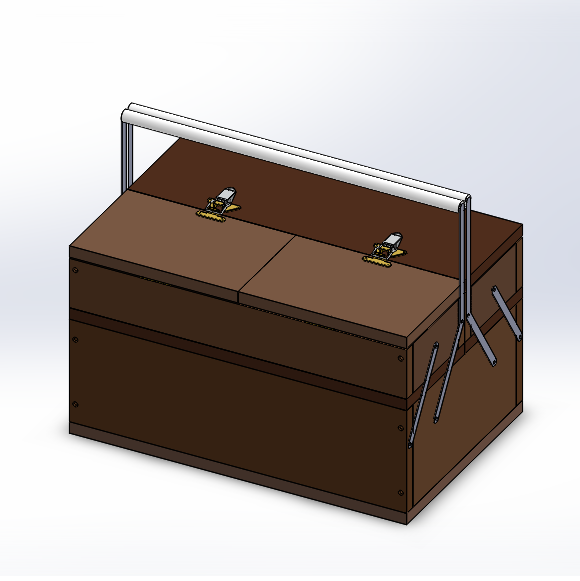
manuals/Manual_montagem/Figuras/montagemMaletasEstrutura/ignicaoMontada.png
