Ground-Station/Documentation/manuals/Manual_montagem/Figuras/montagemMaletasEstrutura/ignicaoTransparente.png

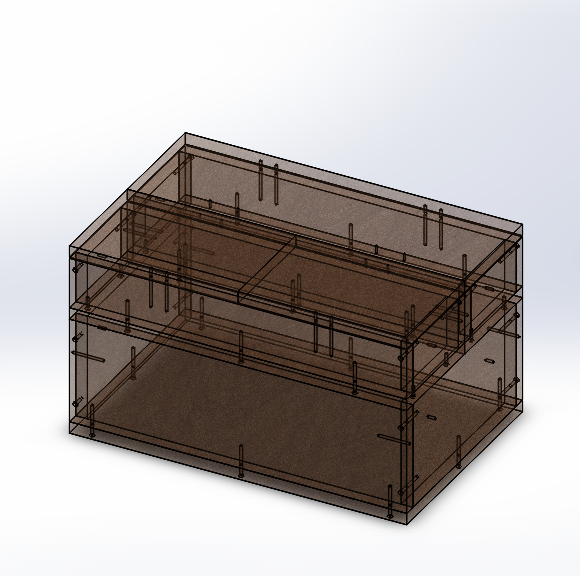
manuals/Manual_montagem/Figuras/montagemMaletasEstrutura/ignicaoTransparente.png
