Ground-Station/Documentation/manuals/Manual_montagem/Figuras/montagemMaletasEstrutura/montagemControleMaior.png

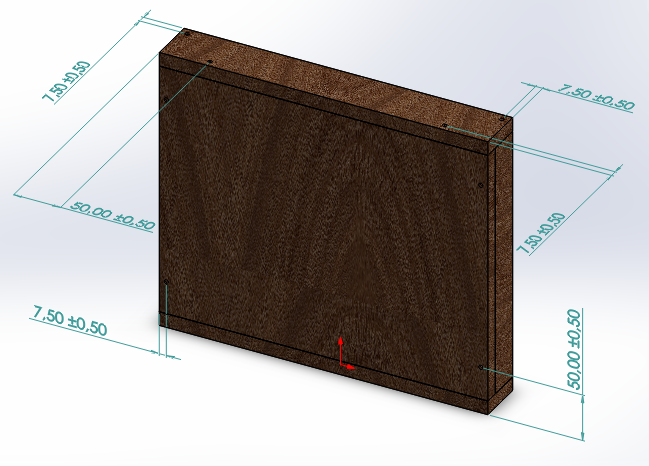
manuals/Manual_montagem/Figuras/montagemMaletasEstrutura/montagemControleMaior.png
