Ground-Station/Documentation/manuals/Manual_montagem/Figuras/montagemMaletasEstrutura/puxador.png

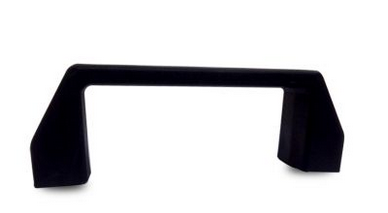
manuals/Manual_montagem/Figuras/montagemMaletasEstrutura/puxador.png
