Ground-Station/Documentation/manuals/Manual_montagem/Figuras/suporte/base.png

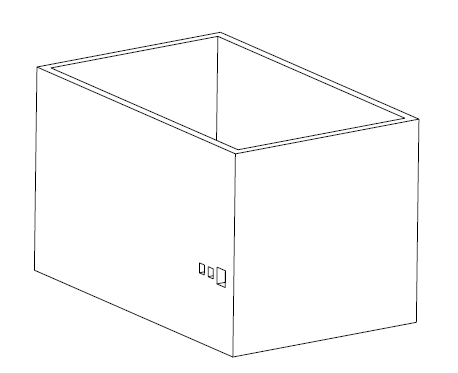
manuals/Manual_montagem/Figuras/suporte/base.png
