Ground-Station/Documentation/manuals/Manual_usuario/Figuras/foguete1.png

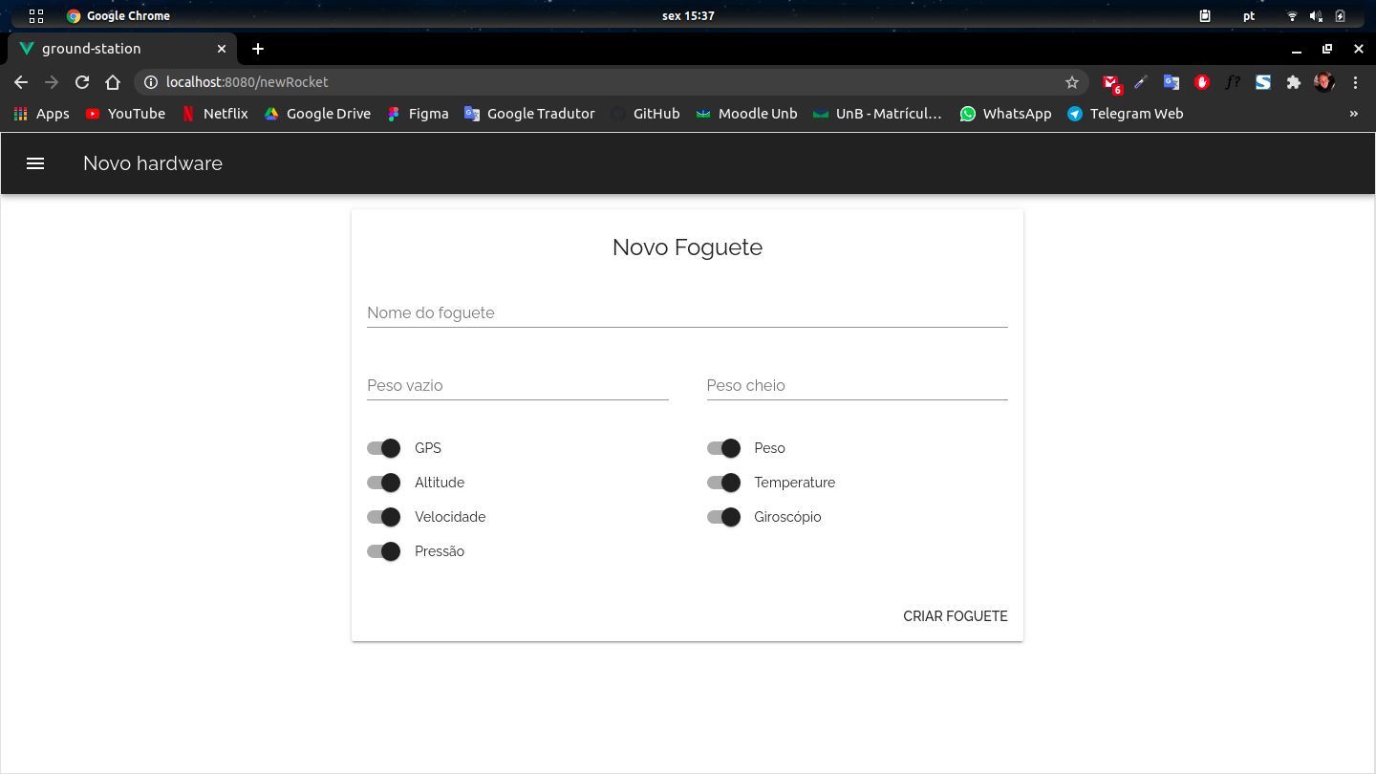
manuals/Manual_usuario/Figuras/foguete1.png
