Ground-Station/Documentation/electronic/PCBs/schematics/Esquemático_base_de_lançamento.pdf

LM2596

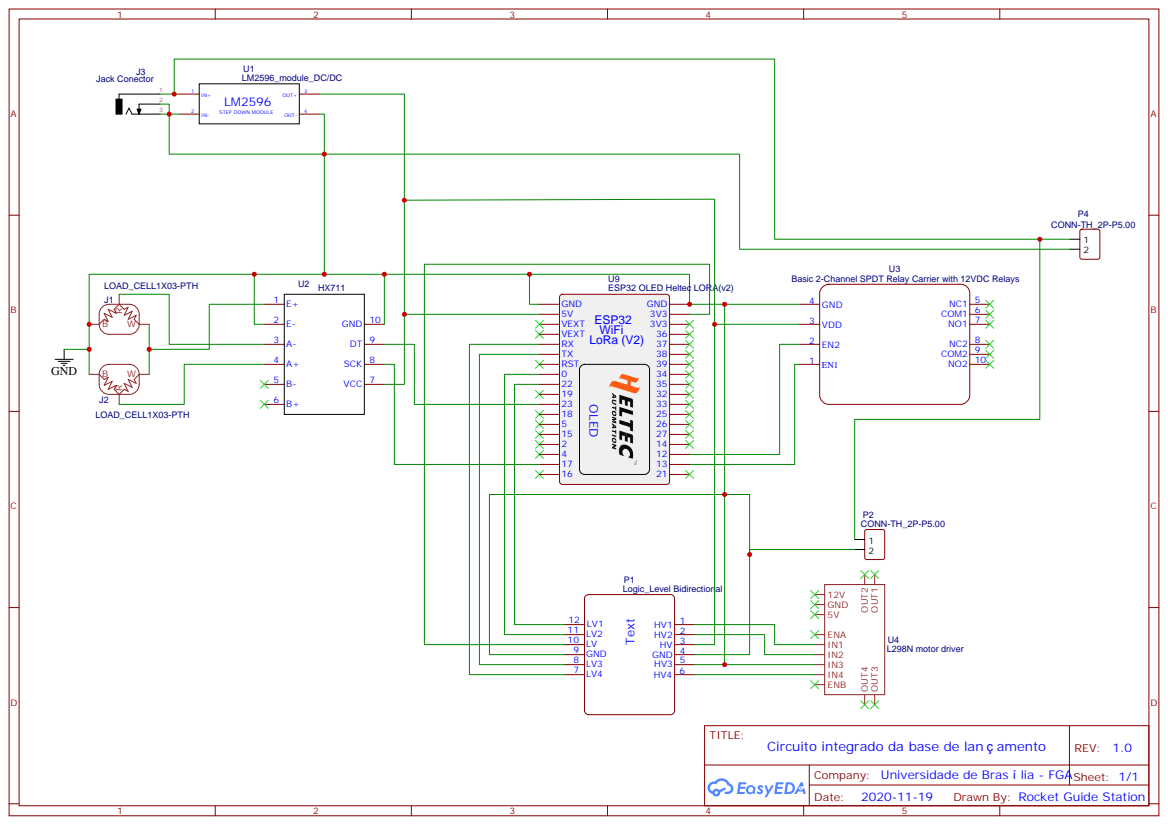
[picture p482: page 1]

Basic 2-Channel SPDT Relay Carrier with 12VDC Relays
VDD 3

Company: Universidade de Bras lia - FGA

Drawn By: Rocket Guide Station
