Ground-Station/Documentation/electronic/PCBs/schematics/Esquemático_circuito_foguete.pdf

## GND LM2596 DC-DC MODULE

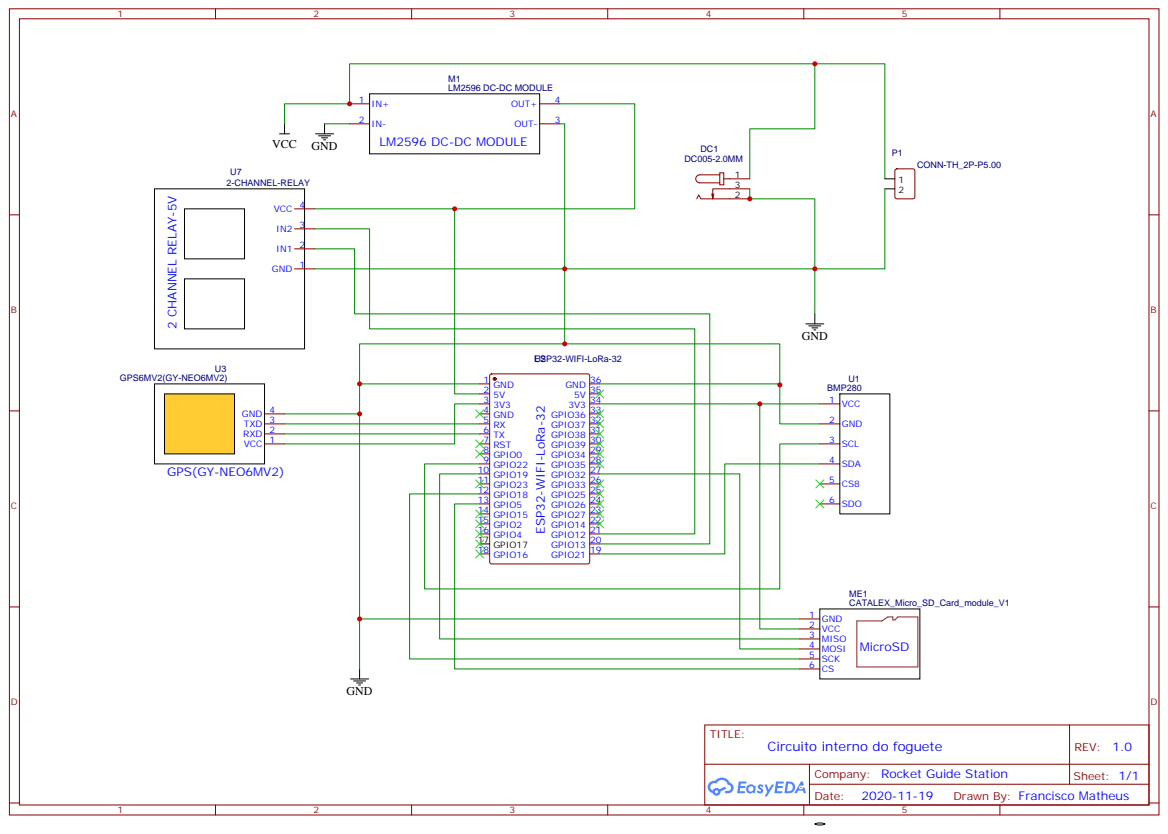
[picture p483: page 1]

Company: Rocket Guide Station

Drawn By: Francisco Matheus
