Ground-Station/Documentation/electronic/PCBs/schematics/Esquemático_maleta.pdf

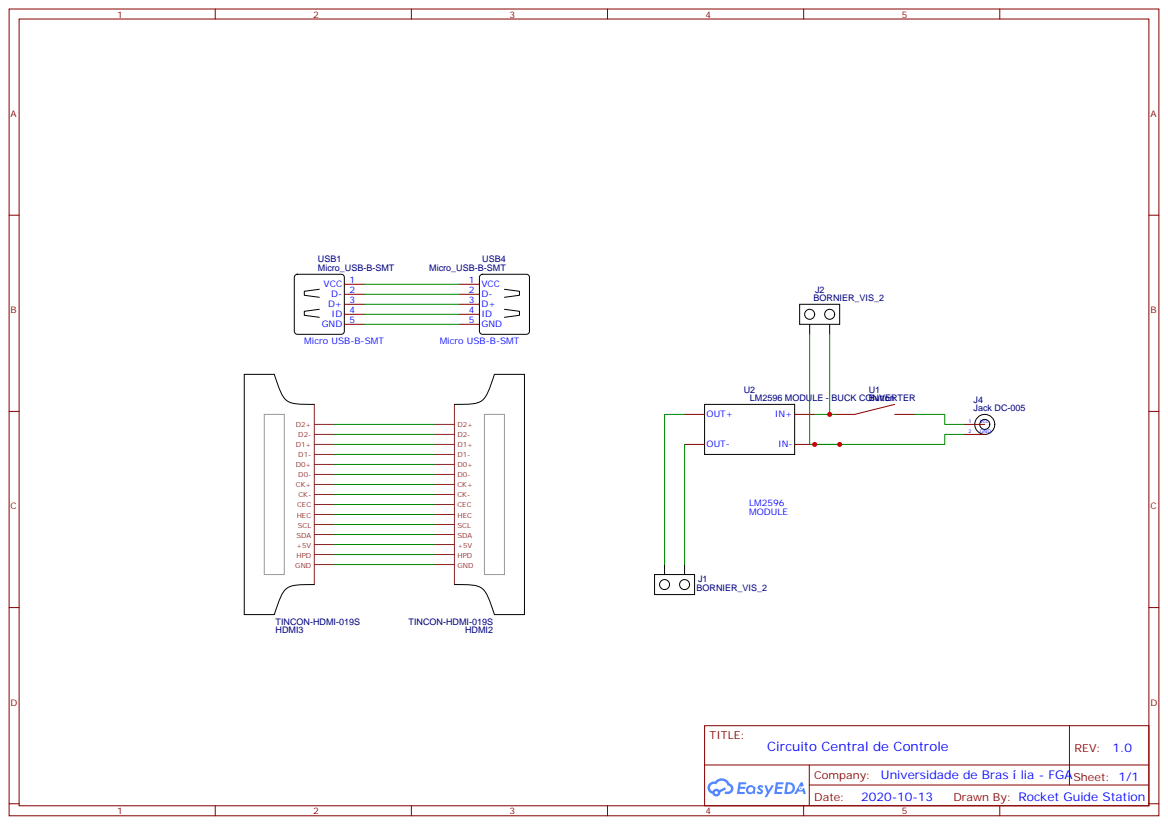
[picture p484: page 1]

Company: Universidade de Bras lia - FGA

Drawn By: Rocket Guide Station
