Ground-Station/Documentation/Estrutura/PC3/Desenho Técnico/Desenho Técnico da Maleta de Alimentação com Lista de Materiais.pdf

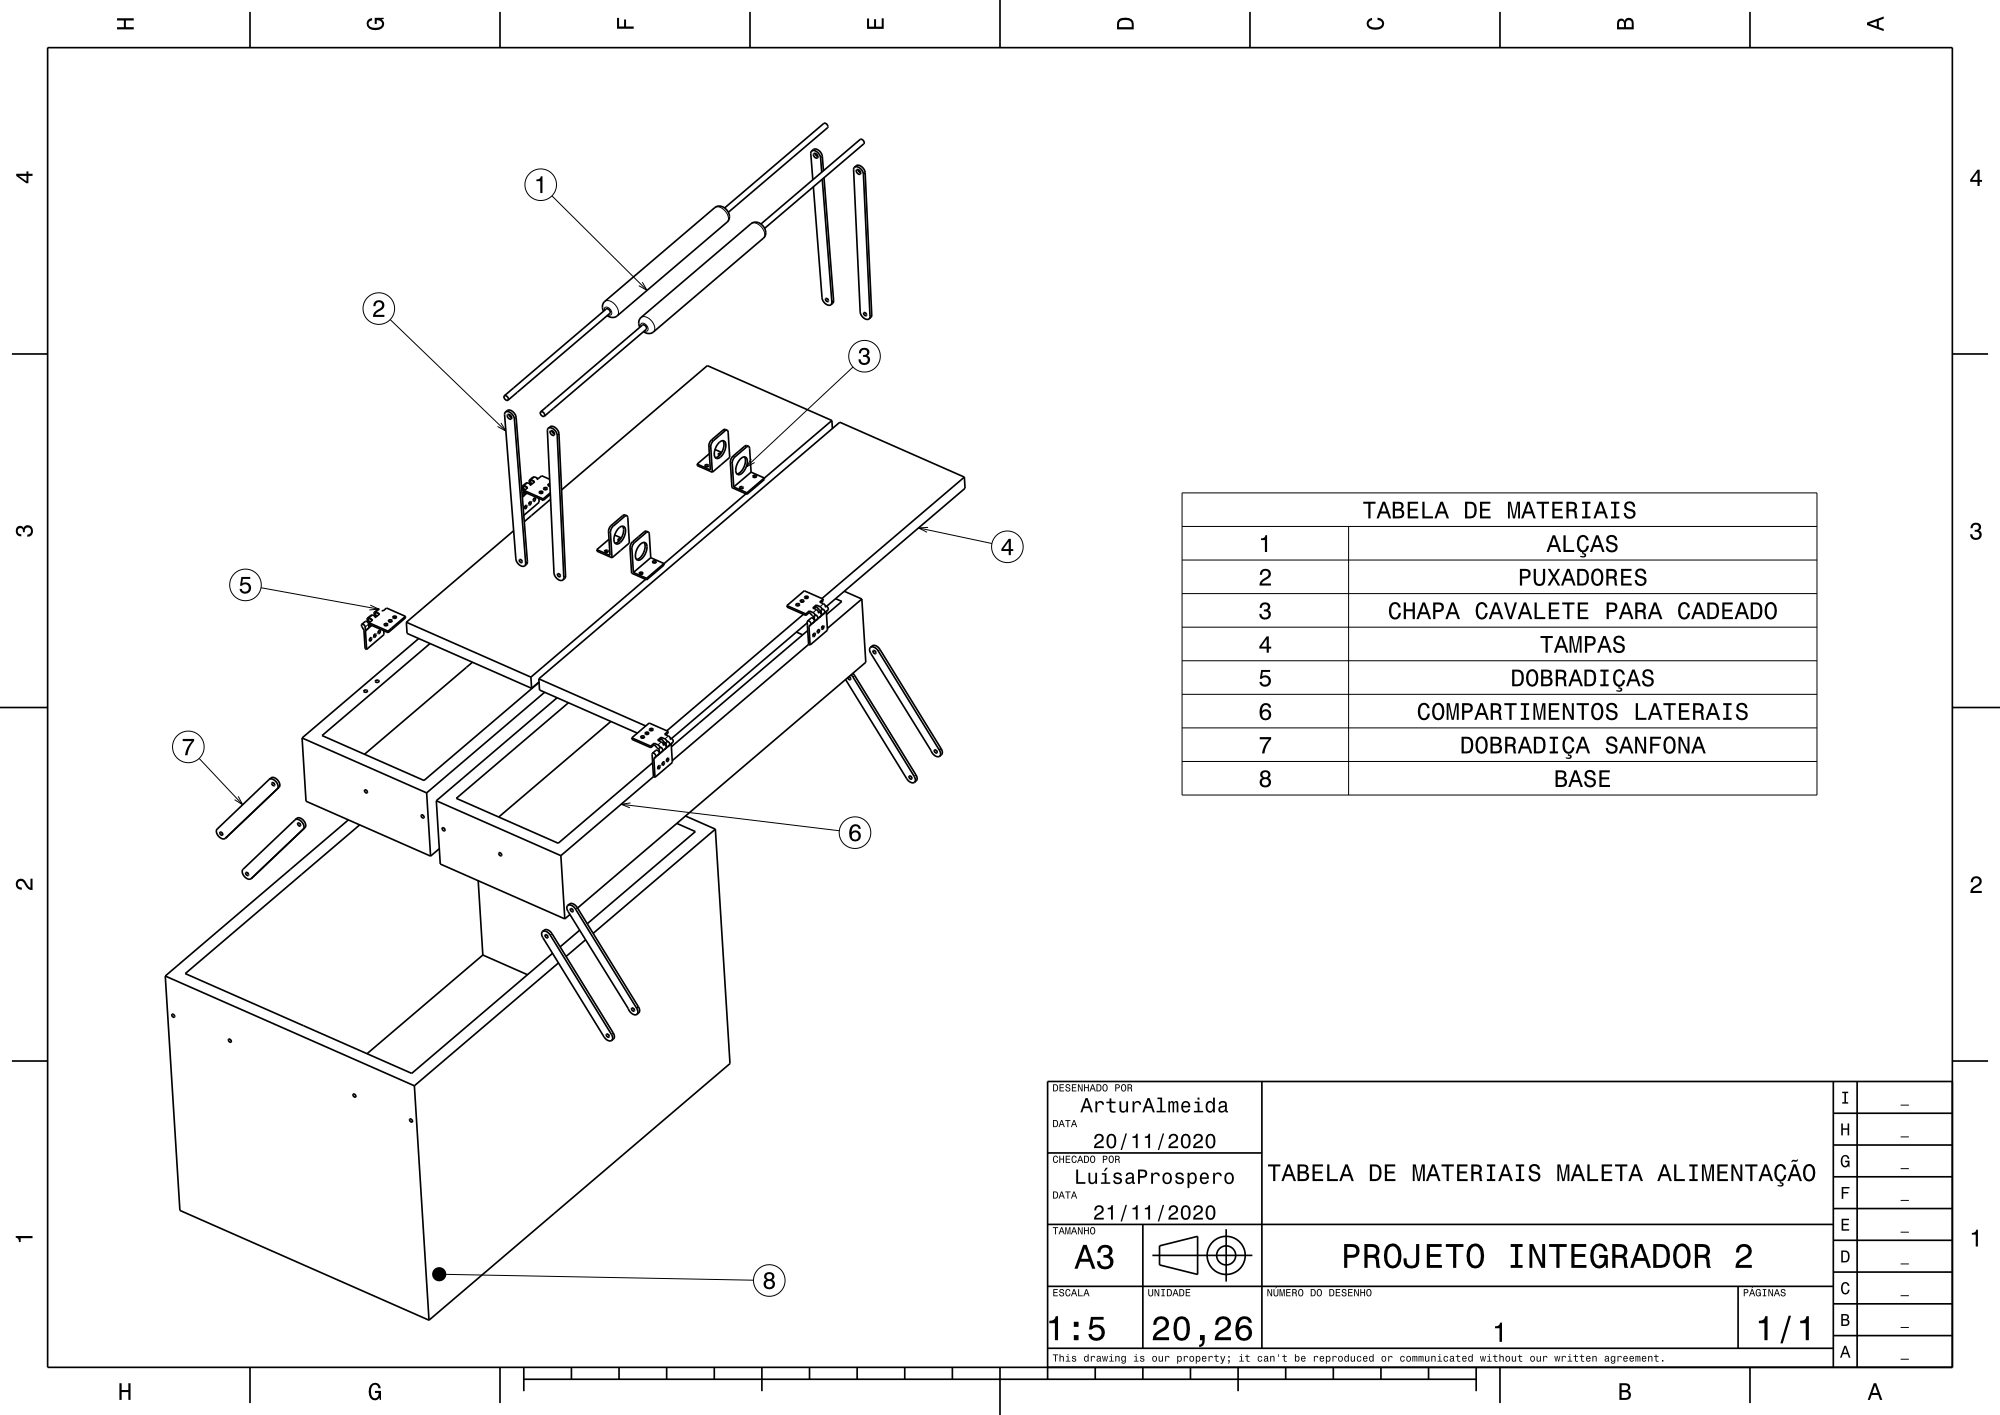
[picture p485: page 1]
