Ground-Station/Documentation/Estrutura/PC3/Desenho Técnico/Desenho Técnico da Maleta GCS com Lista de Materiais.pdf

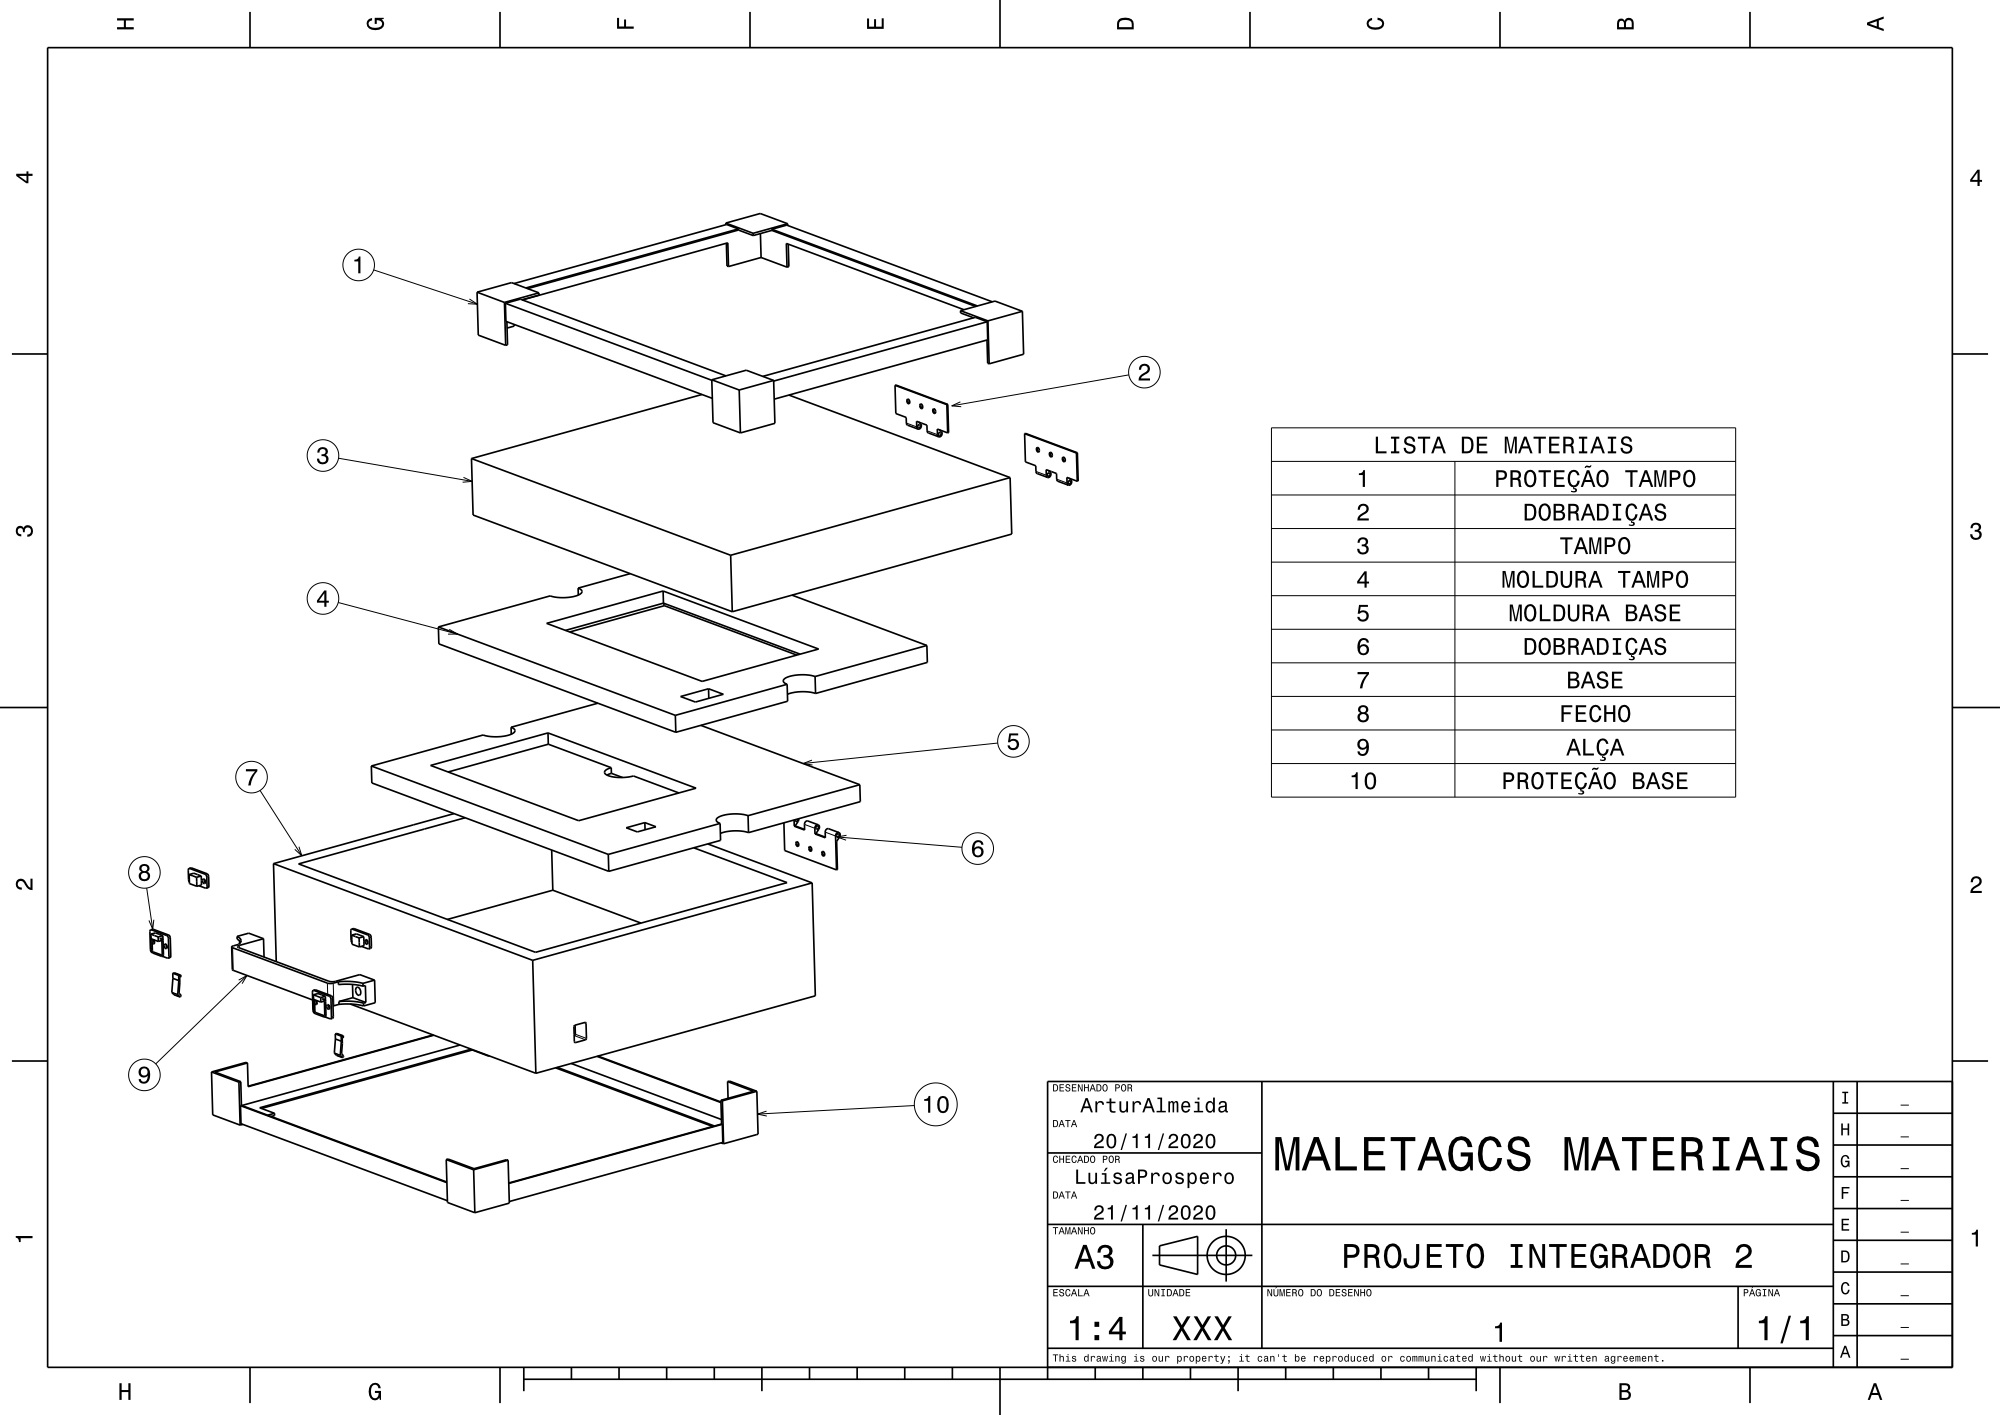
[picture p486: page 1]
