Ground-Station/Documentation/Estrutura/PC3/Desenho Técnico/Desenho Técnico da Maleta GCS com Tabela de Componentes.pdf

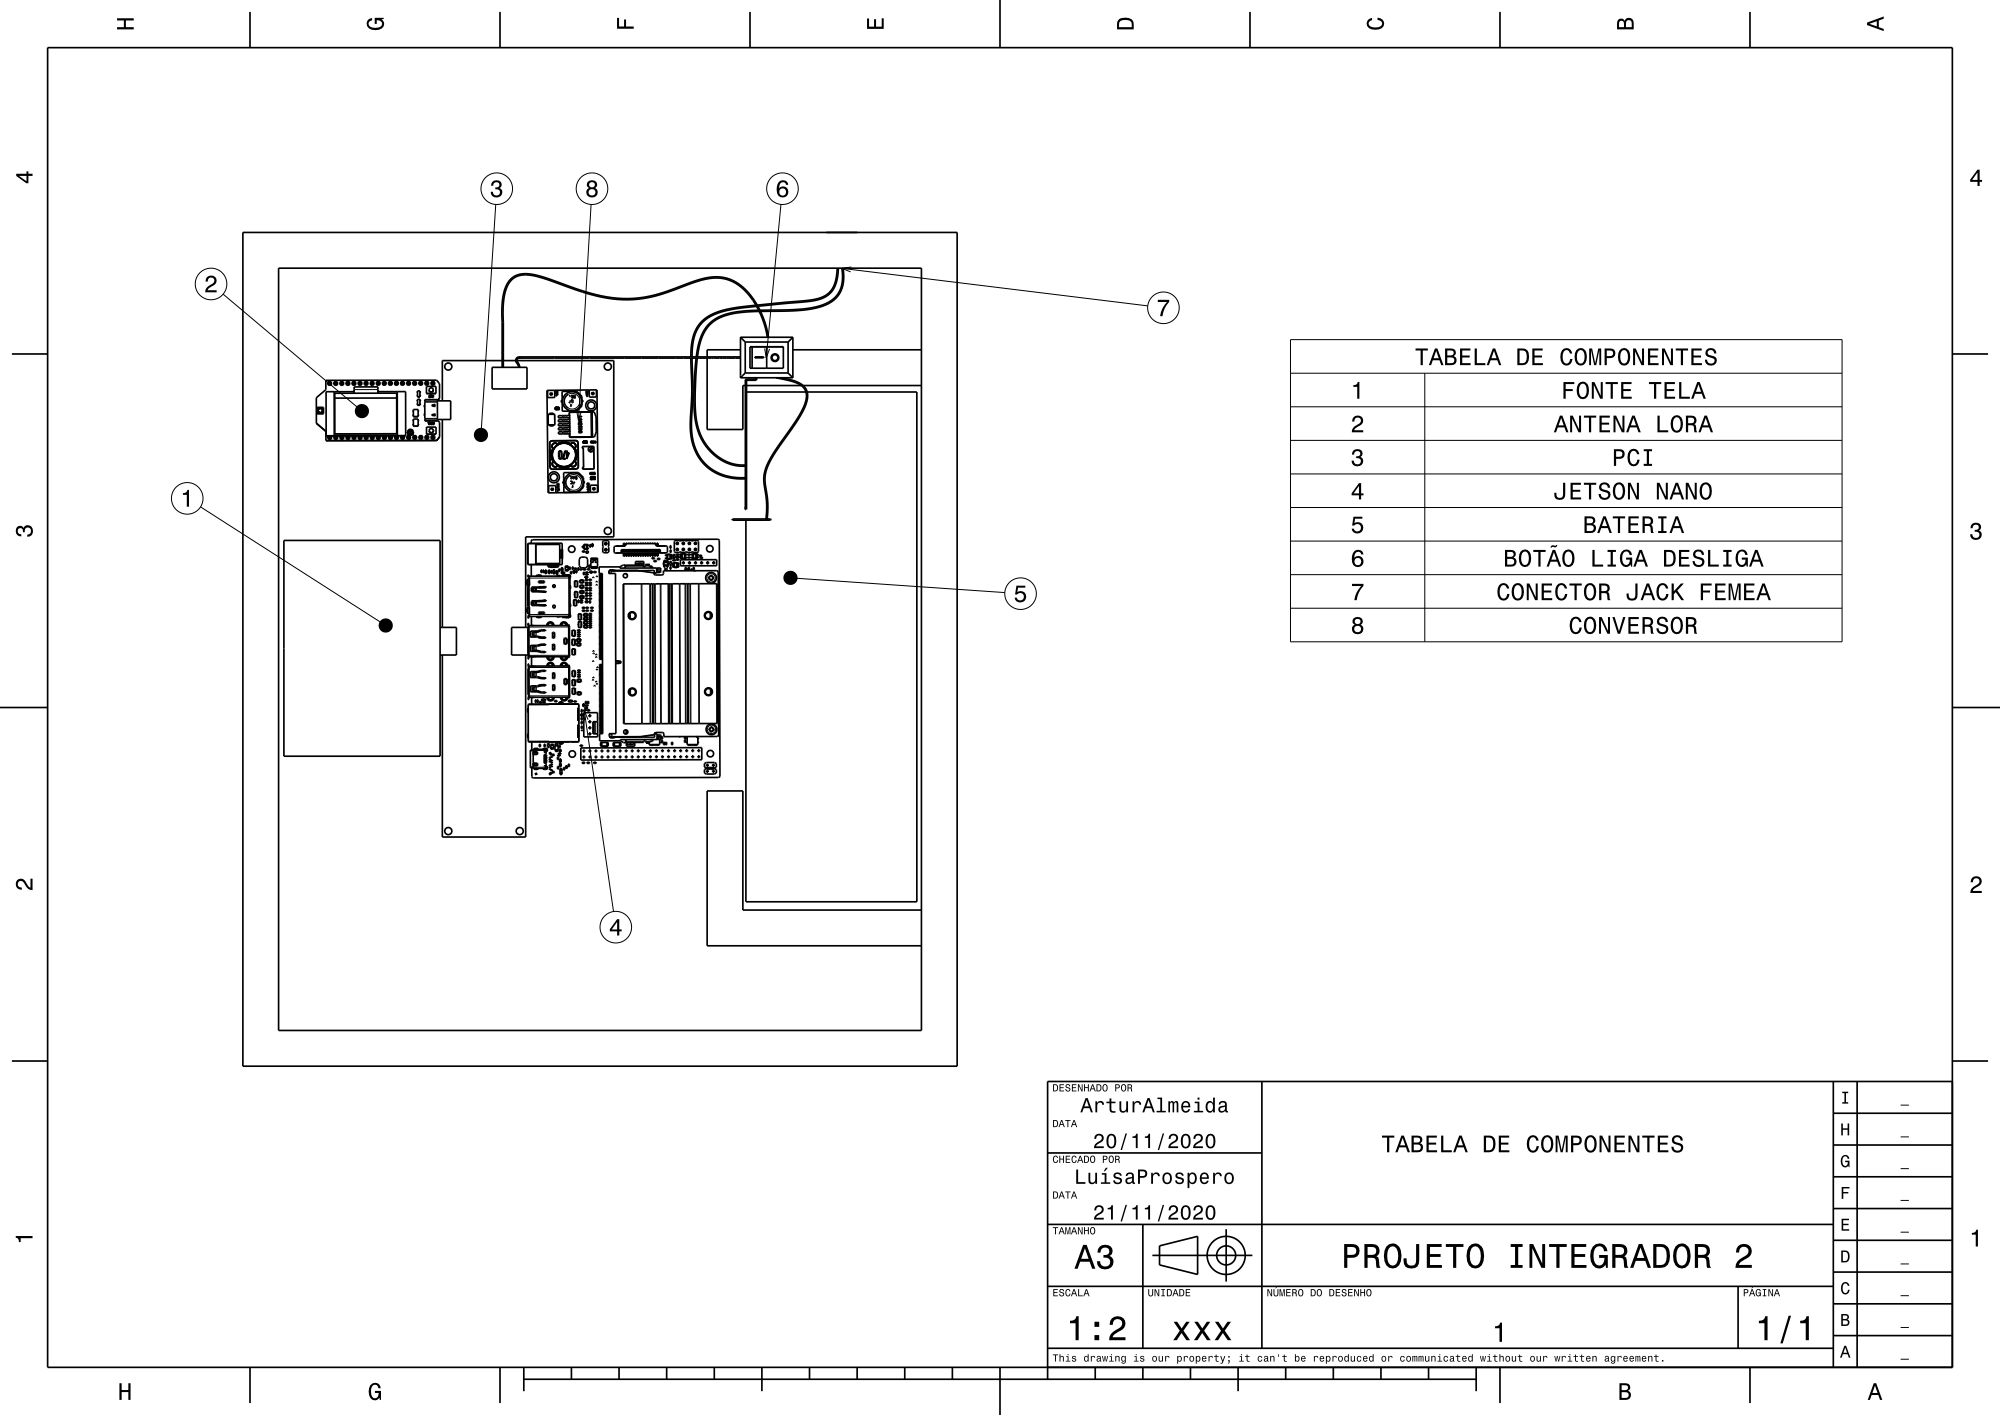
[picture p487: page 1]
