Ground-Station/Documentation/reports/PI2_PC2_fogueteiros/figuras/circuitoeletrico.pdf

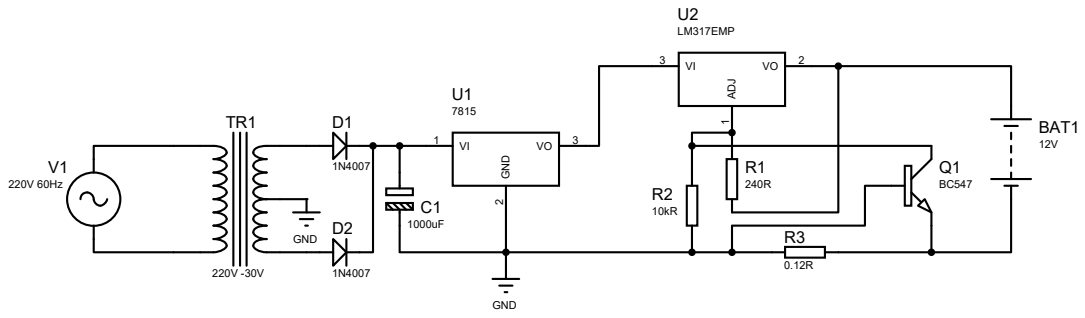
[picture p488: page 1]

Projeto Rocket Guide Station
