Ground-Station/Documentation/reports/PI2_PC2_fogueteiros/figuras/diagrama_hidraulico.pdf

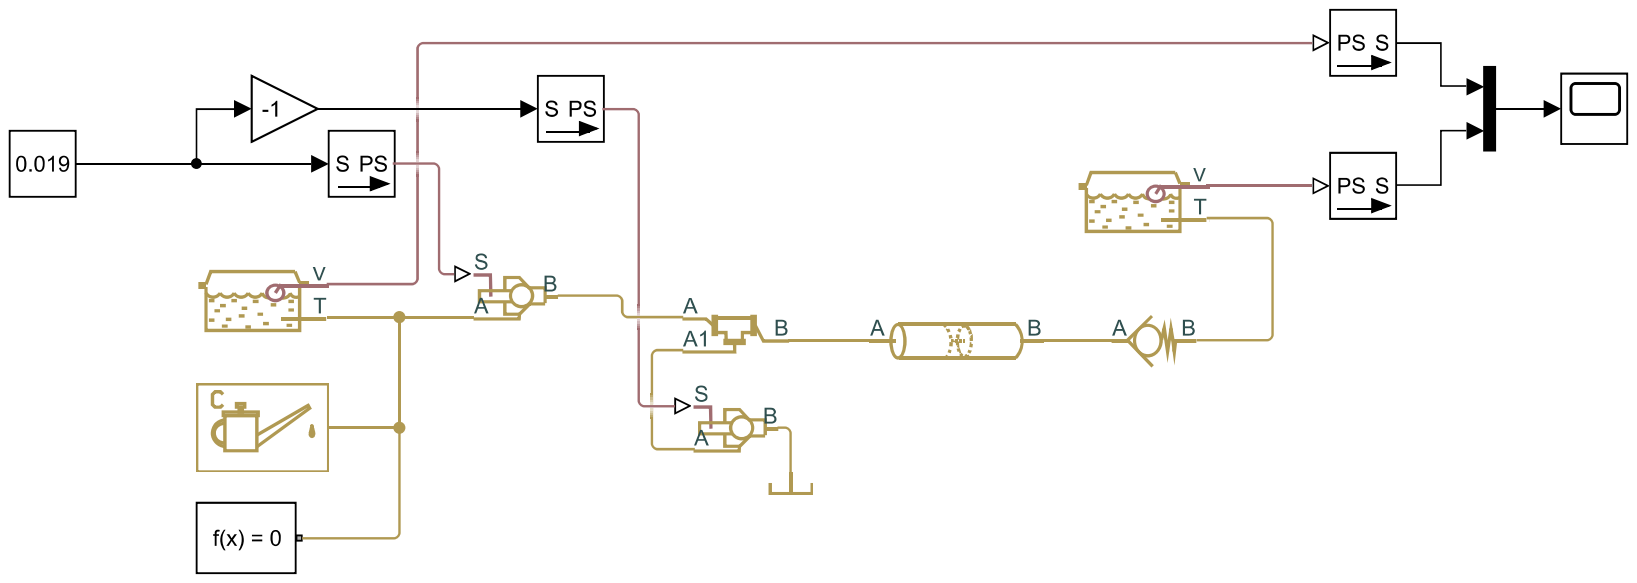
[picture p489: page 1]
