Ground-Station/Documentation/Estrutura/PC2/Desenhos Técnicos/Maleta de Abastecimento 01.pdf

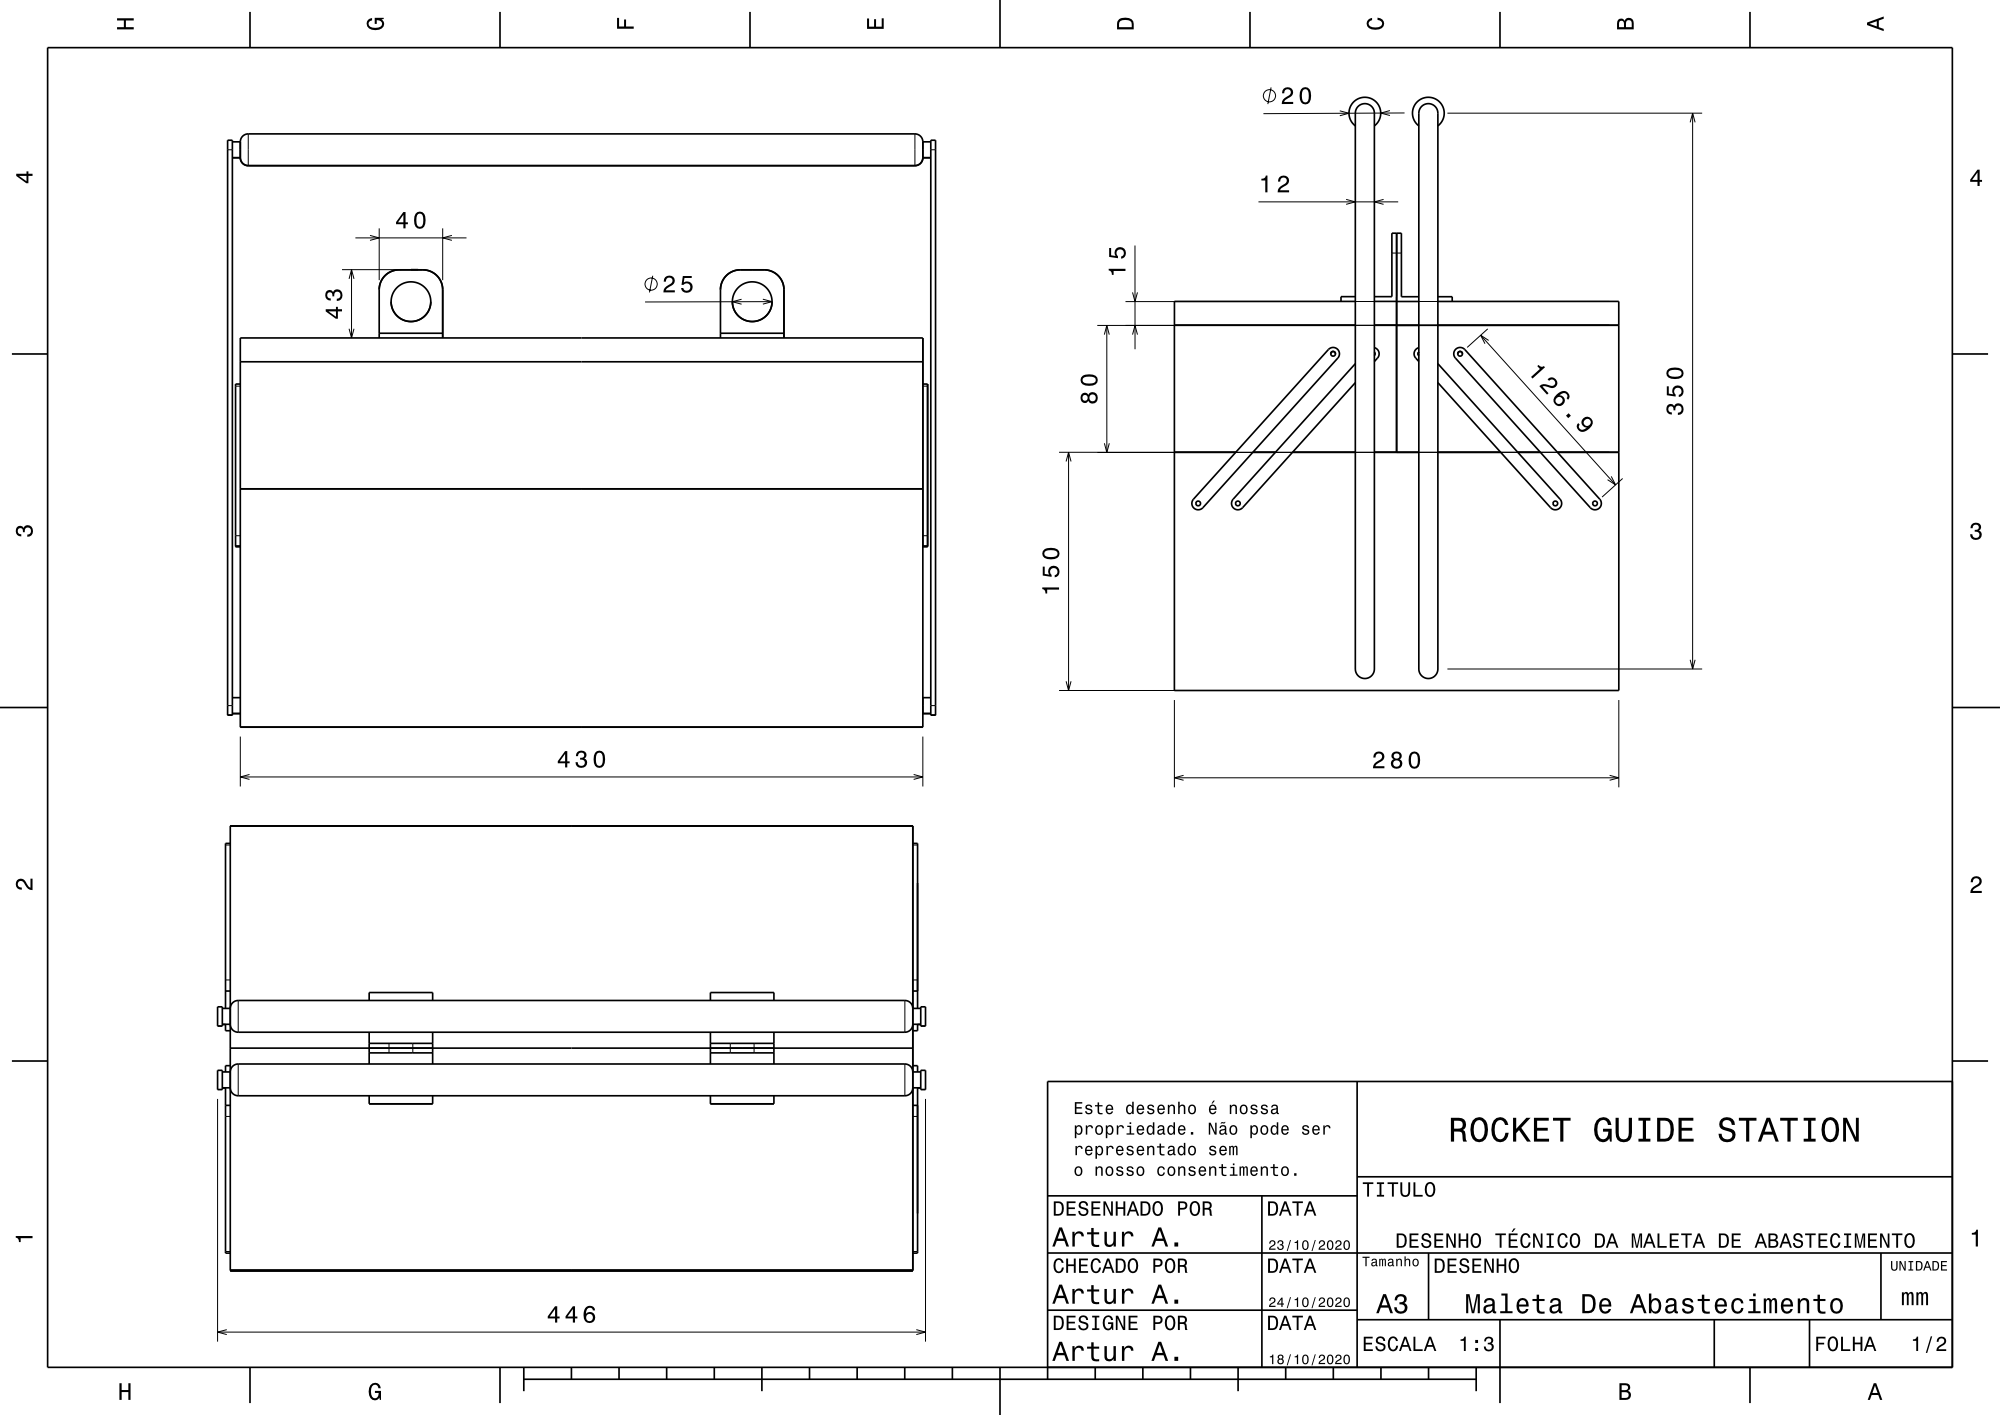
[picture p490: page 1]
