Ground-Station/Documentation/Estrutura/PC2/Desenhos Técnicos/Maleta de Abastecimento 02.pdf

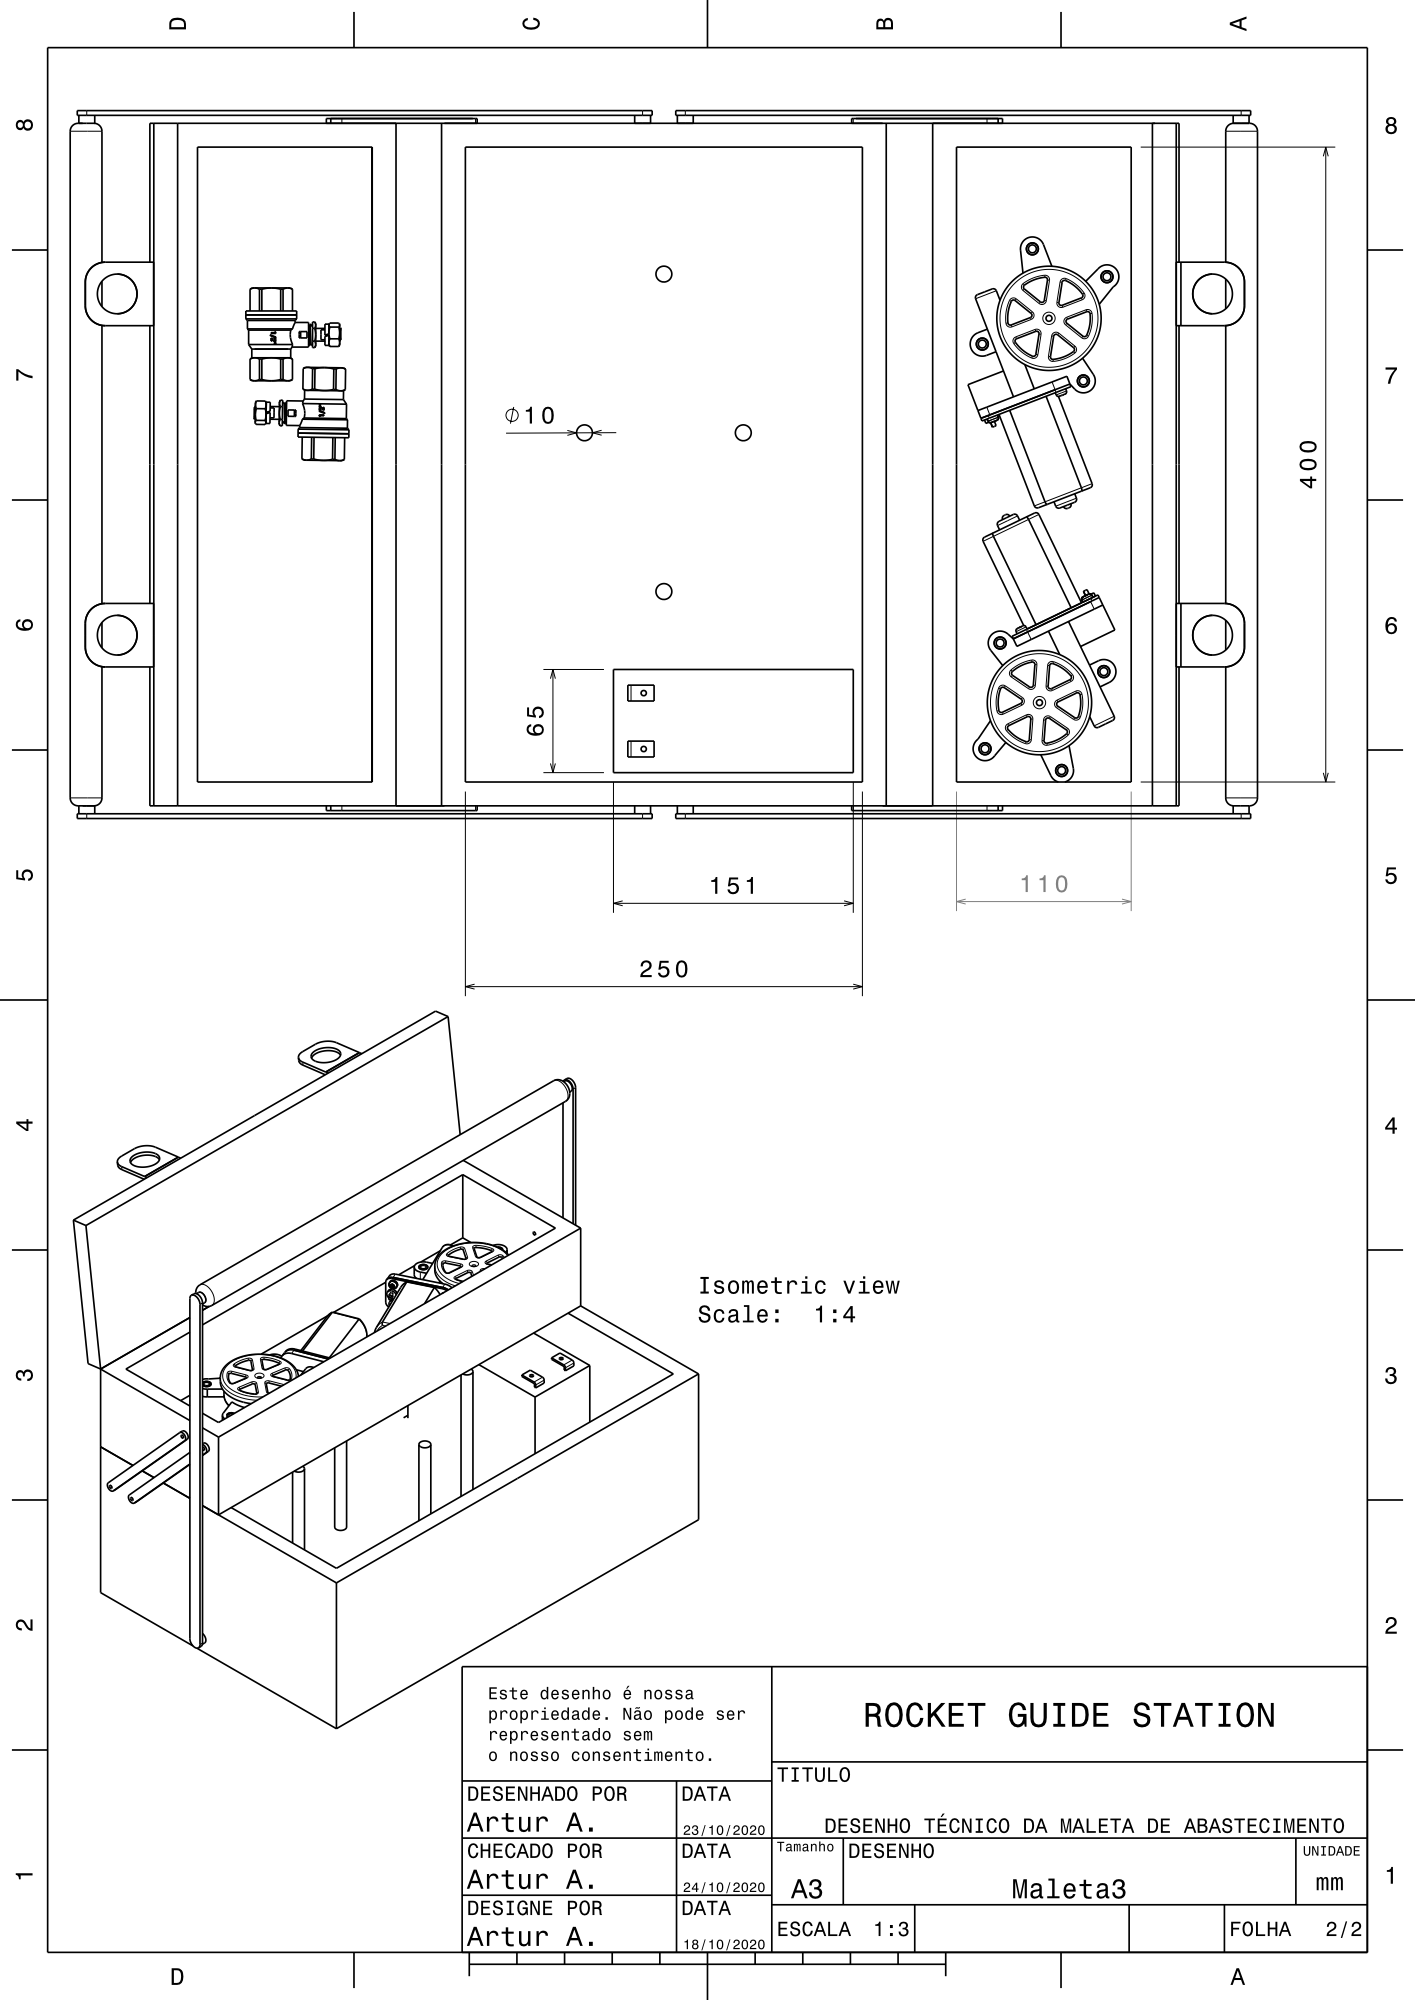
[picture p491: page 1]
