Ground-Station/Documentation/Estrutura/PC2/Desenhos Técnicos/Maleta GCS 01.pdf

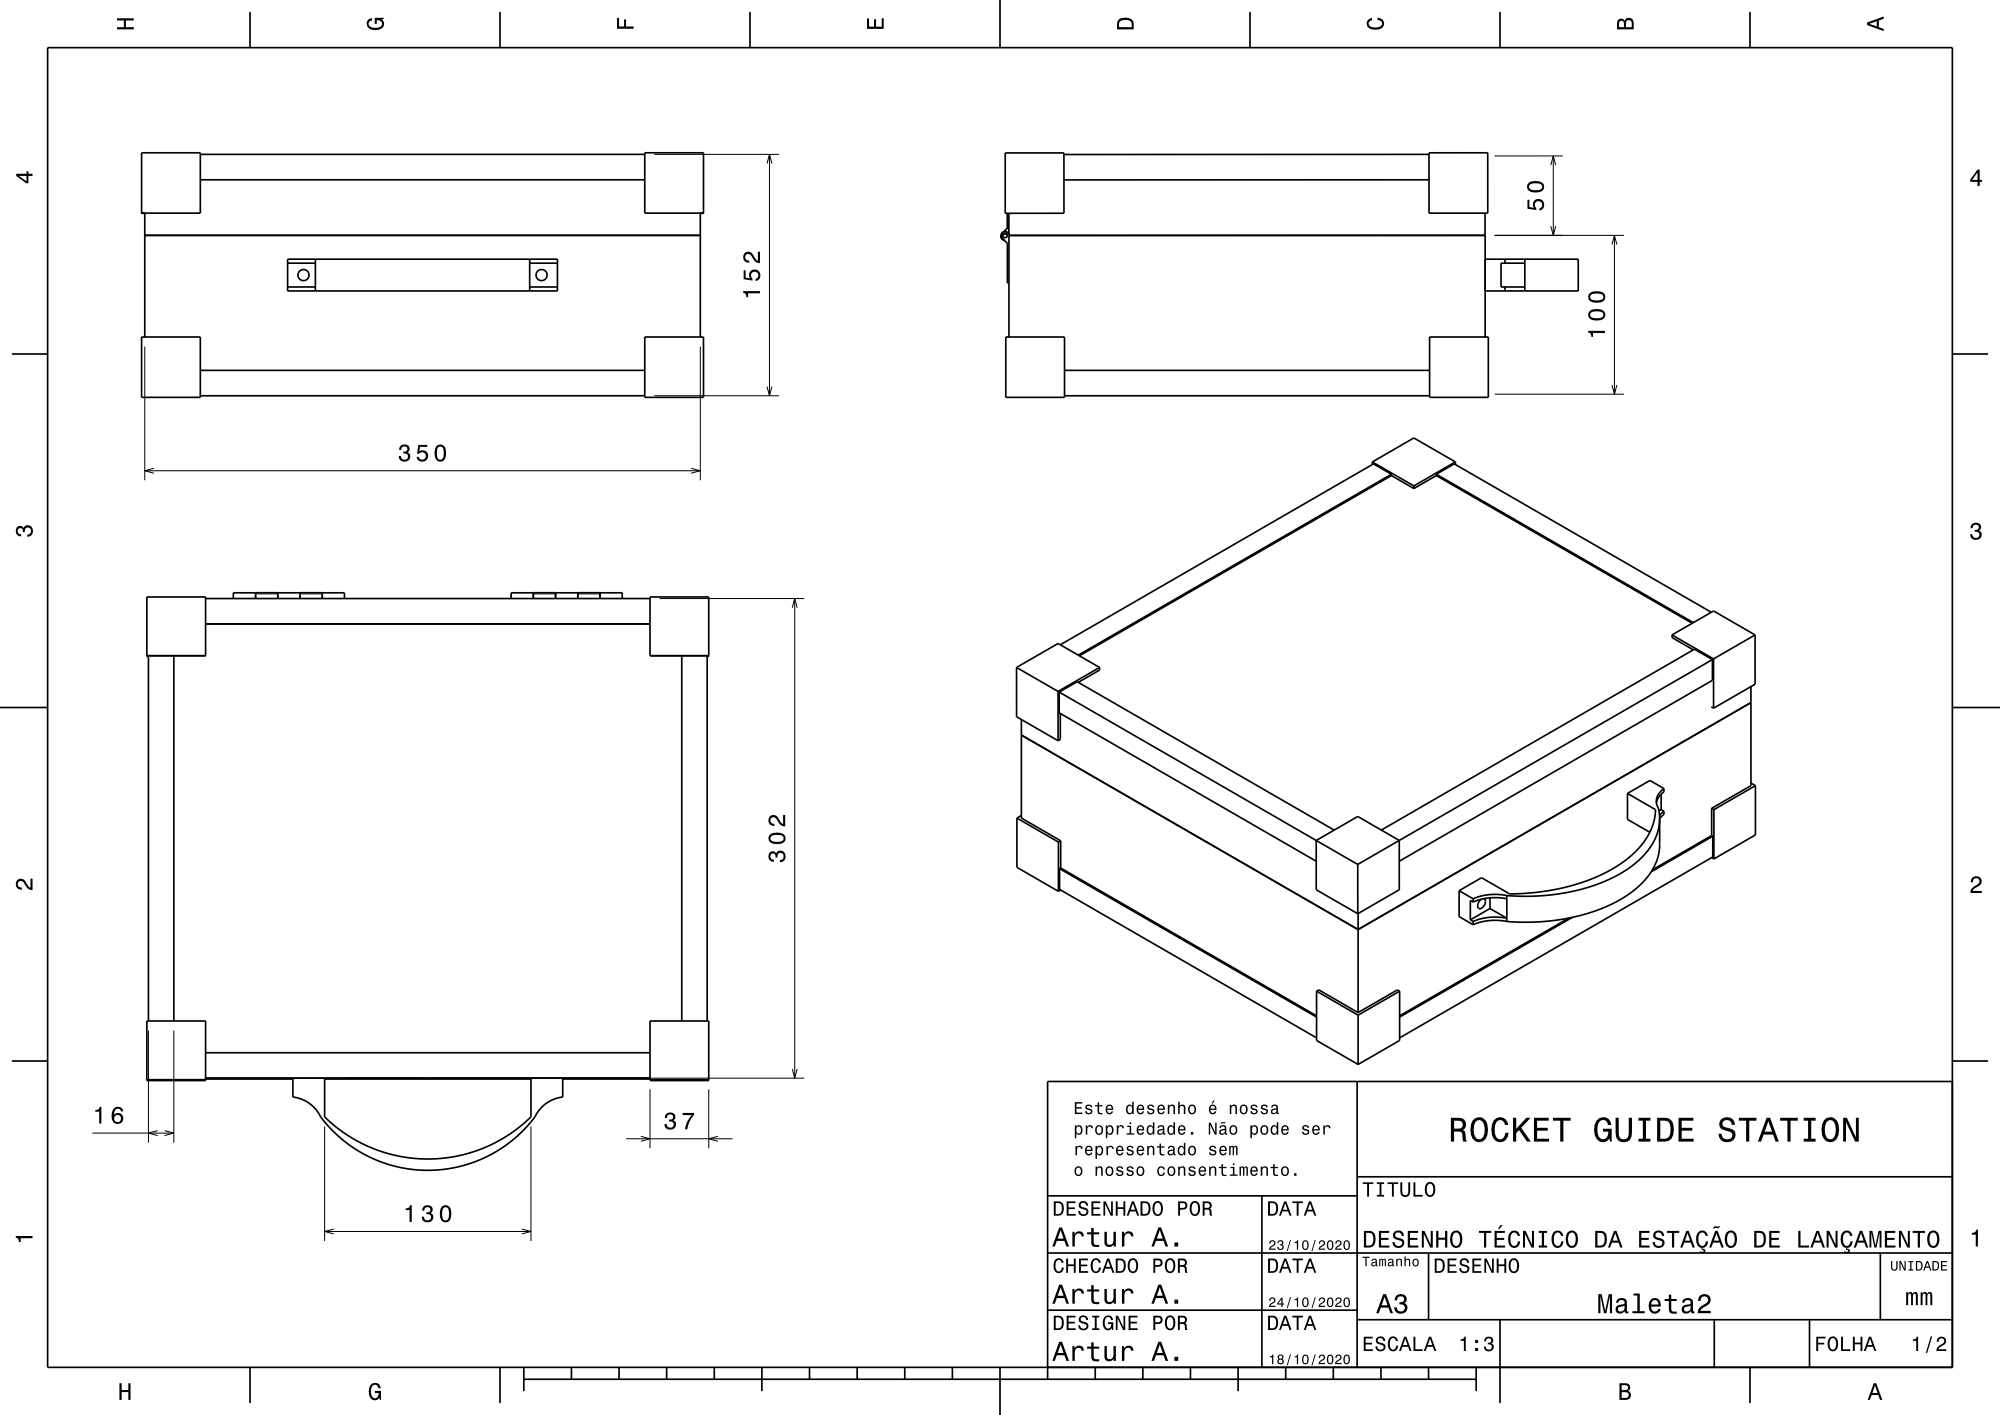
[picture p492: page 1]
