Ground-Station/Documentation/Estrutura/PC2/Desenhos Técnicos/Maleta GCS 02.pdf

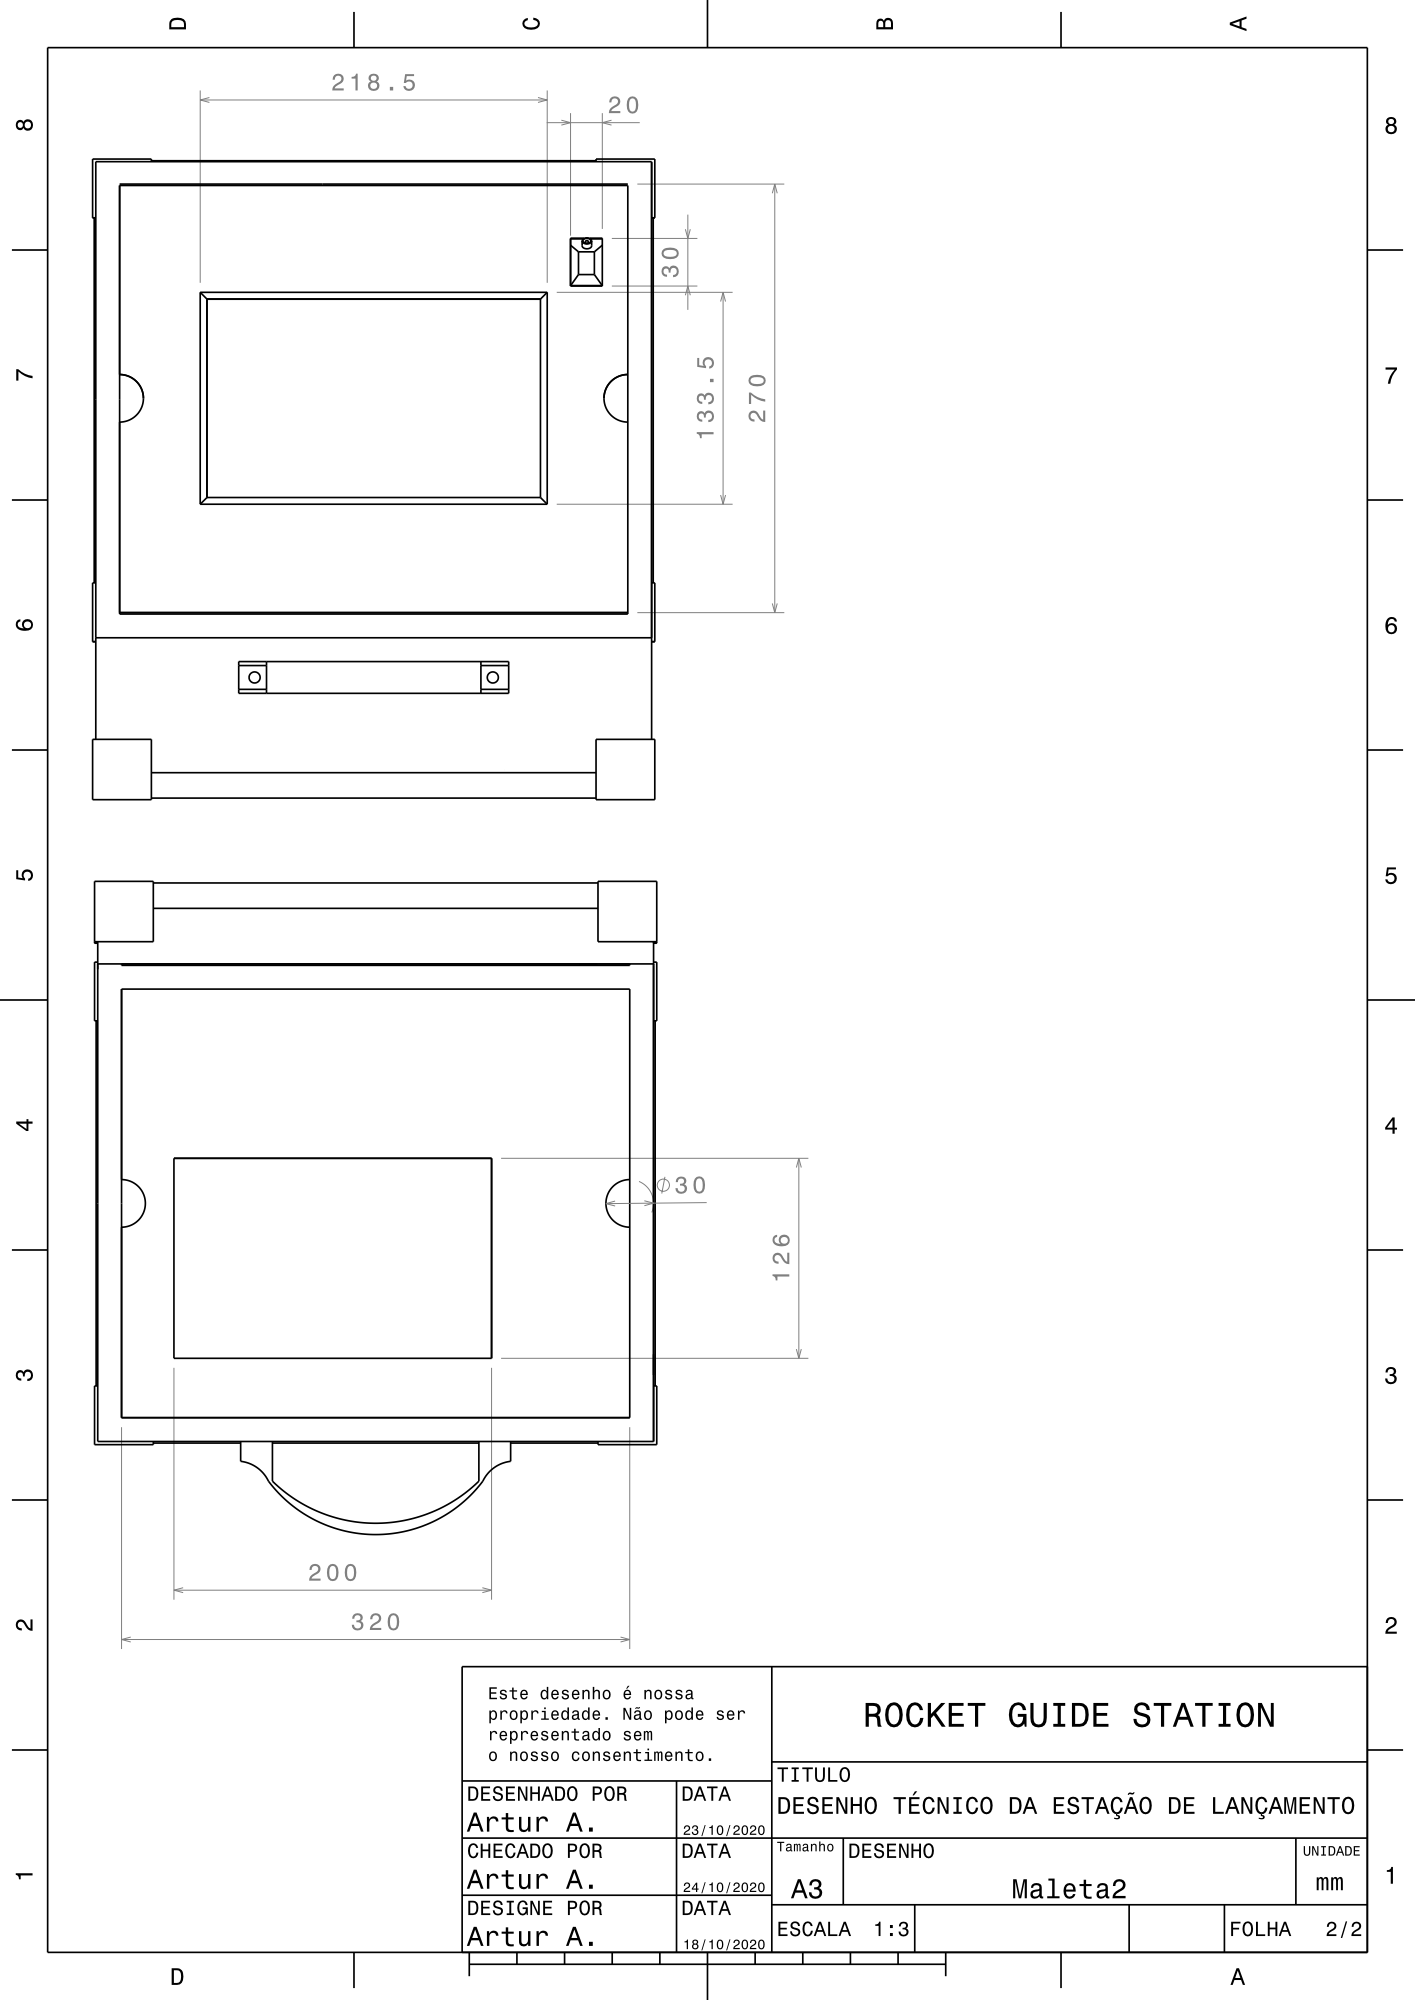
[picture p493: page 1]
