Ground-Station/Documentation/Estrutura/PC3/Carregador/Desenho Técnico do Carregador.pdf

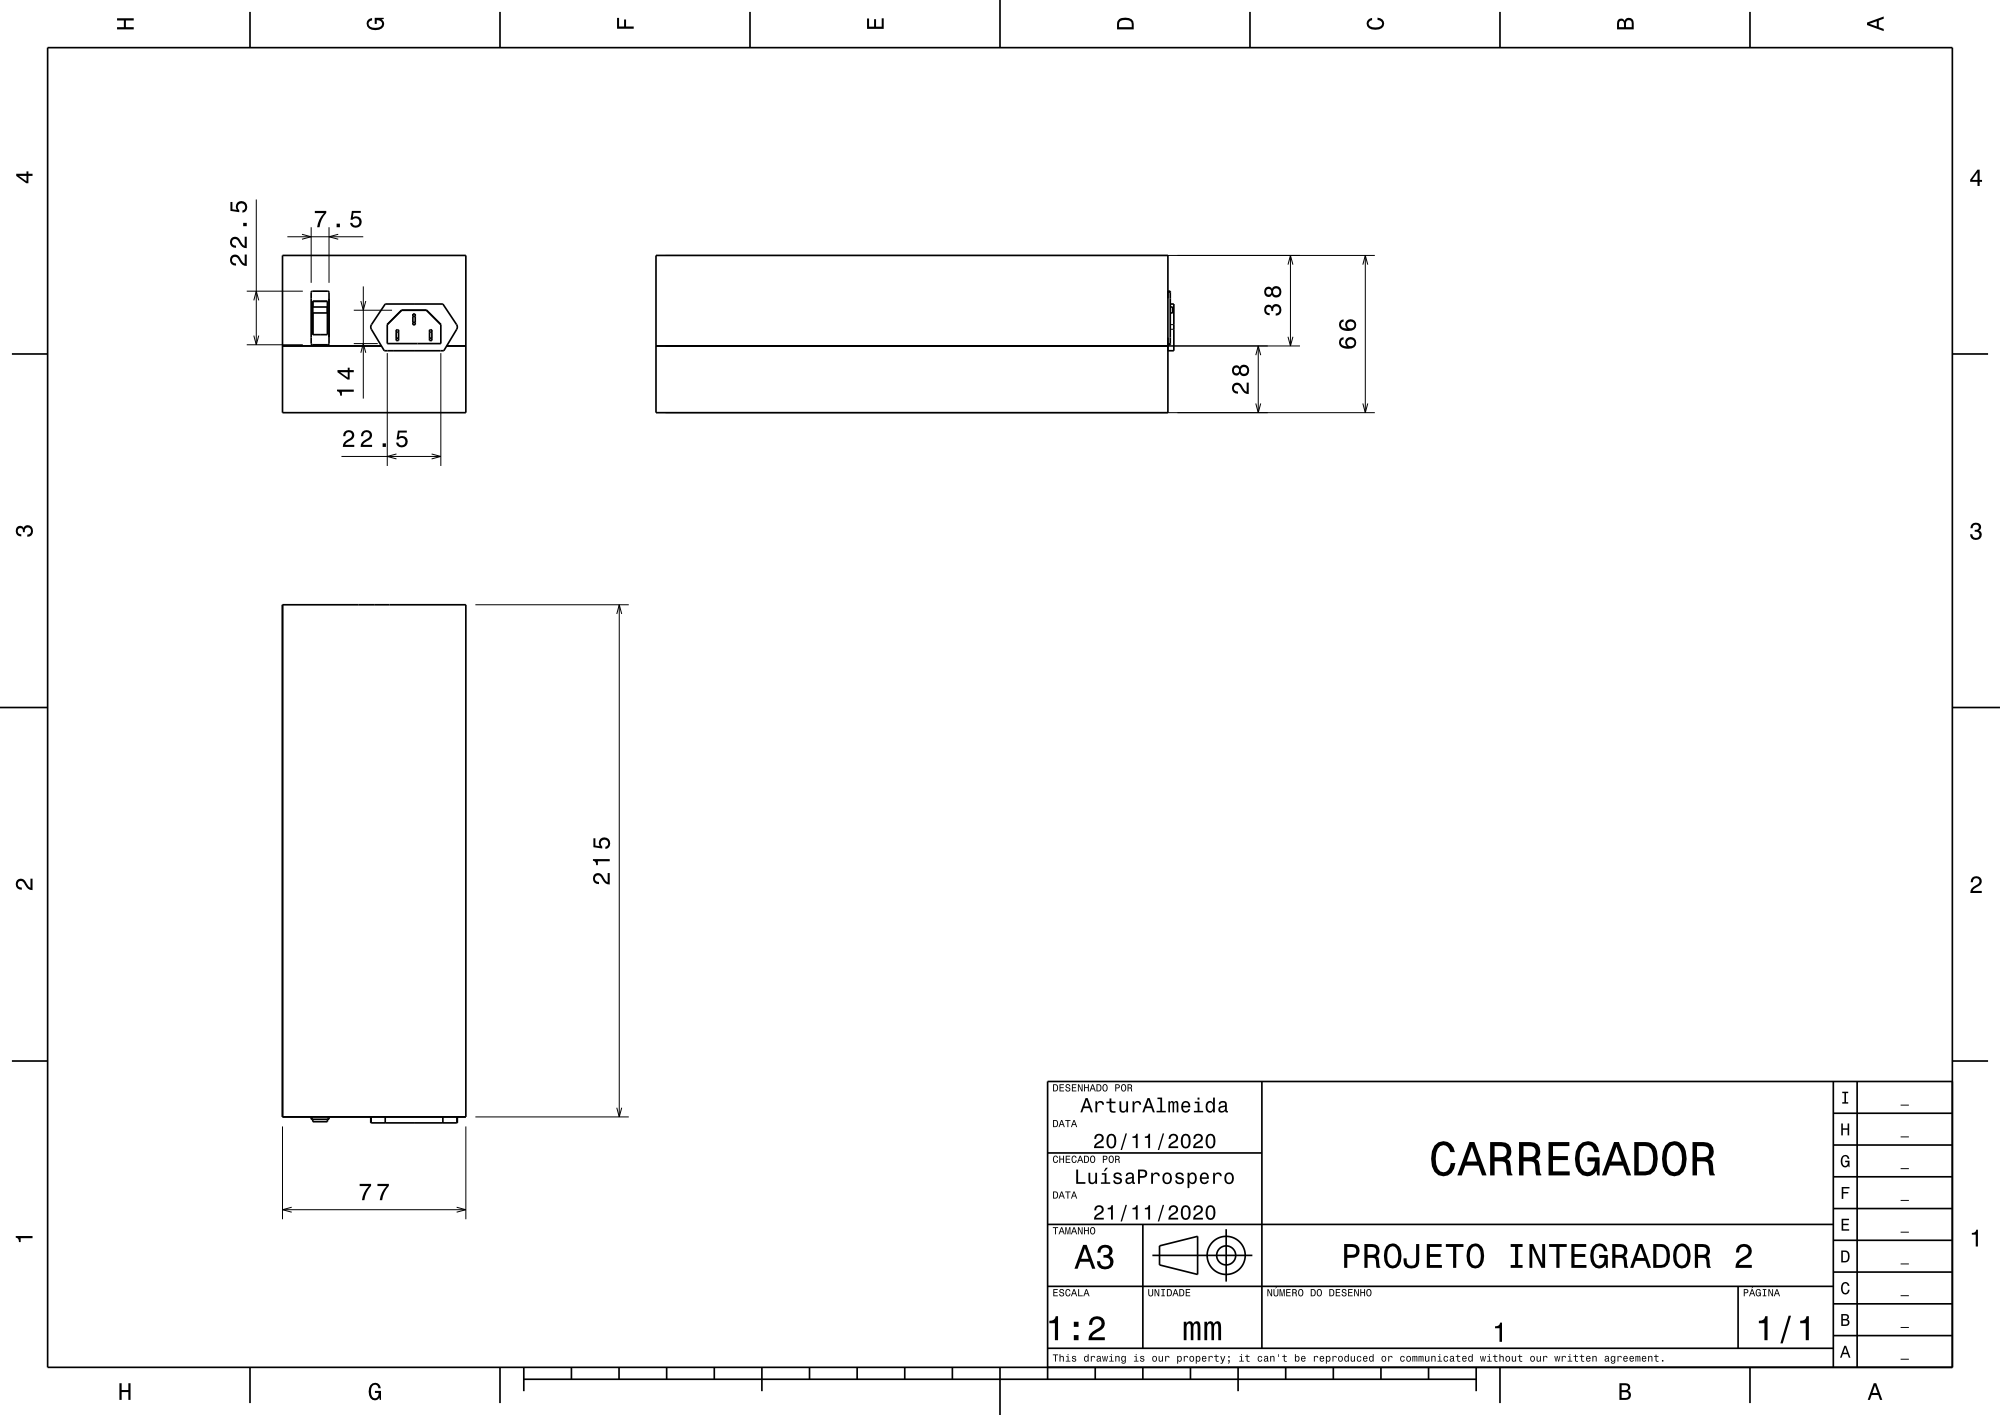
[picture p494: page 1]
