Ground-Station/Documentation/Estrutura/PC3/Carregador/Vistas do Carregador sem a parte superior.pdf

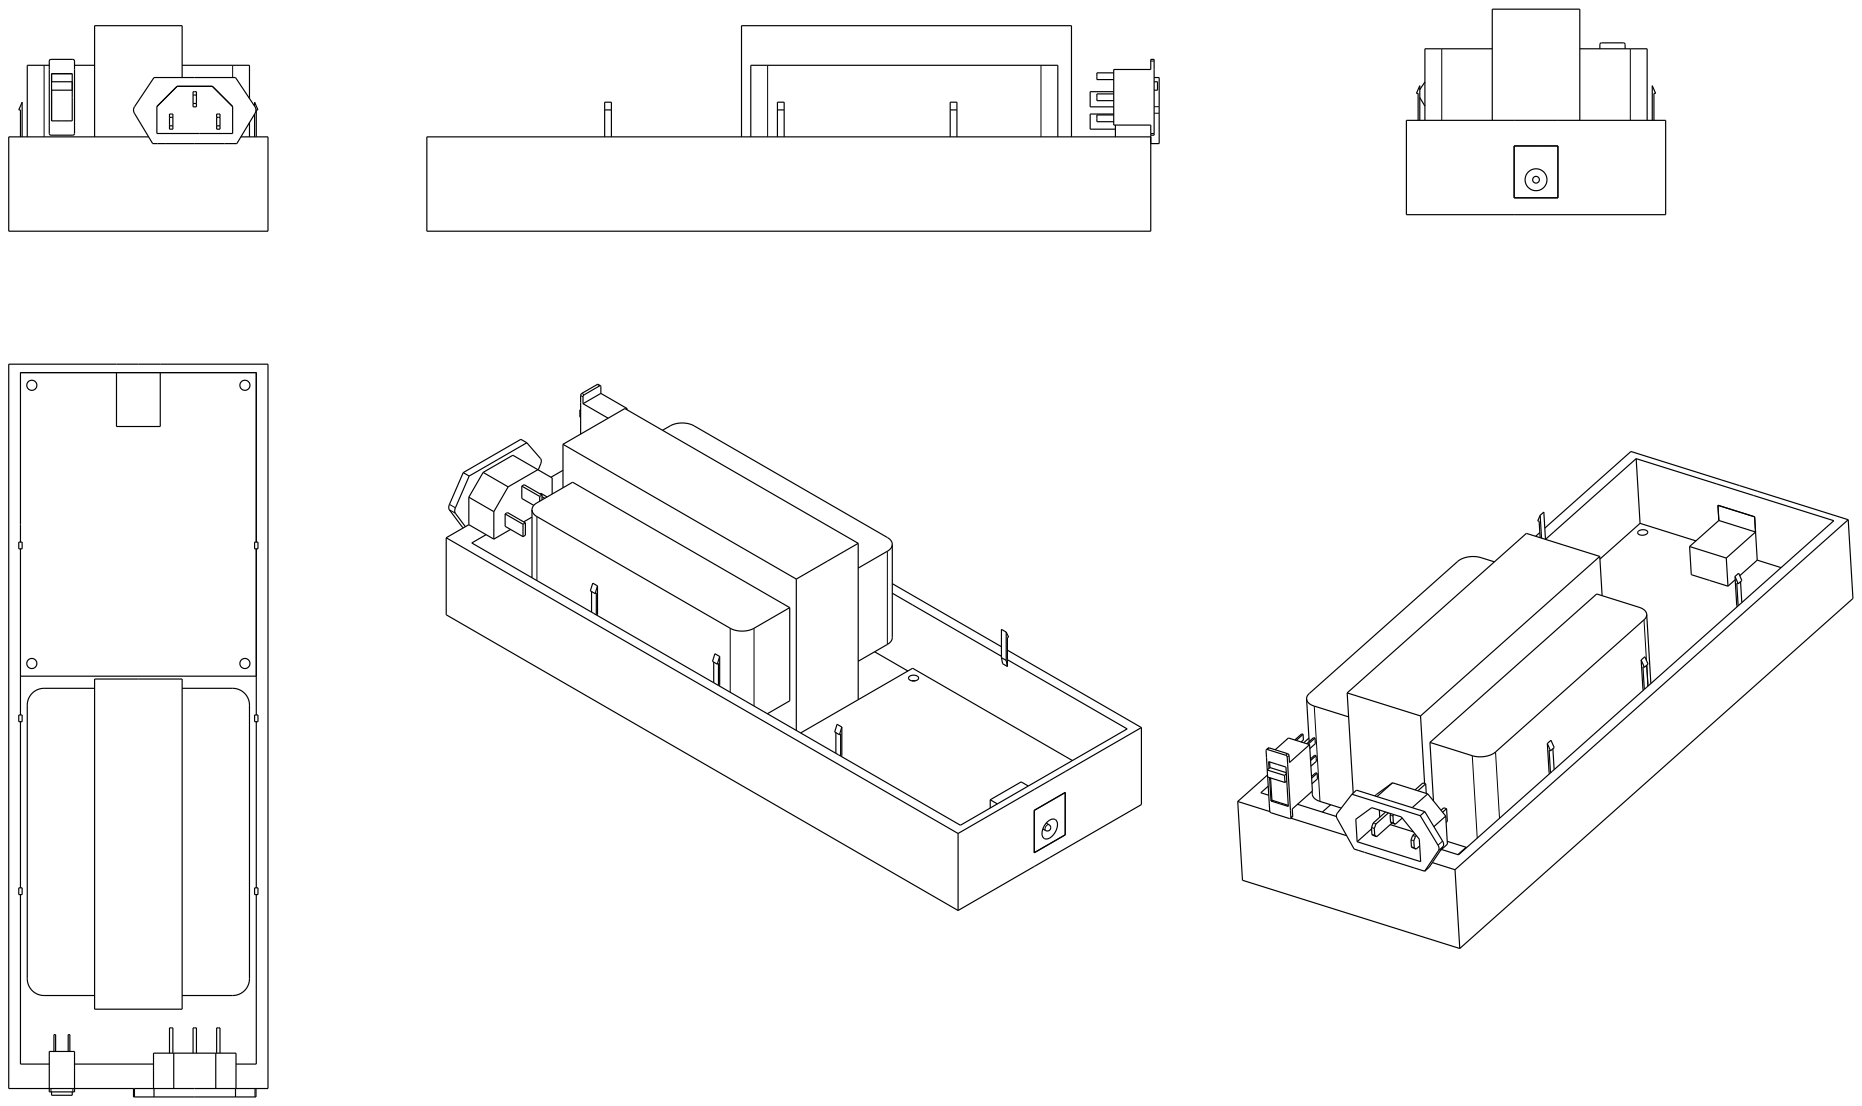
[picture p495: page 1]
