Ground-Station/Documentation/Estrutura/PC3/Carregador/Vistas do Carregador.pdf

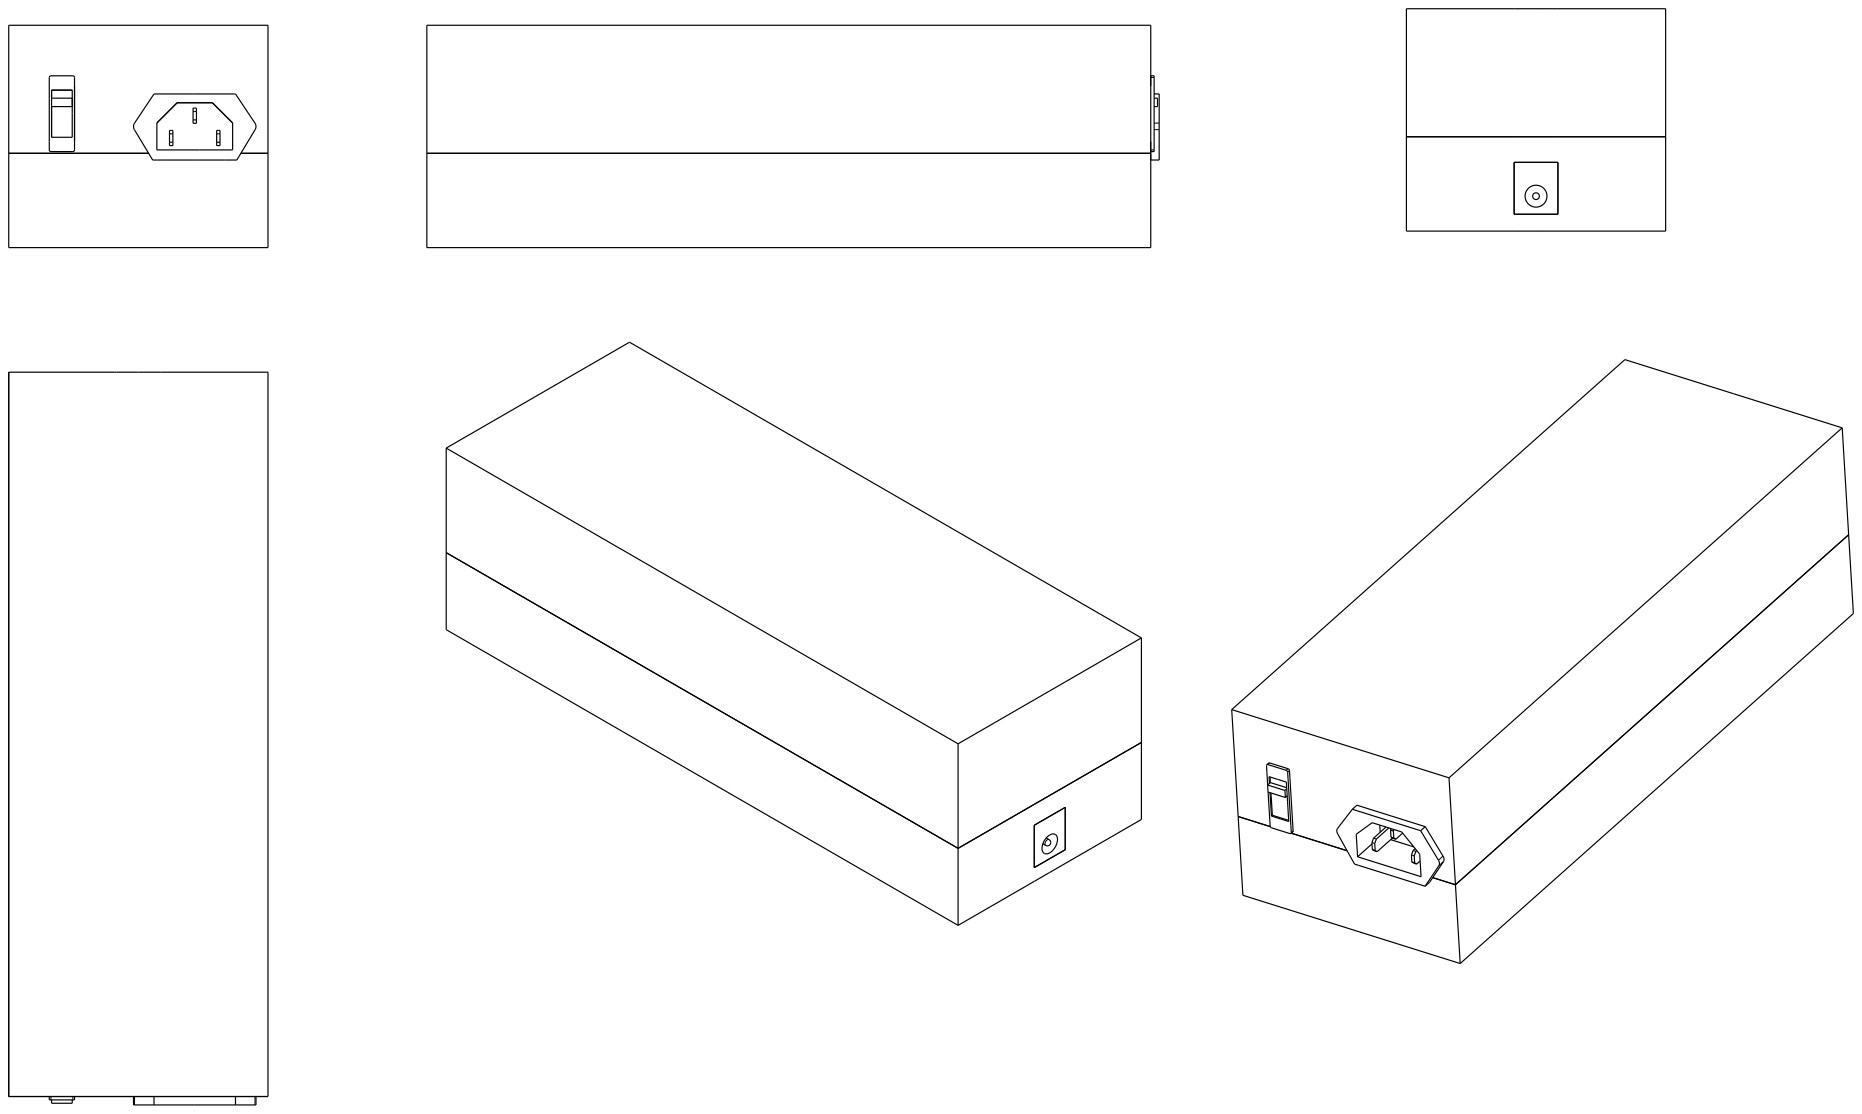
[picture p496: page 1]
