Ground-Station/Documentation/Estrutura/PC3/Case de Eletrônica/Desenho Técnico da Case de Eletrônica.pdf

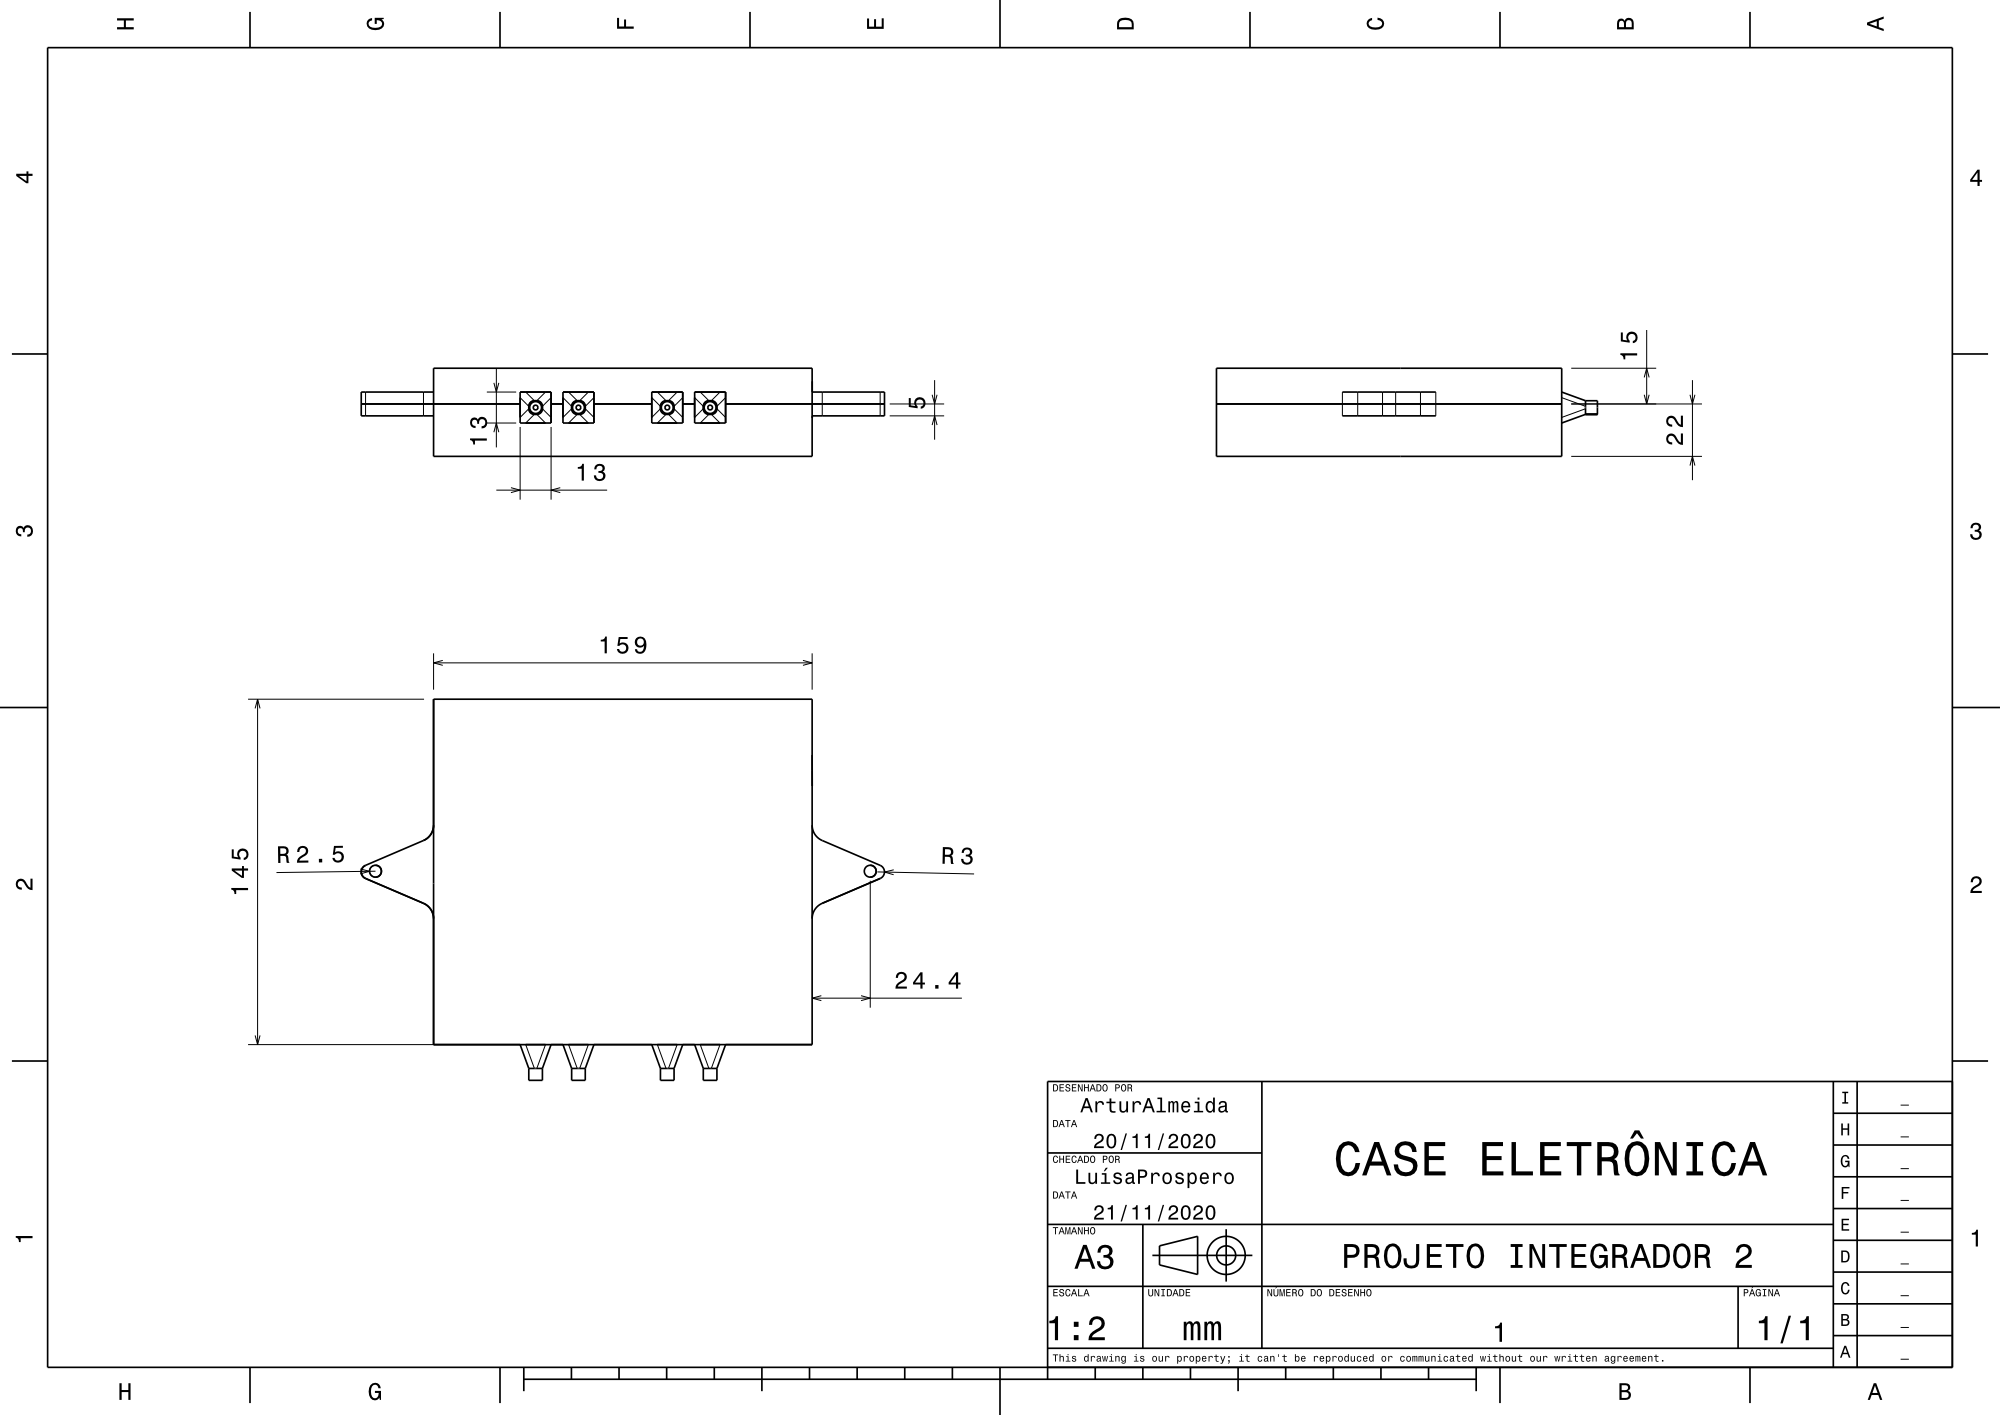
[picture p497: page 1]
