Ground-Station/Documentation/Estrutura/PC3/Case de Eletrônica/Vistas da Case de Eletrônica.pdf

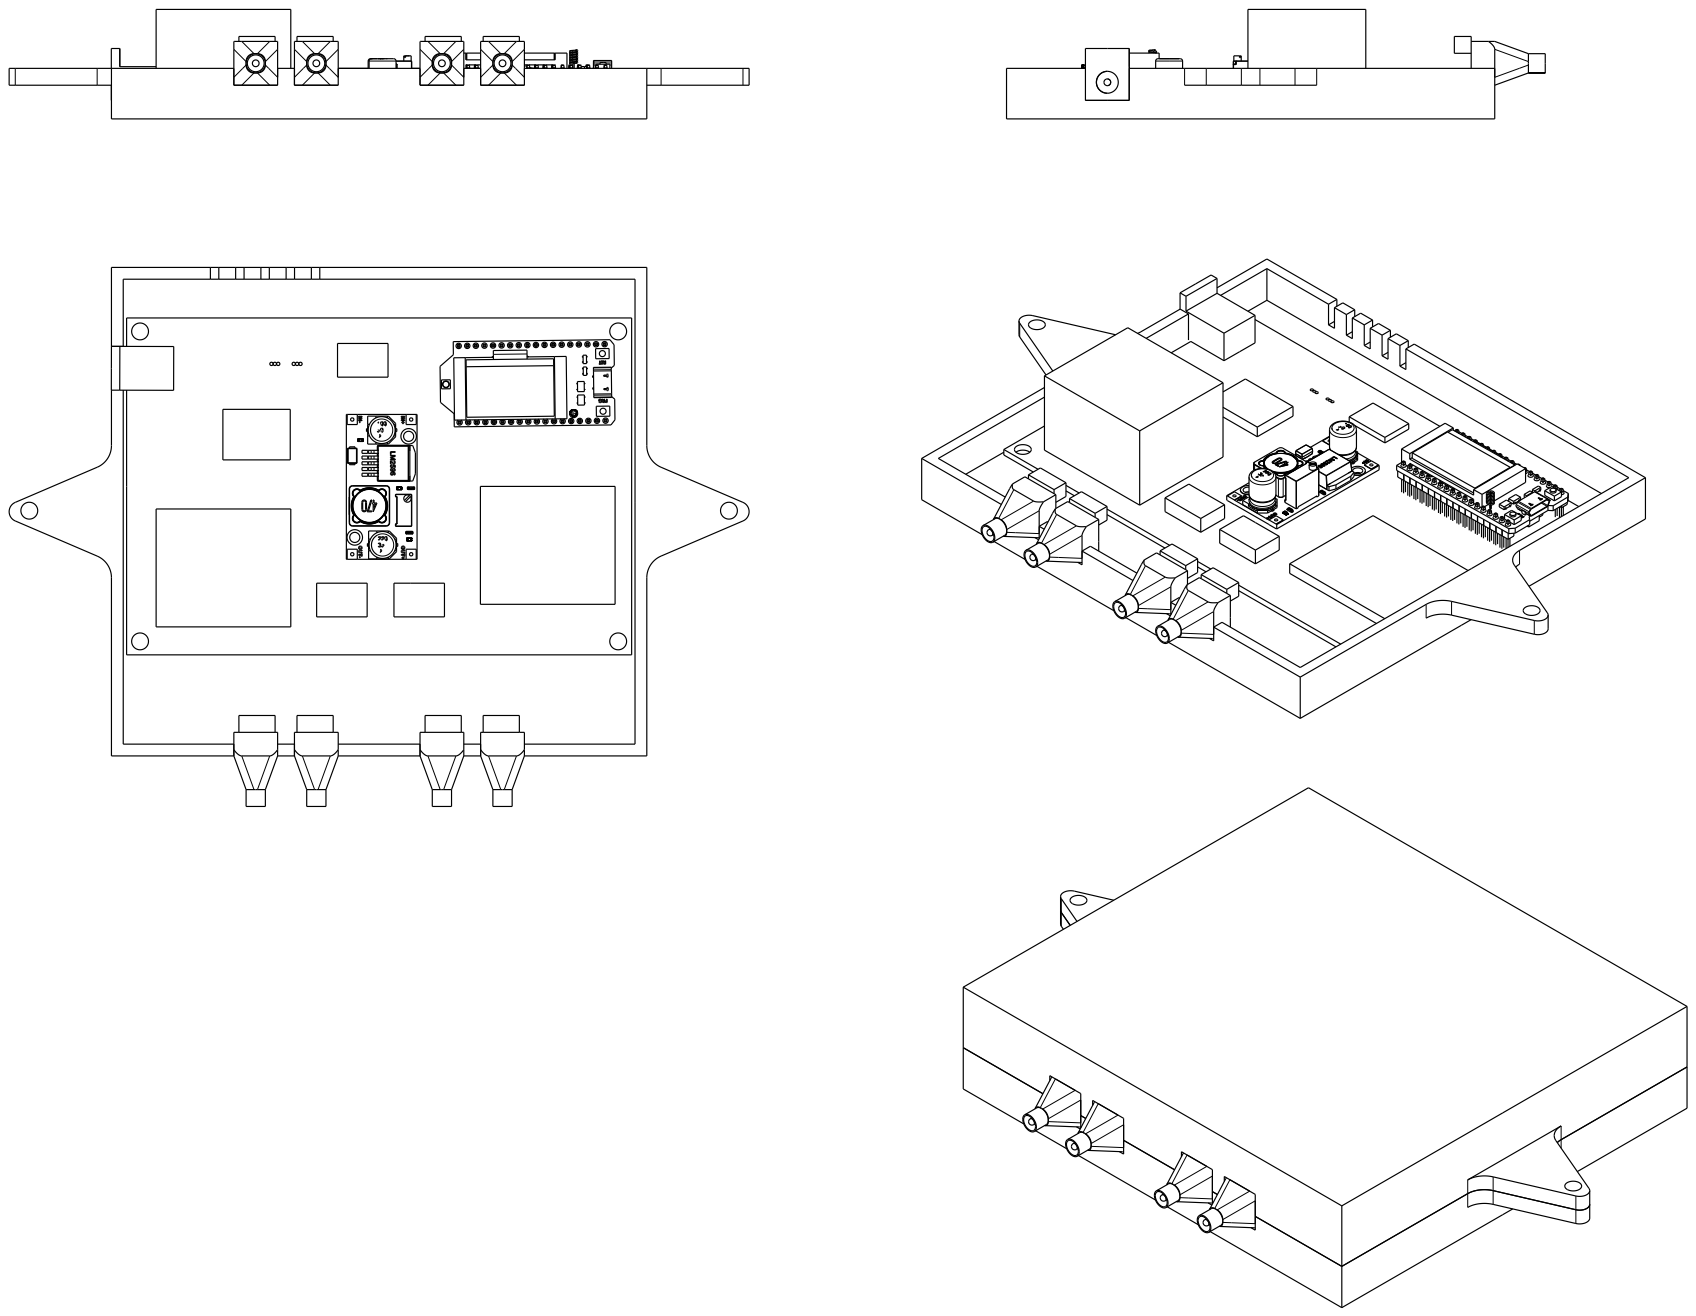
[picture p498: page 1]
