Ground-Station/Documentation/Estrutura/PC3/Desenho Técnico/Desenho Técnico da Maleta de Alimentação 01.pdf

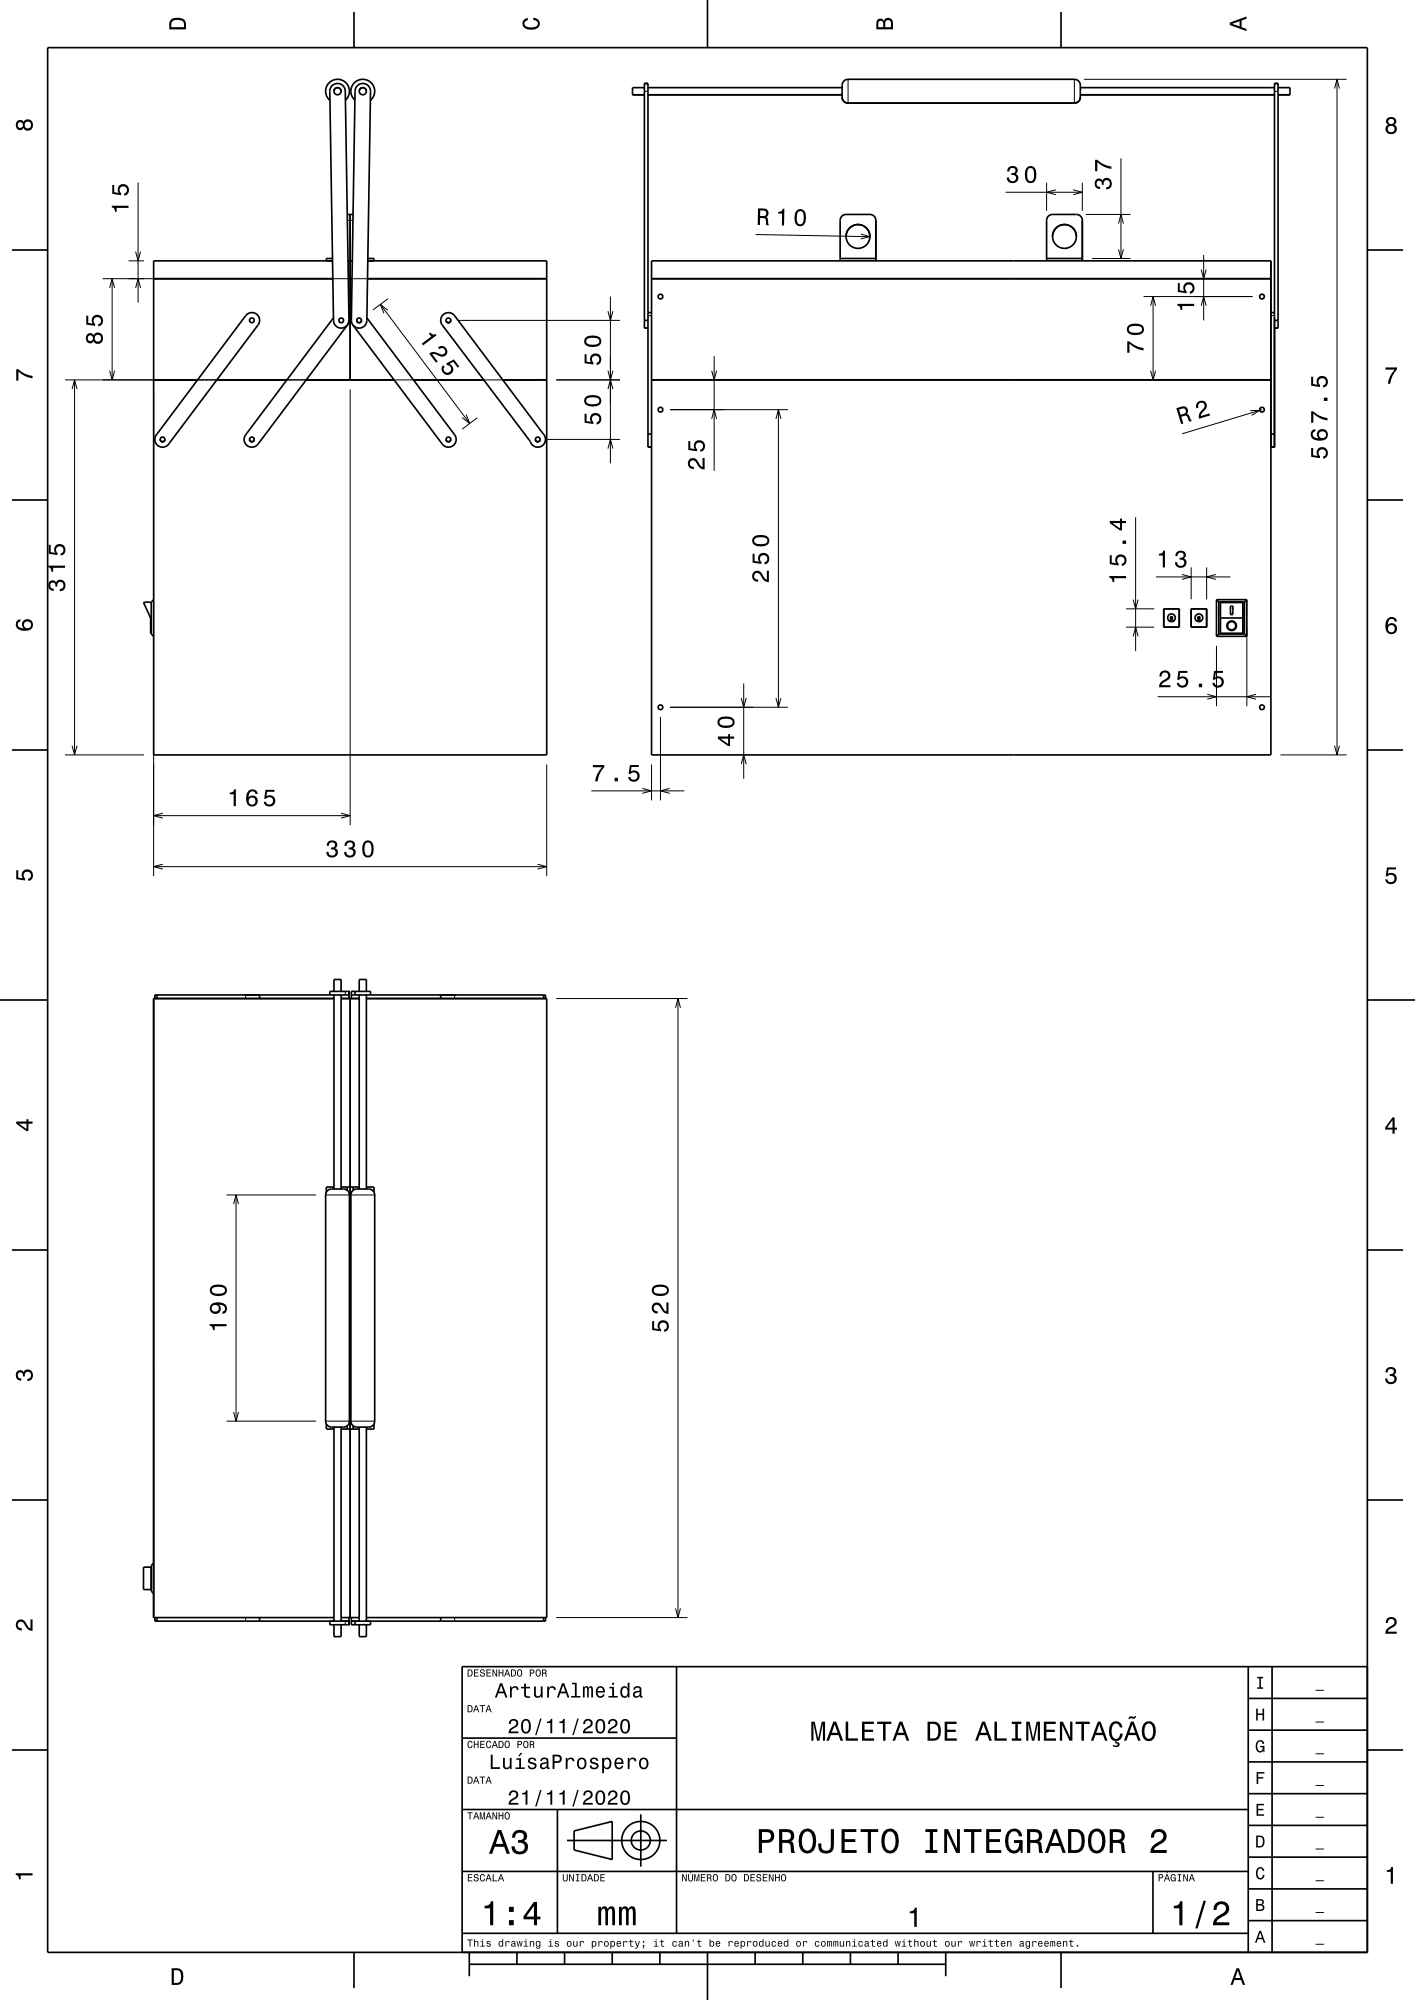
[picture p499: page 1]
