Ground-Station/Documentation/Estrutura/PC3/Desenho Técnico/Desenho Técnico da Maleta de Alimentação 02.pdf

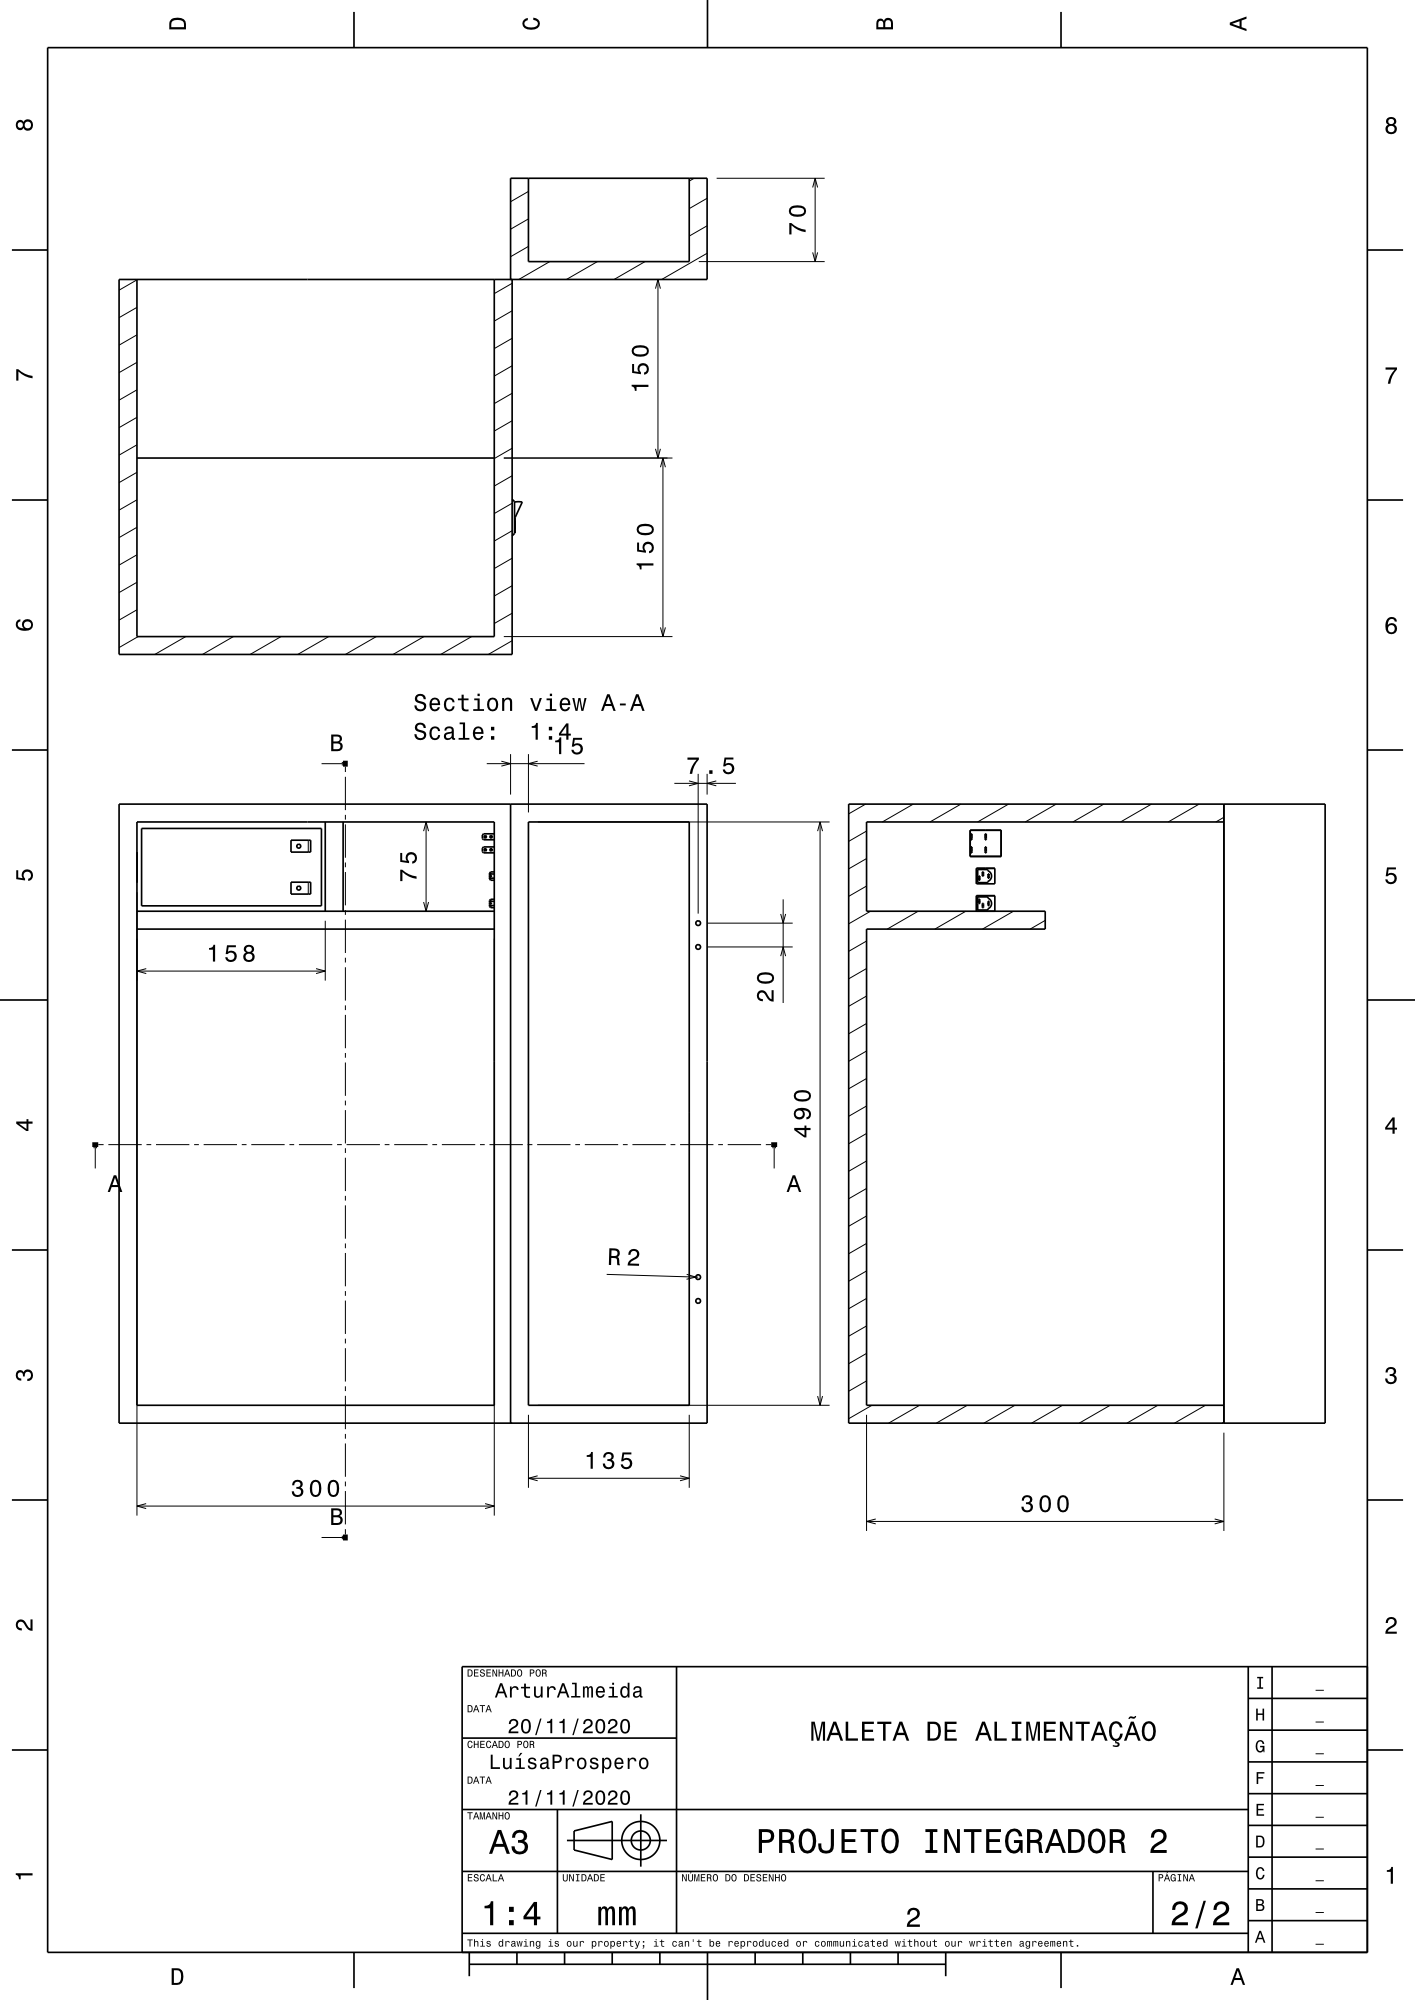
[picture p500: page 1]
