Ground-Station/Documentation/Estrutura/PC3/Desenho Técnico/Desenho Técnico da Maleta GCS 01.pdf

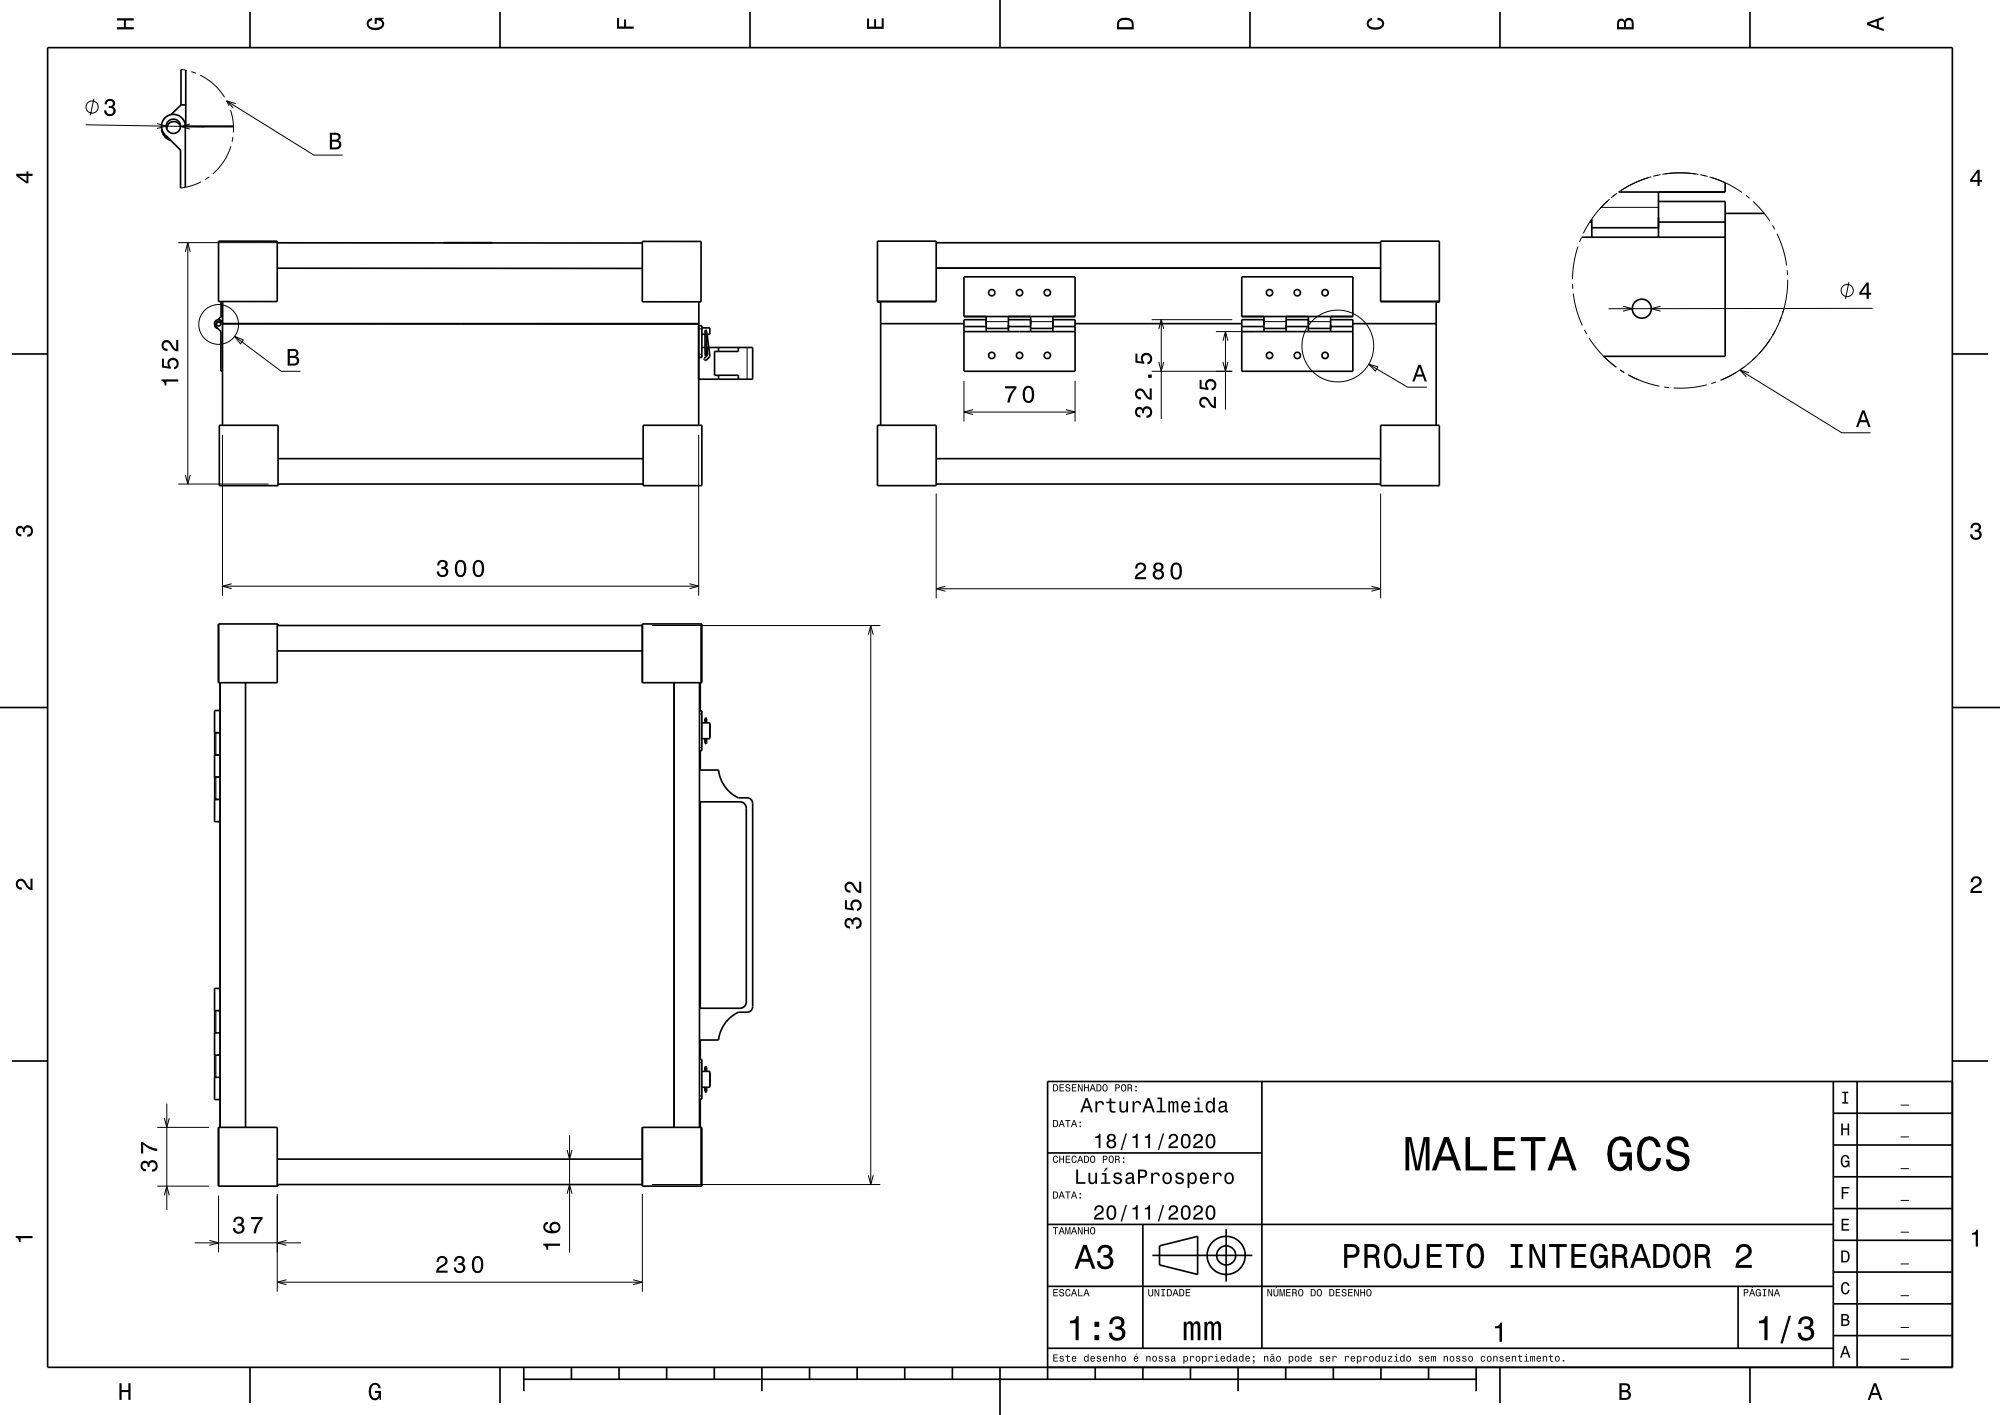
[picture p501: page 1]
