Ground-Station/Documentation/Estrutura/PC3/Desenho Técnico/Desenho Técnico da Maleta GCS 02.pdf

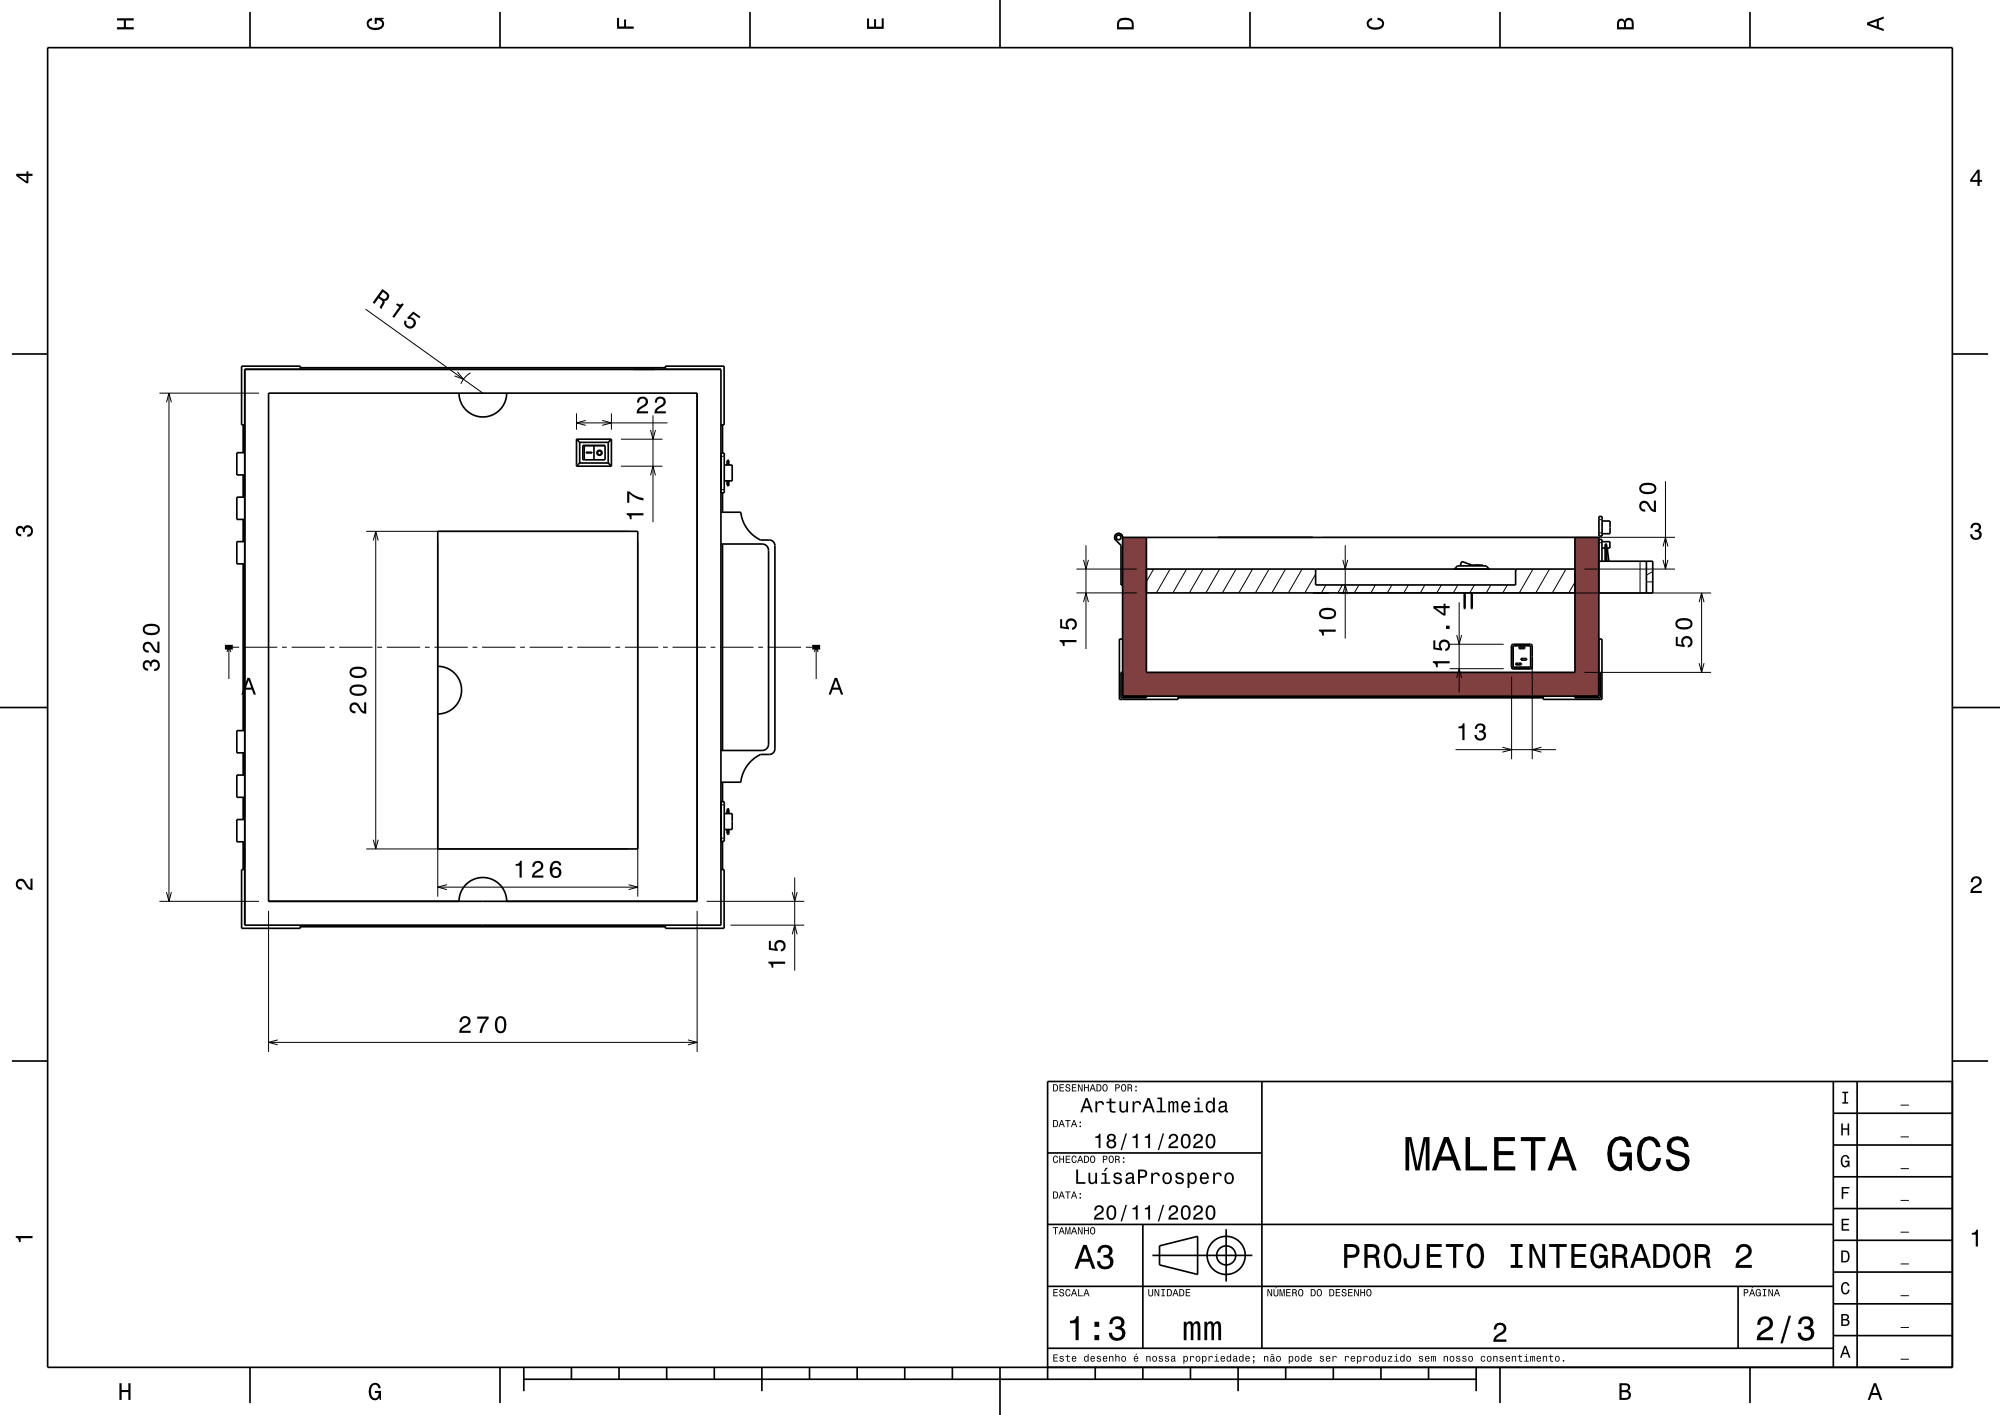
[picture p502: page 1]
