Ground-Station/Documentation/Estrutura/PC3/Desenho Técnico/Desenho Técnico da Maleta GCS 03.pdf

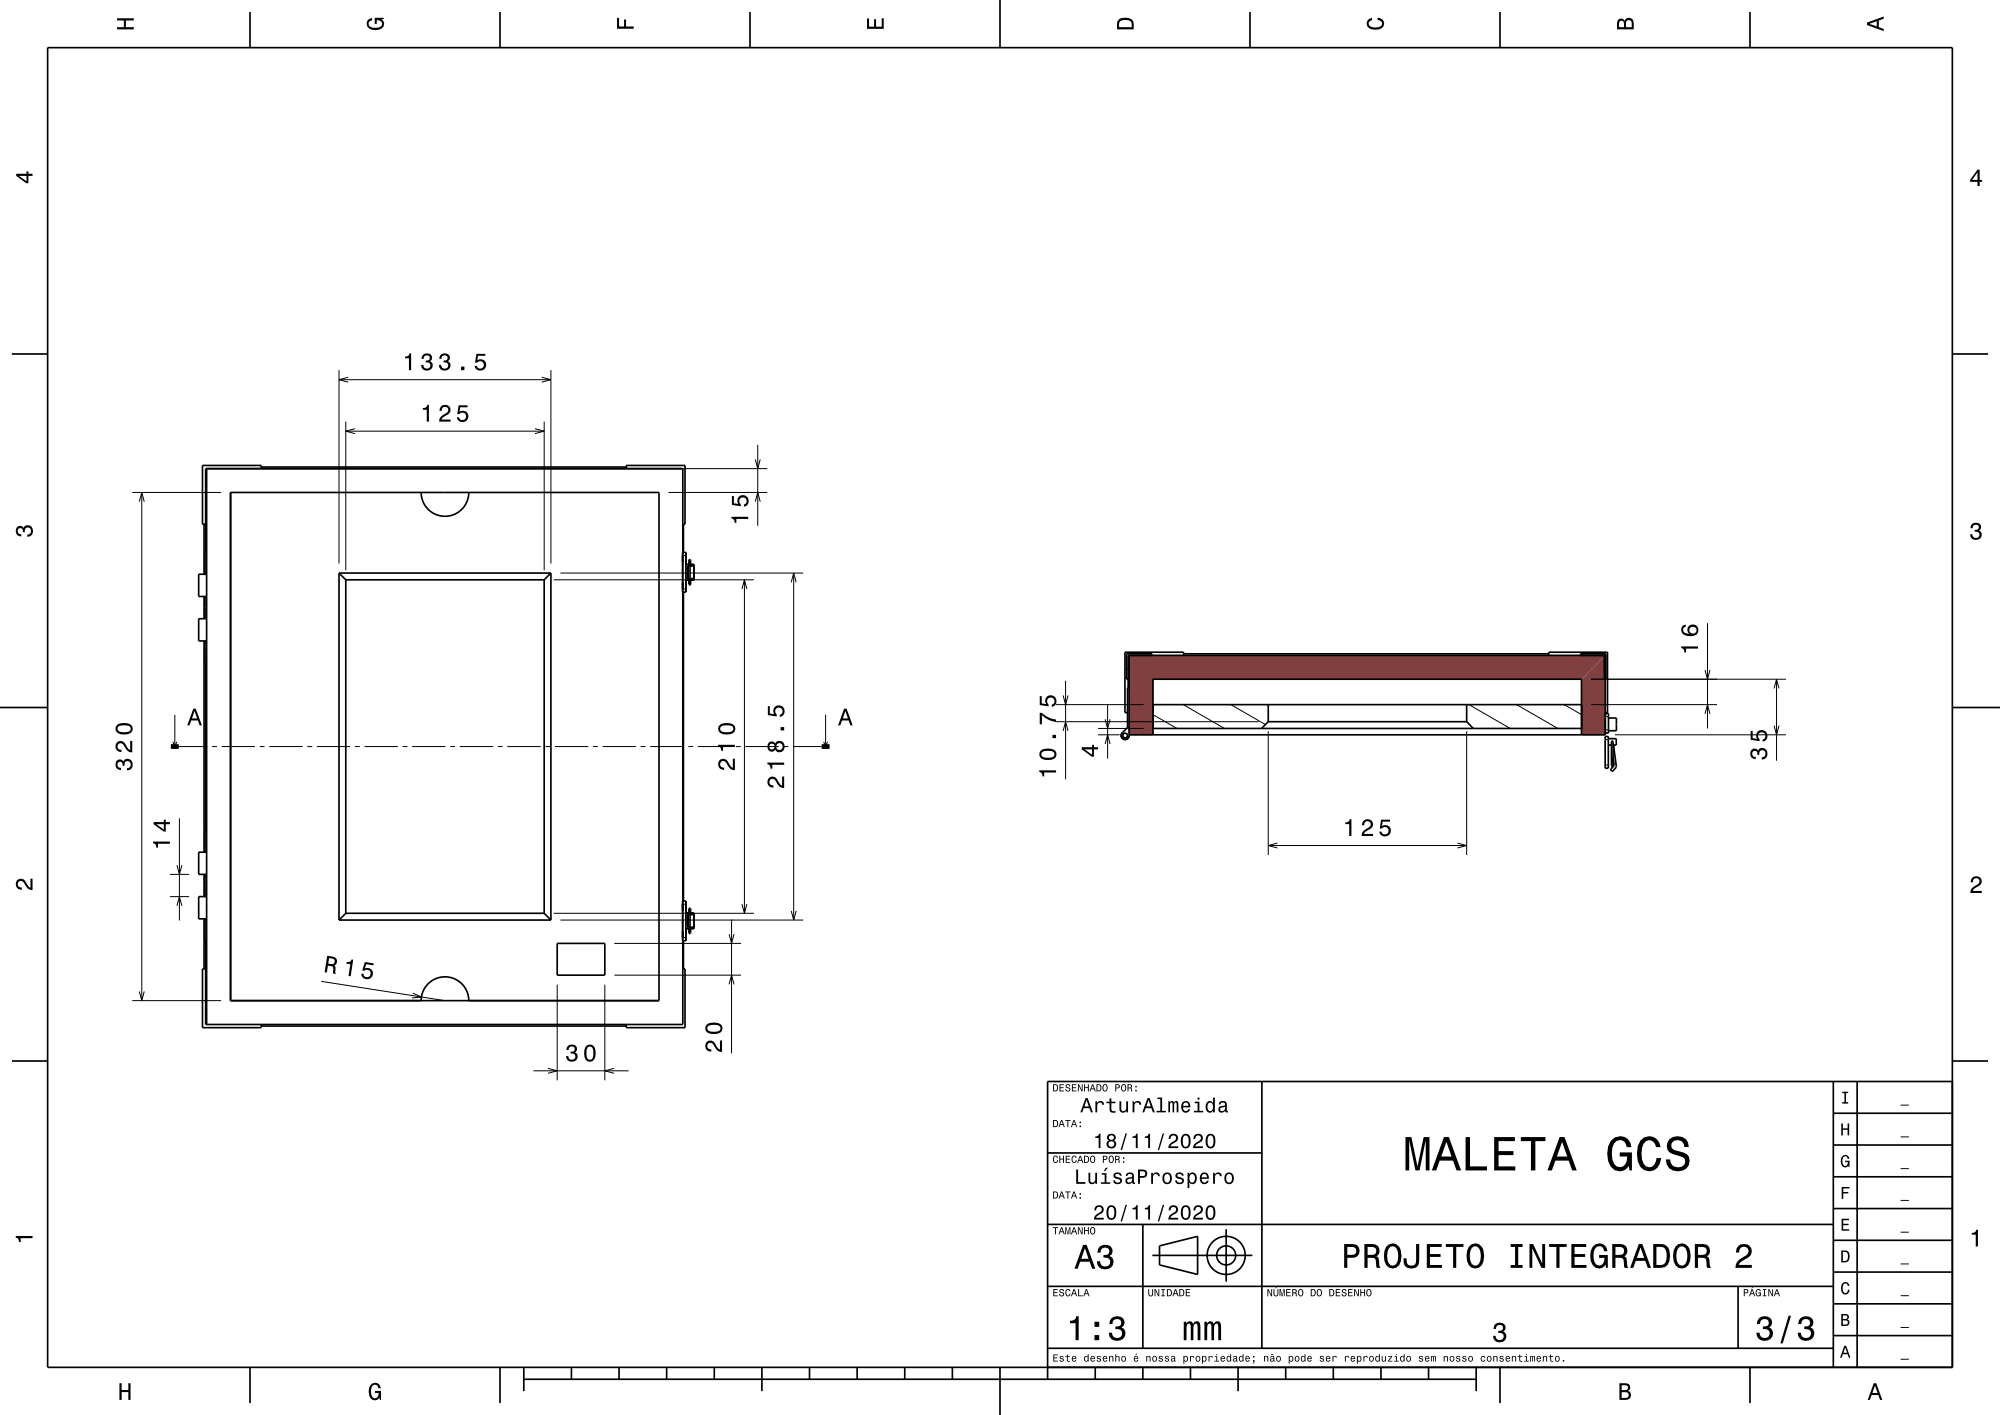
[picture p503: page 1]
