Ground-Station/Documentation/Estrutura/PC3/Imagens/Elementos Maleta de Abastecimento/Alças.pdf

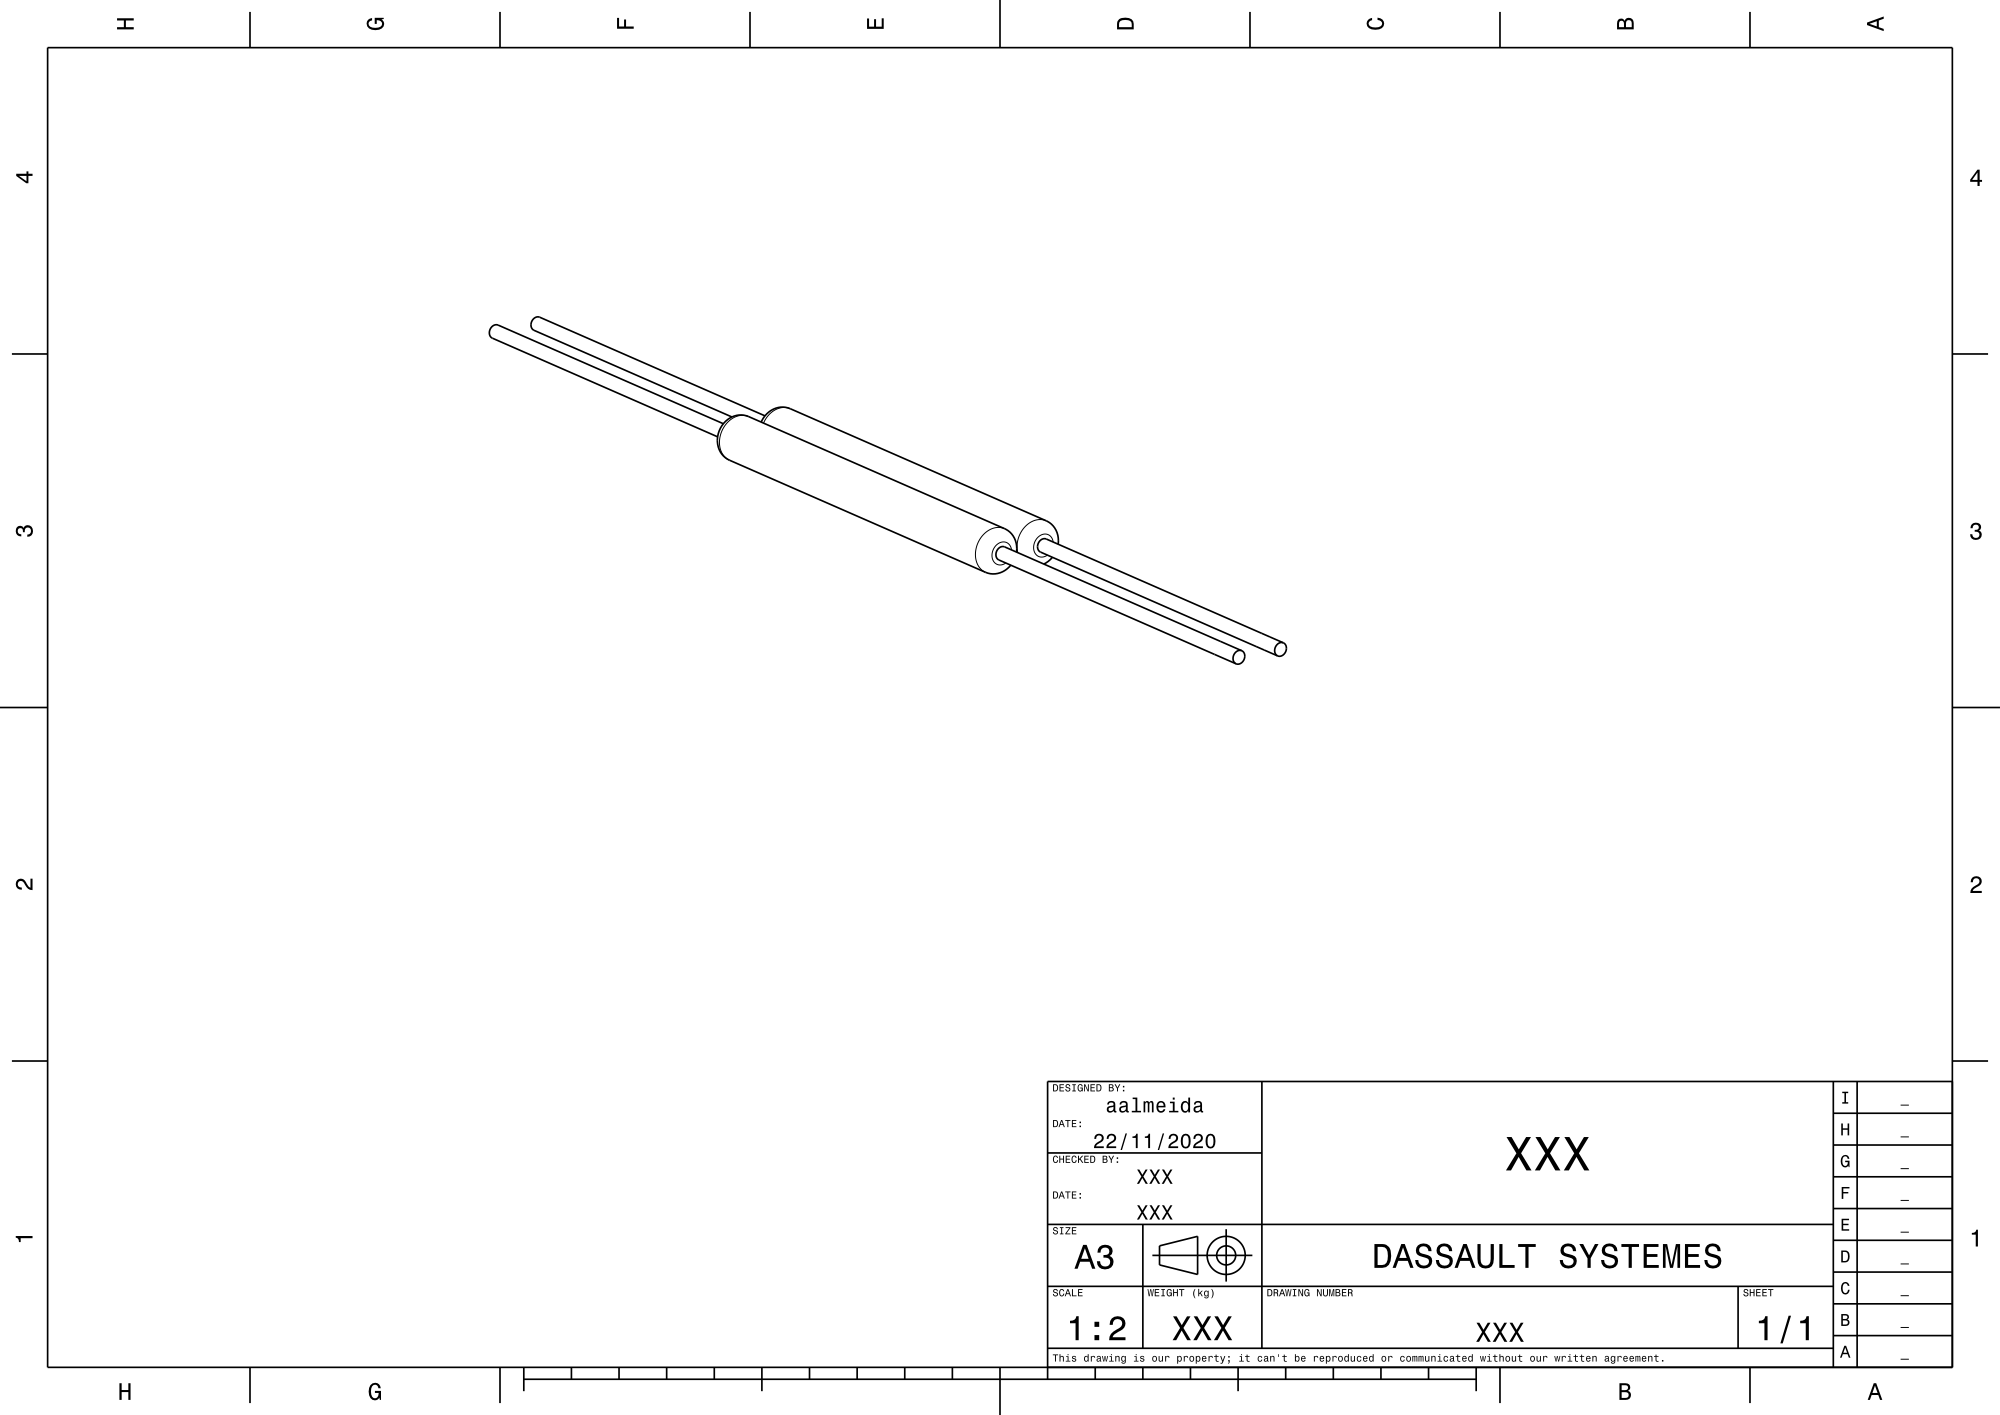
[picture p504: page 1]
