Ground-Station/Documentation/Estrutura/PC3/Imagens/Elementos Maleta de Abastecimento/Base.pdf

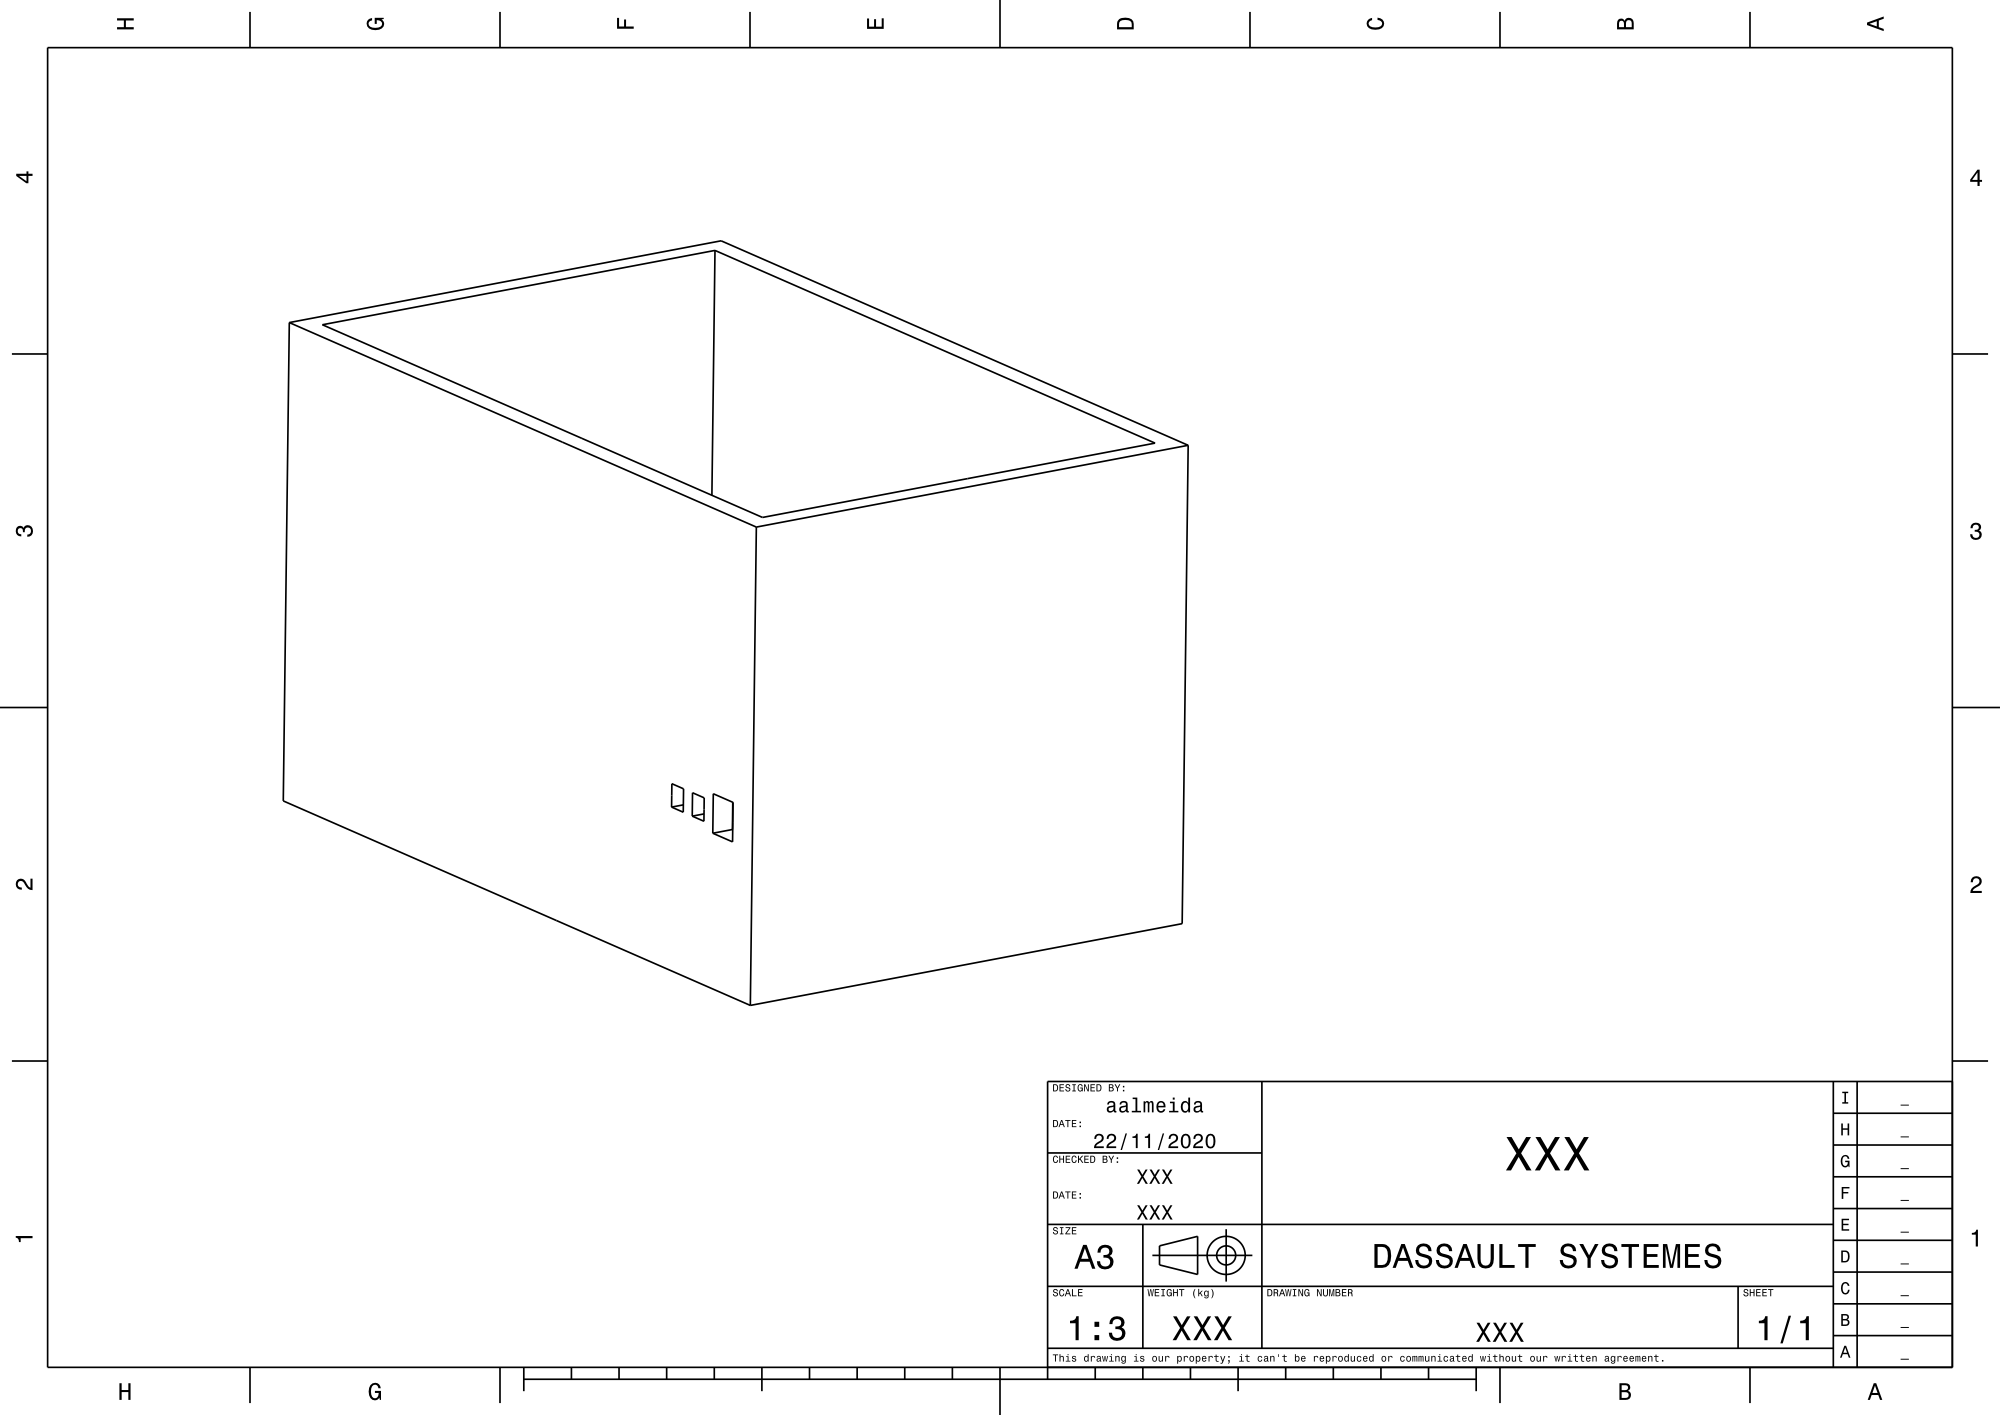
[picture p505: page 1]
