Ground-Station/Documentation/Estrutura/PC3/Imagens/Elementos Maleta de Abastecimento/Bases Laterais.pdf

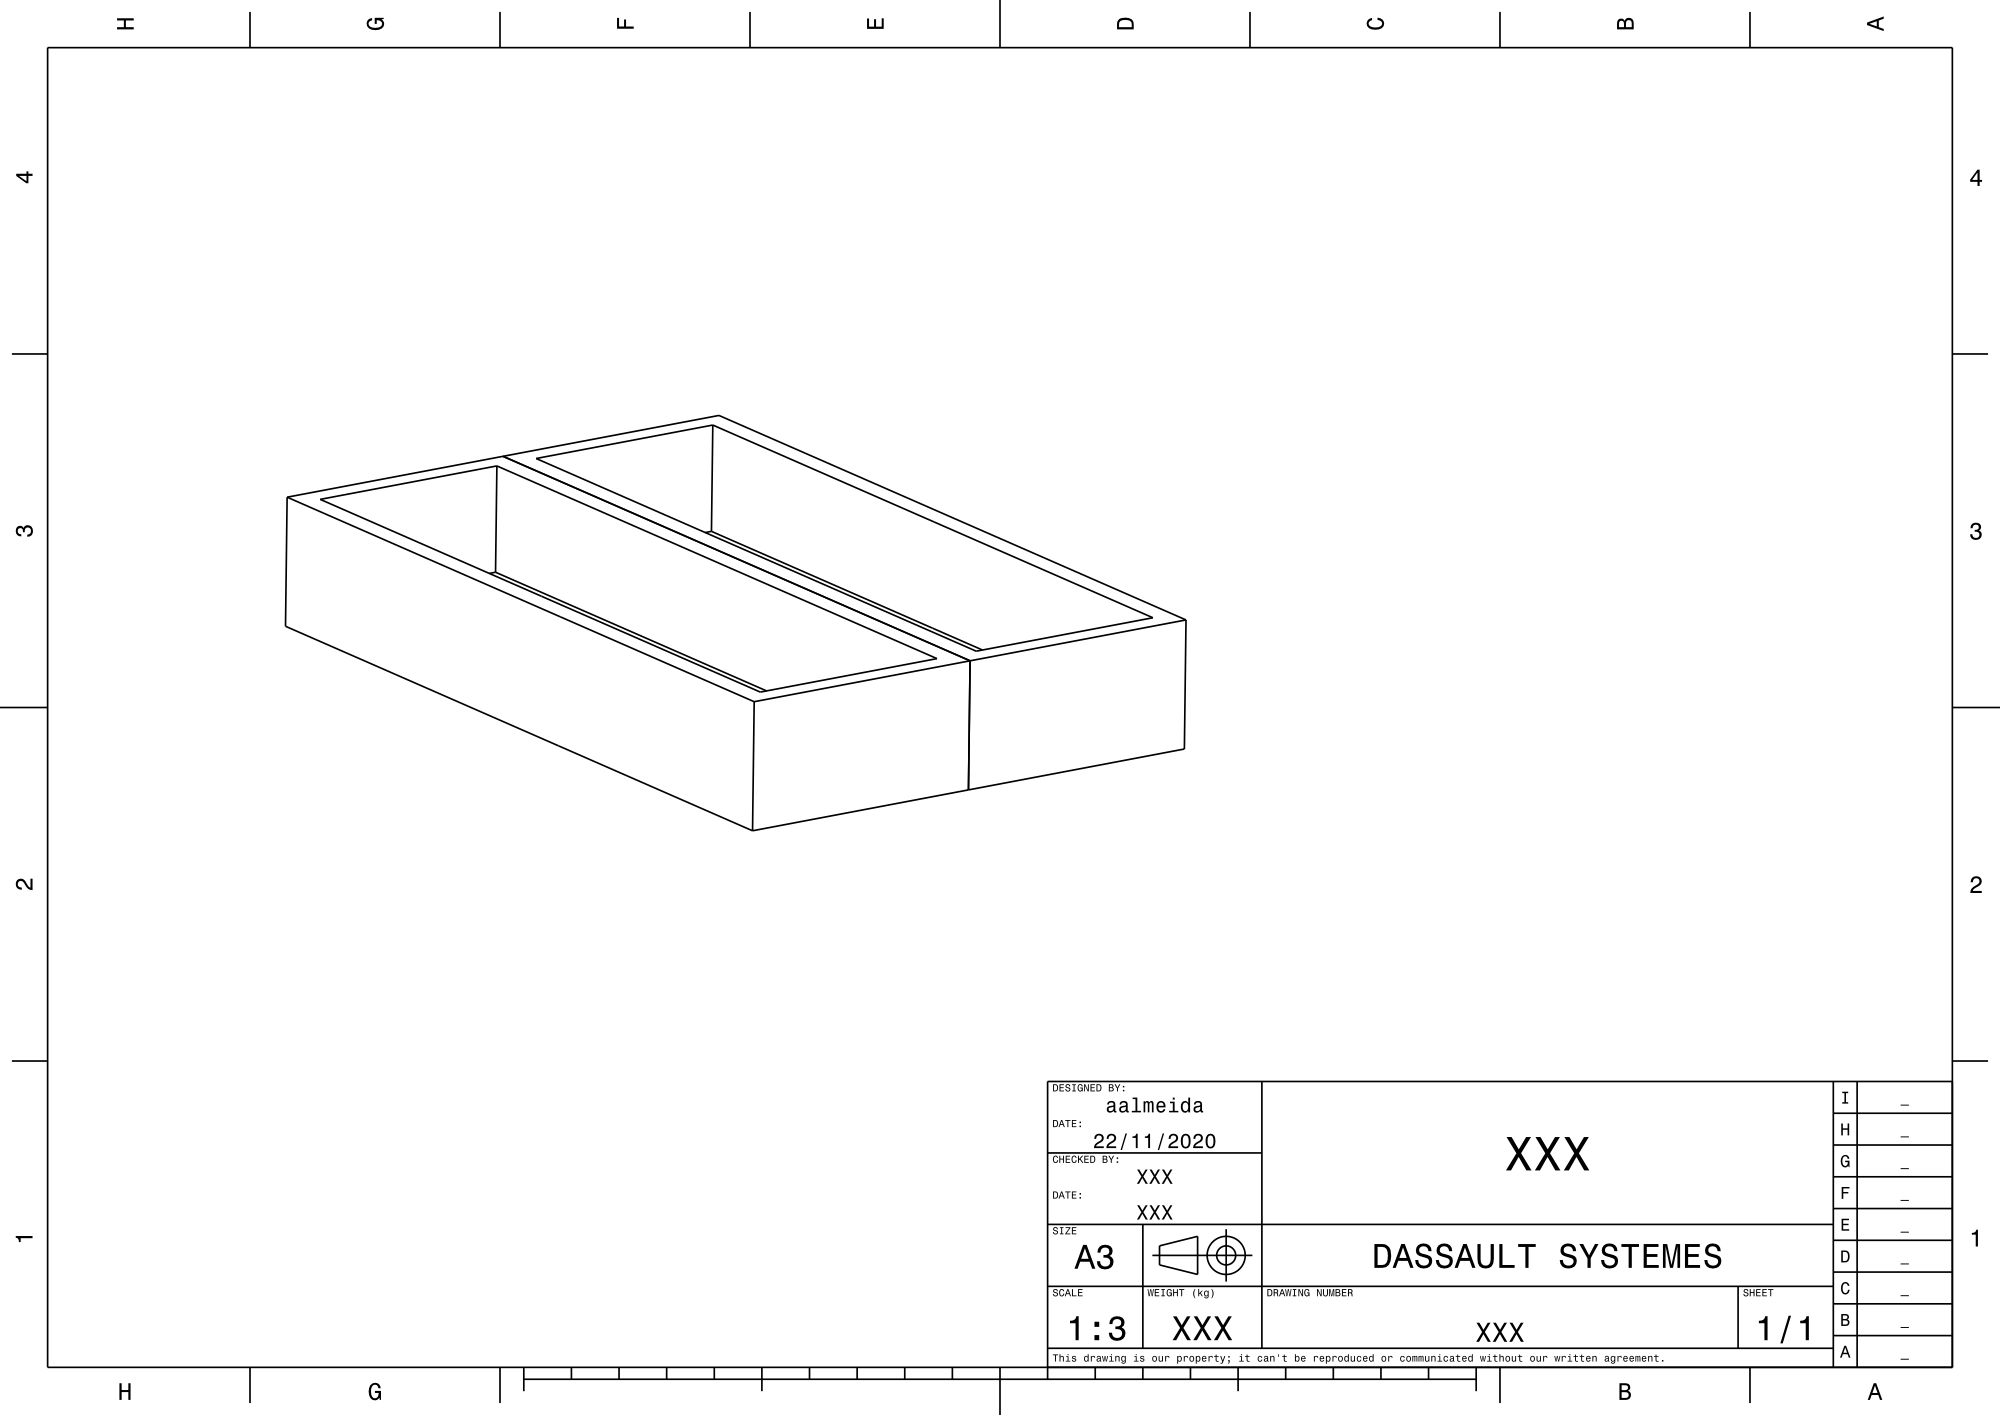
[picture p506: page 1]
