Ground-Station/Documentation/Estrutura/PC3/Imagens/Elementos Maleta de Abastecimento/Dobradiças Laterais.pdf

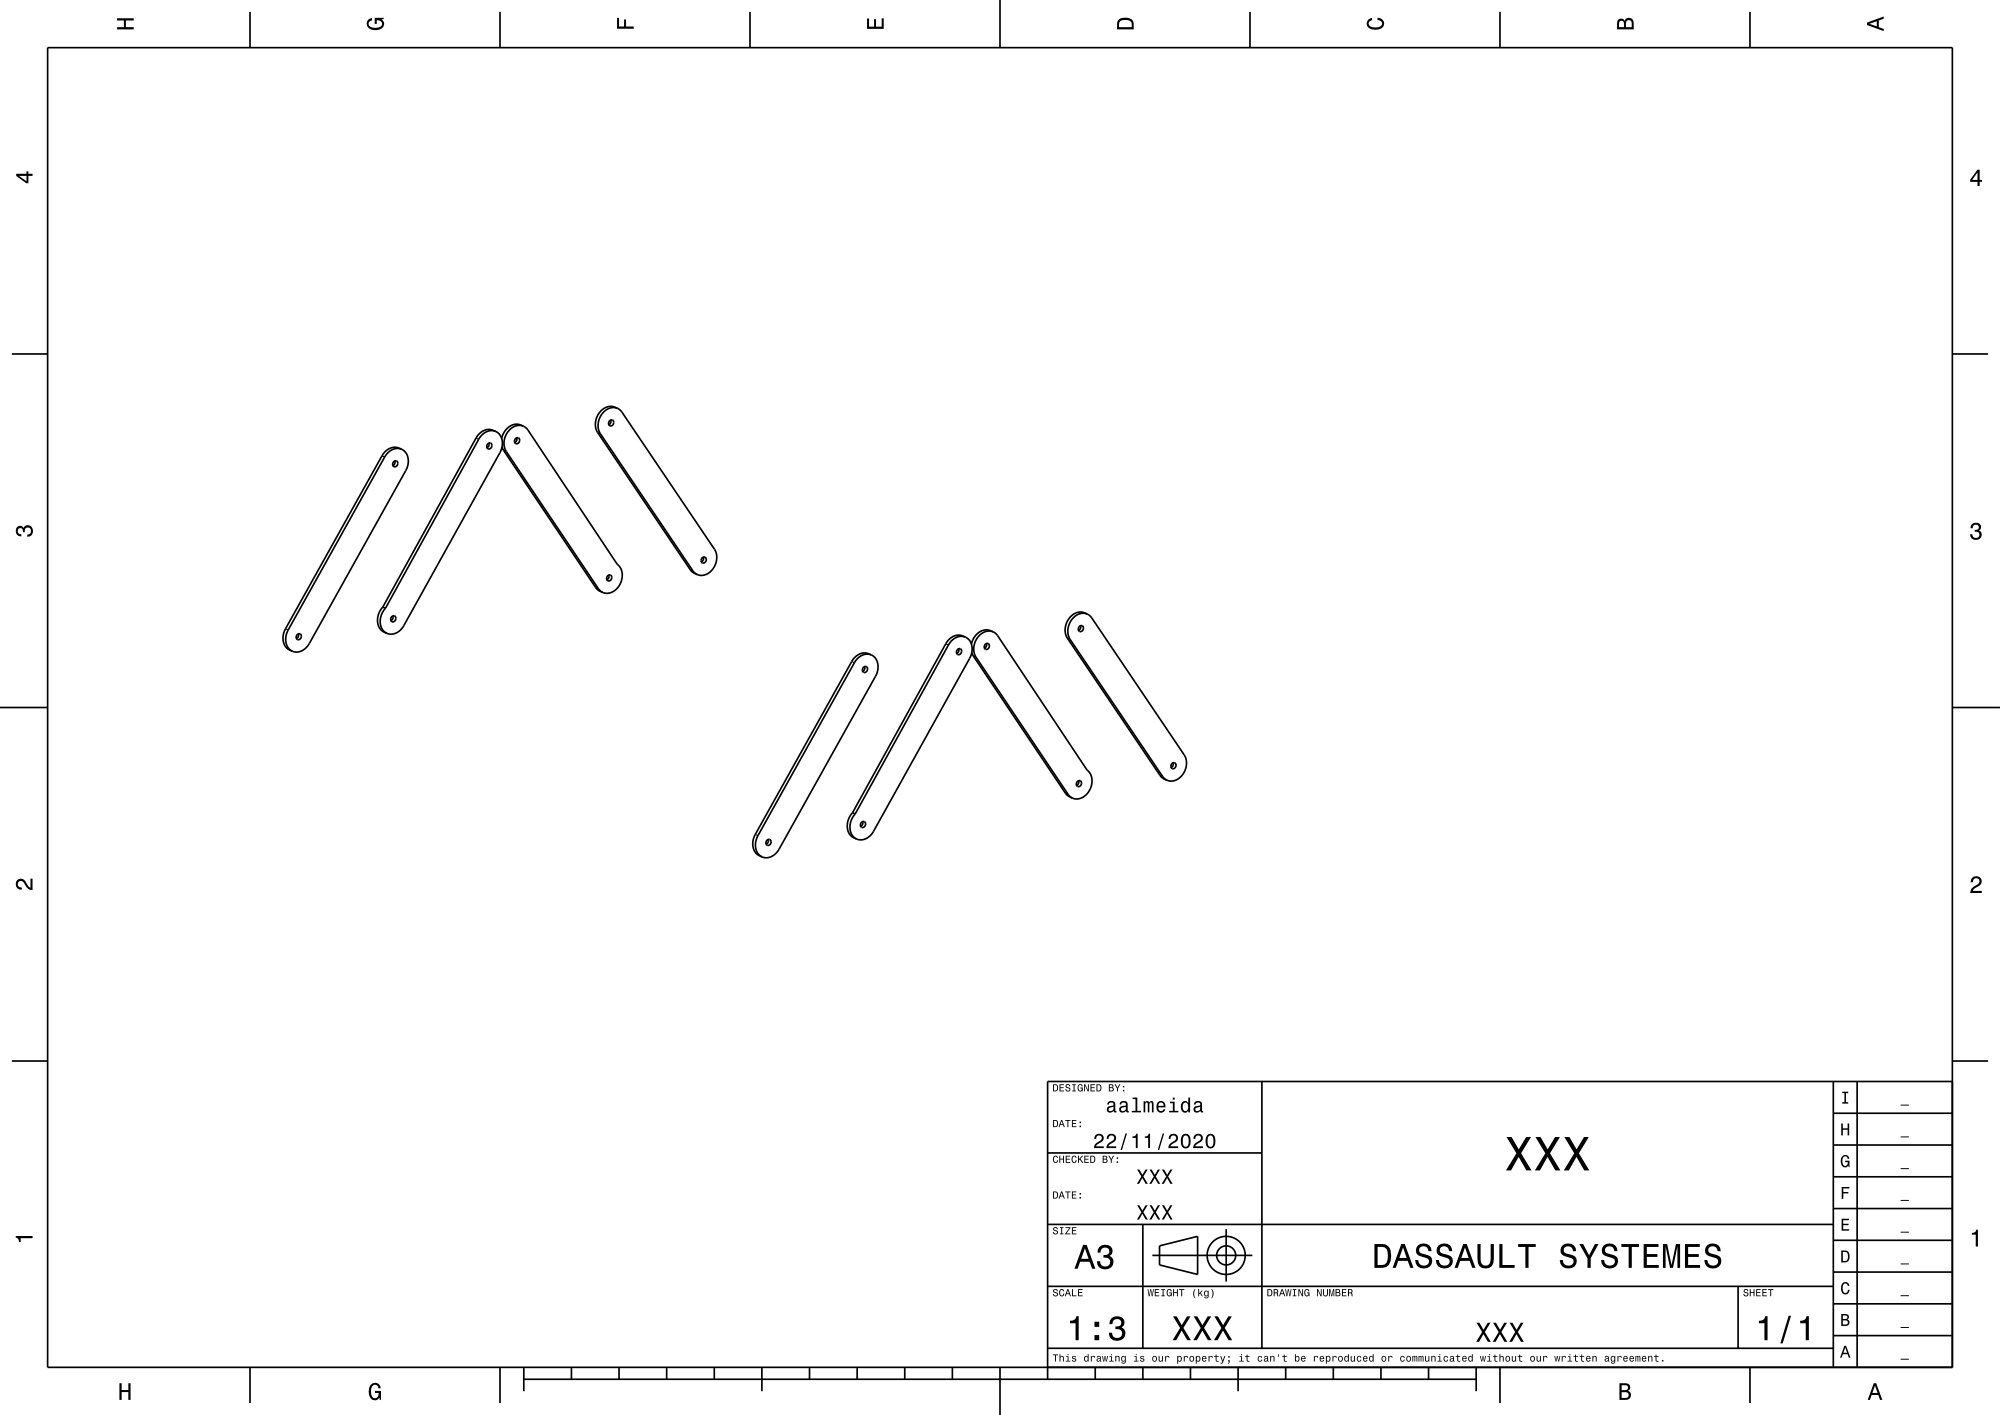
[picture p507: page 1]
