Ground-Station/Documentation/Estrutura/PC3/Imagens/Elementos Maleta de Abastecimento/Dobradiças.pdf

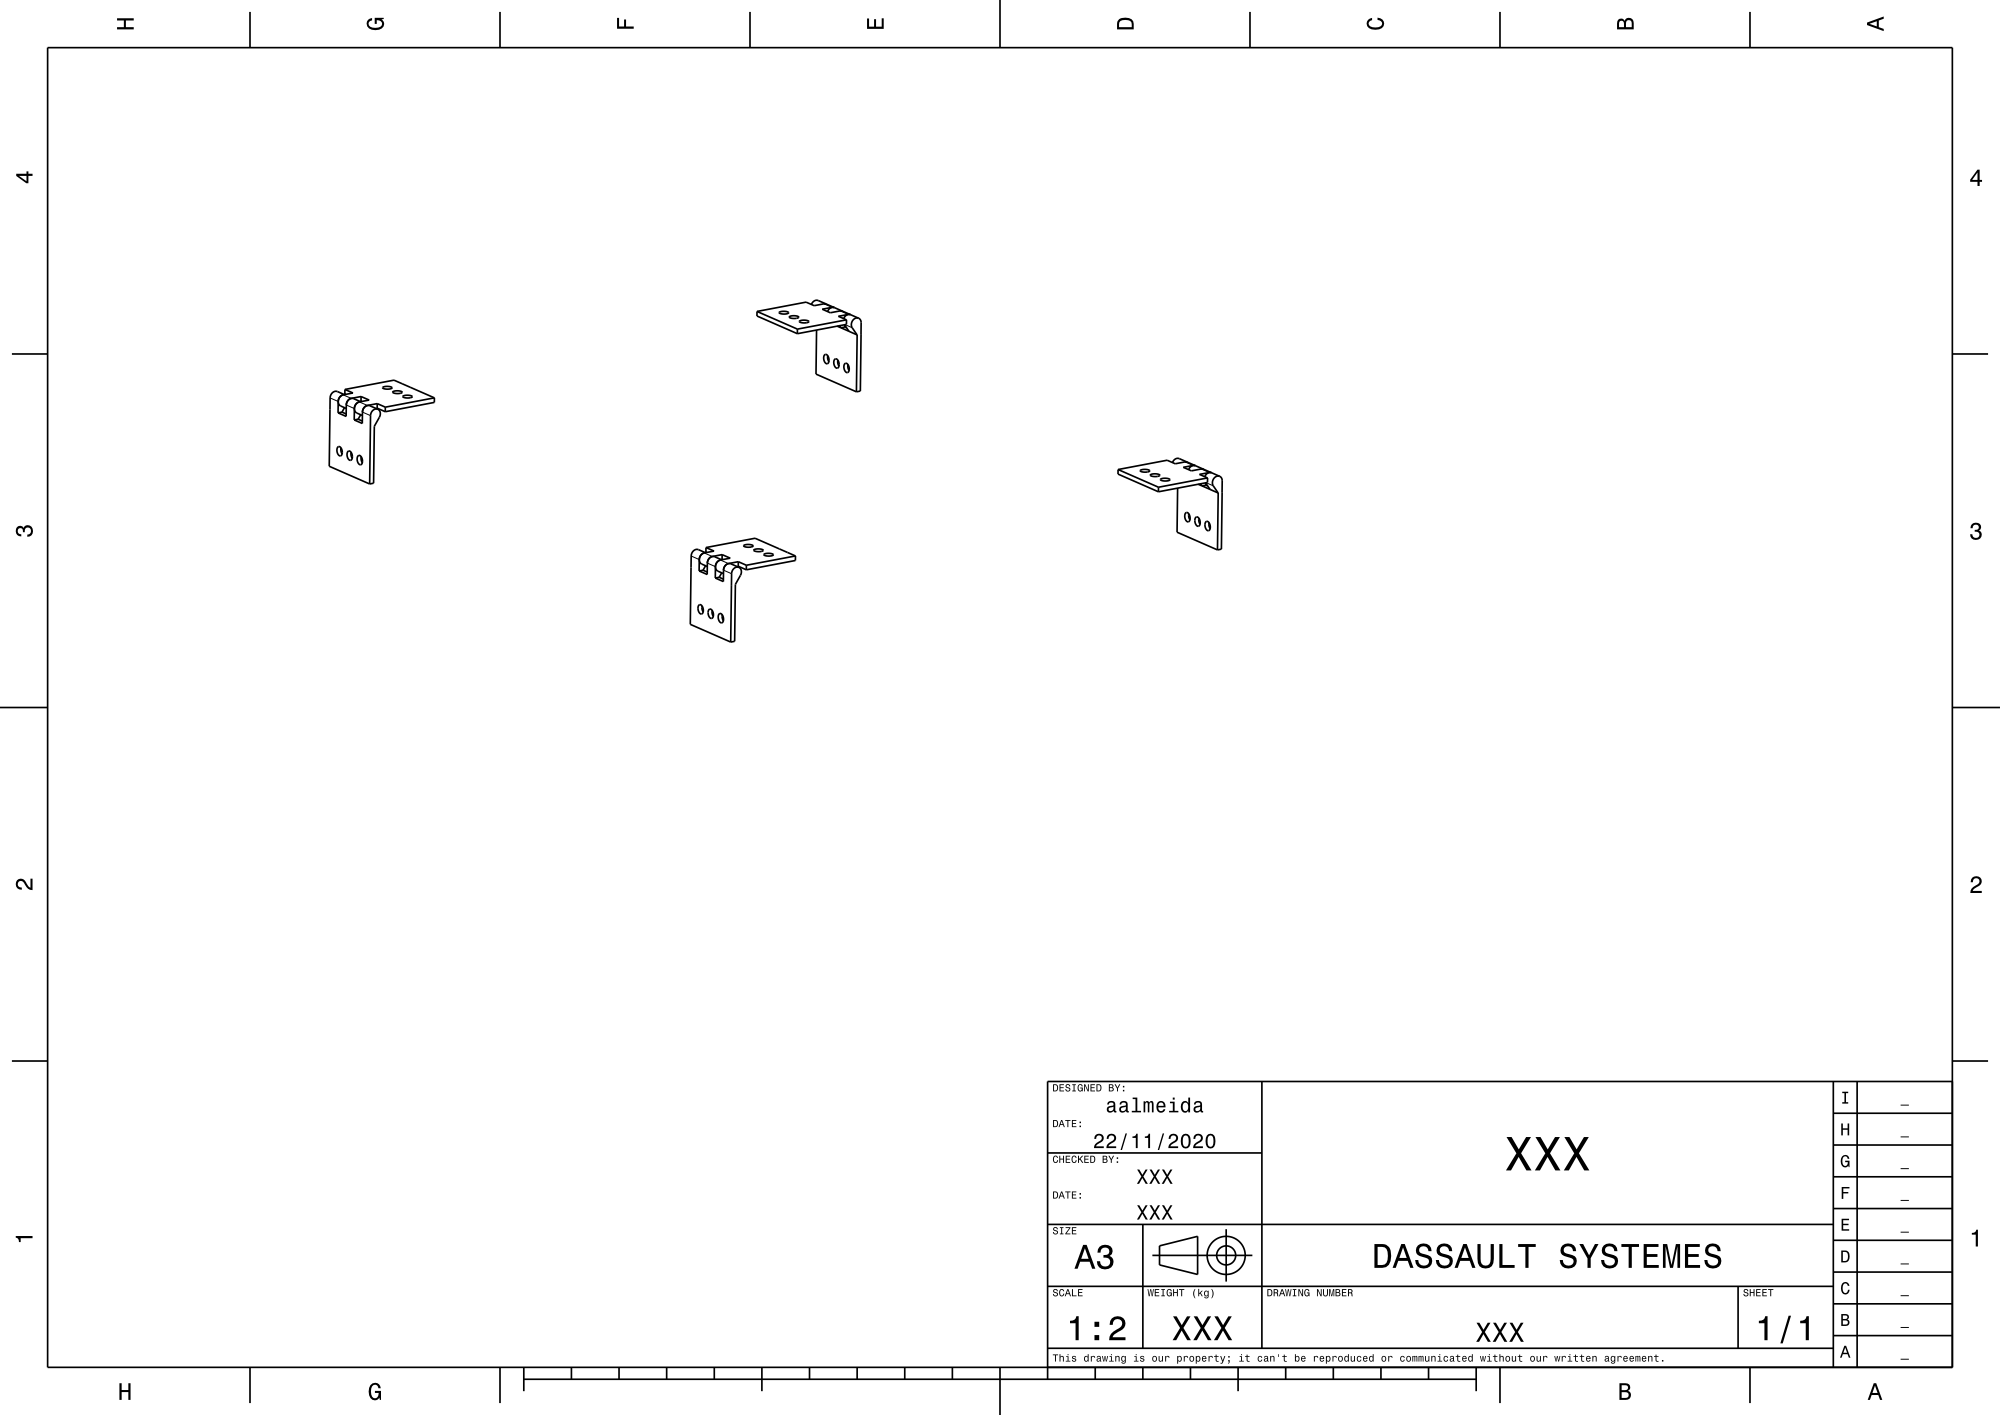
[picture p508: page 1]
