Ground-Station/Documentation/Estrutura/PC3/Imagens/Elementos Maleta de Abastecimento/Puxadores.pdf

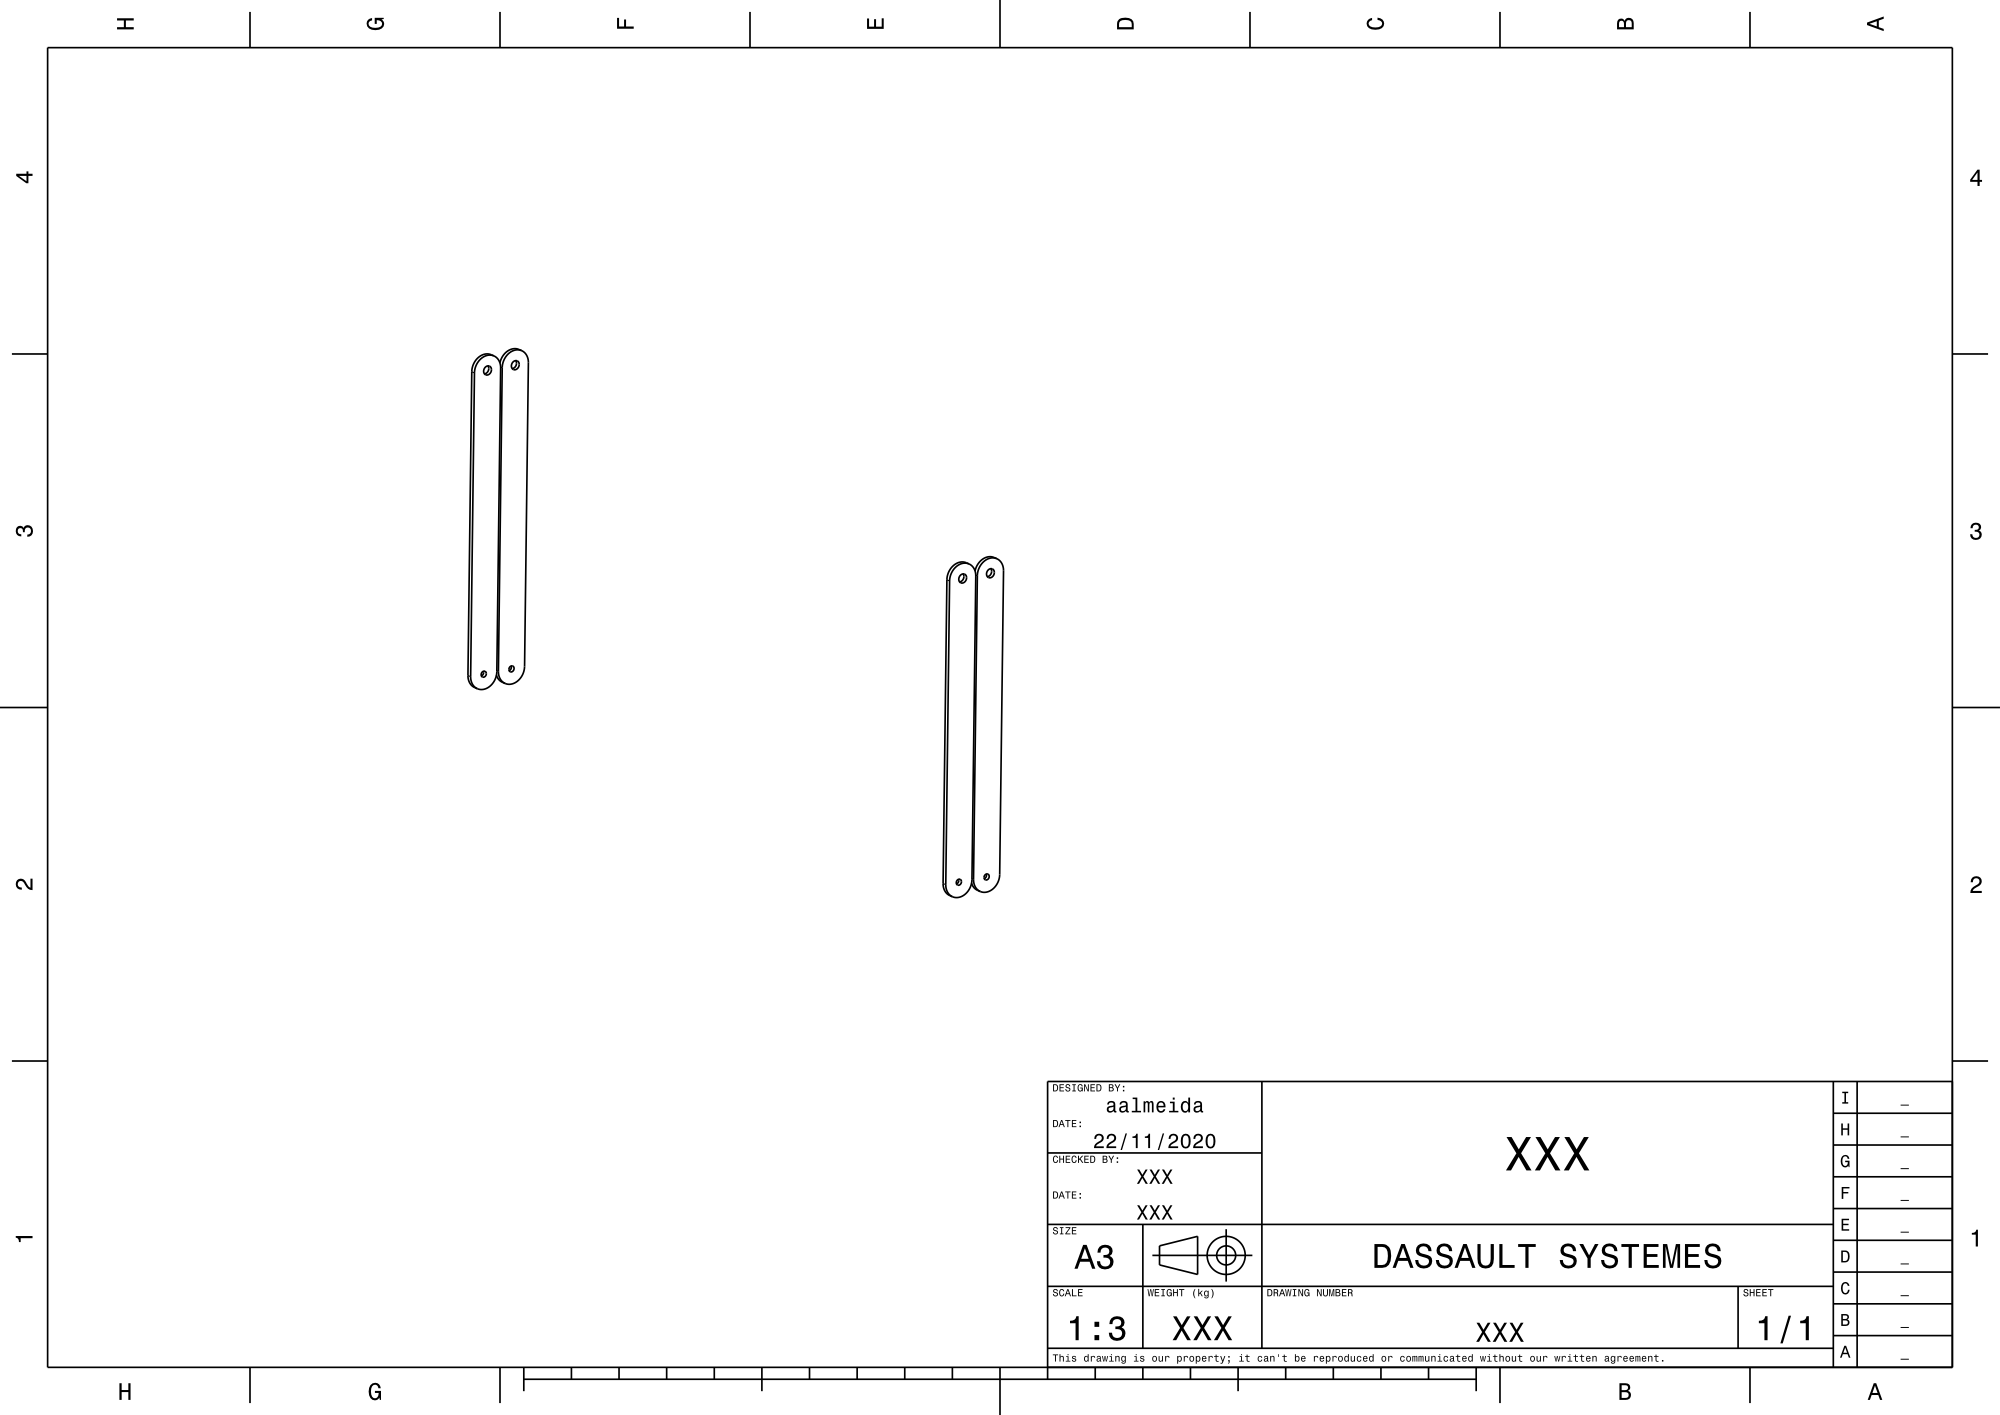
[picture p509: page 1]
