Ground-Station/Documentation/Estrutura/PC3/Imagens/Elementos Maleta de Abastecimento/Tampas.pdf

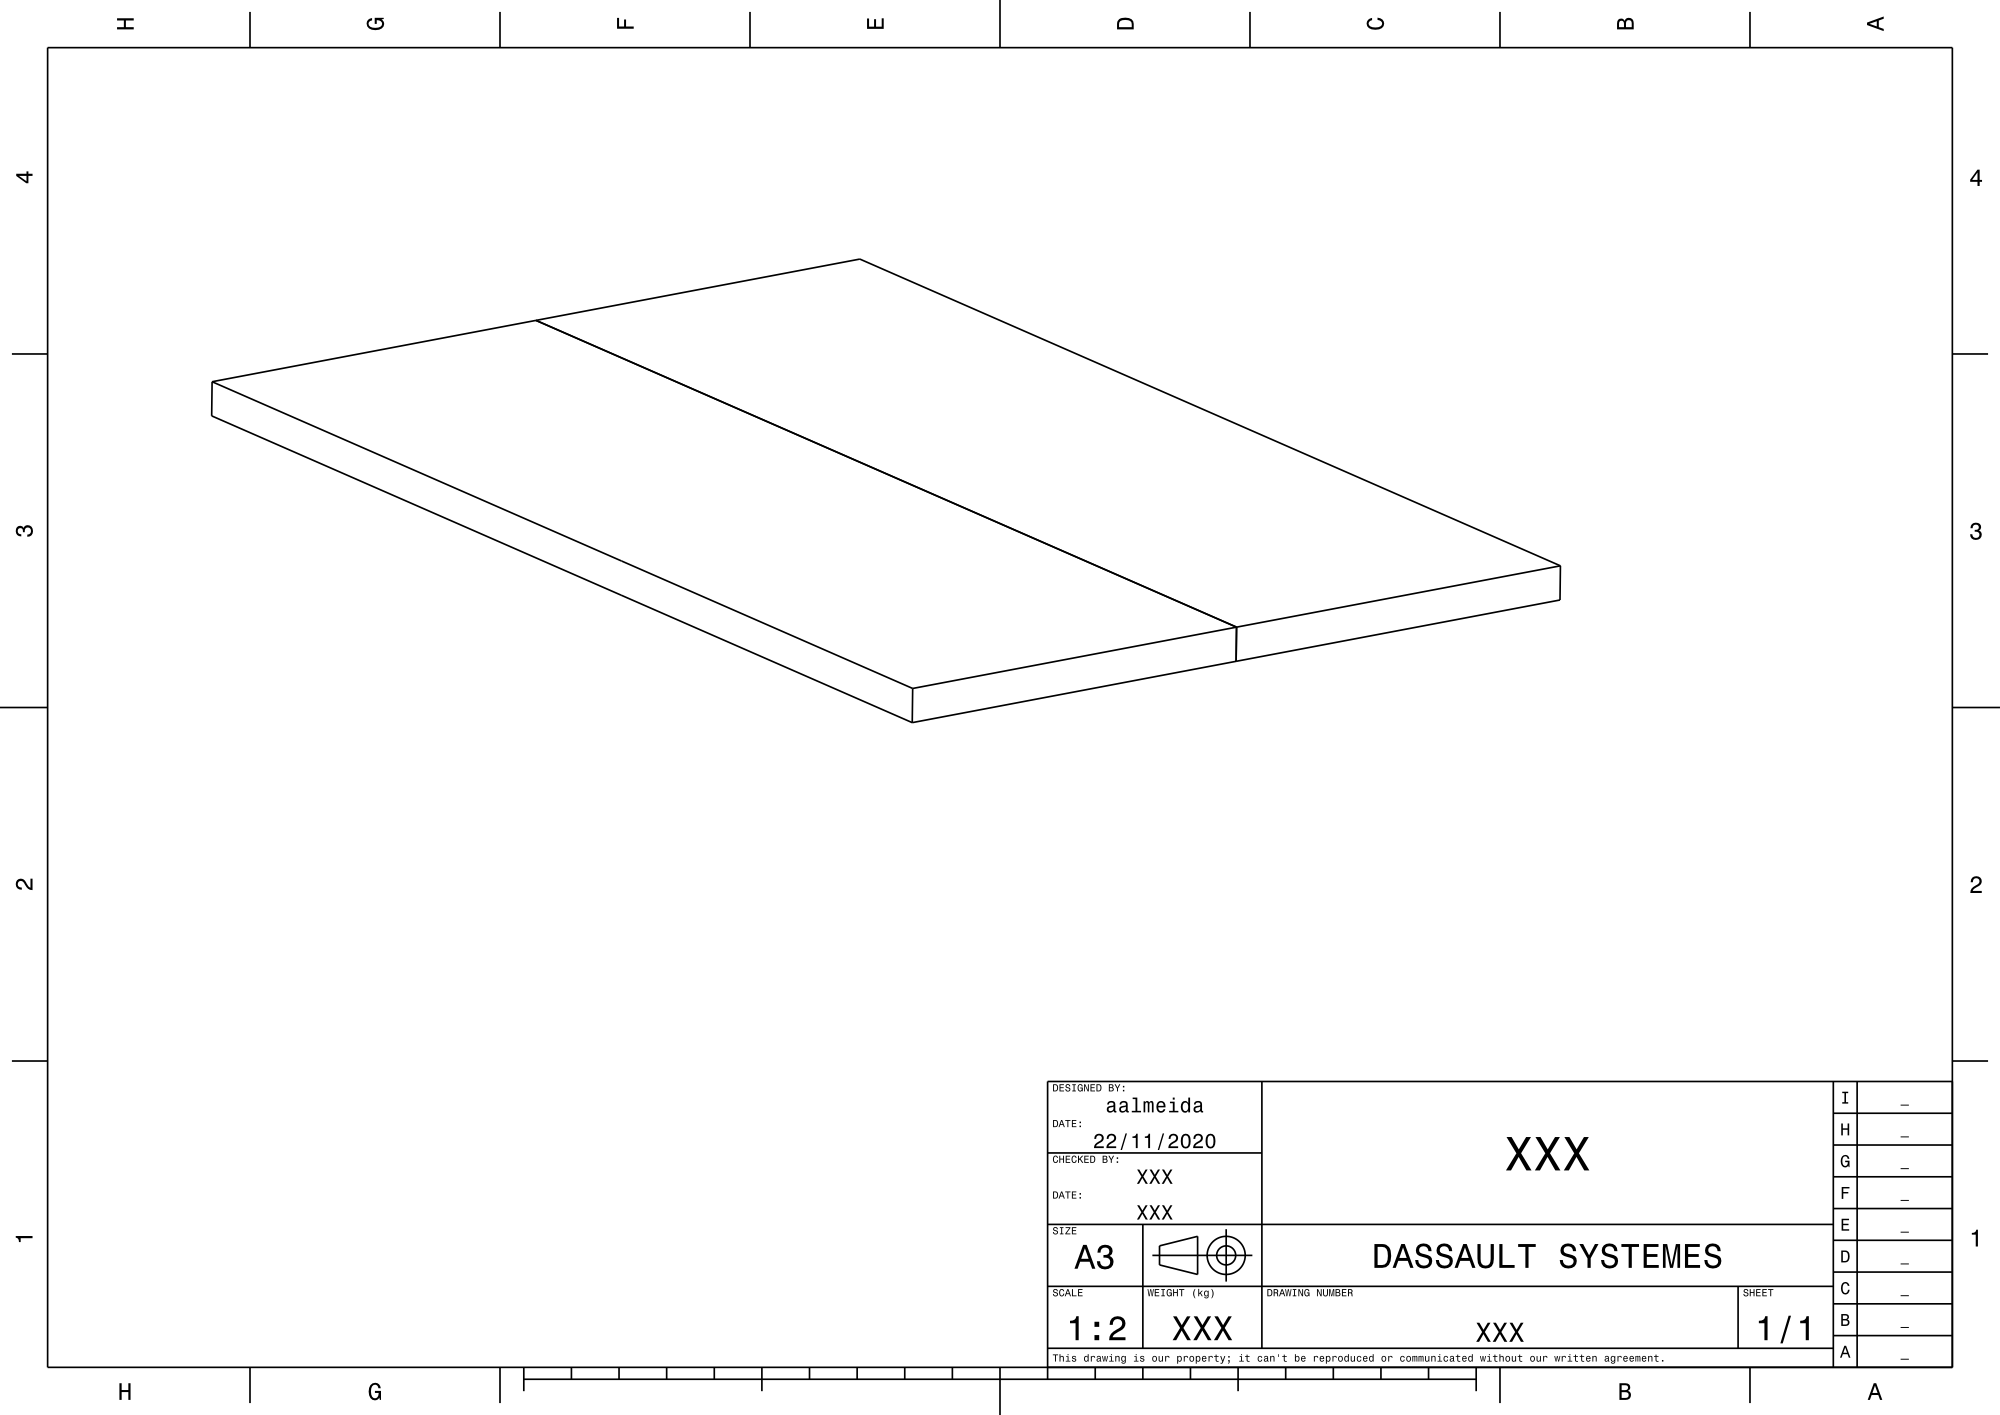
[picture p510: page 1]
