Ground-Station/Documentation/Estrutura/PC3/Imagens/Elementos Maleta de Abastecimento/Trancas.pdf

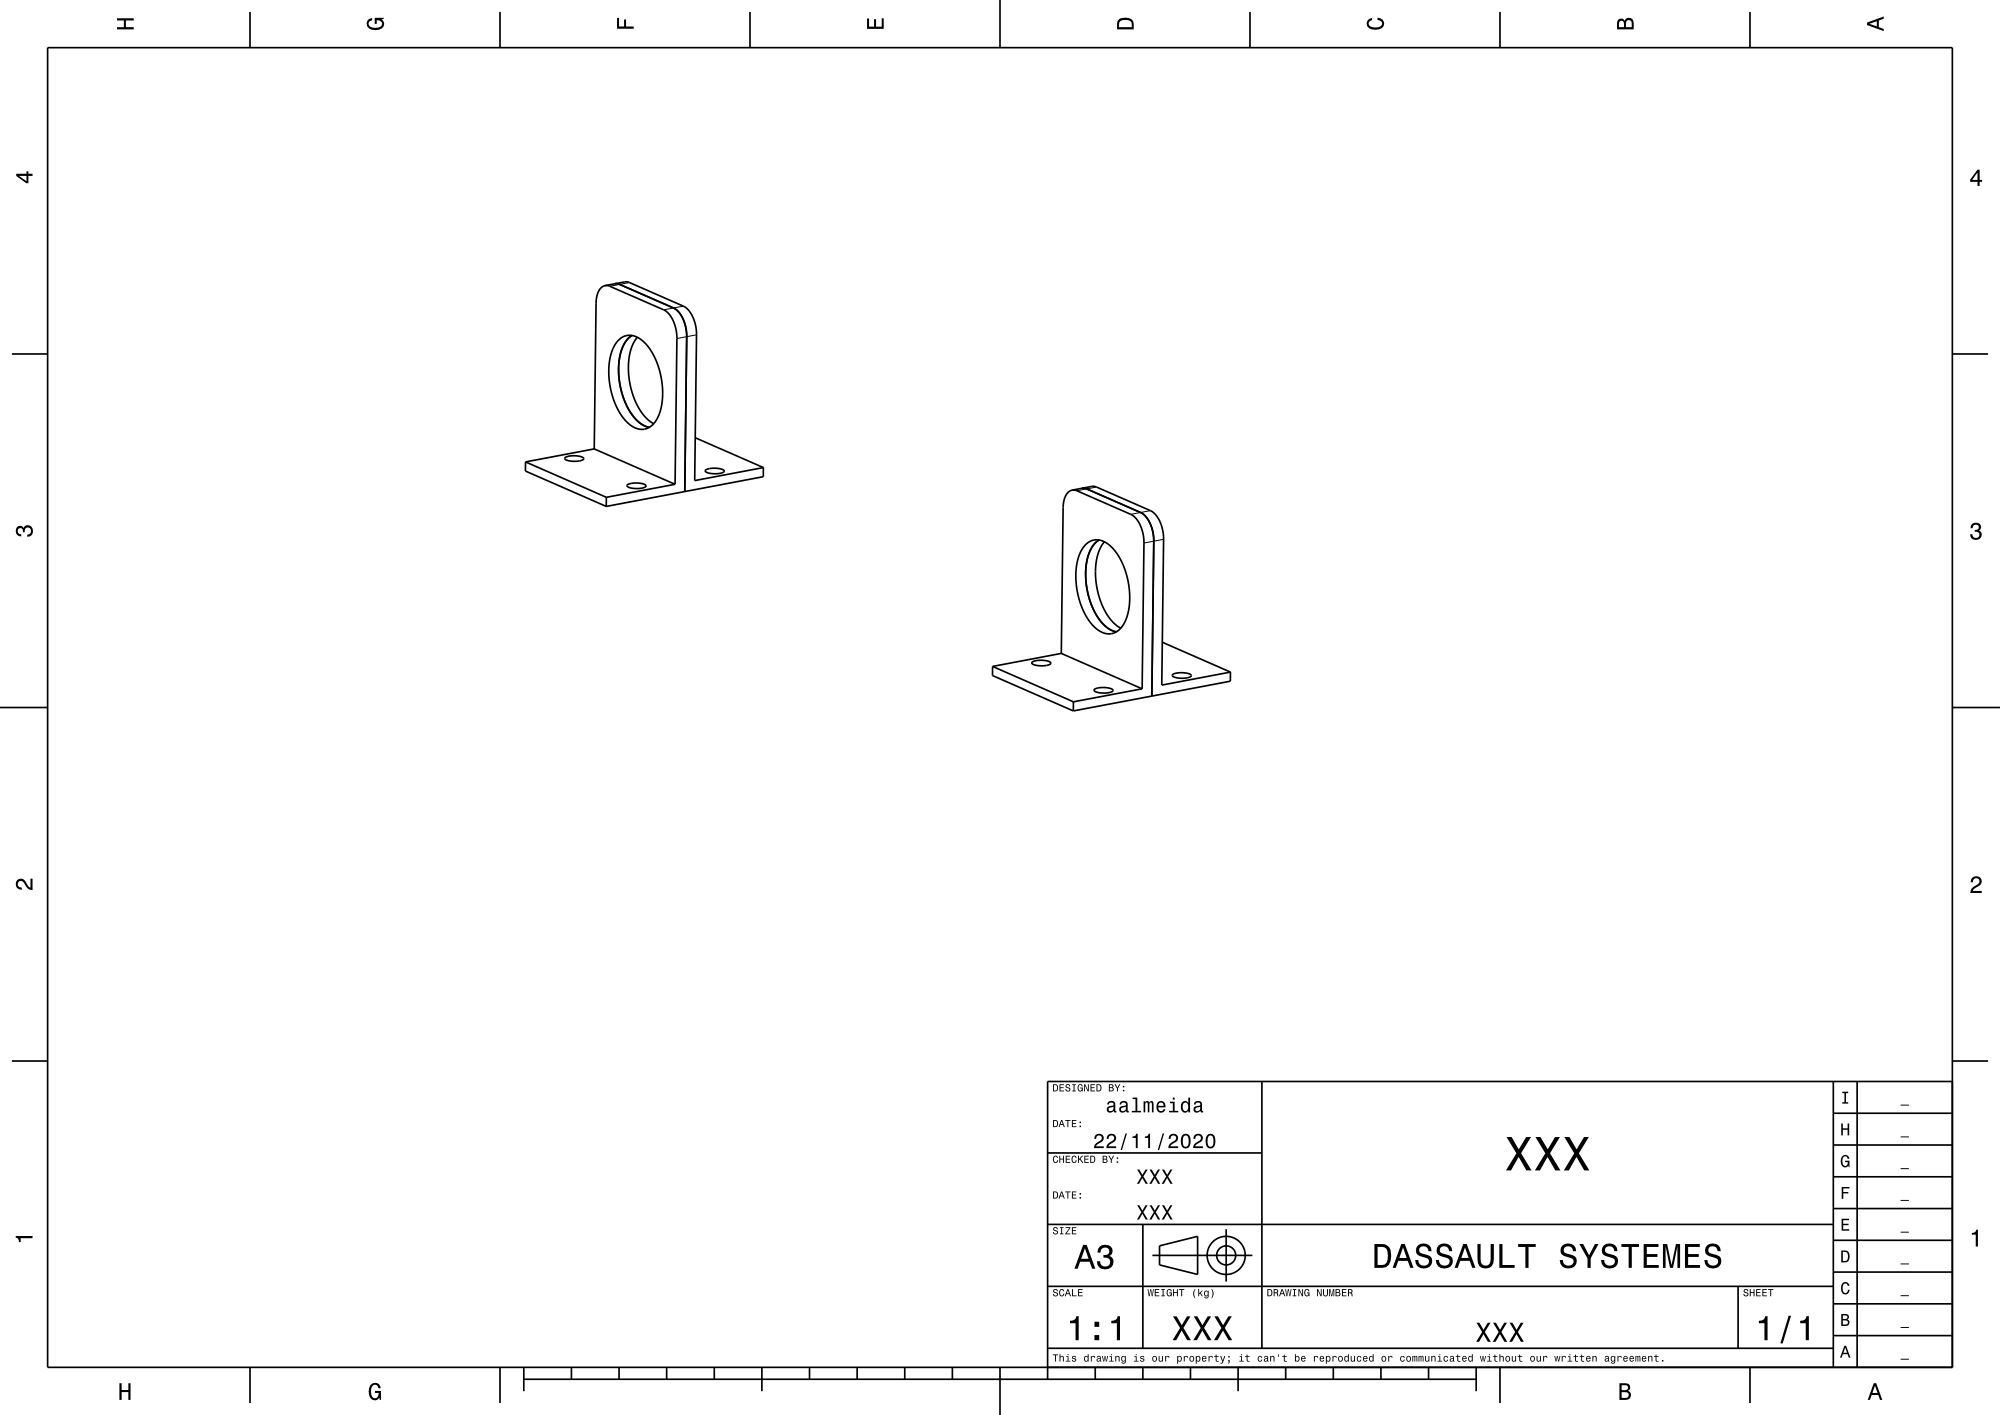
[picture p511: page 1]
