Ground-Station/Documentation/Estrutura/PC3/Imagens/Elementos Maleta GCS/Alça.pdf

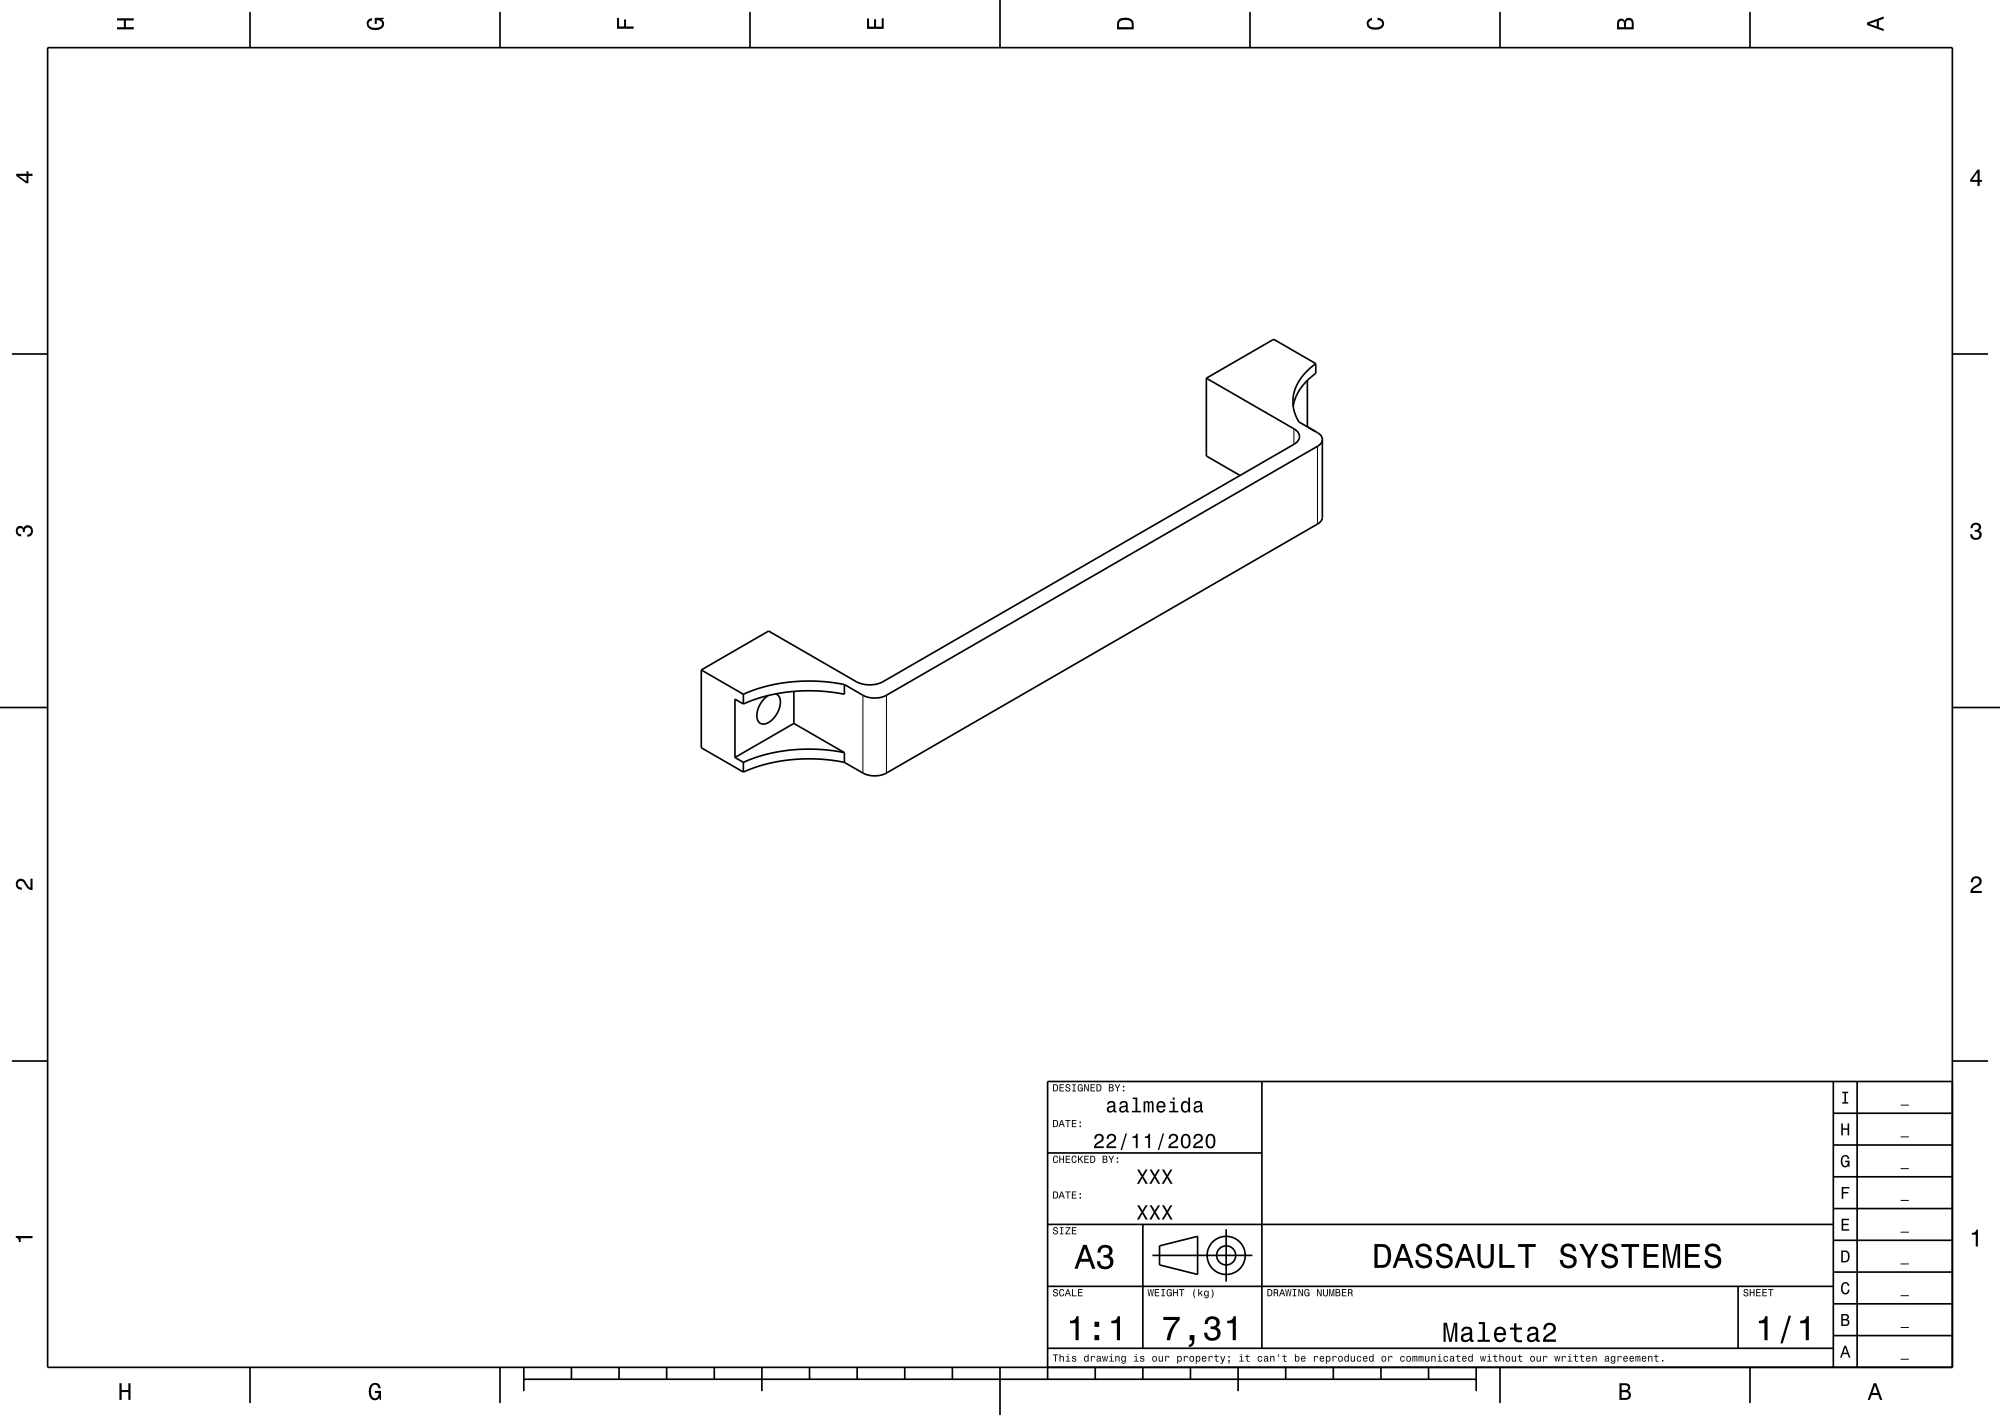
[picture p512: page 1]
