Ground-Station/Documentation/Estrutura/PC3/Imagens/Elementos Maleta GCS/Base.pdf

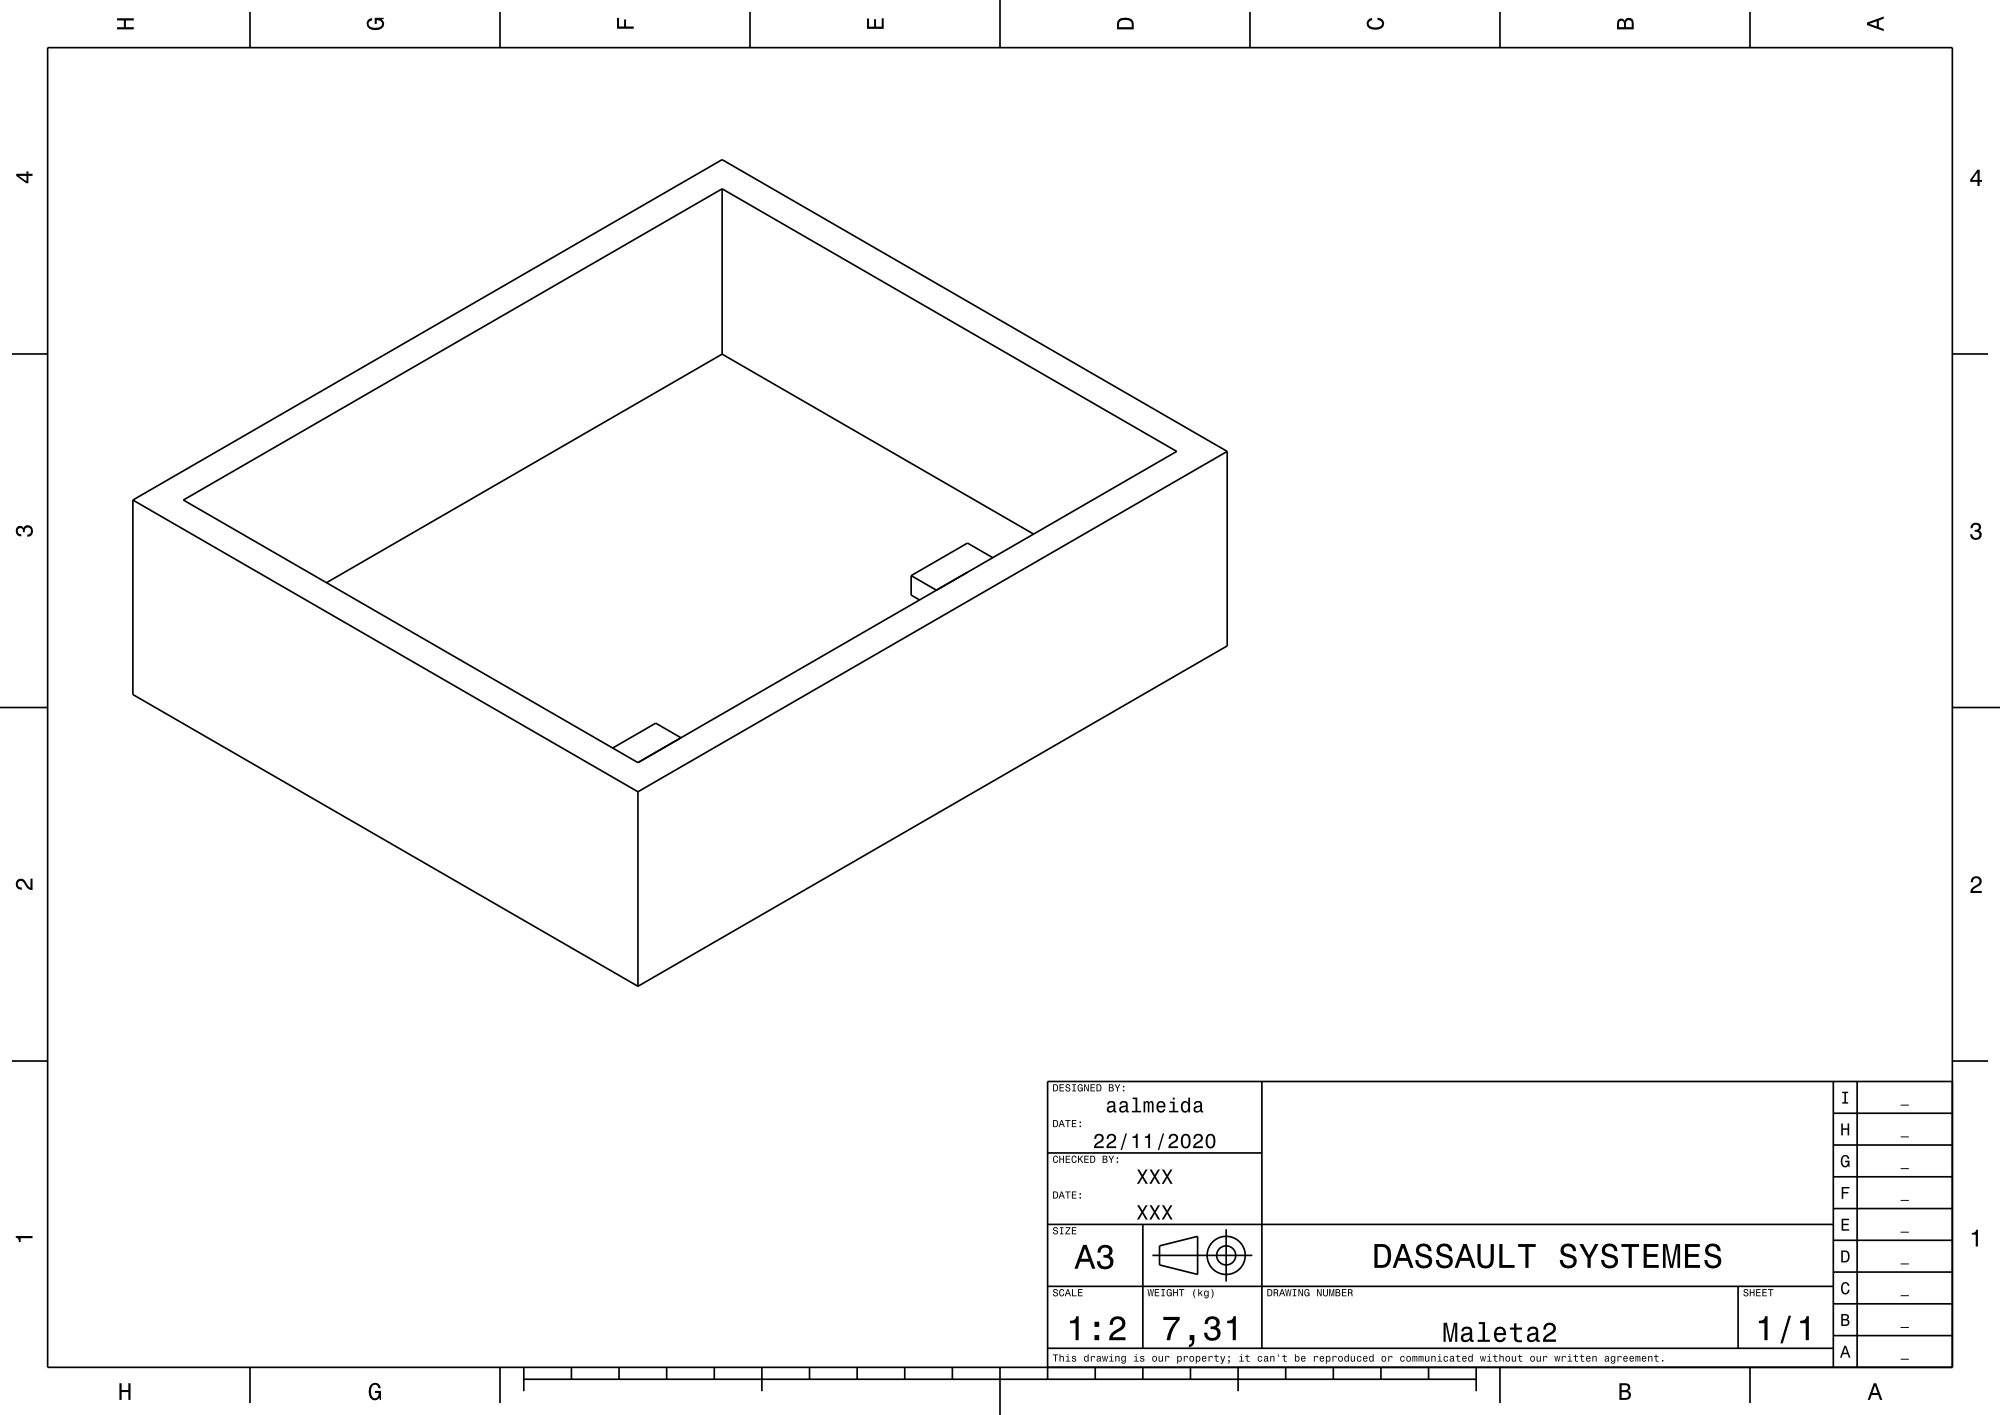
[picture p513: page 1]
