Ground-Station/Documentation/Estrutura/PC3/Imagens/Elementos Maleta GCS/Cantoneiras.pdf

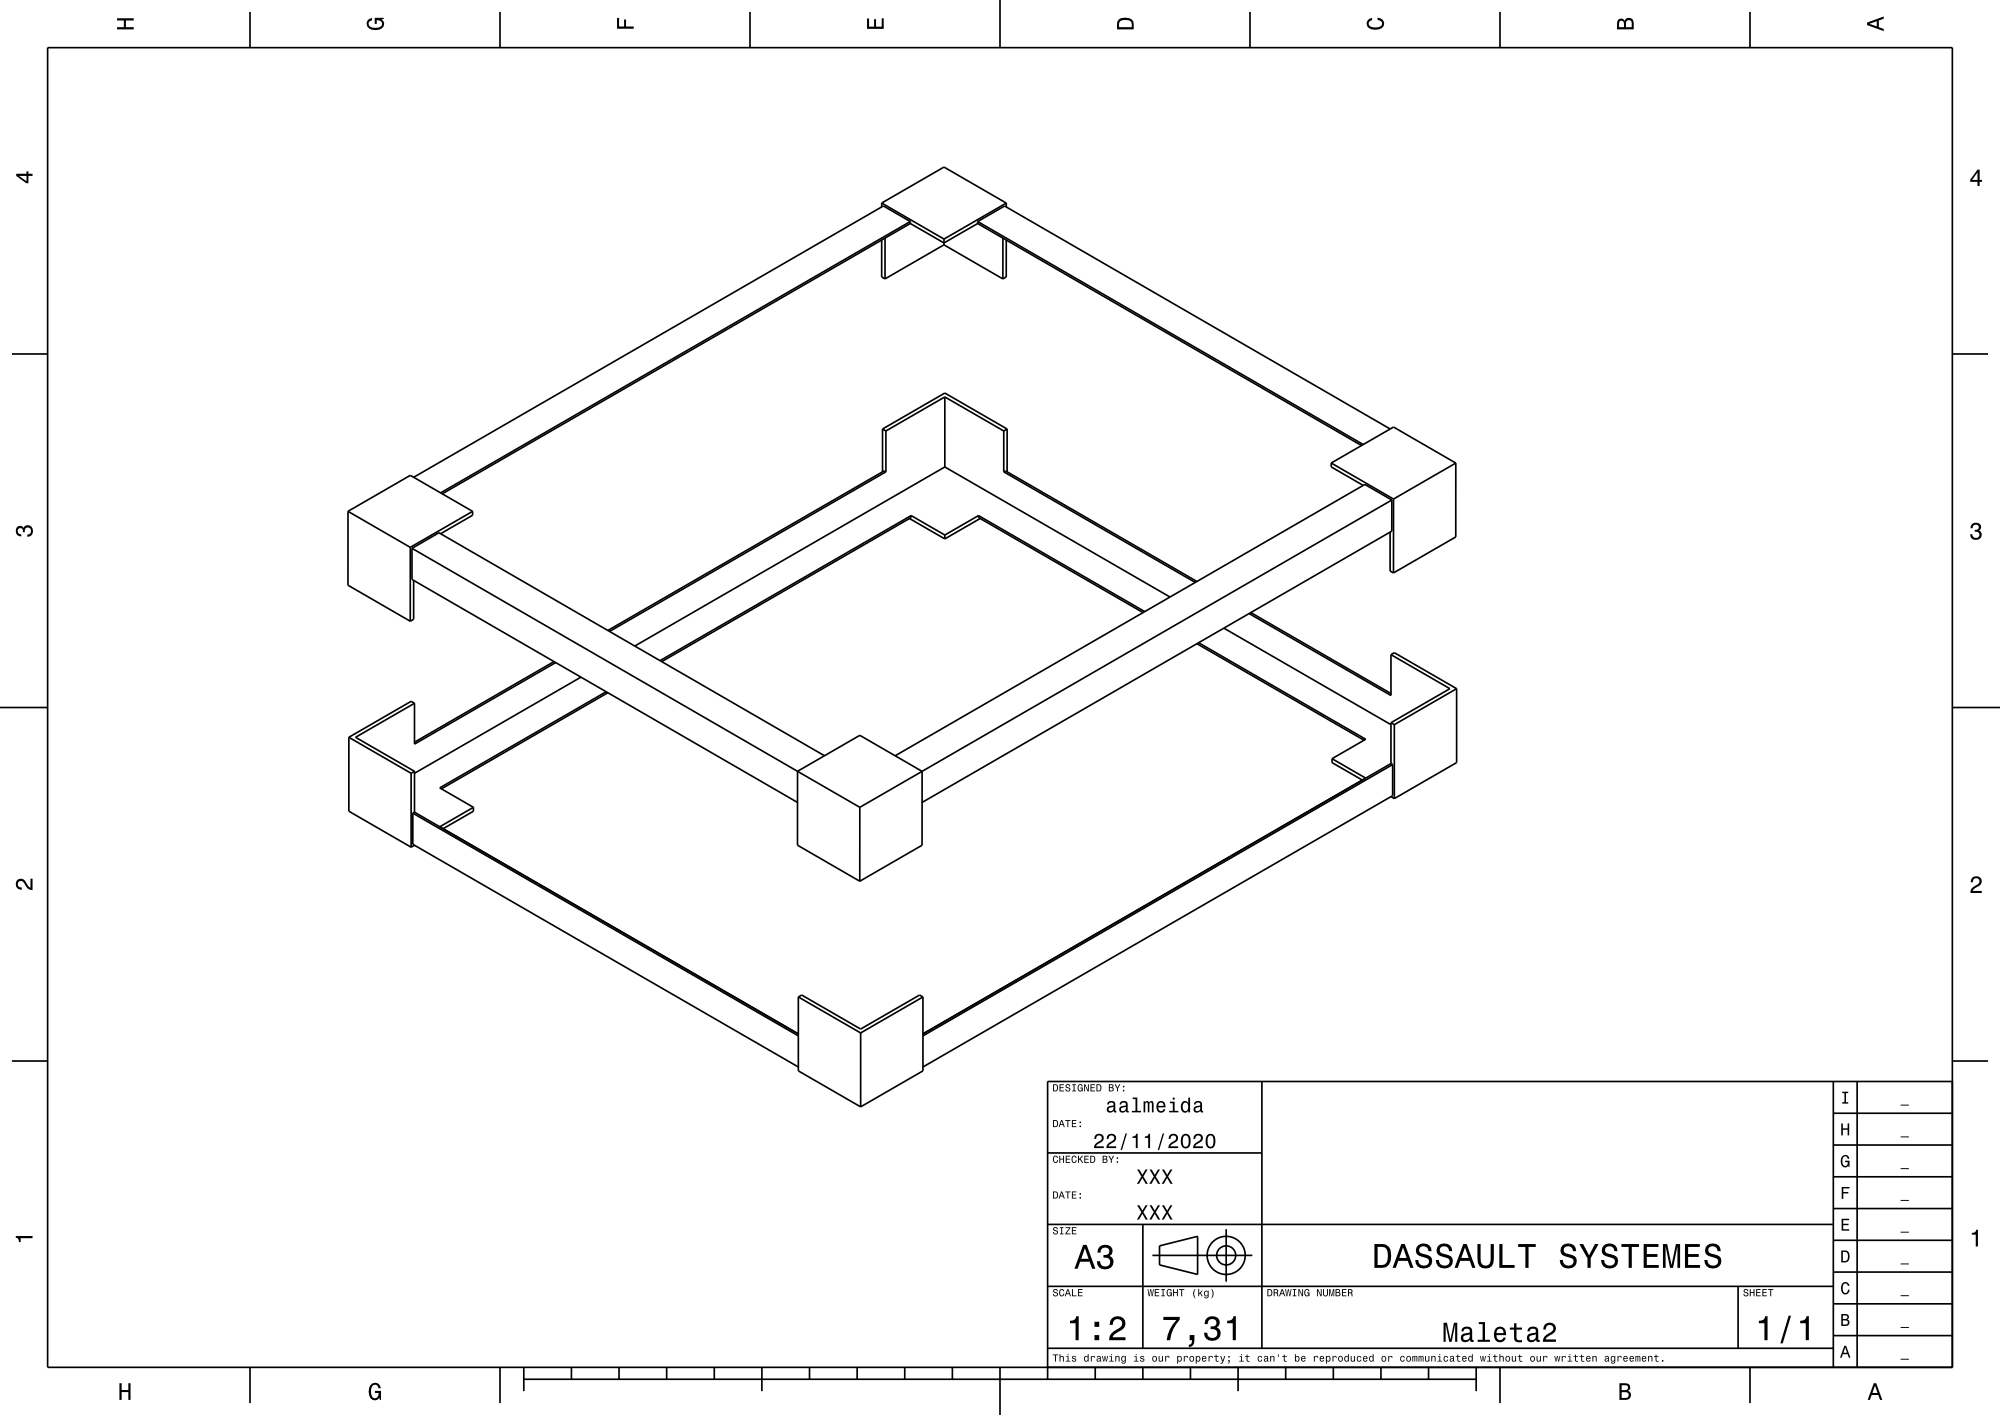
[picture p514: page 1]
