Ground-Station/Documentation/Estrutura/PC3/Imagens/Elementos Maleta GCS/Dobradiças.pdf

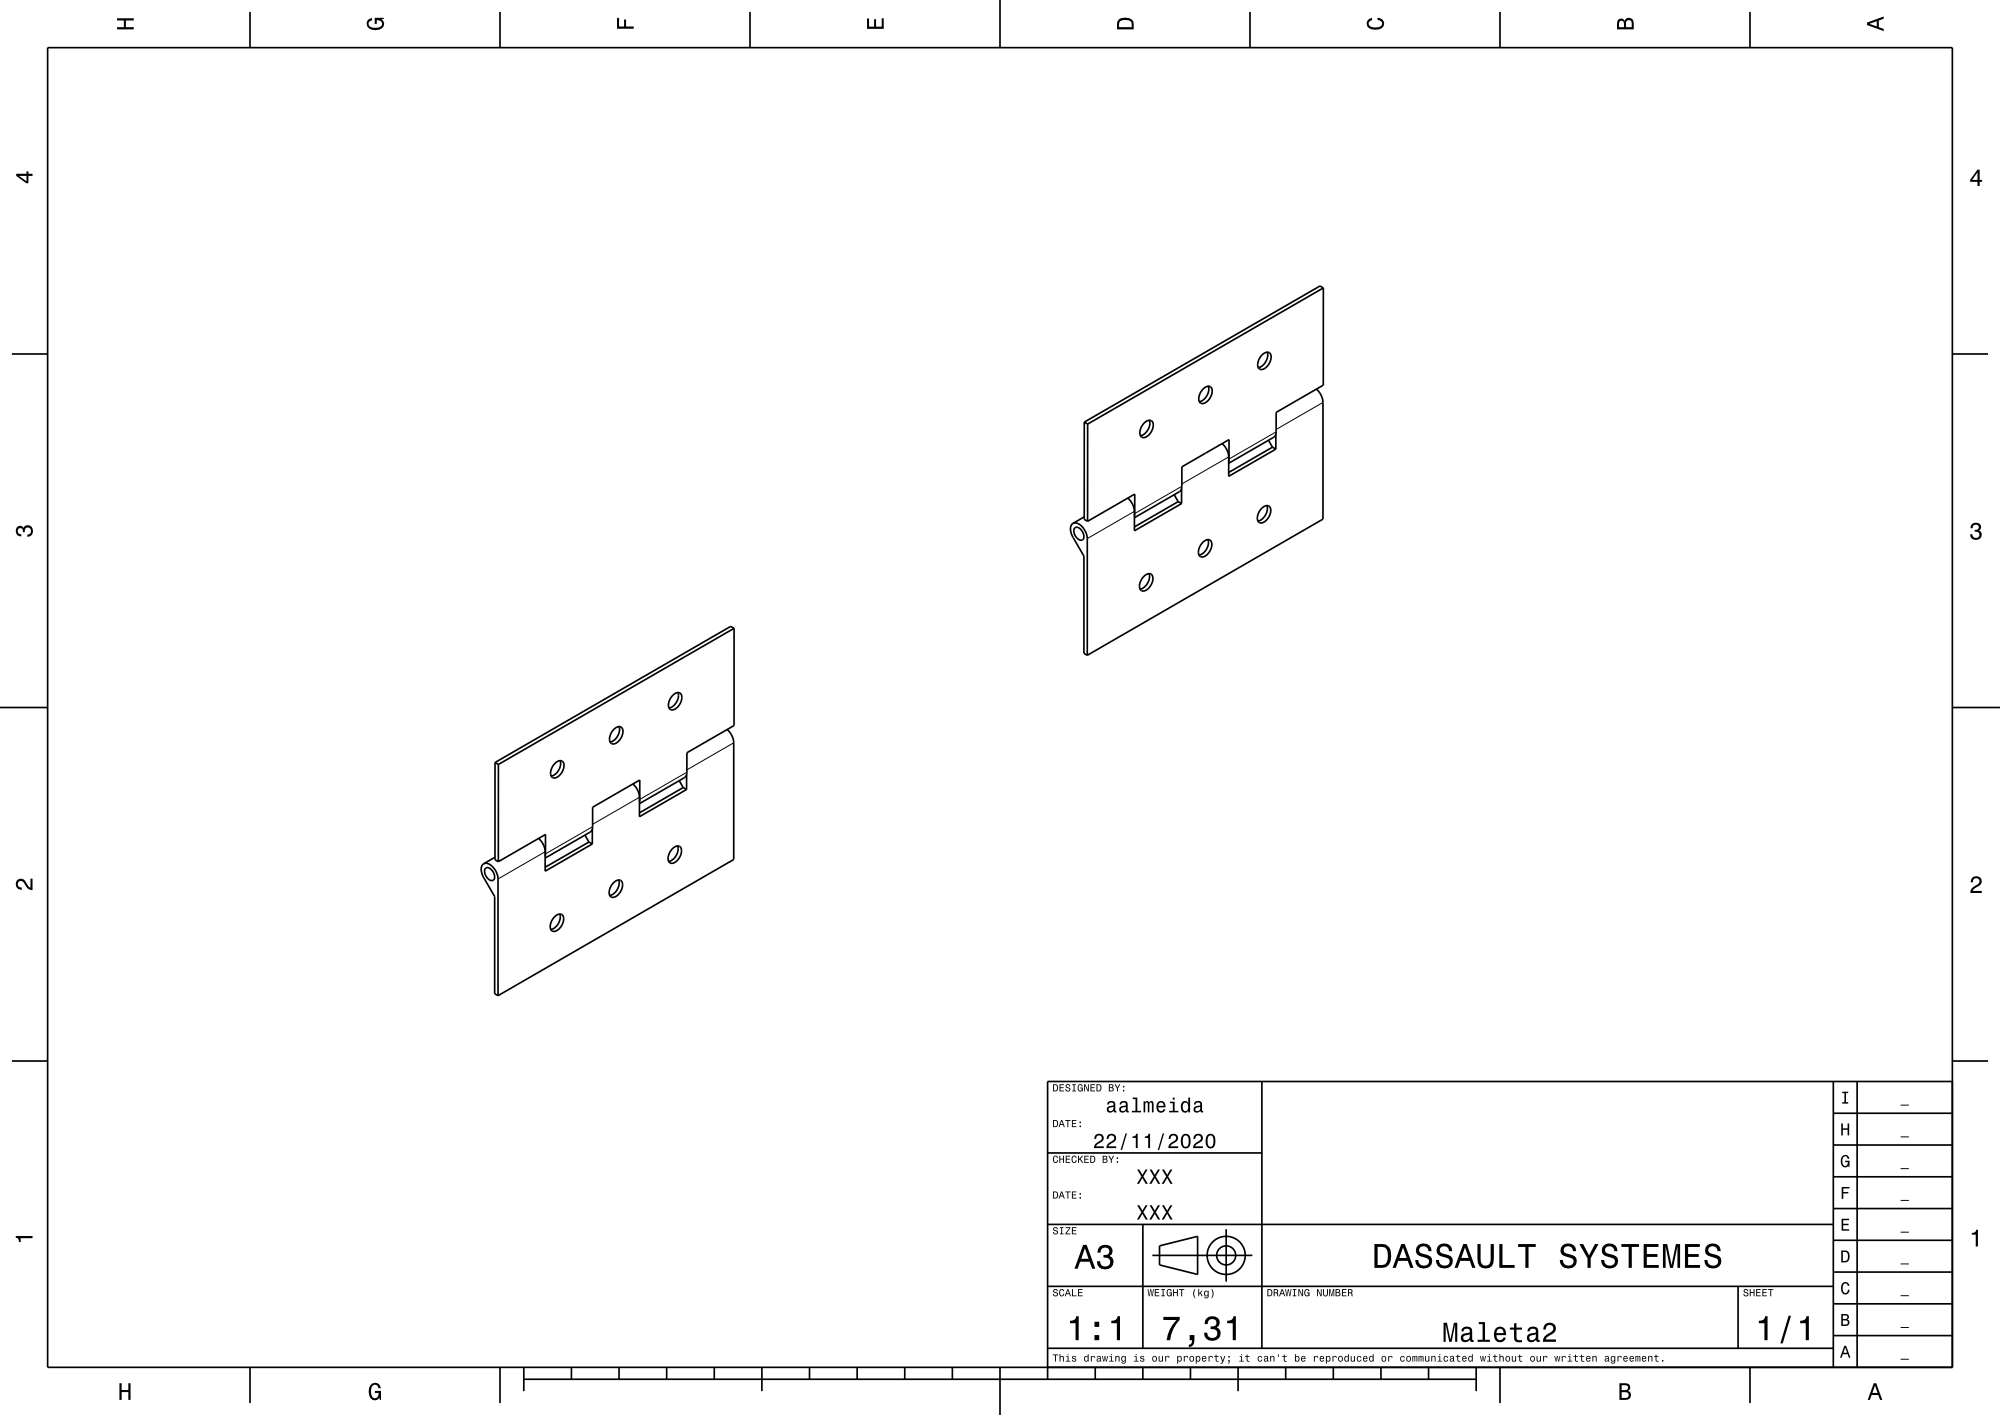
[picture p515: page 1]
