Ground-Station/Documentation/Estrutura/PC3/Imagens/Elementos Maleta GCS/Moldura da Base.pdf

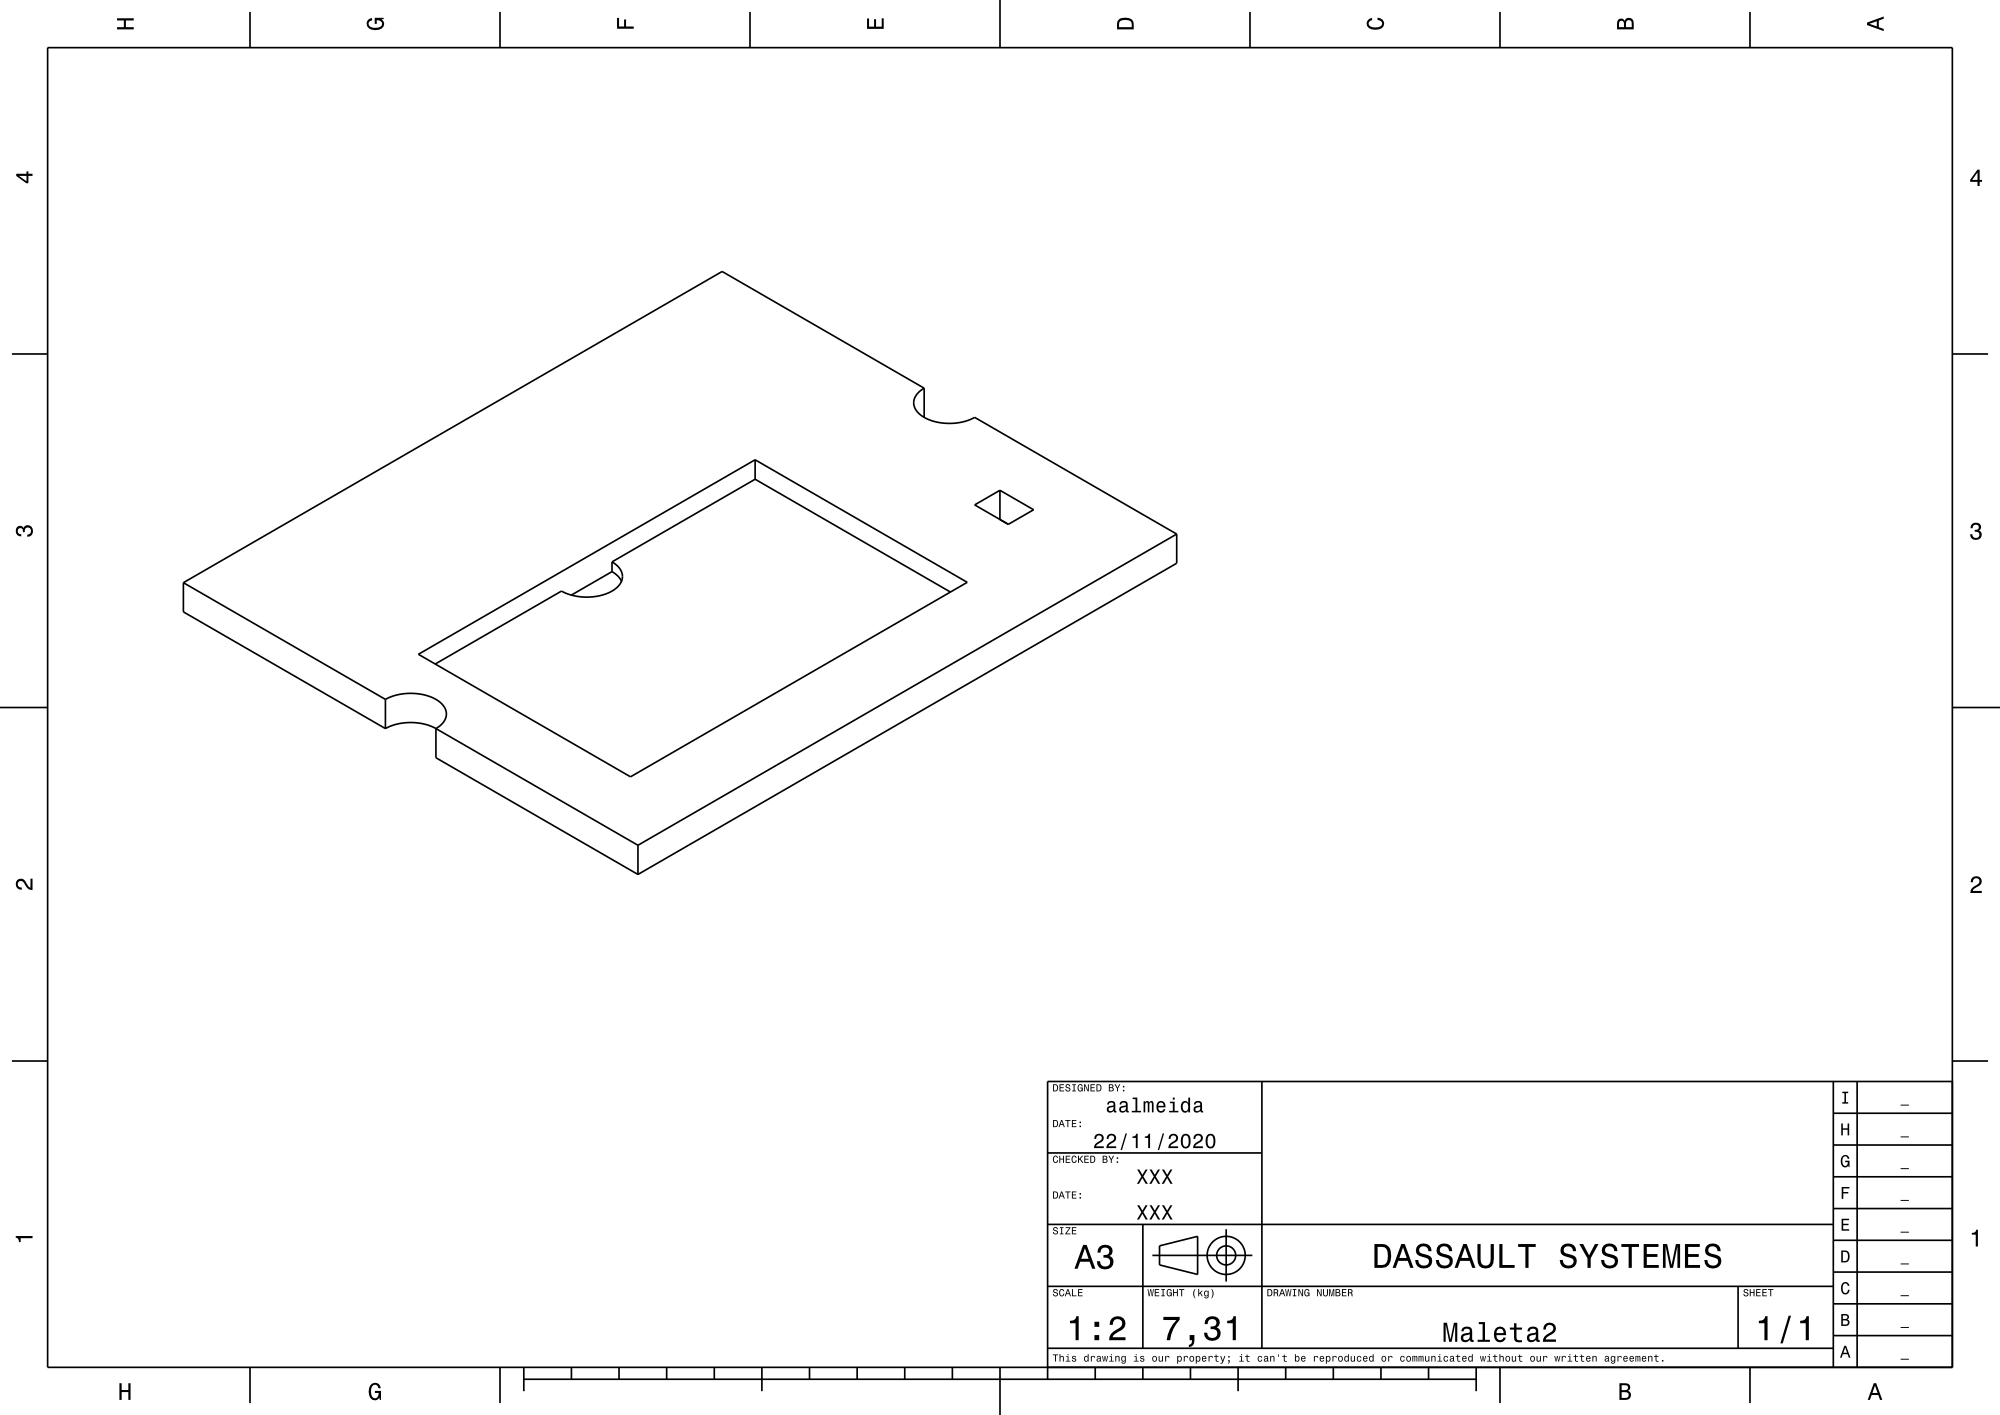
[picture p516: page 1]
