Ground-Station/Documentation/Estrutura/PC3/Imagens/Elementos Maleta GCS/Moldura do Topo.pdf

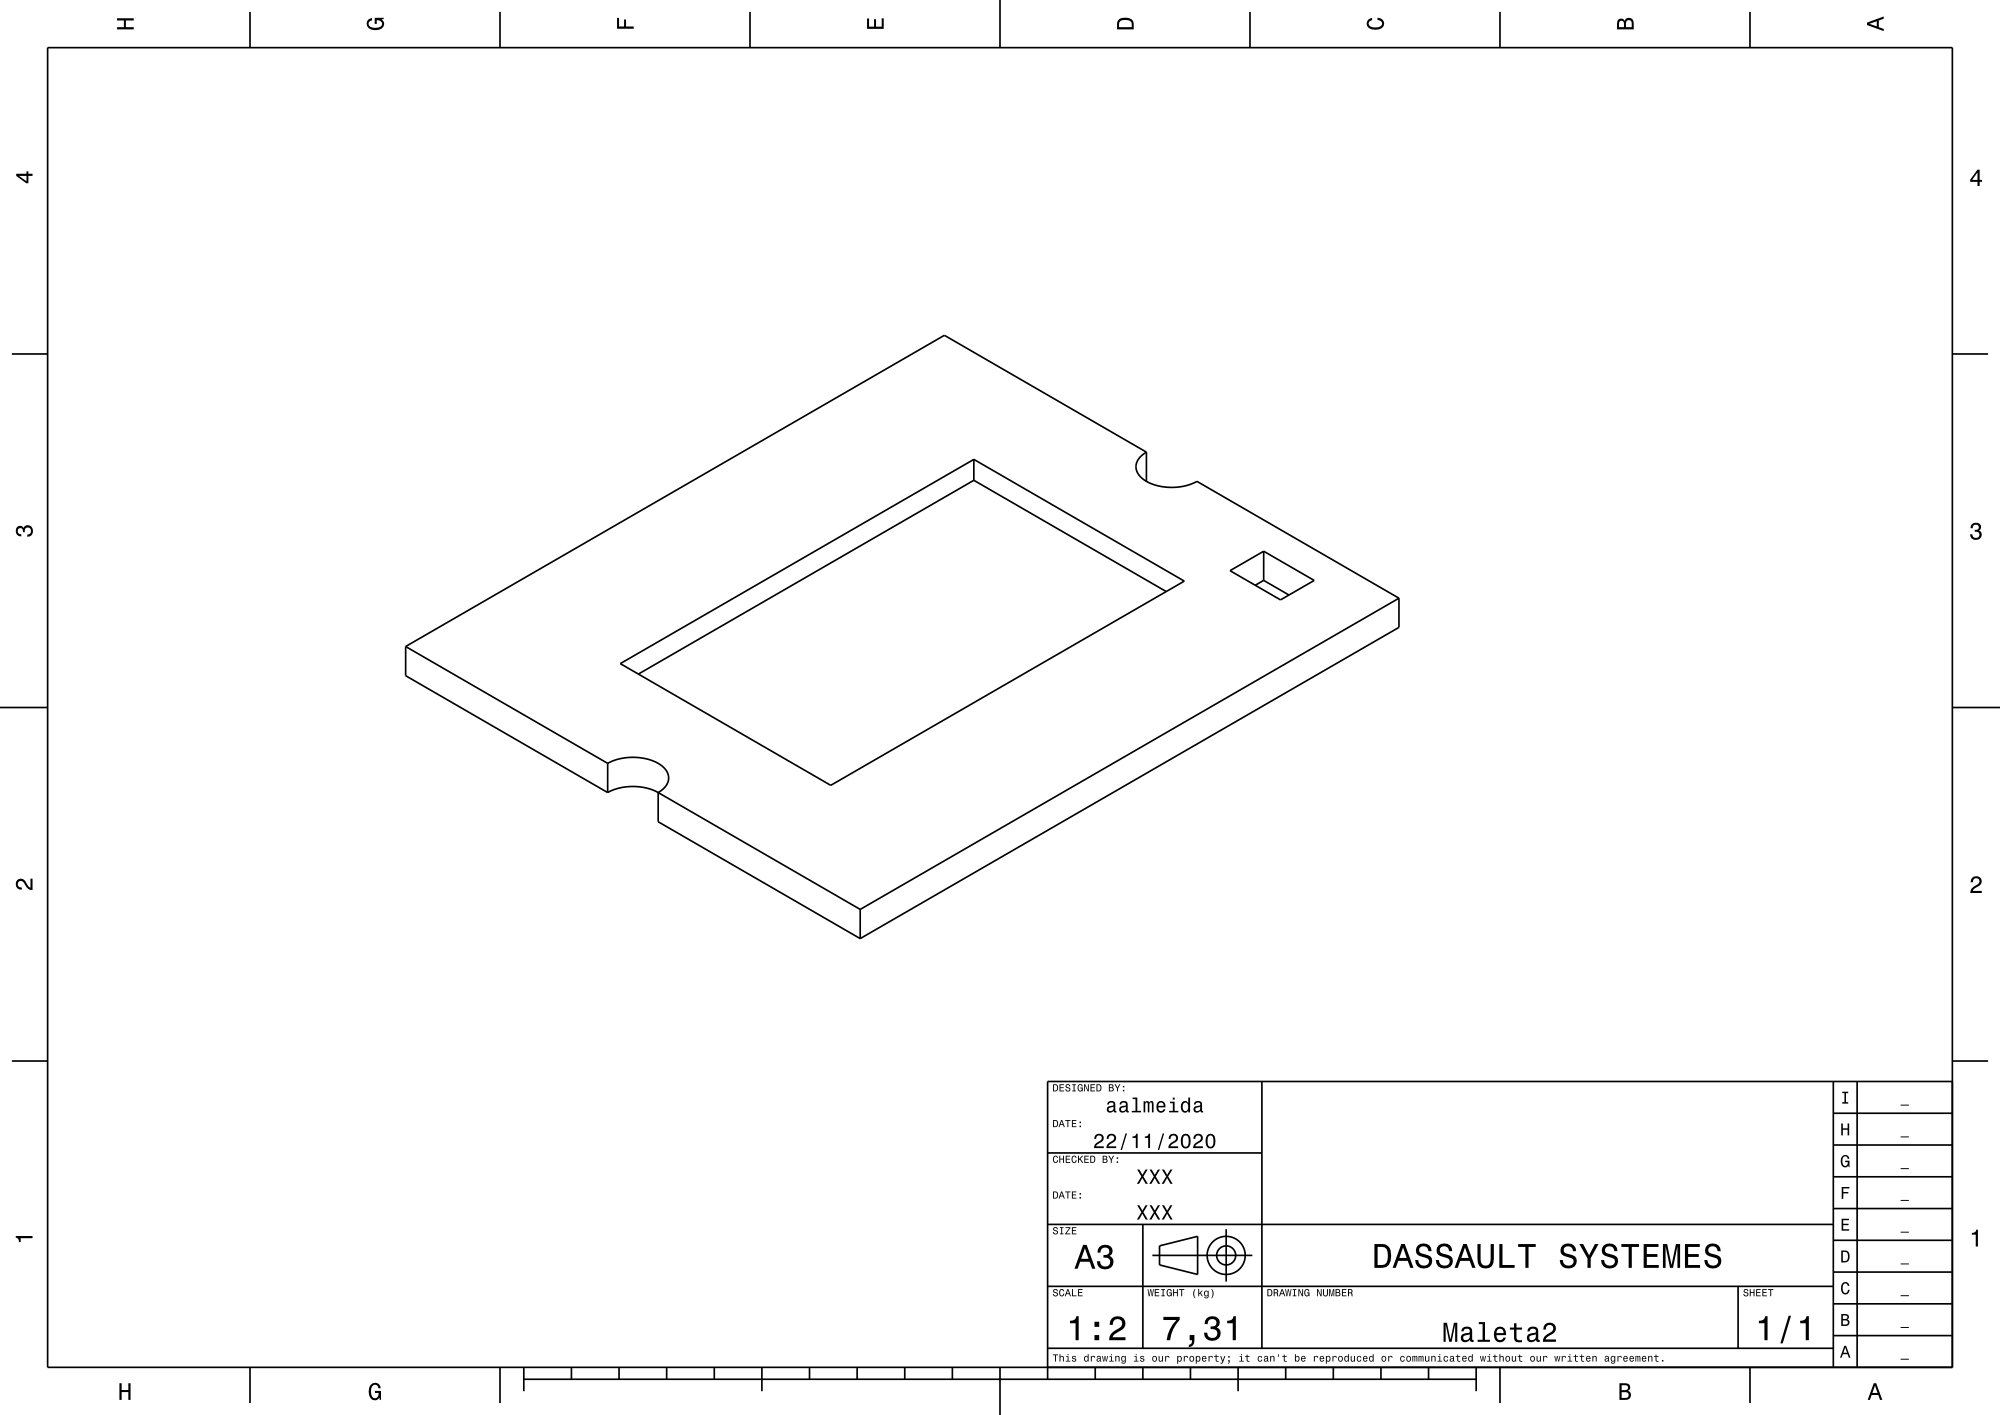
[picture p517: page 1]
