Ground-Station/Documentation/Estrutura/PC3/Imagens/Elementos Maleta GCS/Presilhas.pdf

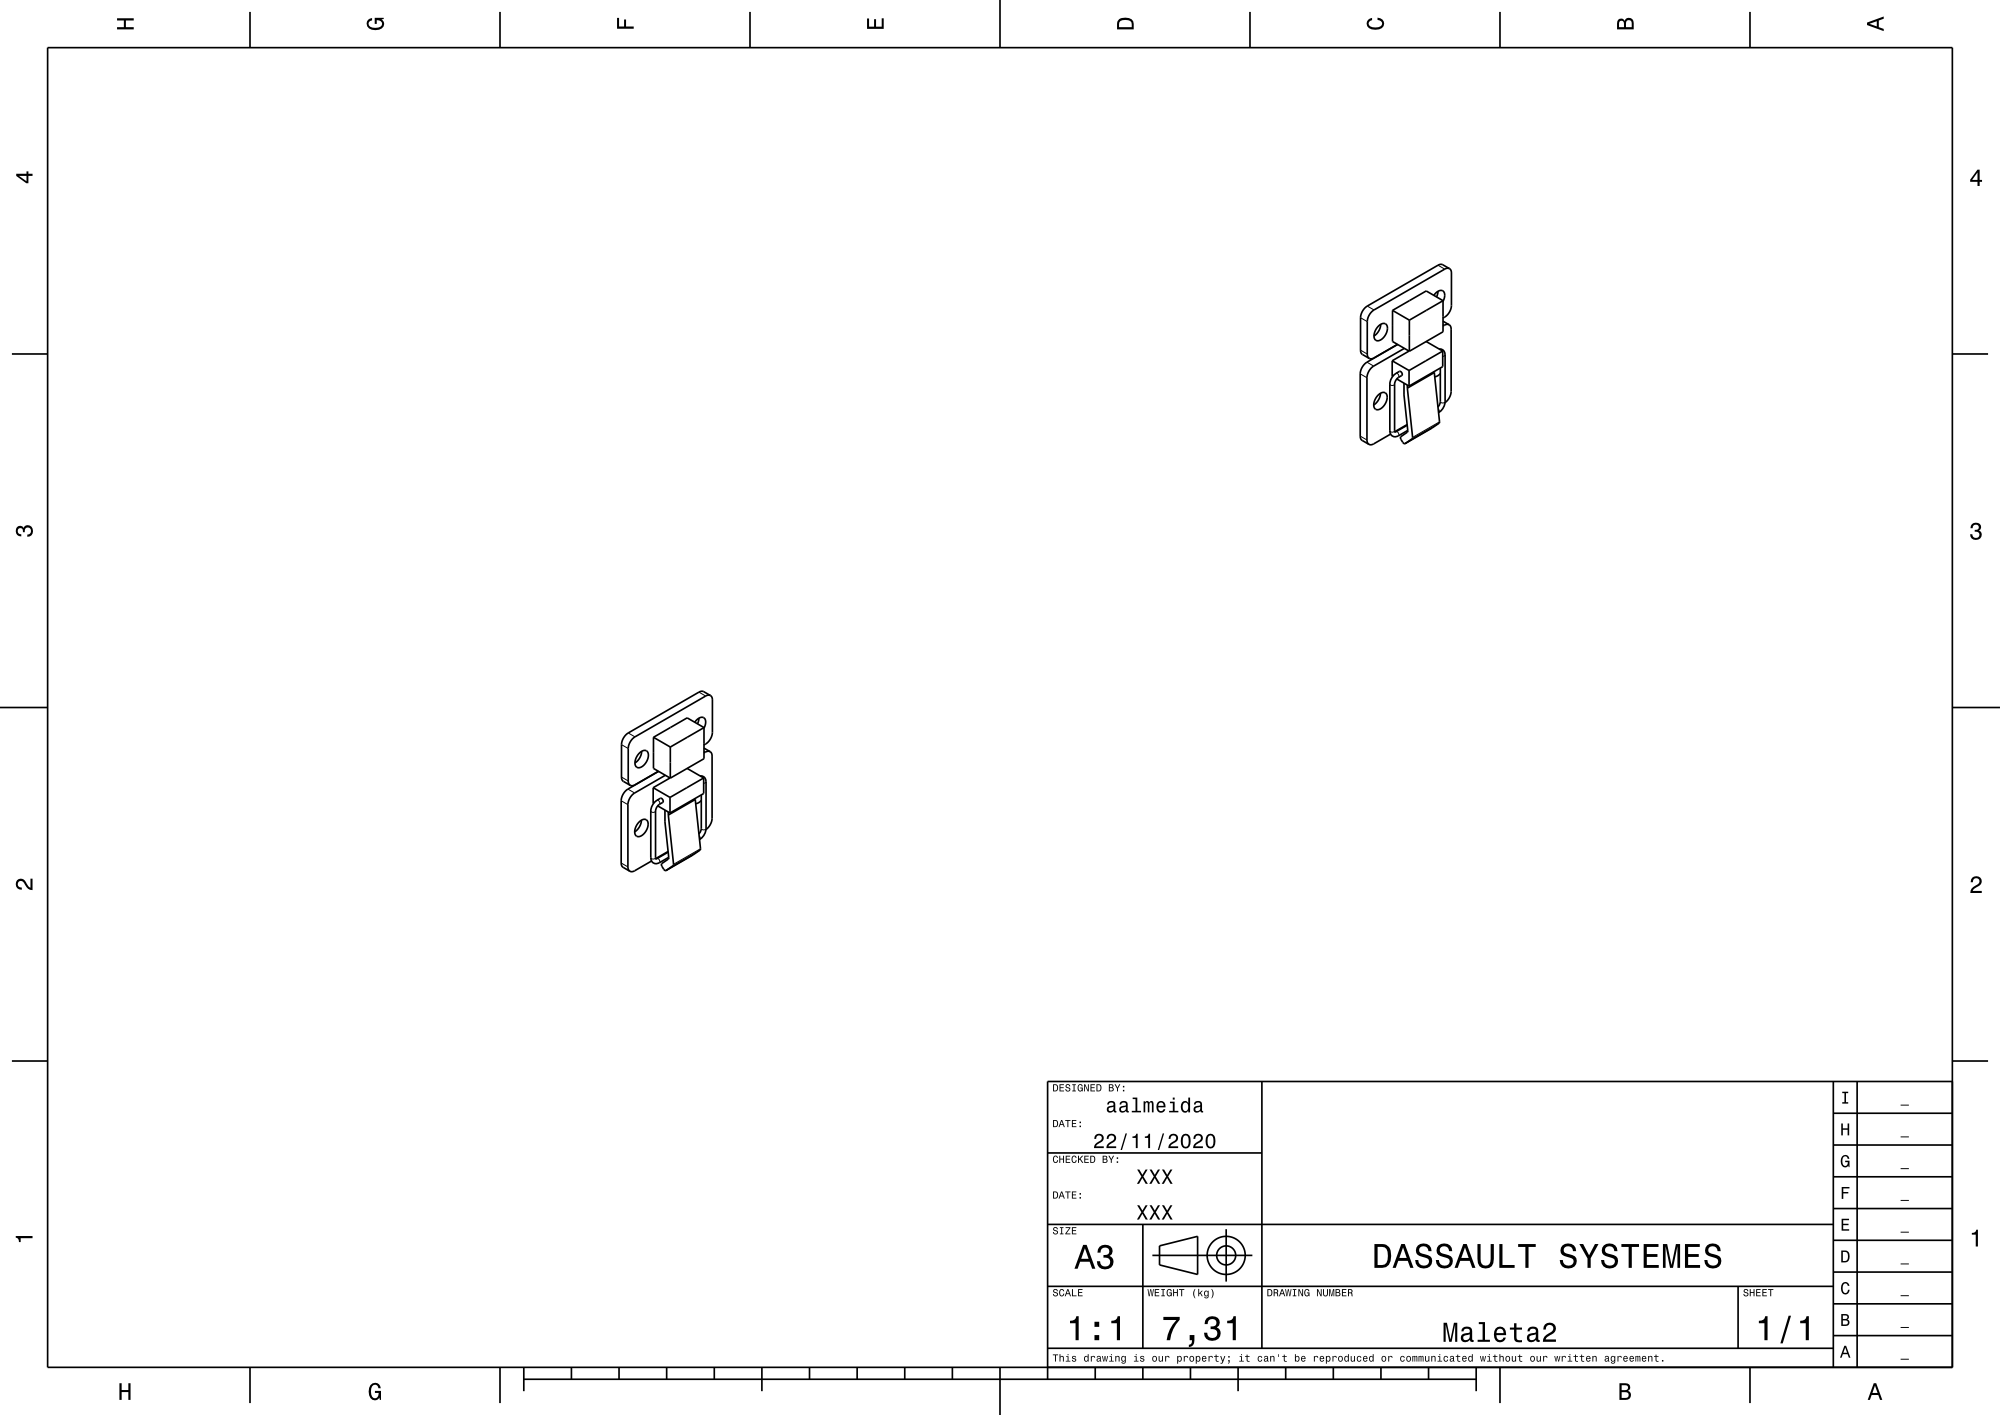
[picture p518: page 1]
