Ground-Station/Documentation/Estrutura/PC3/Imagens/Elementos Maleta GCS/Topo.pdf

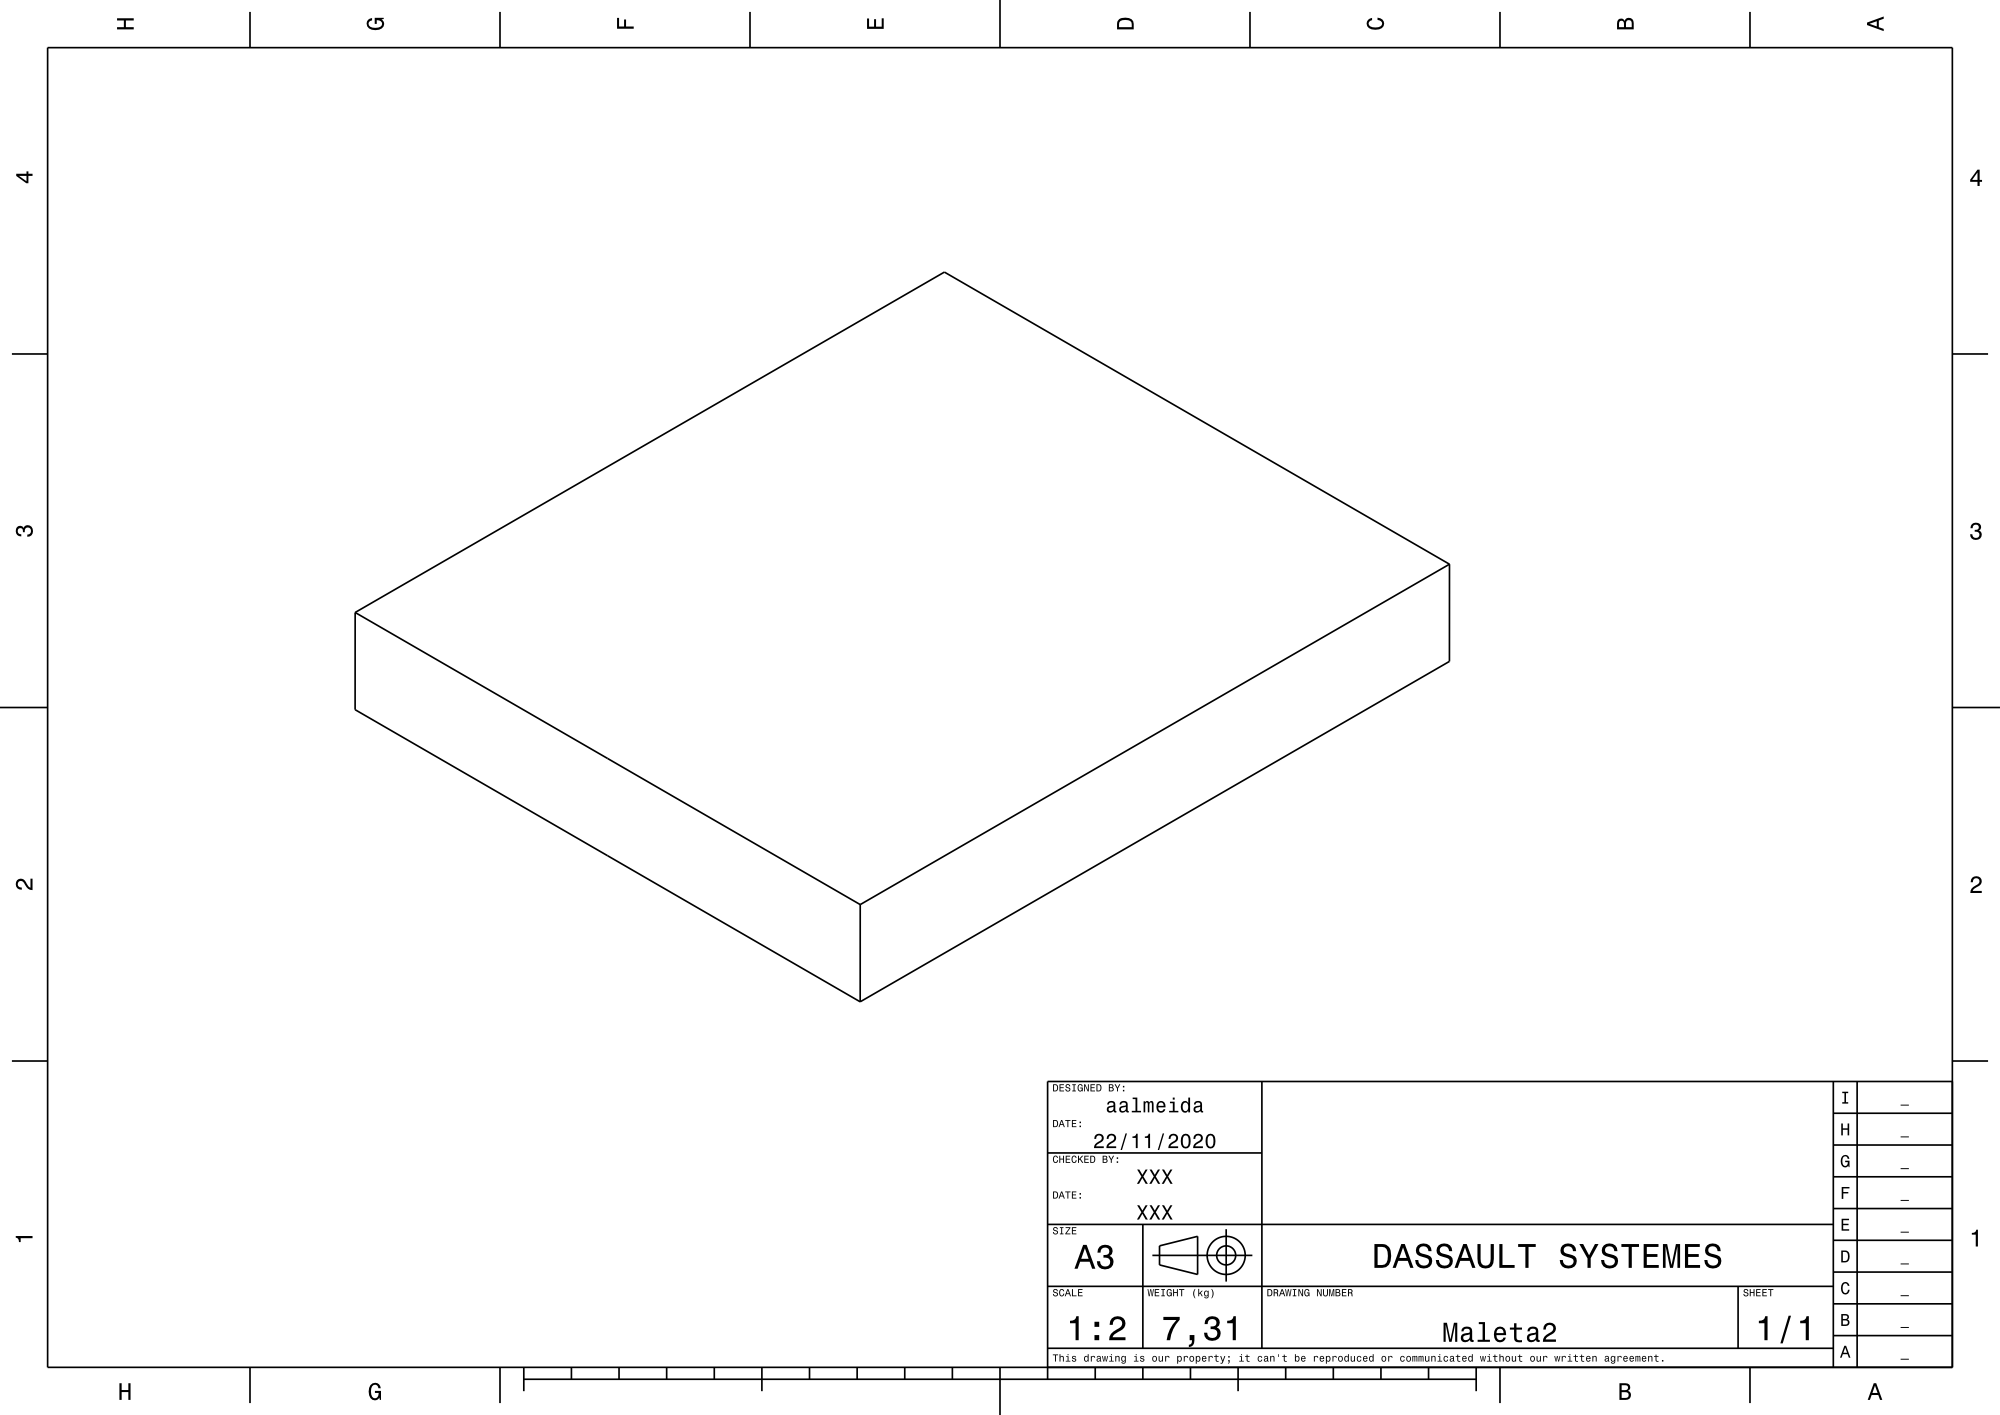
[picture p519: page 1]
