Ground-Station/Documentation/Estrutura/PC3/Desenho Técnico/Posicionamento dos Parafusos/Parafusos da Maleta de Alimentação 01.pdf

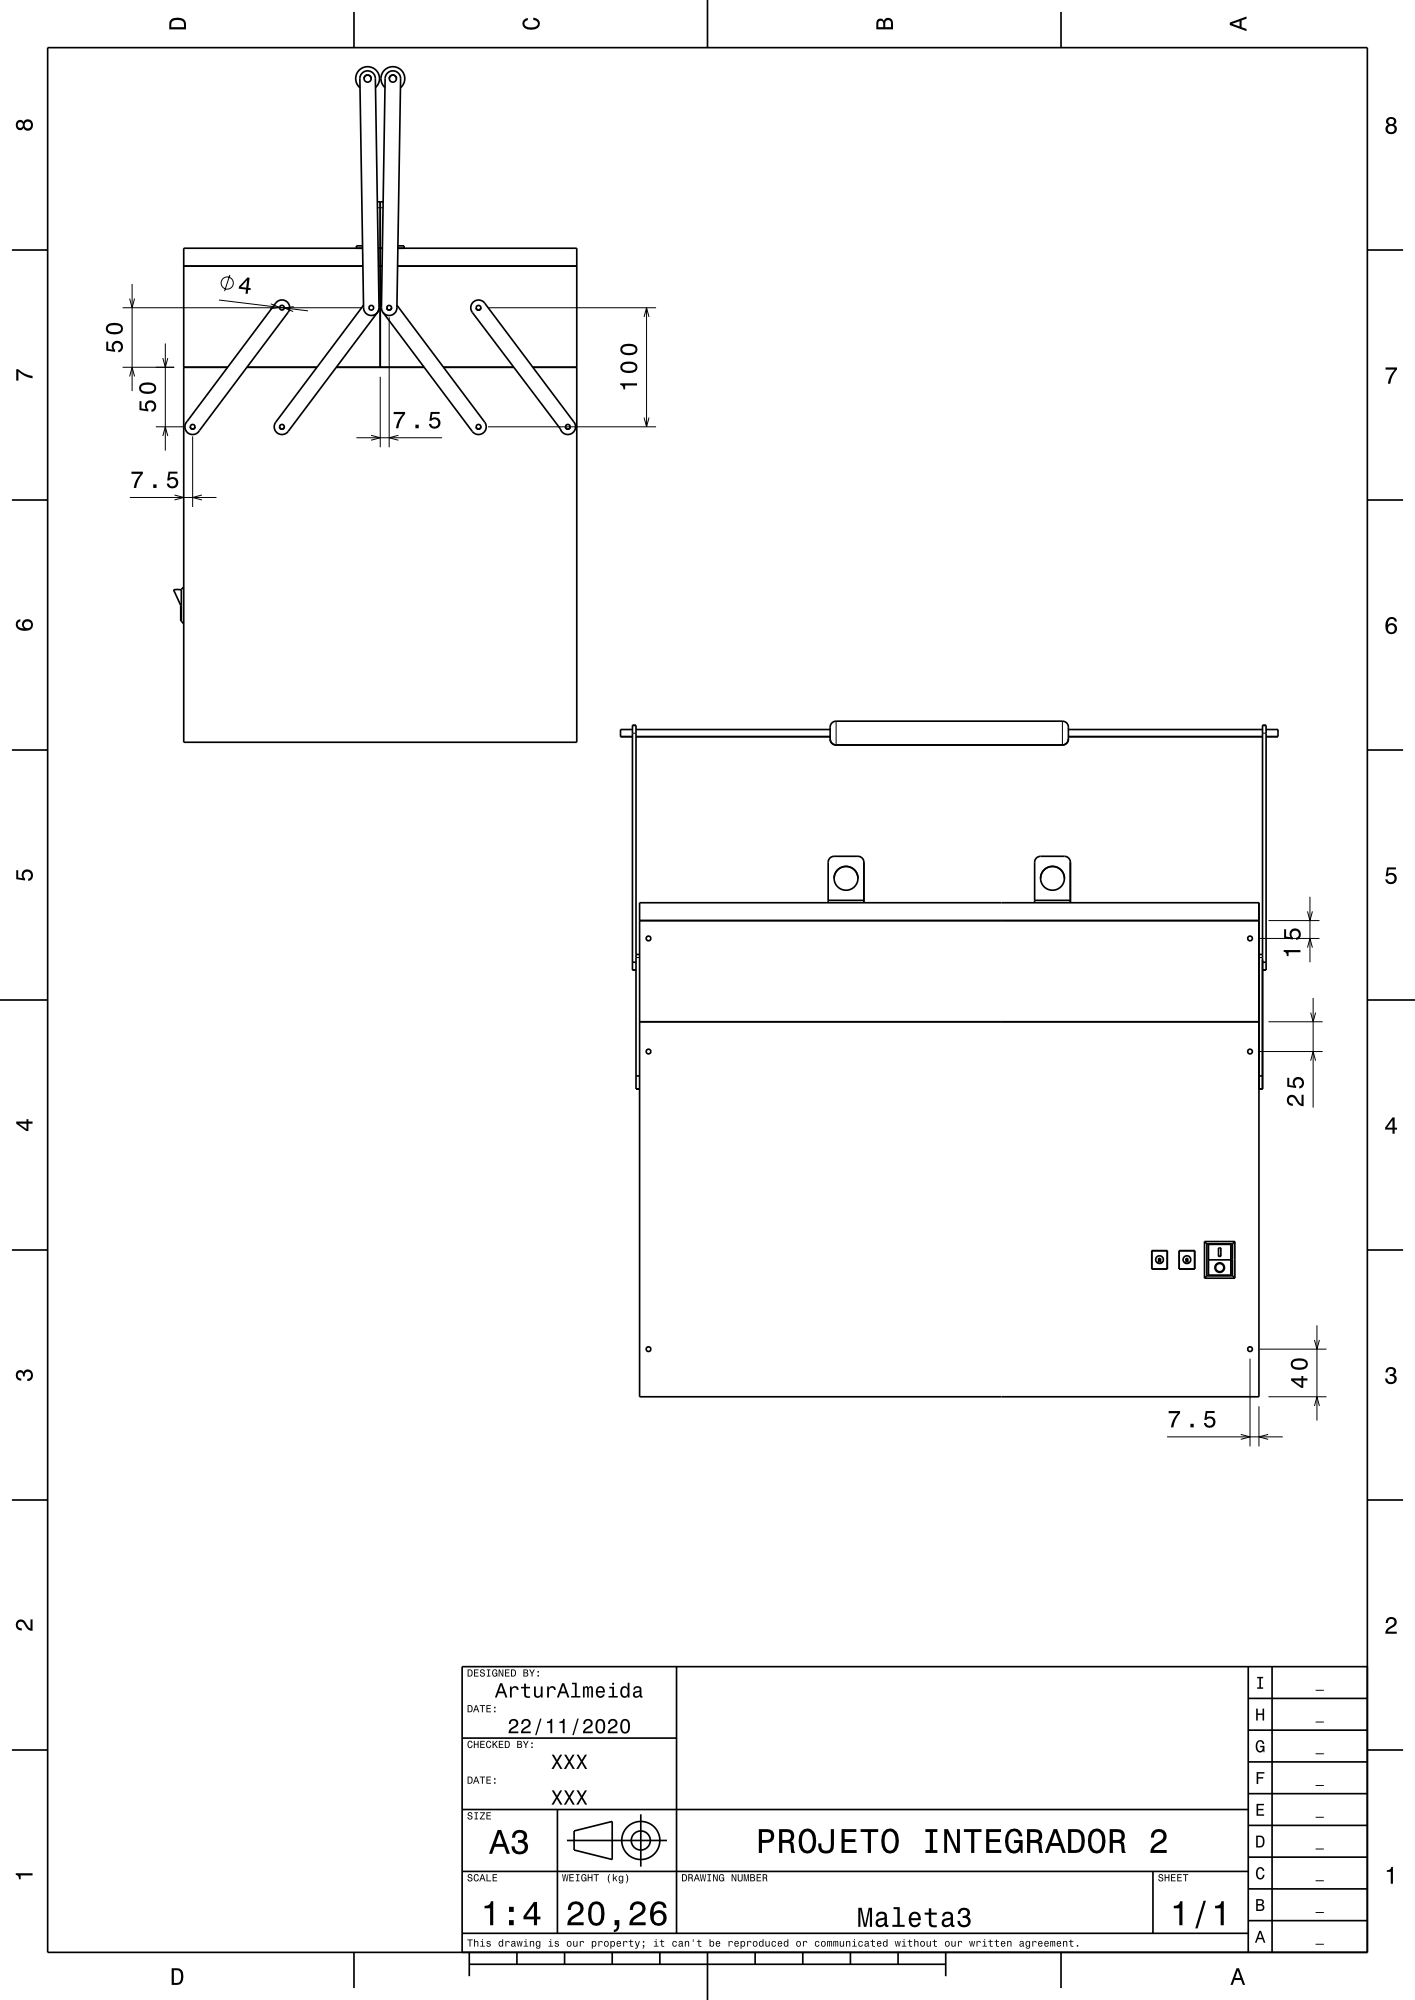
[picture p520: page 1]
