Ground-Station/Documentation/Estrutura/PC3/Desenho Técnico/Posicionamento dos Parafusos/Parafusos da Maleta de Alimentação 02.pdf

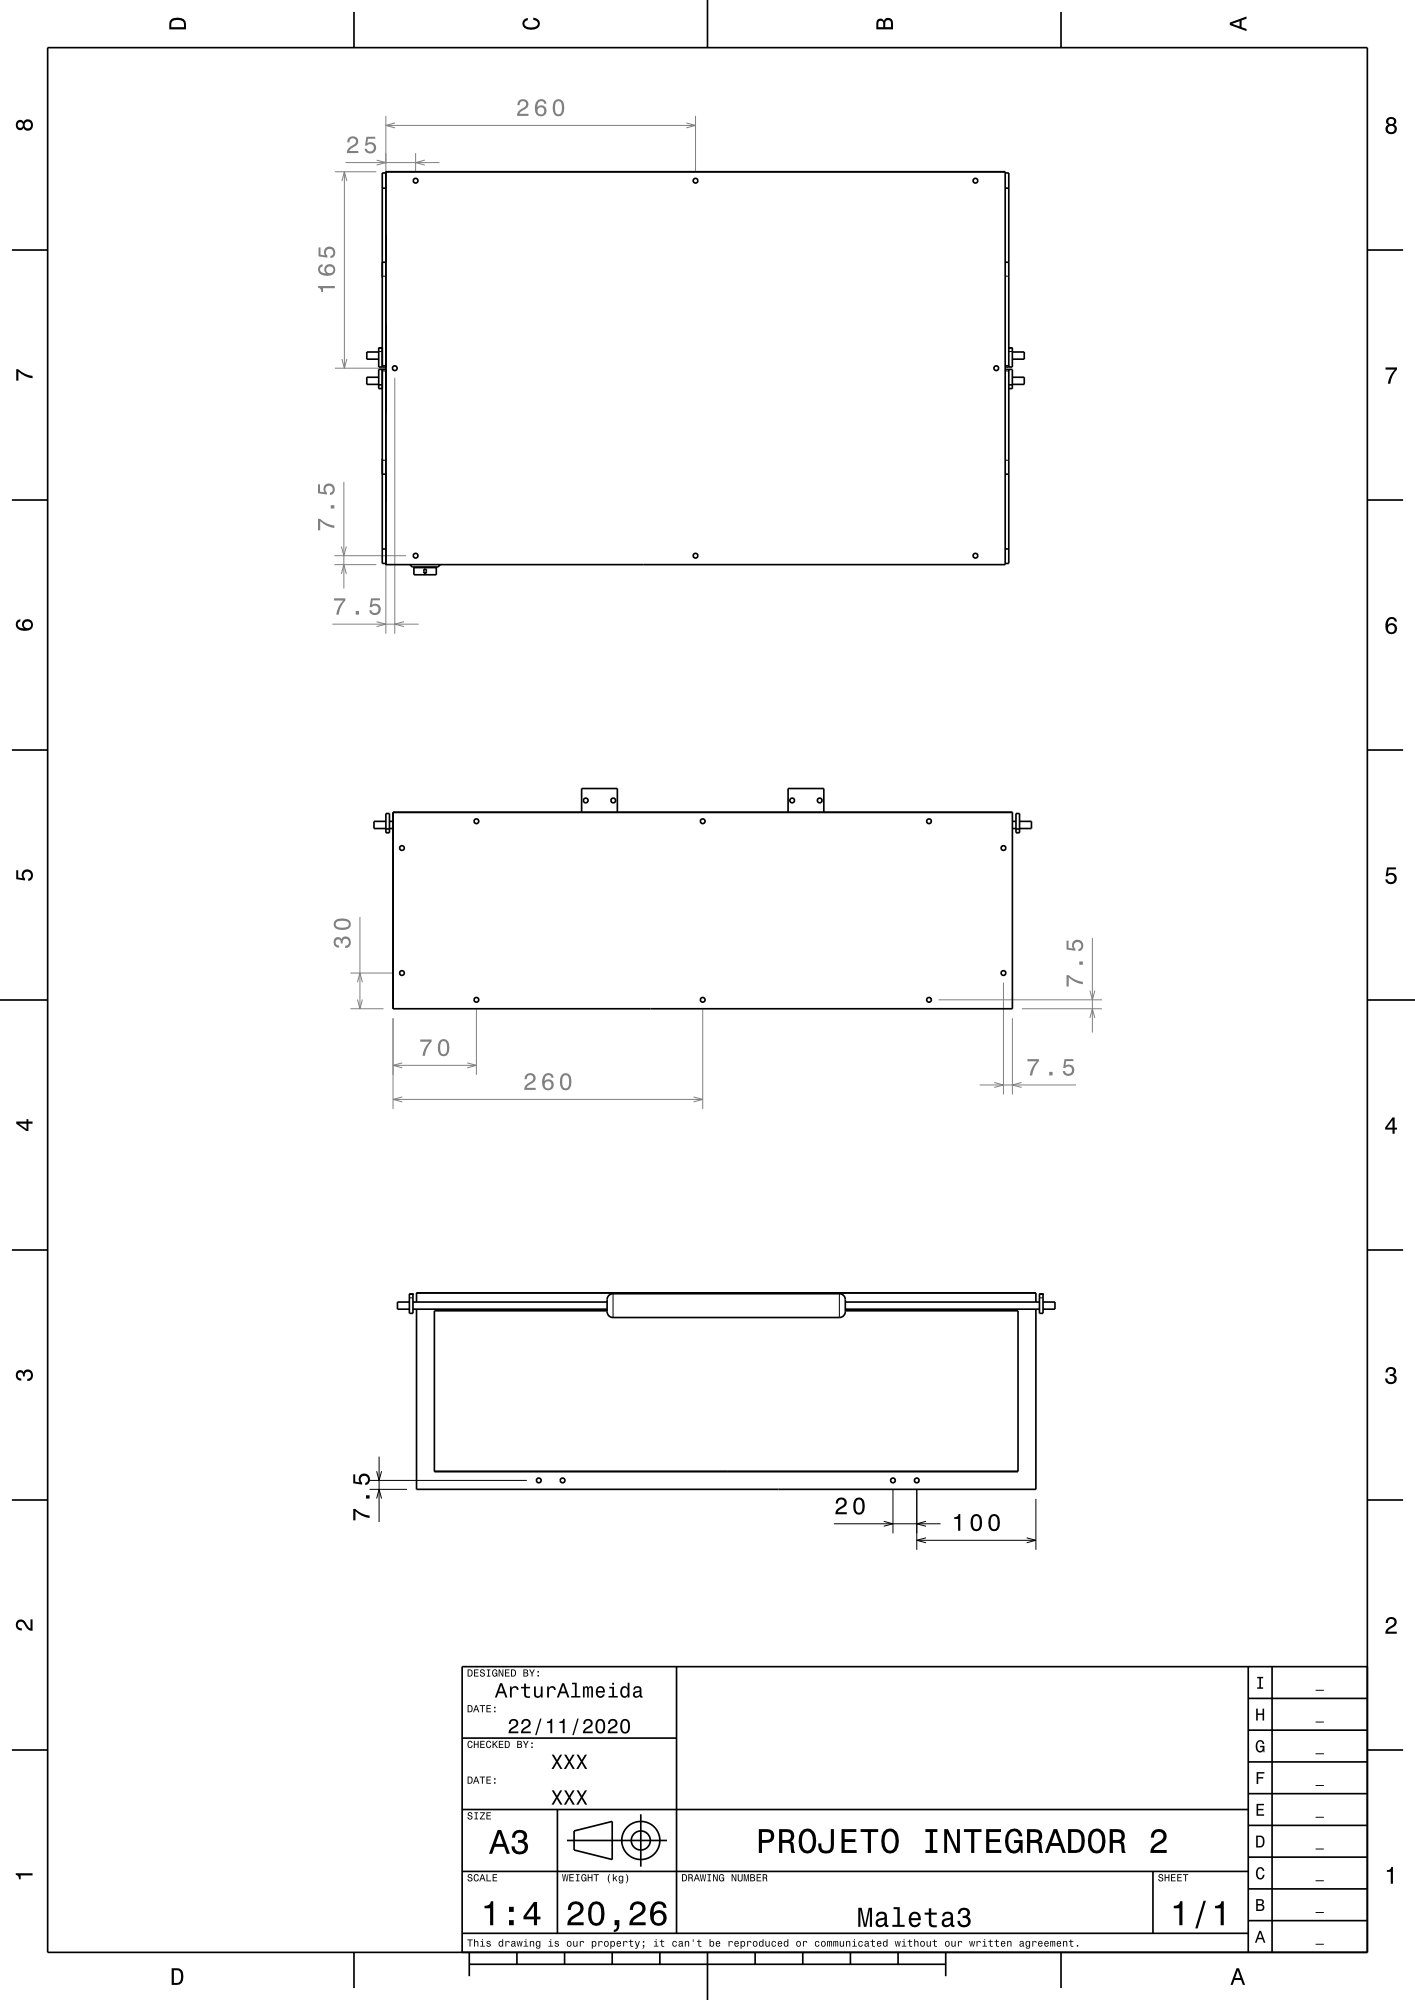
[picture p521: page 1]
