Ground-Station/Documentation/Estrutura/PC3/Desenho Técnico/Posicionamento dos Parafusos/Parafusos da Maleta GCS.pdf

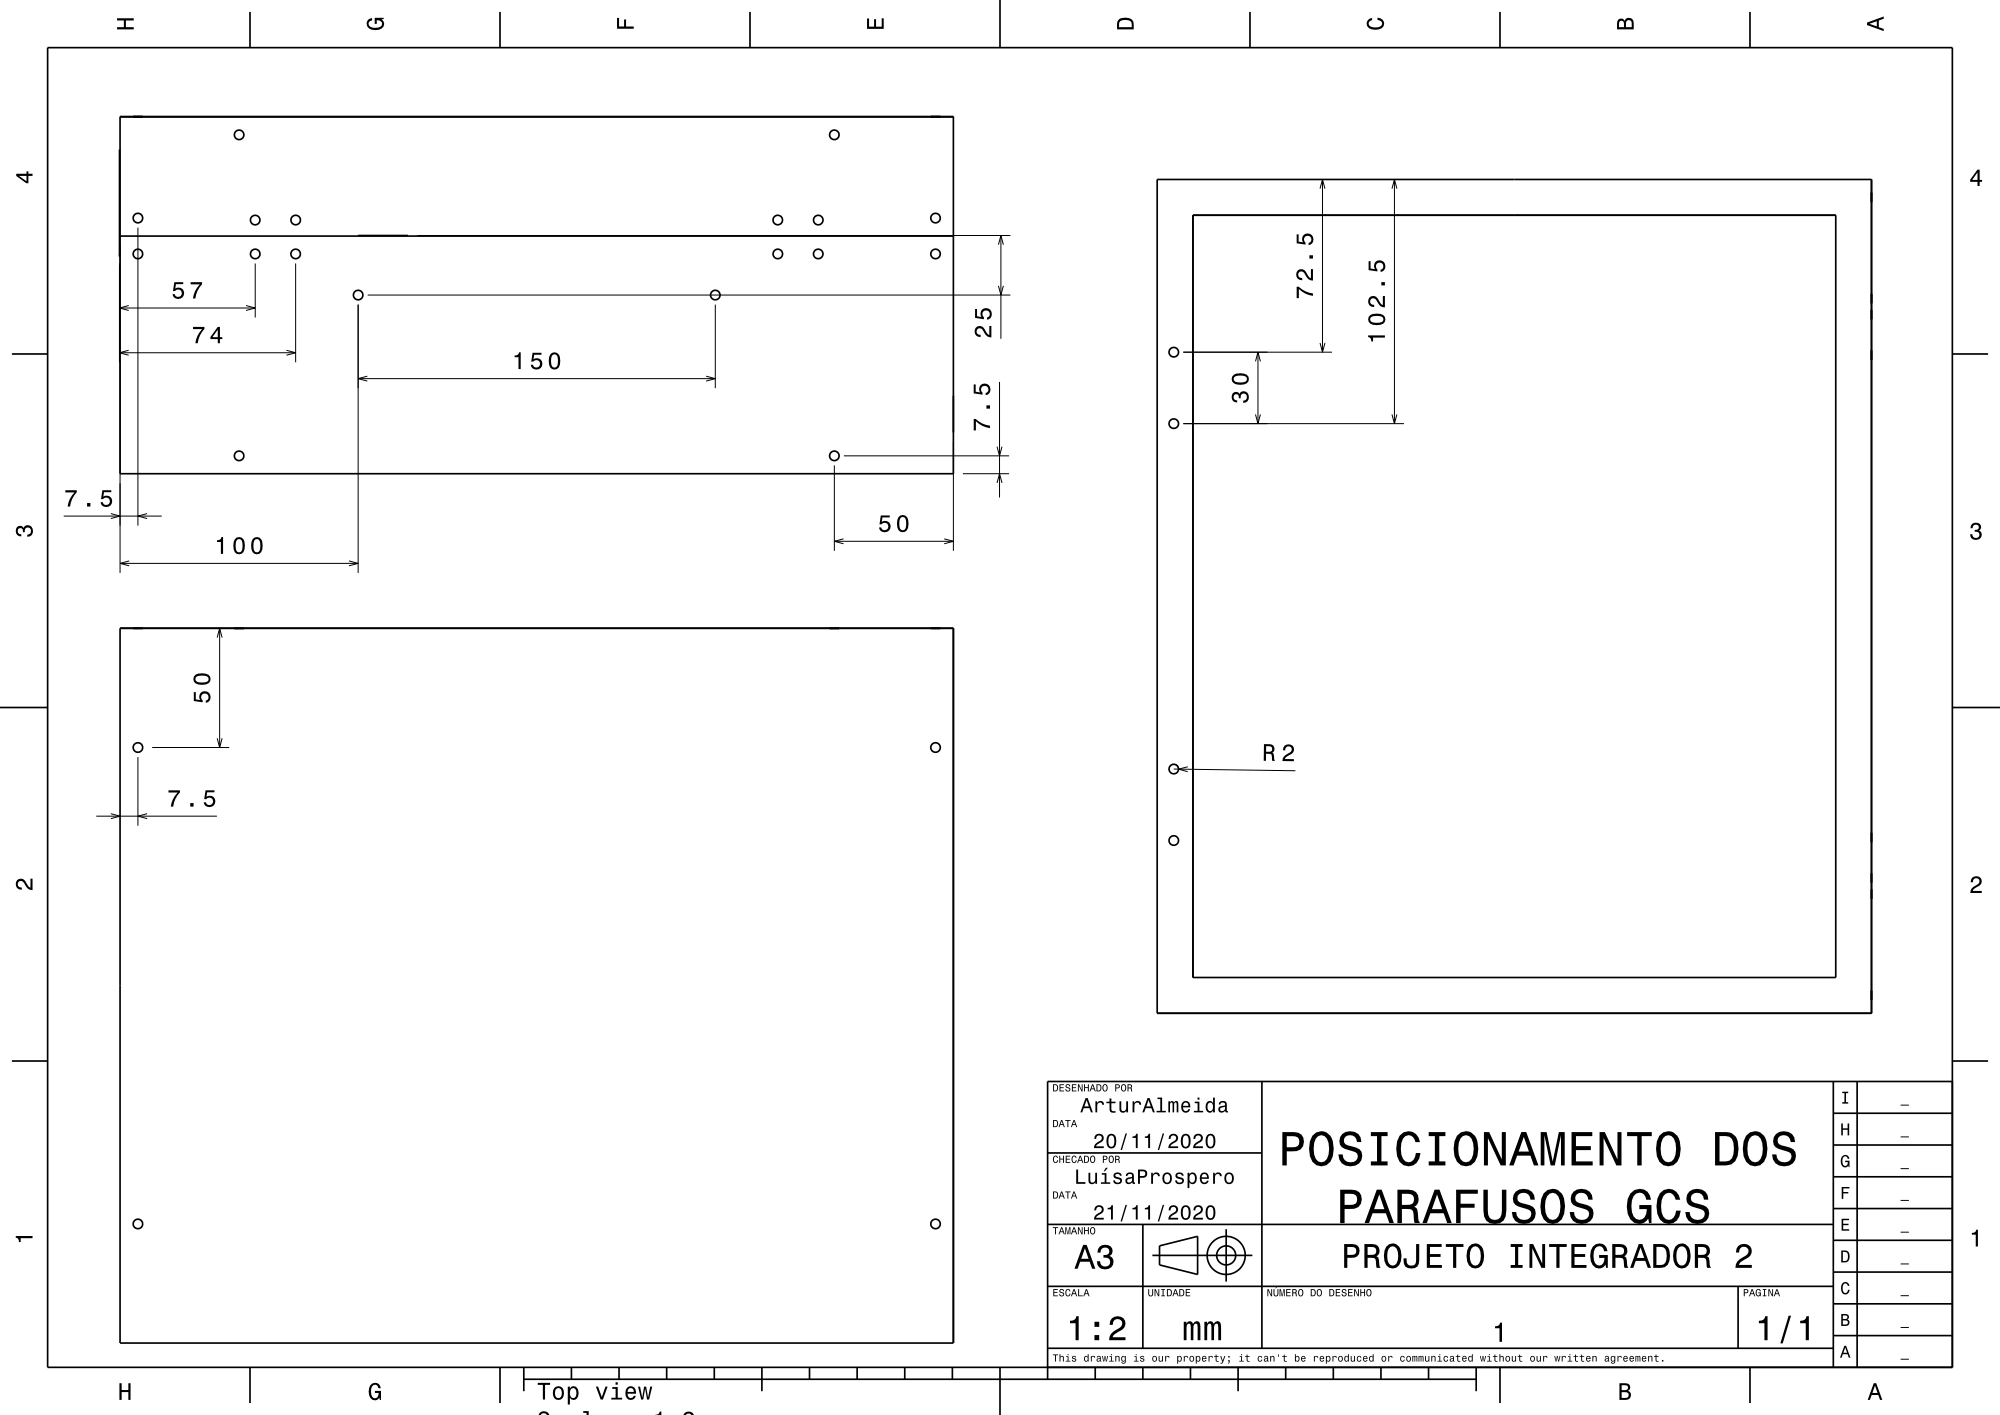
[picture p522: page 1]
