Ground-Station/Documentation/(commit log)

2020-11-25 update Documents
    - inserting the manuals
    - Inserting presentations
    - inserting reports
2020-12-03 Inserindo diagramas eletricos
    - Diagrama bifilar (dois)
    - Diagrama unifilar do carregador
    - Placa de circuito impresso do carregador 2D (dois)
    - Placa de circuito impresso do carregador 3D (dois)
2020-12-04 Create teste
    Criando pasta de estrutura
2020-12-04 Inserindo CADs PC1
    CADs referentes ao PC1
    [Alca.CATPart, Base.CATPart, BotoesEmergencia.CATPart, BotoesSwitch.CATPart, DobradicaBase.CATPart, DobradicaTampo.CATPart, FundoFalso.CATPart, GroundStation.CATProduct]
2020-12-04 Inserindo imagens de componentes
    Imagens de componentes PC2
2020-12-04 Inserindo Sistema de Abastecimento
    Sistema de Abastecimento
2020-12-04 Inserindo CADs de sistema de Abastecimento
    CADs referentes ao sistema de abastecimento
2020-12-04 Inserindo pastas e arquivos referentes a eletrônica:
    - Fluxogramas de calibração e de abastecimento
    - Esquemáticos das PCBs
    - Vistas das PCBs
    - Arquivos Gerber das PCBs
    - Datasheets dos componentes eletrônicos
    - Vistas da case da PCB da base
    - Bibliotecas essenciais para a implementação dos sensores
    Acrescentado no READMEmd:
    - Link para download dos arquivos Gerber e seu software para visualização
    - Links para os repositórios originais das bibliotecas utilizadas
    [Gerber_BoardOutline.GKO, Gerber_BottomLayer.GBL, Gerber_BottomSolderMaskLayer.GBS, Gerber_Drill_NPTH.DRL, Gerber_Drill_PTH.DRL, Gerber_TopLayer.GTL, Gerber_TopPasteMaskLayer.GTP, Gerber_TopSilkLayer.GTO]
