Ground-Station/Documentation/(notices)

Notices in the files:
README.md:
License: MIT
